rx178nwj/StepperMotorDriver-Node/datasheet/README.md

# datasheet

データシート本体はリポジトリに含めていません。各メーカーサイトから入手してください。

## サブフォルダ

- `CAN/`
- `MotorDriver/`
- `stm32/`
- `Switch/`
- `TVS/`
