rx178nwj/StepperMotorDriver-Node/schematic_NEMA17/pcb_routing_sizes.md

# PCB 配線・ビア・差動ペア サイズ一覧

更新日: 2026-10-04。単位は mm。

## 保存したネットクラス

| クラス | 用途 | 配線幅 | クリアランス | ビア外径 | ビア穴径 | 差動線幅 | ペア内間隔 |
|---|---|---:|---:|---:|---:|---:|---:|
| Default | デジタル・その他の信号 | 0.15 | 0.15 | 0.60 | 0.30 | — | — |
| DIGITAL | マイコンのデジタル信号（33ネットを明示割り当て） | 0.15 | 0.15 | 0.60 | 0.30 | — | — |
| ANALOG | アナログ信号（ADC・DAC・VREF） | 0.20 | 0.15 | 0.60 | 0.30 | — | — |
| USB | USB D+/D− | 0.25 | 0.15 | 0.60 | 0.30 | 0.25 | 0.15（暫定） |
| PCA9615_DIFF | 差動I2C | 0.15 | 0.15 | 0.60 | 0.30 | 0.15 | 0.15（暫定） |
| POWER_1A | 低電圧電源・GND | 0.50 | 0.15 | 0.80 | 0.40 | — | — |
| VM_POWER | VM・GNDPWR | 0.50 | 0.15 | 1.00 | 0.50 | — | — |
| MOTOR_PHASE | モーター相出力（前回設定を継続） | 2.00 | 0.15 | 1.00 | 0.50 | — | — |

POWER_1A: +3V3, /+5V, /+5V_EXT, /USB_VBUS, /USB_VBUS_SRC, /BUCK_SW, /VDDA, /DRV_VCC, GND, GNDA。
ANALOG: /TEMP, /AD_IN, /DAC_VREF, /DRV_VREF, /VM_DIV, /VM_SENSE_ISO, /VM_SENSE。VDDA・GNDAは電源クラスの0.50 mm。
DIGITAL: IC4のGPIO・ドライバ制御/状態・I2C・SWD/SWO・リセット・スイッチ・アドレス・LED・エンコーダ信号を33ネットごとに割り当て。USBは専用クラス。

ADC入力: IC4 pin10=/VM_SENSE、pin16=/TEMP、pin17=/AD_INをANALOG 0.20 mmへ割り当てた。ADC機能を備えたピンでもデジタル用途のネットはDIGITALとした。DAC pin14=/DAC_VREFはANALOGを維持。
今回の割り当て表: review/jlcpcb-4layer/mcu-signal-assignments.json。KiCad 10.0.4のネイティブ読み込み検証: 8クラス、明示割り当て62ネット、不一致0件。既存7クラスが消えていたため元の設定も復元してからDIGITALを追加した。
VM_POWER: /VM, GNDPWR。
MOTOR_PHASE: /OUTA_P, /OUTA_N, /OUTB_P, /OUTB_N。
USB: /USB_PC_DP, /USB_PC_DM。USB_CC1/2はDefault。
PCA9615_DIFF: /DI2C_SDA_P, /DI2C_SDA_M, /DI2C_SCL_P, /DI2C_SCL_M。

## 定義済みサイズ欄に使用する一覧

- 配線幅: 0.15, 0.20, 0.25, 0.50, 2.00。
- ビア（外径 / 穴径）: 0.60 / 0.30, 0.80 / 0.40, 1.00 / 0.50。
- 差動ペア（線幅 / 間隔 / ビア間隔）: PCA9615 = 0.15 / 0.15 / 0.15、USB = 0.25 / 0.15 / 0.15。間隔は暫定、ビア間隔は銅箔外周間の距離。

2026-10-04 修正検証: ファイルをMCPで読み戻すとDefaultのみ（線幅0.20 mm）、割り当てなしに戻っていた。どの保存操作で戻ったかは未特定。従来のツール成功応答だけを根拠にした保存確認を撤回する。
プロジェクト読み戻し・修正用MCPツールをreview/jlcpcb-4layer/toolsに追加。7クラスの数値と29ネットの割り当てをKiCad 10の形式で再設定し、定義済みサイズも登録した。既存の追加サイズは維持した。保存先はschematic.kicad_pro。
検証では別プロセスのKiCad 10.0.4 SETTINGS_MANAGER.LoadProjectで実際にプロジェクトを読み込み、PCBに対応させた。7クラスの線幅・クリアランス・ビア径・USB/PCA9615差動幅・間隔および29ネットの割り当ては不一致0件。結果はreview/jlcpcb-4layer/netclass-native-verification.json。
現在開いているエディタの画面は操作していない。修正前の値を保持した画面から保存すると外部修正が上書きされる可能性があるため、基板設定ダイアログをキャンセルし、エディタを閉じてプロジェクトを再読込する。エディタ内に未保存の基板変更があれば別名保存してから再読込する。

## PCA9615DPの差動配線

NXPの推奨する公称差動線路インピーダンスは100 Ω。出典: https://cache.nxp.com/docs/en/data-sheet/PCA9615.pdf （Rev.2、p.2、差動バスおよび終端の説明）。0.15 mm幅/0.15 mm間隔が100 Ωとなることはまだ確認していない。

- SDAペア: U2 DSDAP pin8 → DI2C_SDA_P、DSDAM pin9 → DI2C_SDA_M。
- SCLペア: U2 DSCLP pin7 → DI2C_SCL_P、DSCLM pin6 → DI2C_SCL_M。
- MCU側のSDA/SCLはシングルエンドであり、Defaultの0.15 mmを使用する。
- SDAとSCLをそれぞれ対として近接・並走させる。ペア同士は可能なら0.5 mm以上離す。
- F.Cu配線の直下に連続したIn1.CuのGND面を設ける方針。面の分断・VM/SW/モーター出力の近傍を避ける。GND面の作成は今回未実施。
- コネクタ間のバス経路とU2への分岐を短くし、スター配線を避ける。各ペアで層変更・ビア数を揃える。
- 既存回路のR13/R15/R16/R18は600/DNP、R14/R17は120/DNPと確認。抵抗値と実装指定は変更していない。数珠つなぎの物理的両端だけ終端を実装するという既存仕様に従う。
- 現在の_P/_M名は維持。KiCad差動ルータでペア認識されない場合はネット名の整合した変更が必要になるため、実配線開始前に確認する。

JLCPCBの発注積層（外層銅厚、F.Cu–In1.Cuの絶縁厚、誘電率）が決まった後、PCA9615の100 ΩとUSBの90 Ωを計算する。USB幅0.25 mmを固定したまま実現できる間隔・積層を選ぶ。暫定間隔を製造用インピーダンス確定値として扱わない。

## 電流・検証状況

4層 F.Cu / In1.Cu / In2.Cu / B.Cu、板厚1.6 mmを確認。最小配線幅・銅箔クリアランス0.15 mm。
電源幅0.50 mmは指定値。VM/GNDPWRの10 A級という既存設計前提に対する連続電流容量を保証しない。銅箔面・並列ビア・銅厚・温度上昇の検討が必要。モーター相出力2.00 mmも電流容量の確定値ではない。
既存4本のGNDPWRの0.20 mm配線はIC2のパッド付近の配線として維持し、自動拡幅していない。ネットクラスの変更は既存配線の幅を自動変更しない。
設定変更後DRC: 違反129件、未接続316件（変更前と同数）。今回の作業はサイズ設定であり、実配線・内層銅箔面・製造データ完成は未実施。
