rx178nwj/StepperMotorDriver-Node/schematic_NEMA17/stm32l433_tb67s249_connection.md

# 回路図作成仕様書：STM32L433CCU6 ⇔ TB67S249FTG 接続部

> 2026-10-04 DIP型番確定：SW4は秋月電子109992、OTAX KSD32（3極、スルーホール、税込80円/個）を採用。標準フットプリント `Button_Switch_THT:SW_DIP_SPSTx03_Slide_9.78x9.8mm_W7.62mm_P2.54mm` に変更した。ADDR0/1/2の配線、OFF=0/ON=1は維持。詳細は `review/ksd32/verification.md`。

> 2026-10-04 3bitアドレス選択：JP1を削除し、3極DIPスイッチSW4へ変更。DIP1=ADDR0→PH0 pin5（R59 10kΩプルダウン）、DIP2=ADDR1→PH1 pin6（R60 10kΩ）、DIP3=ADDR2→PC13 pin2（R58 10kΩ）。OFF=0/ON=1。HSEをOFFにして全てGPIO入力・内部プルなしで読む。`ID=ADDR0+2*ADDR1+4*ADDR2`（0〜7）、7bitアドレスは重複しないBASE+IDをFWで設定する。差動バスはマスター→最大8台を数珠つなぎ、終端R13〜R18は物理的な両端のみ、途中は未実装。最新記録は `review/dip-address/verification.md`。

> 2026-10-04 更新：基板スペースの都合により12.2節のF1/Q1/D6/D7/R38による入力保護は基板内で省略する。現在はJ6.1からVMへ直結する仕様。5V電源の負荷は1Aを設計前提としてL2を小型化する（インダクタの飽和電流を1Aとする意味ではない）。旧12章の部品記述よりこの更新条件を優先する。
>
> SW2=SWITCH1→IC4 PB4 pin40、SW3=SWITCH2→PB5 pin41、TH1=TEMP→PA6 pin16（ADC1_IN11）を接続した。ADCピン確保のためLED_FAULTはPA6からPB2 pin20へ移動した。SWD/SWOとJ11外部アナログ入力は維持。PB4/PB5はGPIO入力、PA6はアナログ入力、PB2はLED出力としてファームウェアを設定する。
>
> PCA9615は切替後+5Vからの自己給電を推奨。通信コネクタは差動4信号+GNDの5ピン案（1=SDA+、2=SDA−、3=SCL+、4=SCL−、5=GND）。この給電/コネクタ変更は今回未実施。詳細と接続検証は `review/inputs-self-power/verification.md`。

本書は、ステッピングモータドライバ基板のうち **MCU（STM32L433CCU6）とモータドライバ（TB67S249FTG）の接続部** の回路図を作成するための仕様である。ピン番号・ネット名・周辺部品の定数をすべて本書の記載どおりに描くこと。記載のない接続を追加しないこと。

---

## 1. 対象範囲

| 区分 | 内容 |
|---|---|
| 含む | TB67S249FTG の全ピン接続、MCU⇔ドライバ間の制御信号、VREF（DAC）回路、ドライバ周辺部品、PC通信用 I2C2（4.1節）、J6電源入力・保護・降圧・USB給電切替・3.3V生成・電源電圧測定（12節） |
| 含まない | 外部クロック・SWD、エンコーダ、温度計測、PCBの実装・配線・放熱検証 |

他シートとの接続は、下記「2. ネット一覧」のグローバルネット（電源・GND）でのみ行う。

---

## 2. ネット一覧

### 2.1 電源・GND（グローバルネット）

| ネット名 | 内容 | 供給元（他シート） |
|---|---|---|
| `VM` | モータ電源 12〜24V | 電源入力部（逆接保護・TVS後） |
| `+3V3_D` | MCUデジタル 3.3V | LDO（AP2112K-3.3） |
| `GND` | 信号GND | — |
| `PGND` | モータ電源GND（大電流経路） | 電源入力部。`GND` とは **1点で接続**（3.4節） |

### 2.2 ローカルネット（本シート内）

| ネット名 | 内容 |
|---|---|
| `DRV_VCC` | TB67S249 内部レギュレータ出力（5V、最大5mA）。**本シート内の設定用プルアップ専用。MCUや他回路に接続しないこと** |
| `DRV_VREF` | VREFA/VREFB 入力（分圧・フィルタ後） |
| `DAC_VREF` | MCU DAC出力（分圧前） |
| `OUTA_P` / `OUTA_N` / `OUTB_P` / `OUTB_N` | モータ出力（モータコネクタへ） |

### 2.3 MCU ⇔ ドライバ 制御信号

| ネット名 | 方向 | 内容 |
|---|---|---|
| `DRV_CLK` | MCU → DRV | ステップクロック（TIM1_CH1） |
| `DRV_DIR` | MCU → DRV | 回転方向 |
| `DRV_EN` | MCU → DRV | 出力ON/OFF |
| `DRV_RESET` | MCU → DRV | 電気角初期化 |
| `DRV_DMODE0` | MCU → DRV | ステップ分割設定 bit0 |
| `DRV_DMODE1` | MCU → DRV | ステップ分割設定 bit1 |
| `DRV_DMODE2` | MCU → DRV | ステップ分割設定 bit2 |
| `DRV_AGC0` | MCU → DRV | AGC設定 0 |
| `DRV_AGC1` | MCU → DRV | AGC設定 1 |
| `DRV_LO1` | DRV → MCU | エラーフラグ1（オープンドレイン） |
| `DRV_LO2` | DRV → MCU | エラーフラグ2（オープンドレイン） |
| `DRV_MO` | DRV → MCU | 電気角モニタ（オープンドレイン） |

### 2.4 PC通信用 I2C2

| ネット名 | MCU | 接続先 |
|---|---|---|
| `I2C_PC_SCL` | IC4 PB10（Pin 21）、I2C2_SCL | PCA9615DP の SCL（Pin 4） |
| `I2C_PC_SDA` | IC4 PB11（Pin 22）、I2C2_SDA | PCA9615DP の SDA（Pin 2） |

---

## 3. ブロック図

```
                    STM32L433CCU6                                TB67S249FTG
                 ┌─────────────────┐                        ┌──────────────────────┐
   (TIM1_CH1) PA8│29 ──DRV_CLK───────────────────────────── 43│CLK                   │
              PA9│30 ──DRV_DIR───────────────────────────── 42│CW/CCW        OUTA+ 13,14├─ OUTA_P
             PA10│31 ──DRV_EN──────┬─────────────────────── 44│ENABLE        OUTA- 17,18├─ OUTA_N
                 │                 R16 10k→GND              │                      │
             PB15│28 ──DRV_RESET────────────────────────── 45│RESET         OUTB+ 23,24├─ OUTB_P
             PB12│25 ──DRV_DMODE0───────────────────────── 39│DMODE0        OUTB- 19,20├─ OUTB_N
             PB13│26 ──DRV_DMODE1───────────────────────── 40│DMODE1                │
             PB14│27 ──DRV_DMODE2───────────────────────── 41│DMODE2    VMA 10,11   ├─ VM
              PB8│45 ──DRV_AGC0─────────────────────────── 1 │AGC0      VMB 26,27   ├─ VM
              PB9│46 ──DRV_AGC1─────────────────────────── 2 │AGC1                  │
                 │                                          │          RSAGND 15,16├─ PGND
       (EXTI2)PA2│12 ──DRV_LO1──┬────────────────────────── 47│LO1       RSBGND 21,22├─ PGND
       (EXTI3)PA3│13 ──DRV_LO2──┼─┬──────────────────────── 48│LO2                   │
             PC15│4  ──DRV_MO───┼─┼─┬────────────────────── 46│MO        GND 8,29,30 ├─ GND
                 │          R17 R18 R19 10k→+3V3_D          │          EP/コーナー  ├─ GND
  (DAC1_OUT1) PA4│14 ──DAC_VREF─R20 10k─┬─DRV_VREF───────── 32│VREFA                 │
                 │                      ├────────────────── 31│VREFB      VCC 33,34  ├─ DRV_VCC
                 │                   R21 9.1k  C16 100nF     │          OSCM 35     │
                 └─────────────────┘   GND      GND         └──────────────────────┘
```

PC通信用 I2C2 の接続（参照番号は現在の `schematic.kicad_sch` に対応）：

```text
IC4 STM32L433CCU6                         U2 PCA9615DP
PB10 (21, I2C2_SCL) ── I2C_PC_SCL ────── SCL (4)
                          │
                       R11 4.7kΩ → +3V3
PB11 (22, I2C2_SDA) ── I2C_PC_SDA ────── SDA (2)
                          │
                       R10 4.7kΩ → +3V3
```

---

## 4. STM32L433CCU6 側の接続（本シートで使用するピンのみ）

パッケージ：UFQFPN48。下表以外のピンは他シートで定義する。

| MCU Pin | ポート | ネット名 | GPIO/機能設定 | 接続先（TB67S249 Pin） |
|---|---|---|---|---|
| 29 | PA8 | `DRV_CLK` | TIM1_CH1（AF出力、プッシュプル） | 43 CLK |
| 30 | PA9 | `DRV_DIR` | GPIO出力、プッシュプル | 42 CW/CCW |
| 31 | PA10 | `DRV_EN` | GPIO出力、プッシュプル | 44 ENABLE |
| 28 | PB15 | `DRV_RESET` | GPIO出力、プッシュプル | 45 RESET |
| 25 | PB12 | `DRV_DMODE0` | GPIO出力、プッシュプル | 39 DMODE0 |
| 26 | PB13 | `DRV_DMODE1` | GPIO出力、プッシュプル | 40 DMODE1 |
| 27 | PB14 | `DRV_DMODE2` | GPIO出力、プッシュプル | 41 DMODE2 |
| 45 | PB8 | `DRV_AGC0` | GPIO出力、プッシュプル | 1 AGC0 |
| 46 | PB9 | `DRV_AGC1` | GPIO出力、プッシュプル | 2 AGC1 |
| 12 | PA2 | `DRV_LO1` | GPIO入力、内部プルなし、EXTI2（立ち下がり） | 47 LO1 |
| 13 | PA3 | `DRV_LO2` | GPIO入力、内部プルなし、EXTI3（立ち下がり） | 48 LO2 |
| 4 | PC15 | `DRV_MO` | GPIO入力、内部プルなし（ポーリング） | 46 MO |
| 14 | PA4 | `DAC_VREF` | **DAC1_OUT1**（バッファ有効） | R20 経由で 31 VREFB / 32 VREFA |

**電気的整合**
- TB67S249 のロジック入力しきい値は High 2.0V以上 / Low 0.8V以下で、3.3V出力で直結可能。
- ロジック入力（DMODE0〜2、CLK、ENABLE、RESET、CW/CCW、AGC0、AGC1、CLIM0）は内部で 100kΩ によりGNDへプルダウンされている（3.3V入力時の入力電流 33µA）。MCUリセット中（ピンがHi-Z）は、ドライバは **スタンバイ（DMODE=000）・出力OFF** に落ち着く。
- PC15 は RTC 電源ドメインのピンで駆動能力が小さいため、入力（MO）専用とする。

### 4.1 PC通信用 I2C2（2026-10-03 回路図反映済み）

| MCU Pin | ポート | ネット名 | GPIO/機能設定 | 接続先（現在の回路図） |
|---|---|---|---|---|
| 21 | PB10 | `I2C_PC_SCL` | I2C2_SCL、AF4、オープンドレイン、内部プルなし | U2（PCA9615DP）Pin 4 SCL、R11 Pin 2 |
| 22 | PB11 | `I2C_PC_SDA` | I2C2_SDA、AF4、オープンドレイン、内部プルなし | U2（PCA9615DP）Pin 2 SDA、R10 Pin 2 |

- R10/R11 は既設の 4.7kΩ プルアップ抵抗で、上側は `+3V3` に接続する。
- PB6/PB7 はセンサ用 `I2C_SENS_SCL` / `I2C_SENS_SDA` に使用するため、PC通信用は I2C2 に割り当てる。
- この節と I2C2 図の U2・R10・R11 は現在の `schematic.kicad_sch` の参照番号である。5〜7節のモータドライバ仕様に記載された同じ参照番号とは対応が異なる。
- ネットリストで両信号の MCU・PCA9615DP・プルアップ抵抗の接続を確認済み。階層チェックは問題なし。接続前後の ERC は 36件 → 34件（既存エラー22件・警告12件、新規違反なし）。

---

## 5. TB67S249FTG 全ピン接続表

パッケージ：P-VQFN48-0707-0.50-004（7×7mm、裏面サーマルパッド付き）。

| Pin | ピン名 | 接続先ネット | 周辺部品 | 備考 |
|---|---|---|---|---|
| 1 | AGC0 | `DRV_AGC0` | — | MCU PB8 |
| 2 | AGC1 | `DRV_AGC1` | — | MCU PB9 |
| 3 | CLIM0 | 設定抵抗 | R50 / R51（6.2節） | 2値ロジック入力 |
| 4 | CLIM1 | 設定抵抗 | R52 / R53（6.2節） | 4値入力 |
| 5 | FLIM | 設定抵抗 | R56 / R57（6.2節） | 4値入力 |
| 6 | BOOST | 設定抵抗 | R54 / R55（6.2節） | 4値入力 |
| 7 | LTH | `GND` | R11 100kΩ | データシート指定（GNDへ100kΩ） |
| 8 | GND | `GND` | — | |
| 9 | NC | **未接続** | — | パターンも引かない |
| 10 | VMA | `VM` | C11 0.1µF | Pin 11 とピン直近で接続 |
| 11 | VMA | `VM` | — | |
| 12 | NC | **未接続** | — | パターンも引かない |
| 13 | OUTA+ | `OUTA_P` | — | Pin 14 とピン直近で接続 |
| 14 | OUTA+ | `OUTA_P` | — | |
| 15 | RSAGND | `PGND` | — | Pin 16 とピン直近で接続 |
| 16 | RSAGND | `PGND` | — | |
| 17 | OUTA- | `OUTA_N` | — | Pin 18 とピン直近で接続 |
| 18 | OUTA- | `OUTA_N` | — | |
| 19 | OUTB- | `OUTB_N` | — | Pin 20 とピン直近で接続 |
| 20 | OUTB- | `OUTB_N` | — | |
| 21 | RSBGND | `PGND` | — | Pin 22 とピン直近で接続 |
| 22 | RSBGND | `PGND` | — | |
| 23 | OUTB+ | `OUTB_P` | — | Pin 24 とピン直近で接続 |
| 24 | OUTB+ | `OUTB_P` | — | |
| 25 | NC | **未接続** | — | パターンも引かない |
| 26 | VMB | `VM` | C12 0.1µF | Pin 27 とピン直近で接続 |
| 27 | VMB | `VM` | — | |
| 28 | NC | **未接続** | — | パターンも引かない |
| 29 | GND | `GND` | — | |
| 30 | GND | `GND` | — | |
| 31 | VREFB | `DRV_VREF` | 7節 | VREFA と接続 |
| 32 | VREFA | `DRV_VREF` | 7節 | VREFB と接続 |
| 33 | VCC | `DRV_VCC` | C14 0.1µF | Pin 34 とピン直近で接続 |
| 34 | VCC | `DRV_VCC` | — | |
| 35 | OSCM | — | R10 5.1kΩ（→`DRV_VCC`）、C15 270pF（→`GND`） | チョッピング周波数 約67kHz |
| 36 | NC | **未接続** | — | パターンも引かない |
| 37 | NC | **未接続** | — | パターンも引かない |
| 38 | NC | **未接続** | — | パターンも引かない |
| 39 | DMODE0 | `DRV_DMODE0` | — | MCU PB12 |
| 40 | DMODE1 | `DRV_DMODE1` | — | MCU PB13 |
| 41 | DMODE2 | `DRV_DMODE2` | — | MCU PB14 |
| 42 | CW/CCW | `DRV_DIR` | — | MCU PA9 |
| 43 | CLK | `DRV_CLK` | — | MCU PA8 |
| 44 | ENABLE | `DRV_EN` | R16 10kΩ（→`GND`） | MCU PA10 |
| 45 | RESET | `DRV_RESET` | — | MCU PB15 |
| 46 | MO | `DRV_MO` | R19 10kΩ（→`+3V3_D`） | MCU PC15、オープンドレイン |
| 47 | LO1 | `DRV_LO1` | R17 10kΩ（→`+3V3_D`） | MCU PA2、オープンドレイン |
| 48 | LO2 | `DRV_LO2` | R18 10kΩ（→`+3V3_D`） | MCU PA3、オープンドレイン |
| EP | 露出パッド | `GND` | — | コーナーパッドも含めGNDへはんだ付け |

**同名ピンの扱い**：VMA、VMB、OUTA±、OUTB±、RSAGND、RSBGND、VCC の各同名ピンは、ドライバの直近で互いに接続すること（データシート指定）。

**LO1/LO2/MO のプルアップ先**：データシートの推奨はVCCだが、動作範囲上はプルアップ電圧 3.3V（標準）〜VCC（最大）が許容されている。MCU に5Vを入れないため、本設計では `+3V3_D` へプルアップする。

---

## 6. 周辺部品

### 6.1 部品一覧（本シート分）

| 参照 | 値 | パッケージ | 接続 | 用途 |
|---|---|---|---|---|
| U2 | TB67S249FTG(O,EL) | P-VQFN48-0707 | 5節 | モータドライバ |
| C10 | 220µF / 63V 低ESR電解 | φ10程度 | `VM`–`PGND` | VMバルク（回生吸収） |
| C11 | 0.1µF / 100V X7R | 0603 | VMA(10,11)–`PGND` | VMデカップリング |
| C12 | 0.1µF / 100V X7R | 0603 | VMB(26,27)–`PGND` | VMデカップリング |
| C13 | 10µF / 50V X7R | 1210 | `VM`–`PGND` | VMデカップリング |
| C14 | 0.1µF / 16V X7R | 0402 | `DRV_VCC`–`GND` | VCC安定化 |
| R10 | 5.1kΩ 1% | 0402 | OSCM(35)–`DRV_VCC` | ROSC |
| C15 | 270pF C0G | 0402 | OSCM(35)–`GND` | COSC |
| R11 | 100kΩ 1% | 0402 | LTH(7)–`GND` | AGC検出しきい値 |
| R16 | 10kΩ 1% | 0402 | `DRV_EN`–`GND` | ENABLE プルダウン（起動時OFFの二重化） |
| R17 | 10kΩ 1% | 0402 | `DRV_LO1`–`+3V3_D` | LO1 プルアップ |
| R18 | 10kΩ 1% | 0402 | `DRV_LO2`–`+3V3_D` | LO2 プルアップ |
| R19 | 10kΩ 1% | 0402 | `DRV_MO`–`+3V3_D` | MO プルアップ |
| R20 | 10kΩ 1% | 0402 | `DAC_VREF`–`DRV_VREF` | VREF 分圧（上） |
| R21 | 9.1kΩ 1% | 0402 | `DRV_VREF`–`GND` | VREF 分圧（下）。7.3節 |
| C16 | 100nF / 16V X7R | 0402 | `DRV_VREF`–`GND` | VREF フィルタ |
| R50–R57 | 0Ω / 100kΩ / 未実装 | 0402 | 6.2節 | AGC設定ストラップ |

### 6.2 AGC設定ストラップ（CLIM0 / CLIM1 / BOOST / FLIM）

各ピンに **上側（→`DRV_VCC`）と下側（→`GND`）の2つのフットプリント** を設け、実装の組み合わせで設定を選べるようにする。

```
DRV_VCC ── R_up ──┬── 設定ピン
                  └── R_dn ── GND
```

| 設定ピン | 上側 | 下側 | 初期実装 | 初期設定の意味 |
|---|---|---|---|---|
| CLIM0 (3) | R50 | R51 | R50 = 0Ω、R51 = 未実装 | High |
| CLIM1 (4) | R52 | R53 | R52 = 100kΩ、R53 = 未実装 | VCC-100kΩプルアップ → 下限電流 IOUT×75% |
| BOOST (6) | R54 | R55 | R54 = 100kΩ、R55 = 未実装 | VCC-100kΩプルアップ → 最大7ステップで100%復帰 |
| FLIM (5) | R56 | R57 | R56 = 100kΩ、R57 = 未実装 | VCC-100kΩプルアップ → フルステップ換算450Hz未満でAGC無効 |

4値入力（CLIM1、BOOST、FLIM）の実装パターン：

| 状態 | R_up | R_dn |
|---|---|---|
| VCC短絡 | 0Ω | 未実装 |
| VCC-100kΩプルアップ | 100kΩ | 未実装 |
| GND-100kΩプルダウン | 未実装 | 100kΩ |
| GND短絡 | 未実装 | 0Ω |

**注意**：4値入力のプルアップ先は必ず `DRV_VCC`（ドライバ内部の5V）とする。`+3V3_D` へつなぐと、入力電圧が判定しきい値の境界に入り、状態が不定になる。100kΩ は精度±20%以内のこと。

初期評価は AGC 無効（MCU から AGC0 = AGC1 = Low）で行うため、上記ストラップは AGC を有効にした段階で調整する。

---

## 7. VREF 回路（DAC 出力）

### 7.1 回路

VREFA と VREFB は同一ネット `DRV_VREF` とし、MCU の DAC1_OUT1（PA4）1チャネルから両相を同じ電流に設定する。

```
PA4 (DAC1_OUT1) ── DAC_VREF ── R20 10kΩ ──┬── DRV_VREF ──┬── VREFA (32)
                                          │              └── VREFB (31)
                                       R21 9.1kΩ      C16 100nF
                                          │              │
                                         GND            GND   ← ドライバの GND(29,30) 近傍に接続
```

### 7.2 各部品の役割

- **R20 / R21（分圧）**：DAC フルスケール（3.3V）時の VREF を制限し、ファームウェア異常時でも電流がハードウェア上限を超えないようにする。
- **R20（直列抵抗）**：DAC 出力バッファが C16 の容量性負荷を直接駆動しないよう分離する。
- **C16**：チョッピングノイズと DAC ノイズの除去。時定数 約0.5ms。
- **R21**：MCU リセット中や DAC 無効時（PA4 が Hi-Z）に VREF を 0V に引き下げ、モータ電流を 0 にする。

### 7.3 電流設定式と R21 の選択

- VREF = V_DAC × R21 / (R20 + R21)
- IOUT = VREF × 1.25 [A]（TB67S249 の VREF ゲイン）
- VREF 入力範囲：GND〜3.6V、入力電流 最大1µA

| R21 | VREF 上限（DAC=3.3V） | 電流上限 | 用途 |
|---|---|---|---|
| **9.1kΩ（初期値）** | 1.57V | 1.97A | 標準 |
| 12kΩ | 1.80V | 2.25A | NEMA23 低電流巻線品 |
| 15kΩ | 1.98V | 2.48A | 熱評価後に検討 |

分解能：DAC 12bit → 約0.5mA/LSB（R21 = 9.1kΩ時）。

### 7.4 ファームウェア上の注意（回路図の注記として記載）

- DAC の出力バッファ有効時は、出力が完全には 0V にならない（下限が 0.2V 程度残る）。**電流を完全に 0 にする場合は ENABLE を Low にするか、DAC を無効化する。**
- DAC の基準電圧は VDDA/VREF+（`+3V3_A`）。

---

## 8. 配置・配線指示

1. **GND の扱い**：TB67S249 の GND 配線は、すべて1点で外部と接続する（データシート指定）。`PGND`（RSAGND・RSBGND・VM のリターン）と `GND`（ロジック・VREF・OSCM）は、ドライバの露出パッド直下で1点接続する。
2. **VM デカップリング**：C11 は VMA(10,11)、C12 は VMB(26,27) のピン直近に配置する。C10・C13 はドライバ近傍に配置し、`VM`–`PGND` のループ面積を最小にする。
3. **VREF**：R20・R21・C16 は VREFA/VREFB(31,32) の直近に配置する。C16・R21 の GND は GND(29,30) 側（信号GND）に接続し、RSAGND/RSBGND には接続しない。配線は OUT・VM パターンから離す。
4. **OSCM**：R10・C15 は OSCM(35) の直近に配置する。
5. **NC ピン（9, 12, 25, 28, 36, 37, 38）**：開放とし、パターンを接続しない（データシート指定）。
6. **サーマル**：露出パッドとコーナーパッドを GND パターンにはんだ付けし、サーマルビアを密に配置する（4層・2oz 銅を前提）。
7. **モータ出力**：OUTA±・OUTB± は 5A 級の幅で配線し、モータコネクタまで最短とする。

---

## 9. 起動時の状態（設計意図）

| 信号 | MCU リセット中 | 決定要因 |
|---|---|---|
| DMODE0〜2 | Low / Low / Low → **スタンバイ** | ドライバ内部プルダウン 100kΩ |
| ENABLE | Low → **出力OFF** | 内部プルダウン ＋ R16 |
| RESET | Low（通常動作） | 内部プルダウン |
| AGC0 / AGC1 | Low / Low（AGC無効） | 内部プルダウン |
| VREF | 0V → **電流0** | R21 |

MCU 起動後の推奨シーケンス：VM 電圧を確認 → DAC を設定 → DMODE を設定（スタンバイ解除後 7.5µs 以上待機）→ ENABLE を High。

---

## 10.ライブラリ
フットプリントやシンボルはKiCadの標準ライブラリを使用すること

---

### 10.1フットプリント

| 部品 | サイズ | フットプリント|
|---|---|---|
| 抵抗 | 0402 | Resistor_SMD:R_0402_1005Metric |
| 抵抗 | 0603 | Resistor_SMD:R_0603_1608Metric |
| コンデンサ | 0402 | Capacitor_SMD:C_0402_1005Metric | 
| コンデンサ | 0603 | Capacitor_SMD:C_0603_1608Metric | 

---

## 11. チェックリスト（回路図作成後に確認）

- [ ] TB67S249 の全48ピン ＋ EP が 5節の表どおりに接続されている
- [ ] NC ピン 7本（9, 12, 25, 28, 36, 37, 38）が未接続である
- [ ] 同名ピン（VMA×2、VMB×2、OUTA+×2、OUTA−×2、OUTB+×2、OUTB−×2、RSAGND×2、RSBGND×2、VCC×2）がそれぞれ接続されている
- [ ] `DRV_VCC` が本シート内の R10、R50、R52、R54、R56 以外に接続されていない
- [ ] LO1・LO2・MO のプルアップ先が `+3V3_D` である（`DRV_VCC` ではない）
- [ ] CLIM1・BOOST・FLIM のプルアップ先が `DRV_VCC` である（`+3V3_D` ではない）
- [ ] VREFA と VREFB が同一ネット `DRV_VREF` で、R20 経由で PA4 に接続されている
- [ ] PA4 と `DRV_VREF` が直結されていない（必ず R20 を経由する）
- [ ] `PGND` と `GND` の接続が1点のみである
- [ ] MCU 側のピン番号が 4節の表と一致している（UFQFPN48）
- [x] `I2C_PC_SCL` が IC4 PB10（Pin 21）・U2 SCL（Pin 4）・R11 Pin 2 に接続されている
- [x] `I2C_PC_SDA` が IC4 PB11（Pin 22）・U2 SDA（Pin 2）・R10 Pin 2 に接続されている
- [ ] ファームウェアで PB10/PB11 を I2C2（AF4、オープンドレイン、内部プルなし）に設定する

---

## 参考資料

- TB67S249FTG データシート Rev.3.5（2026-05-27、東芝デバイス＆ストレージ）
- [STM32L433xx データシート（STMicroelectronics）](https://www.st.com/resource/en/datasheet/stm32l433cb.pdf)

## 12. 電源・電圧測定回路（2026-10-03）

本節の参照番号とネット名は実際の `schematic.kicad_sch` に対応する。前節の一般仕様名 `+3V3_D` は実装では `+3V3`、`PGND` は `GNDPWR`、アナログ電源は `VDDA`、アナログGNDは `GNDA`。旧モーター電源の `+12V` 表記は `VM` に変更した。

### 12.1 電源経路

```text
J6.1 VIN_RAW → F1 → VIN_FUSED → Q1逆接保護 → VM（12～24V）→ IC2 VMA/VMB
                                                   └→ U5降圧 → +5V_EXT → U6.VIN1
J2 USB_VBUS ────────────────────────────────────────────────────────→ U6.VIN2
U6.VOUT → +5V → U7 LDO → +3V3 → MCU・PCA9615のVDD(A)・J5
                  └→ PCA9615 VDD(B)、J1/J3の5V電源出力
J6.2 → GNDPWR → NT1 → GND → NT2 → GNDA
```

J6 pin1は入力正極、pin2は電源リターン。J6の実部品・嵌合側・電線は10A以上かつDC60V以上の定格を選ぶ。J1/J3の5Vは出力であり、別の5V電源を接続しない。

### 12.2 入力保護・モーター電流

| 部品 | 値・接続 | 役割 |
|---|---|---|
| F1 | 遅延形10A、DC60V以上、VIN_RAW–VIN_FUSED | 短絡保護。実ヒューズのDC遮断定格・I²t・温度ディレーティングを確認する |
| Q1 | IRF4905、G=1/D=2/S=3。D=VIN_FUSED、S=VM | 高側P-MOSによる逆接保護。通常のスイッチ接続とD/Sが逆で、ボディダイオードが入力からVMへ向く |
| D7/R38 | BZT52C12のK=VM/A=PMOS_GATE、100kΩでゲートをGNDPWRへ | VGSを約−12Vに制限する |
| D6 | SMCJ26A、K=VM/A=GNDPWR | 26Vスタンドオフ、指定パルス電流時の最大クランプ42.1V |
| C15～C18 | 既設220µF/63V、100nF/100V×2、10µF/50V | ドライバのバルク・局所デカップリングを維持 |

TB67S249FTGの4.5Aは絶対最大ピーク値で、連続運転保証値ではない。入力経路は両相負荷を考慮して10A級とするが、使用可能電流はモーター巻線・入力電力・放熱・ヒューズの温度条件で確定する。Q1は10Aで室温の代表値でも約2Wの損失があり、TO-220の放熱を評価する。

既設R29=10kΩ/R30=9.1kΩのVREF制限は維持し、初期設定上限は約1.97A/相。今回の電源追加だけで4.5A設定にはならない。4.5Aを連続設定として扱わない。高電流設定への変更はVREF駆動と熱設計を別途検証する。

D6は過渡保護であり、連続回生エネルギーを吸収するブレーキ回路ではない。回生条件に応じて外部電源の吸収能力・バルク容量・制動回路を評価する。

### 12.3 外部電源の5V降圧

U5=AP63205WU?????AP63205WU-7?TSOT-23-6????3.8?32V???5V???1.1MHz???2A?????U9?U5??????????pin3 VIN?pin2 EN?VM?pin4 GND?GND?pin5 SW?BUCK_SW?pin6 BST?BUCK_BOOT?pin1 FB?+5V_EXT??????????5V????????R39/R40???????VCC?C25??????

C23=10?F/50V X7R?1210??C24=100nF/100V???????24V???????????????????????C26=100nF/16V?BST?SW????L2?4.7?H?XAL6060-472MEC???XAL6060?????????????Isat?3.5A?Irms?2.7A?DCR<100m?????????C27/C28=22?F/16V X7R??????2A?IC?????????????????????????USB???????????????

**?????????????:** AP63205????????32V?VIN?DC????35V?400ms??40V?EN?????35V???D6 SMCJ26A???????42.1V???????????D6????AP63205?????????????D6????????????????????????????????????????????????????????????????VIN/EN????????????????12?24V????????????????????????????????

### 12.4 USBとの電源切り替え・3.3V

U6=TPS2116DRLR。VIN1=+5V_EXT、VIN2=USB_VBUS、MODE=+5V_EXTで優先モード。PR1はR41=100kΩ/R42=30.1kΩで+5V_EXTを分圧し、公称約4.32Vで外部側とUSB側を切り替える。VOUTの2/7番は同一電源出力。外部電源とUSB_VBUSを直結しない。

C29/C30=100nFを各入力へ、C31=10µFを切替後の+5Vへ配置する。STはR43=10kΩで+3V3へプルアップし、既設PWR_ST（IC4 pin3、PC14）へ接続。外部側選択時はHigh、USB側選択時はLow。PC14は入力専用で使い、LSEクロックには割り当てない。

U7=AP2112K-3.3TRG1。VIN/EN=+5V、GND=GND、VOUT=+3V3、NCは未接続。C32/C33は入力/出力に各1µF/16V X7R。600mAはICの電流定格であり、5VからのLDO損失とSOT-23-5の温度上昇を別途評価する。高温条件を含めた初期3.3V負荷予算は100mA級とし、外付けセンサ電流を含めて検証する。

USBだけでMCU・通信回路に給電できる。USBからVMへの給電経路はなく、モーターは動かない。USB 2.0では列挙前の消費電流を100mA以内にし、列挙後もホストから許可された電流を超えない。外付けセンサやJ1/J3への給電分を含む。USB動作クロックはHSI48とCRSで設定する。

### 12.5 MCU電源・起動

既設VDD_1/VDD_2/VBAT/VDDUSBは+3V3、VSS/EPはGND。既設C1～C3とC12/C13を維持し、C35/C36=100nFをVDDごとの局所デカップリングとして追加した。PCBではそれぞれIC4 pin24/pin48の直近へ配置する。

L1は600Ω@100MHz・200mA以上のフェライトで+3V3からVDDAへ給電し、既設C4=2.2µF/C5=100nF、VSSA=GNDAを維持する。R2=0ΩはVDDAと旧VREF+表記を接続する。PWR_FLAGは電源駆動のERC宣言であり、電源生成部品ではない。

IC4 pin7（NRST）を既設NRSTスイッチ/C6へ接続。IC4 pin44（PH3-BOOT0）を既設BOOTスイッチ/R8=10kΩプルダウンへ接続。ネット名PB8_BOOTは旧名称で、PB8 pin45はDRV_AGC0を維持する。通常はBOOTスイッチを押さずに起動し、BOOT0の使用はオプションバイト設定と合わせる。

### 12.6 モーター電圧測定

```text
VM → R44 180kΩ/0.1% → VM_DIV → U8.S1–D1 → VM_SENSE_ISO → R46 4.7kΩ → VM_SENSE → IC4 PA0(pin10)
                         └→ R45 10kΩ/0.1% → GNDA                         └→ C34 100nF → GNDA
```

U8=TMUX1511RSVR（RSV、UQFN16、本体1.8×2.6mm）のch1を使用。RWBRのMouser在庫がないためRSVRへ変更した。VDD pin16とSEL1 pin1は+3V3、GND pin8はGND、C37=100nF。S1 pin2=VM_DIV、D1 pin3=VM_SENSE_ISO。未使用ch2～4のSEL2/SEL3/SEL4（pin4/11/15）およびS2/S3/S4（pin5/10/14）はGND、D2/D3/D4（pin6/9/13）は未接続。NC pin7/12も未接続。電源OFF時は3.6Vまでの信号経路が高インピーダンスとなり、分圧回路から未給電MCUへの逆給電を抑制する。分圧比19、R46/C34、ADC設定は維持する。

フットプリントは `Package_DFN_QFN:UQFN-16_1.8x2.6mm_P0.4mm`（中央露出パッドなし）。本体面積は旧PWRの5.0×4.4mmから1.8×2.6mmへ約79%減少する。0.4mmピッチの底面端子のため、実装はリフローを前提とする。

測定対象はJ6の生入力ではなく、ヒューズ・逆接保護後の実際のモーター電源VM。

- PA0はADC1_IN5、アナログモード・内部プルなし・単端入力。
- `VM = ADCコード / 4095 × VDDA実測値 × 19`（12bit）。VDDAはVREFINT校正値から補正する。
- 12V時は約0.632V、24V時は約1.263V。VDDA=3.3V時の理論フルスケールは62.7V。**62.7Vは分圧の換算範囲であり、基板の許容入力は12～24V**。
- SMCJ26Aの42.1Vクランプ時は約2.22Vで、U8の電源OFF保護範囲3.6V以内。
- 分圧のテブナン抵抗約9.47kΩとR46/C34により時定数約1.42ms。電源投入/切替後は10ms以上待ち、ADCサンプル時間は247.5サイクル以上を初期設定として使用する。
- ADC校正・複数回平均を行い、VMを確認してからDAC/DMODE/ENABLEを設定する。USBのみではVM≈0VなのでENABLEをLowに維持する。

### 12.7 実装と検証

Q1・J6・F1・ドライバの電流経路は10A級を前提に銅厚・温度上昇から幅を算定する。NT1以外でGNDPWRとGNDを短絡しない。U5の入力コンデンサ–VIN–PGNDのスイッチングループを最小にし、SWをADC/VREFから離す。GNDAは既設NT2でGNDへ接続し、R45/C34のリターンを静かなアナログ側へ配置する。

カスタムライブラリ `PowerSupply.kicad_sym` はAP2112のSOT25ピン定義、旧TMUX1511のTSSOP14/X2QFN12定義、および現在のU8に使う `TMUX1511_RSV_UQFN16` を含む。プロジェクトのsym-lib-tableへ登録済み。回路図は保存済みで、電源設計時のレビュー・ネットリスト・検証結果は `review/power-after/` に出力する。電源の実機動作・USB切替波形・高電流時の温度・回生・PCB DRCは別途検証が必要。

2026-10-04 U8のRSVR変更検証: VM_DIV→U8 pin2、U8 pin3→VM_SENSE_ISO→R46、VM_SENSE→PA0 pin10/C34の接続と、U8の電源・未使用SEL/SのGND接続を確認。階層問題0。ERCは変更前8件から変更後8件（エラー1/警告7）、新規違反0。結果と回路図PDFは `review/vm-rsv-after/`。PCBへの反映は未実施。

最終検証: 指定95接続と既存296接続を照合し、不一致0。階層問題0。ERCは34件（エラー22/警告12）から24件（エラー13/警告11）へ減少、新規違反0。残る既存の未接続ピン・ワイヤー・ラベル問題は `review/power-after/verification.md` と `erc.json` に記録した。

参照: [AP63205](https://www.diodes.com/datasheet/download/AP63200-AP63201-AP63203-AP63205.pdf)、[TPS2116](https://www.ti.com/lit/ds/symlink/tps2116.pdf)、[AP2112](https://www.diodes.com/assets/Datasheets/AP2112.pdf)、[TMUX1511](https://www.ti.com/lit/ds/symlink/tmux1511.pdf)、[SMCJ26A](https://www.diodes.com/part/view/SMCJ26A)。
- 本プロジェクトの部品リスト `stepper_driver_BOM.xlsx`（AGC設定ストラップは本書の R50〜R57 に更新が必要）

2026-10-03 AP63205?????: ???ERC34?????U9??????24???????????????????PDF? `review/ap63205-after/` ????? `review/power-after/` ?U5/C25/R39/R40???????????????????????????????
