rx178nwj/StepperMotorDriver-Node/firmware/docs/requirements.md

# ファームウェア要求仕様書 — NEMA23 ステッピングモータドライバ

| 項目 | 内容 |
|---|---|
| 対象基板 | SteppingMotorDriver_NEMA23（`schematic/schematic.kicad_sch` 2026-10-11 版） |
| MCU | STM32L433CCU6（UFQFPN48、Flash 256KB / SRAM 64KB）＝回路図参照 IC2 |
| モータドライバ | TB67S249FTG＝回路図参照 IC1 |
| 版 | 0.13（2026-10-20：原点・リミットの細部（FR-HOME-03〜06）を明記） |

**0.13 での変更**：J10 の原点・リミット（E3・E4）の実装で決めた細部を明記した。(1) FR-HOME-03：原点復帰中はリミット停止を行わず、停止は原点復帰の手順（FR-HOME-05・06）に従う（INPUT_STATUS bit5 も立てない）。(2) FR-HOME-04：INPUT_STATUS bit5 は、受け付けた MOVE_ABS・MOVE_REL・RUN_SPEED（0 以外）・ジョグ、および原点復帰の開始で 0 にする。(3) FR-HOME-05：開始時に両側の入力が作動していれば、動かさずに失敗とする。(4) FR-HOME-06：原点復帰中の MOVE_ABS・MOVE_REL・RUN_SPEED（0 以外）・ジョグは CMD_RESULT=1 で拒否し、RUN_SPEED=0 は減速停止として原点復帰を中止する。(1) で反対側が中止の原因になるのは、開始後に新たに作動した場合だけとする（開始時から作動していれば、そこから離れる方向へ探索する）。(3) の途中で反対側が作動した場合と、指令によらずパルスが止まった場合も失敗とする。bit3（原点確定済み）は次の原点復帰の開始まで保持する。

**0.12 での変更**：ホスト単体テスト（フェーズ C1・C2）で確認した実装の動作を仕様に明記し、受信リングを仕様どおりにした。(1) FR-COM-07：DLC 0・1 で REG を含まない不正な要求には REG=0 として `[0xFF][0x00][2]` を返す。(2) FR-COM-08：16bit レジスタも、2 バイトとも 1 フレームで書いた場合だけ反映する（部分書き込みは反映せず CMD_RESULT=2）。(3) FR-COM-11：受信リングは 16 件を保持する（FW の保持数が 15 件だったのを 16 件に修正）。あふれた場合は新しいフレームを捨てて統計 rx_dropped に計上し、リングにあるフレームは到着順に処理する。(4) 3.8 節：STEPS_PER_REV の範囲を 1〜65535 とする。(5) FR-NV-05：保存値の丸め先を明記した（数値は範囲の端、分割は 16、PA7_MODE は 1、FLAGS の未定義ビットは 0）。

**0.11 での変更**：ホスト単体テスト（フェーズ C）で見つかった実装との差を、次のとおり決めた。(1) FR-MOT-03：位置決めで一度減速に入ったら、目標が変わるまで減速を続け、減速中に速度を上げない（速度は 加速→一定→減速 の順で、減速中は単調に下がる）。(2) FR-MOT-04：動作中に、残りの距離が減速距離より短い目標へ変えた場合は、減速度 d を守って減速し、目標を行き過ぎて停止してから、逆方向に目標へ戻る（FR-MOT-06 と同じく、停止してから DIR を切り替える）。減速度の上限を超えて目標で急停止しない。(3) FR-POS-06・07：SYNC_POSITION の結果は 0〜N−1（N = GEAR_RATIO × STEPS_PER_REV × MICROSTEP）とし、四捨五入で N になった場合は 0 にする。N が符号付き 32bit の最大値を超える設定では、SYNC_POSITION（自動を含む）を実行せず CMD_RESULT=2 とする。

**0.10 での変更**：実装との差を解消し、P2 の要求を補足した。(1) FR-MON-04：励磁中の VM 範囲外は、10 ms 周期で 2 回連続して範囲外になったとき（最大約 20 ms）に FAULT とする。1 回の判定では ADC のノイズやモータ起動時の電圧低下で誤検出しやすいため。(2) FR-MON-08：LO 異常（OPD・ISD・TSD）は出力 OFF では原因を確認できないため、CLEAR_FAULT で解除する。原因が残っていれば、次の ENABLE 後に LO 検出で再び FAULT になる。温度と VM は従来どおり、原因が残っていれば解除しない。(3) FR-USB-52：CAN_REQUEST の書き込み（OP 0x01）とブロードキャスト（CAN_ID 0x000）は再送しない。FW が実行して応答だけが失われた場合の二重実行を防ぐため。(4) 3.8 節：ACCEL・DECEL の範囲（1〜10,000,000 step/s²）と、MAX_SPEED・START_SPEED・JOG_SPEED の範囲（1〜100,000 step/s）をレジスタ表に追記した。(5) FR-COM-12：未送信の異常通知を新しい通知で上書きした場合も tx_dropped に計上する。(6) P2 の補足：FR-USB-62（DFU デバイスの検出方法）、FR-HOME-03（進行方向の判定）、FR-BL-04（移行フラグの置き場所）。FR-USB-33 は変更しない（FW を仕様どおり、ECC エラーの時点で読み出しを中止するように修正した）。

**0.9 での変更**：P2 の要求を追加した。(1) AGC（3.11 節）：FLAGS bit3 で ON/OFF し、励磁 OFF（EN=Low）の間だけ AGC0/AGC1 を切り替える。CLIM・BOOST・FLIM・LTH は基板のストラップで固定。(2) J10 入力（3.12 節）：J10_MODE（0x59）で PA15/PA1 を、未使用／A/B エンコーダ（TIM2、読み出しのみ）／原点・リミットスイッチに切り替える。原点・リミットでは、リミット側への移動の即停止と、原点復帰コマンド（COMMAND 11・12）を行う。(3) ブートローダ移行（3.13 節）：USB のコマンド ENTER_BOOTLOADER（0x50）で、BOOT0 を押さずに ROM の USB DFU へ移る。IWDG を止められないため、ソフトウェアリセットを経由し、IWDG を起動する前に ROM へ移る。レジスタ 0x1E、0x59〜0x5F、COMMAND 11・12、FLAGS bit3・bit4、USB コマンド 0x50、nemadbg の `dfu` を追加した。保存レコードは版 3 とし、大きさ（64 バイト）は変えない。

**0.8 での変更**：(1) FR-USB-05 に、応答を送れない状態（送信が 50 ms 以上詰まっている）で受けた要求は実行せず捨てることを追記した。「要求 1 つにつき応答 1 つ。応答を捨てた要求は実行しない」ので、PC はタイムアウトで再送してよい。(2) 未送信のイベントを新しいイベントで上書きした場合も、破棄として tx_dropped に計上する。(3) PC 側ツール（`firmware/tools/`、Python CLI `nemadbg`）を 3.9.7 節として追加し、P2 から P1 へ前倒しする。(4) ホスト PC での単体テスト（`firmware/tests/host/`）を追加する（試験 29）。

**0.7 での変更**：出力軸の絶対位置センサ AS5600 の要求を追加する（3.10 節）。構成は モータ → ギヤ（20:1 または 40:1）→ 磁石 → AS5600 で、ギヤ後の軸の角度を I2C1（J9）から読み、(1) 軸の初期位置の判定、(2) 軸の絶対位置の把握に使う。出力軸の可動範囲は 1 回転未満とする。角度はステップ位置とは別のレジスタで公開し、モータ制御（脱調検出・閉ループ補正）には使わない。センサ未接続・読み出し失敗でも FAULT にせず、無効値を返して動作を続ける。初期位置は、起動後にセンサが最初に有効になった時点（モータ未動作のとき）に自動で、またはコマンド SYNC_POSITION（COMMAND 10）で、センサ角度からステップ位置に設定する。AS5600 の DIR ピンは J10.5（PA7）に接続し、PA7 は設定（PA7_MODE）で AD_IN（アナログ入力）／DIR（出力）／Z（デジタル入力）に切り替える。レジスタ 0x19〜0x1D（読み出し）、0x54〜0x58（設定）、COMMAND 10 を追加。

**0.6 での変更**：実装に合わせて次を追記した。(1) FR-USB-06 と FR-COM-11 の応答時間は、Flash 消去中（SAVE・LOAD・FACTORY、最大約 25 ms、FR-NV-07）は適用しない。(2) FR-COM-12 に、他の CAN ノードが無く ACK が得られない間は応答を破棄する制約を追記した。

**0.5 での変更**：USB（J6 Type-C、USB FS の CDC 仮想 COM ポート）を P2 から P1 へ移し、デバッグと内部設定に使う（3.9 節）。CCP（CAN Calibration Protocol）を参考にしたバイナリプロトコルで、(1) CAN で実装する通信（要求・応答・ブロードキャスト・異常通知）を USB 経由で自局に対してすべて実行でき、(2) 内部 RAM をアドレス指定（CCP 方式、PC 側で ELF から名前を解決）またはファームウェア内の名前表による名前指定でダンプできる。RAM への書き込みは行わない（読み出し専用）。USB から CAN バスへの送受信（USB-CAN ブリッジ）は行わない。

**0.4 での変更**：PC15 を `DRV_MO`（入力）から `CAN_S`（GPIO 出力）へ変更する。CAN_S は TJA1441AT の S（Pin 8）につながり、Low でノーマル、High でサイレントモード。TB67S249 の MO は未接続、MO のプルアップ（R36）は削除済みで、MO の公開（FR-DRV-09、STATUS bit1）は廃止する（STATUS bit1 は予約、常に 0）。CAN 起動前に CAN_S を Low にする要件を追加（FR-COM-14）。回路図は反映済み。

**0.3 での変更**：上位通信を CAN に変更する。PCA9615 と I2C2 を削除し、CAN トランシーバ TJA1441AT を追加する。CAN1 を PB8/PB9 に割り当て、それまで PB8/PB9 にあった DRV_AGC0/1 は PB10/PB11 へ移す。バス終端 120Ω は DIP スイッチで切り替える。レジスタマップ（3.8 節）は変えず、転送方式だけを CAN フレームに置き換える。**回路図への反映は未実施**（本書のピン割り当ては変更後の計画値）。

**0.2 での変更**：VREF の分圧抵抗 R32 を未実装とし DAC 出力をそのまま VREF とする。対象モータは 3A 品。TH1 は Murata NCP18XH103F03RB。モータ設定を不揮発保存し、外部通信で設定できるようにする（3.7 節）。

ピン割り当て・周辺定数は、上記回路図から KiCad 10 でネットリストを出力して確認した。設計メモ `schematic/stm32l433_tb67s249_connection.md` の参照番号は再アノテーション前のため、本書では **現在の回路図の参照番号** を用いる。

---

## 1. 目的と範囲

1 枚の基板で 1 台のバイポーラステッピングモータ（NEMA23 想定）を駆動する。上位マスターから CAN バス（トランシーバ TJA1441AT）経由で最大 8 台を制御する。

| フェーズ | 内容 |
|---|---|
| **P1 基本機能（本版で実装）** | クロック・GPIO 初期化、ドライバ制御（励磁・分割・電流）、台形加減速パルス生成、電源/温度監視、異常検出と保護、DIP アドレス、CAN 通信、LED、ローカルジョグスイッチ、ウォッチドッグ、**モータ設定の不揮発保存と通信による設定**、**USB CDC によるデバッグ・設定通信（3.9 節）**、**USB の PC 側ツール（CLI、3.9.7 節）** |
| P2 拡張 | 出力軸の位置センサ（J9、AS5600、3.10 節）、AGC（脱調防止）の運用（3.11 節）、J10 のエンコーダ／原点・リミット入力（3.12 節）、ROM ブートローダ（USB DFU）への移行（3.13 節） |

---

## 2. ハードウェア前提（ピン割り当て）

### 2.1 ドライバ制御（IC2 ⇔ IC1）

| MCU ピン | ポート | ネット | 設定 | TB67S249 | 備考 |
|---|---|---|---|---|---|
| 29 | PA8 | DRV_CLK | TIM1_CH1（AF1）PP 出力 | 43 CLK | 立ち上がりで 1 ステップ |
| 30 | PA9 | DRV_DIR | GPIO 出力 | 42 CW/CCW | High=CW |
| 31 | PA10 | DRV_EN | GPIO 出力 | 44 ENABLE | R28 10kΩ プルダウン。High=出力 ON |
| 28 | PB15 | DRV_RESET | GPIO 出力 | 45 RESET | High=電気角初期化 |
| 25 / 26 / 27 | PB12 / PB13 / PB14 | DRV_DMODE0/1/2 | GPIO 出力 | 39 / 40 / 41 | 000=スタンバイ |
| 21 / 22 | PB10 / PB11 | DRV_AGC0/1 | GPIO 出力 | 1 / 2 | AGC0 と AGC1 は同じレベルで駆動する。既定は Low（AGC 無効）。P2 で FLAGS bit3 により ON/OFF（3.11 節）。0.3 で PB8/PB9 から移動 |
| 12 | PA2 | DRV_LO1 | 入力・プルなし・EXTI 両エッジ | 47 LO1 | R30 10kΩ → +3V3、OD |
| 13 | PA3 | DRV_LO2 | 入力・プルなし・EXTI 両エッジ | 48 LO2 | R33 10kΩ → +3V3、OD |
| 4 | PC15 | CAN_S | GPIO 出力・プッシュプル・低速・プルなし。リセット直後は Low 出力に設定（FR-COM-14） | TJA1441AT S(8) | Low＝ノーマル、High＝サイレント。RTC 電源ドメインのピンで駆動能力が小さいが、S は静的な入力なので問題ない。TB67S249 の MO(46) は未接続 |
| 14 | PA4 | DAC_VREF | DAC1_OUT1 バッファ有効 | 31/32 VREFB/A | R34 10kΩ 直列＋C14 100nF（RC 1 ms）。**R32 未実装（分圧なし）** |

### 2.2 計測

| MCU ピン | ポート | ネット | ADC | 回路 |
|---|---|---|---|---|
| 10 | PA0 | VM_SENSE | ADC1_IN5 | VM → R37 180kΩ / R38 10kΩ（比 19）→ TMUX1511 → R39 4.7kΩ / C32 100nF |
| 16 | PA6 | TEMP | ADC1_IN11 | +3V3 → R14 4.7kΩ → TEMP → TH1 → GND、C9 100nF。TH1 = Murata NCP18XH103F03RB（10kΩ±1%、B25/50 = 3380K、B25/85 = 3434K） |
| 17 | PA7 | AD_IN / Z / DIR | **設定で切り替え**（PA7_MODE、3.10 節 FR-POS-11）：0=AD_IN（ADC1_IN12、アナログ入力）、1=DIR（GPIO 出力）、2=Z（GPIO 入力・プルなし） | J10.5 | 既定は 1=DIR。AD_IN は保護なし、0〜3.3V |
| — | — | VREFINT | ADC1_IN0 | VDDA 補正用 |
| — | — | 内部温度センサ | ADC1_IN17 | MCU 温度 |

### 2.3 通信・入出力

| MCU ピン | ポート | ネット | 機能 | 接続先 |
|---|---|---|---|---|
| 45 / 46 | PB8 / PB9 | CAN_RX / CAN_TX | CAN1_RX / CAN1_TX（AF9、PP、プルなし） | TJA1441AT RXD(4) / TXD(1) → J1/J2 CAN バス（JST PH 3 ピン）。0.3 で PCA9615（I2C2）から変更 |
| 42 / 43 | PB6 / PB7 | I2C_SENS_SCL / SDA | I2C1（P2） | J9（3V3/GND/SCL/SDA）、R40/R43 4.7kΩ |
| 32 / 33 | PA11 / PA12 | USB_DM / DP | USB FS デバイス、CDC（P1、3.9 節）。クロックは HSI48＋CRS（USB SOF 同期）。VBUS 検出は使わない | J6 Type-C（NCP360・USBLC6 経由） |
| 3 | PC14 | PWR_ST | 入力 | U4 TPS2116 ST。High=外部 5V、Low=USB 給電 |
| 5 / 6 / 2 | PH0 / PH1 / PC13 | ADDR0 / 1 / 2 | 入力・プルなし | SW2 DIP（OTAX KHS42E、4 極、ON=1）、R23/R24/R26 プルダウン。4 極目は CAN 終端の ON/OFF（MCU には接続しない）。0.3 で 3 極の SW1 から置き換え |
| 40 | PB4 | SWITCH1 | 入力（アクティブ Low） | S2、R1 10kΩ プルアップ、C2 100nF |
| 41 | PB5 | SWITCH2 | 入力（アクティブ Low） | S4、R4 10kΩ プルアップ、C3 100nF |
| 18 | PB0 | LED_MCU | 出力（High 点灯） | D1 |
| 19 | PB1 | LED_COMM | 出力（High 点灯） | D2 |
| 15 | PA5 | LED_RUN | 出力（High 点灯） | D3 |
| 20 | PB2 | LED_FAULT | 出力（High 点灯） | D4 |
| 38 / 11 | PA15 / PA1 | ENC_A_HOME1 / ENC_B_HOME2 | P2。J10_MODE で切り替え（3.12 節）：TIM2_CH1/CH2（AF1）のエンコーダモード、または GPIO 入力（内部プルアップ）の原点・リミット | J10.3 / J10.4。保護回路・外付けプル抵抗なし（3.3V 信号） |
| 34 / 37 / 39 | PA13 / PA14 / PB3 | SWDIO / SWCLK / SWO | デバッグ | J5 |
| 7 / 44 | NRST / BOOT0 | — | — | S1 リセット、S3 BOOT0 |

### 2.4 ドライバ側の固定設定（ハードウェア）

| 項目 | 値 | 根拠 |
|---|---|---|
| チョッピング周波数 | 約 67 kHz | OSCM：R29 5.1kΩ、C12 270pF |
| 電流換算 | IOUT = VREF × 1.25 | データシート |
| VREF 範囲 | DAC バッファ出力 約 0.2V〜VDDA−0.2V → **約 250〜3870 mA/相** | 分圧なし（R32 未実装） |
| DAC 分解能 | 約 1.0 mA/LSB（VDDA = 3.3V） | 12bit |
| 対象モータ | 定格 3A/相 | ユーザー指定 |
| LO1/LO2 | +3V3 プルアップ | R30 / R33 |
| AGC ストラップ | CLIM0/CLIM1/BOOST/FLIM は実装抵抗で固定。設定値は 3.11 節 FR-AGC-04 | R8/R9、R12/R13、R16/R17、R21/R22、LTH は R20 |

---

## 3. 機能要求

### 3.1 起動・システム（P1）

| ID | 要求 |
|---|---|
| FR-SYS-01 | システムクロックは HSI16 → PLL で 80 MHz とする（HSE/LSE は使用しない。PH0/PH1/PC14/PC15 を GPIO として使うため） |
| FR-SYS-02 | リセット直後、ドライバを安全状態にする：EN=Low、DMODE=000（スタンバイ）、RESET=Low、AGC=00、CLK=Low、DAC 出力 0 |
| FR-SYS-03 | 起動時に ADC キャリブレーションを行う |
| FR-SYS-04 | 独立ウォッチドッグ（IWDG）をタイムアウト約 500 ms で動作させ、メインループで更新する |
| FR-SYS-05 | 起動時に DIP スイッチ（ADDR0〜2）を読み、`ID = ADDR0 + 2·ADDR1 + 4·ADDR2` を確定する。動作中の変更は再起動まで反映しない |

### 3.2 ドライバ制御（P1）

| ID | 要求 |
|---|---|
| FR-DRV-01 | ステップ分割を 1, 2, 4, 8, 16, 32 から選択できる。DMODE への対応は下表（データシート表「DMODE のファンクション」）。1/2 は (a) 型を使用する |
| FR-DRV-02 | スタンバイ解除（DMODE≠000）後、7.5 µs 以上待ってから他の信号を変化させる（FW では 20 µs 以上待つ） |
| FR-DRV-03 | モータ電流は mA 単位で指定し、DAC コードへ換算する：`V_DAC = VREF = I/1.25`、`code = V_DAC / VDDA × 4095`。VDDA は VREFINT で補正する |
| FR-DRV-04 | 電流設定の範囲は 250〜3000 mA。上限 3000 mA は対象モータ定格と J3（JST XH、AWG22 で 3A）の定格に合わせる。範囲外の設定値は受け付けない |
| FR-DRV-05 | 電流 0 は DAC 下限（バッファ有効時 約 0.2V = 250 mA 相当）で実現できないため、励磁 OFF は EN=Low で行う |
| FR-DRV-05a | R32 がないため DAC を停止すると VREF が浮く。DAC は初期化後停止せず、不要時は最小出力（コード 0）にする |
| FR-DRV-06 | 停止後、設定時間（既定 500 ms）経過したら保持電流へ切り替える。動作開始時は運転電流へ戻してから最初のパルスを出す |
| FR-DRV-07 | AGC0/AGC1 は P1 では Low 固定（AGC 無効）。動作中に AGC0 を切り替えない（データシート注意）。P2 の運用は 3.11 節 |
| FR-DRV-08 | 電気角初期化コマンドで RESET を 10 µs High にする（停止中のみ） |
| FR-DRV-09 | （廃止。0.4 で MO を未接続としたため、MO の状態は公開しない） |

DMODE 対応表（データシートの列順は DMODE0, DMODE1, DMODE2）：

| 分割 | DMODE0 | DMODE1 | DMODE2 |
|---|---|---|---|
| スタンバイ | L | L | L |
| 1/1 | L | L | H |
| 1/2 (a) | L | H | L |
| 1/4 | L | H | H |
| 1/2 (b) | H | L | L |
| 1/8 | H | L | H |
| 1/16 | H | H | L |
| 1/32 | H | H | H |

### 3.3 パルス生成・動作制御（P1）

| ID | 要求 |
|---|---|
| FR-MOT-01 | TIM1_CH1 のハードウェア PWM で CLK を生成する。パルス幅 High ≥ 1 µs、Low ≥ 1 µs（データシート最小 500 ns） |
| FR-MOT-02 | ステップ速度範囲：1〜100,000 step/s（マイクロステップ単位）。TB67S249 の入力上限 1 MHz に対して CPU 負荷で制限する |
| FR-MOT-03 | 台形加減速：開始速度 v0、最高速度 vmax、加速度 a、減速度 d（step/s²）で 1 ステップごとに速度を更新する（`v² ← v² ± 2a`）。位置決めで一度減速に入ったら、目標の変更・停止指令があるまで減速を続け、減速中に速度を上げない（速度は 加速→一定→減速 の順で、減速中は単調に下がる。最高速度に届かない短い移動でも同じ） |
| FR-MOT-04 | 位置決めモード：絶対目標位置・相対移動量を指定し、減速距離 `v²/2d` を見込んで目標で停止する。動作中に、残りの距離が減速距離より短い目標へ変えた場合は、減速度 d を守って減速して目標を行き過ぎ、停止してから逆方向へ目標に戻る（FR-MOT-06 と同じく DIR は停止中に切り替える）。減速度の上限を超えて目標で急停止しない |
| FR-MOT-05 | 速度モード：符号付き目標速度で連続回転する。速度変更は加減速を伴う |
| FR-MOT-06 | 逆方向への指令は、一度減速停止してから DIR を切り替えて再始動する。DIR の変更はパルス停止中のみ行う |
| FR-MOT-07 | 減速停止（STOP）と即時停止（ESTOP：パルス即停止）を持つ |
| FR-MOT-08 | 位置は符号付き 32bit のステップ数で保持し、パルス出力ごとに更新する。停止中に現在位置を任意値に再定義できる |
| FR-MOT-09 | 回転方向の論理反転を設定できる |
| FR-MOT-10 | 分割設定の変更は停止中のみ受け付ける（位置の単位が変わるため） |

### 3.4 監視・保護（P1）

| ID | 要求 |
|---|---|
| FR-MON-01 | VM を 10 ms 周期で計測する：`VM = code/4095 × VDDA × 19`。サンプル時間は 247.5 サイクル |
| FR-MON-02 | VM 正常範囲は 10.5〜28.0 V（ヒステリシス 0.5 V）。入力定格 12〜24 V、TB67S249 下限 10 V、AP63205 推奨上限 32 V に基づく |
| FR-MON-03 | VM が正常範囲で 50 ms 以上安定するまで、ドライバをスタンバイから解除しない（USB 給電のみでは VM≈0V となり励磁しない） |
| FR-MON-04 | 励磁中に VM が範囲外になったら、パルスを即停止し EN=Low として異常（低電圧 / 過電圧）をラッチする。判定は 10 ms 周期で 2 回連続して範囲外になったとき（検出まで最大約 20 ms）とする。1 回の判定では、ADC のノイズやモータ起動時の電圧低下による誤検出が起きやすいため |
| FR-MON-05 | LO1/LO2 の立ち下がりを EXTI で検出し、パルス即停止・EN=Low にして異常をラッチする。異常種別は下表。VM 不在時やスタンバイ中の LO 入力は無視する |
| FR-MON-06 | 基板温度（TH1）を β 式（R25 = 10kΩ、B = 3434K）で計測する。80 °C 以上で過熱異常、70 °C 以上で警告。ADC 値が両端付近（断線・短絡）なら無効値とし保護判定しない |
| FR-MON-07 | MCU 内部温度を計測しステータスに公開する（保護には使わない） |
| FR-MON-08 | 異常解除コマンドで、DMODE を一度スタンバイにしてドライバのラッチを解除する。温度異常・VM 異常は、原因が残っている場合は解除しない。LO 異常（OPD・ISD・TSD）は、出力 OFF では原因を確認できないため（OPD・ISD は出力 ON でないと検出できない）CLEAR_FAULT で解除し、原因が残っていれば次の ENABLE 後に LO 検出で再び FAULT になる |
| FR-MON-09 | 通信タイムアウト（設定値 ms、0=無効）を超えて自局宛ての CAN 要求フレーム（3.8 節）を CAN で受信しない場合（USB の CAN_REQUEST は受信に数えない。FR-USB-42）、動作中なら減速停止する |

LO1/LO2 の意味（データシート）：

| LO1 | LO2 | 状態 |
|---|---|---|
| H | H | 正常 |
| H | L | 負荷オープン（OPD） |
| L | H | 過電流（ISD） |
| L | L | 過熱（TSD） |

### 3.5 状態遷移（P1）

```text
          ┌──────────┐ VM正常50ms ┌──────────┐ ENABLE ┌──────────┐
 起動 ──▶ │  NO_VM   │──────────▶│ DISABLED │──────▶│ ENABLED  │◀─┐
          │EN=L,STBY │◀──────────│ EN=L     │◀──────│ EN=H     │  │停止
          └──────────┘ VM範囲外   └──────────┘DISABLE└────┬─────┘  │
                ▲                                         │移動    │
                │CLEAR_FAULT(原因解消時)                    ▼        │
          ┌──────────┐◀── LO1/LO2・励磁中のVM異常・過熱 ──┌──────────┐ │
          │  FAULT   │◀────────────────────────────────│ (MOVING) │─┘
          │EN=L,STBY │                                  └──────────┘
          └──────────┘
```

- MOVING は ENABLED 中のサブ状態（パルス出力中）としてステータスビットで表す。
- 移動コマンドは ENABLED でのみ受け付ける。

### 3.6 表示・操作（P1）

| ID | 要求 |
|---|---|
| FR-UI-01 | LED_MCU：1 Hz で点滅（ハートビート） |
| FR-UI-02 | LED_RUN：ENABLED で点灯、MOVING で 5 Hz 点滅、それ以外消灯 |
| FR-UI-03 | LED_FAULT：FAULT 時に異常コード回数の点滅を繰り返す（1=OPD、2=ISD、3=TSD、4=低電圧、5=過電圧、6=基板過熱）。過熱警告時は点灯 |
| FR-UI-04 | LED_COMM：自局宛て（0x100+ID）またはブロードキャストのフレームを受信するたびに 50 ms 点灯。CAN がエラーパッシブまたはバスオフの間は 2 Hz で点滅 |
| FR-UI-05 | SWITCH1/SWITCH2（20 ms デバウンス）：ローカルジョグ有効時、押している間 CW/CCW にジョグ速度で回転する。ジョグ有効は設定フラグ（既定 有効） |
| FR-UI-06 | SWITCH1+SWITCH2 同時 2 秒長押しで、DISABLED⇔ENABLED を切り替える。FAULT 中は異常解除を行う |

### 3.7 設定の不揮発保存（P1）

接続するモータの種類によって適切な設定が異なるため、モータ設定を不揮発メモリに保存し、外部通信（3.8 節）で読み書き・保存できるようにする。

| ID | 要求 |
|---|---|
| FR-NV-01 | 保存対象：運転電流、保持電流、分割、FLAGS（方向反転・ジョグ）、通信タイムアウト、最高速度、加速度、減速度、開始速度、ジョグ速度、保持移行時間、1 回転のフルステップ数（レジスタ 0x20〜0x3F）、ギヤ比、センサ原点オフセット（レジスタ 0x54〜0x57、3.10 節）。FLAGS のセンサ方向反転（bit2）も保存する。P2 の J10_MODE・HOME_SPEED（0x59〜0x5B）と FLAGS bit3（AGC）・bit4（HOME 論理）も保存する（3.11 節、3.12 節） |
| FR-NV-02 | STM32L433 には EEPROM がなく、基板にも外付け EEPROM がないため、内蔵 Flash の末尾 2 ページ（0x0803F000〜0x0803FFFF、各 2KB）を EEPROM の代わりに使う。この領域はリンカでプログラム領域から除外する |
| FR-NV-03 | 64 バイトのレコード（識別子・版・連番・設定・CRC32）を追記し、ページが満杯になったらもう一方のページを消去して書く。起動時は CRC が正しい最新連番のレコードを読む |
| FR-NV-04 | 電源断対策：レコードは本体を先に書き、識別子を含む先頭 8 バイトを最後に書く。新しいレコードが完成するまで前のレコードを消さない。書き込み途中の領域を読んだときの ECC エラー（NMI）は無効レコードとして扱う |
| FR-NV-05 | 起動時、保存設定があれば読み込み、なければ工場出荷値を使う。読み込んだ値が範囲外なら丸めて CONFIG_STATUS で知らせる。丸め先は、数値（電流・速度・加減速度・STEPS_PER_REV・ギヤ比・センサオフセット）は範囲の近い方の端、分割は 16、PA7_MODE は 1、J10_MODE は 0、HOME_SPEED は 0 なら 1、FLAGS は未定義ビットを 0 にする |
| FR-NV-06 | 外部通信で設定レジスタを書くと RAM 上の設定に即時反映し「未保存」とする。SAVE で保存、LOAD で保存値に戻す、FACTORY で工場出荷値に戻す（RAM のみ。保存は SAVE） |
| FR-NV-07 | Flash 消去中は CPU が最大約 25 ms 止まるため、SAVE・LOAD・FACTORY はモータ停止中のみ受け付ける（励磁したままの停止は可） |
| FR-NV-08 | 工場出荷値の電流は運転 1000 mA / 保持 500 mA とする。未知のモータを接続しても過電流にならない値とし、3A モータでは設定してから SAVE して使う |

### 3.8 通信（P1：CAN1）

| ID | 要求 |
|---|---|
| FR-COM-01 | CAN1（bxCAN）を CAN 2.0A（標準 11bit ID）で動作させる。CAN FD は使わない（STM32L433 の bxCAN は非対応。TJA1441AT は FD 対応だがクラシック CAN として使う） |
| FR-COM-02 | ビットレート 500 kbit/s（暫定、U-1）。サンプルポイント 87.5% 付近。ファームウェアの定数で 125k / 250k / 1M にも変えられること |
| FR-COM-03 | CAN ID の割り当て（`ID` = DIP 値 0〜7、起動時に読む）：<br>`0x000` ブロードキャスト指令（上位→全台）<br>`0x080 + ID` 異常通知（基板→上位）<br>`0x100 + ID` 要求（上位→基板）<br>`0x180 + ID` 応答（基板→上位） |
| FR-COM-04 | 受信フィルタで `0x000` と `0x100 + ID` だけを受け付ける。それ以外のフレームは無視する（応答しない） |
| FR-COM-05 | 書き込み要求：`[0x01][REG][DATA 1〜6 B]`（DLC 3〜8）。DATA を REG から連続するレジスタへ書く。応答 `[0x81][REG][CMD_RESULT]`（DLC 3） |
| FR-COM-06 | 読み出し要求：`[0x02][REG][LEN]`（DLC 3、LEN 1〜6）。応答 `[0x82][REG][DATA LEN B]`（DLC 2+LEN）。1 フレーム分はスナップショットで返し、値の途中更新による破損を防ぐ |
| FR-COM-07 | 不正な要求（未定義の OP、DLC 不一致、LEN 範囲外）には `[0xFF][REG][2]` を返す。DLC 0・1 で REG を含まない要求には REG=0 として `[0xFF][0x00][2]` を返す |
| FR-COM-08 | 多バイト値はリトルエンディアン。32bit レジスタは 4 バイト全てを、16bit レジスタは 2 バイトとも 1 フレームで書いた場合だけ反映する（部分書き込みは反映せず CMD_RESULT=2） |
| FR-COM-09 | ブロードキャスト指令：`[COMMAND]`（DLC 1）。受け付けるのは 2 DISABLE、3 STOP、4 ESTOP だけで、応答は返さない。それ以外の値は無視する |
| FR-COM-10 | 異常通知：STATE が FAULT へ遷移したとき `0x080 + ID` で `[STATE][FAULT]`（DLC 2）を 1 回送信する |
| FR-COM-11 | 応答は要求の受信から 2 ms 以内に送信キューへ入れる。ただし Flash 消去中（SAVE・LOAD・FACTORY の実行中、最大約 25 ms）は CPU が止まるため適用しない。この間に受けた要求は受信リング（16 件）に残り、消去後に処理する。リングがあふれた場合は新しいフレームを捨てて統計 rx_dropped に計上し、リングにあるフレームは到着順に処理する |
| FR-COM-12 | バスオフからは自動復帰（ABOM 有効）、送信は自動再送（NART 無効）。エラーパッシブ・バスオフは LED_COMM で表示する（FR-UI-04）。他の CAN ノードが無く ACK が得られない間は、送信が再送を続けて送信メールボックスが埋まるため、以後の応答と異常通知は破棄する（統計 tx_dropped に計上）。送信保留中（未送信）の異常通知を新しい通知で上書きした場合も、tx_dropped に 1 計上する。ファームウェアは送信を中止しない |
| FR-COM-13 | トランシーバの S ピンは PC15（CAN_S）で制御する。通常運転中は Low（ノーマルモード）に保ち、ファームウェアからサイレントモードには切り替えない（H-8） |
| FR-COM-14 | CAN1 を起動する前に、PC15（CAN_S）を出力に設定して Low にし、トランシーバをノーマルモードにする。S は内部プルアップのため、これを行うまでサイレントで送信できない |

レジスタマップ（R=読み出し専用、RW=読み書き、W=書くと実行）：

| Addr | 名前 | 型 | 属性 | 内容 |
|---|---|---|---|---|
| 0x00 | DEVICE_ID | u8 | R | 0xA3 固定 |
| 0x01 | FW_MAJOR | u8 | R | |
| 0x02 | FW_MINOR | u8 | R | |
| 0x03 | BOARD_ID | u8 | R | DIP 値 0〜7 |
| 0x04 | STATE | u8 | R | 0=NO_VM、1=DISABLED、2=ENABLED、3=FAULT |
| 0x05 | FAULT | u8 | R | bit0 OPD、1 ISD、2 TSD、3 VM 低電圧、4 VM 過電圧、5 基板過熱 |
| 0x06 | STATUS | u8 | R | bit0 MOVING、1 予約（常に 0）、2 外部 5V 給電、3 SWITCH1、4 SWITCH2、5 過熱警告、6 保持電流中、7 目標到達 |
| 0x07 | CMD_RESULT | u8 | R | 直前の書き込み結果：0=OK、1=状態により拒否、2=値・アドレス不正、3=実行失敗（Flash 書き込み失敗・保存設定なし） |
| 0x08 | POSITION | i32 | R | 現在位置 [step] |
| 0x0C | SPEED | i32 | R | 現在速度 [step/s]（符号付き） |
| 0x10 | VM_MV | u16 | R | VM [mV] |
| 0x12 | BOARD_TEMP | i16 | R | 基板温度 [0.1 °C] |
| 0x14 | MCU_TEMP | i16 | R | MCU 温度 [0.1 °C] |
| 0x16 | AD_IN_MV | u16 | R | J10 アナログ入力 [mV]。PA7_MODE=0（AD_IN）のときだけ計測し、それ以外は 0xFFFF |
| 0x18 | CONFIG_STATUS | u8 | R | bit0 起動時に保存設定を読み込んだ、bit1 未保存の変更あり、bit2 直前の保存に失敗、bit3 保存値を補正した |
| 0x19 | SENSOR_STATUS | u8 | R | bit0 有効（直近の読み出しが成功し磁石を検出）、bit1 磁石が強すぎ（MH）、bit2 磁石が弱すぎ（ML）、bit3 センサ応答なし、bit4 初期位置確定済み（SYNC_POSITION 実行済み）、bit5 Z 入力レベル（PA7_MODE=2 のとき。1=High、それ以外は 0） |
| 0x1A | SENSOR_RAW | u16 | R | AS5600 の RAW ANGLE（0〜4095）。無効時は 0xFFFF |
| 0x1C | SHAFT_ANGLE | u16 | R | 出力軸角度 [0.01°]（0〜35999）。原点オフセットと方向反転を反映。無効時は 0xFFFF |
| 0x1E | INPUT_STATUS | u8 | R | J10 入力の状態（3.12 節）。bit0 HOME1 作動、bit1 HOME2 作動（J10_MODE=2 のとき。論理は FLAGS bit4 を反映）、bit2 原点復帰中、bit3 原点確定済み、bit4 原点復帰に失敗、bit5 リミットで停止した（次の移動指令で 0） |
| 0x20 | RUN_CURRENT | u16 | RW | 運転電流 [mA]、250〜3000、工場出荷値 1000 |
| 0x22 | HOLD_CURRENT | u16 | RW | 保持電流 [mA]、250〜3000、工場出荷値 500 |
| 0x24 | MICROSTEP | u8 | RW | 1/2/4/8/16/32、既定 16（停止中のみ） |
| 0x25 | FLAGS | u8 | RW | bit0 方向反転、bit1 ローカルジョグ有効、bit2 センサ方向（PA7_MODE=1 のとき AS5600 の DIR ピンの出力レベル。0=Low、1=High）、bit3 AGC 有効（3.11 節。ENABLED 中は変更不可）、bit4 HOME 入力の論理（0=アクティブ Low、1=アクティブ High、3.12 節）（既定 0x02） |
| 0x26 | COMM_TIMEOUT | u16 | RW | [ms]、0=無効（既定） |
| 0x28 | MAX_SPEED | u32 | RW | [step/s]、1〜100,000、既定 3200 |
| 0x2C | ACCEL | u32 | RW | [step/s²]、1〜10,000,000、既定 16000 |
| 0x30 | DECEL | u32 | RW | [step/s²]、1〜10,000,000、既定 16000 |
| 0x34 | START_SPEED | u32 | RW | [step/s]、1〜100,000、既定 200 |
| 0x38 | JOG_SPEED | u32 | RW | [step/s]、1〜100,000、既定 1600 |
| 0x3C | HOLD_DELAY | u16 | RW | 保持電流へ移るまで [ms]、既定 500 |
| 0x3E | STEPS_PER_REV | u16 | RW | モータ 1 回転のフルステップ数（上位側の換算用。SYNC_POSITION（3.10 節）で使う。それ以外の FW の動作には使わない）、1〜65535、既定 200 |
| 0x40 | MOVE_ABS | i32 | W | 絶対位置へ移動 |
| 0x44 | MOVE_REL | i32 | W | 相対移動 |
| 0x48 | RUN_SPEED | i32 | W | 速度モード（符号付き、0 で減速停止） |
| 0x4C | SET_POSITION | i32 | W | 現在位置の再定義（停止中のみ） |
| 0x50 | COMMAND | u8 | W | 1 ENABLE、2 DISABLE（パルス即停止＋励磁 OFF）、3 STOP（減速停止）、4 ESTOP（パルス即停止、励磁は維持）、5 CLEAR_FAULT、6 RESET_ELEC_ANGLE、7 SAVE_SETTINGS、8 LOAD_SETTINGS、9 FACTORY_SETTINGS、10 SYNC_POSITION（3.10 節）、11 HOME_NEG（− 側の原点復帰、3.12 節）、12 HOME_POS（＋ 側の原点復帰） |
| 0x54 | GEAR_RATIO | u16 | RW | モータ軸 : 出力軸のギヤ比（モータが出力軸 1 回転につき何回転するか）。1〜1000、既定 20 |
| 0x56 | SENSOR_OFFSET | u16 | RW | 出力軸の原点に対する RAW ANGLE の値（0〜4095）、既定 0 |
| 0x58 | PA7_MODE | u8 | RW | PA7（J10.5）の機能：0=AD_IN（アナログ入力）、1=DIR（AS5600 の DIR 出力）、2=Z（デジタル入力）。既定 1。書くと即時に切り替える |
| 0x59 | J10_MODE | u8 | RW | J10.3/J10.4（PA15/PA1）の機能：0=未使用、1=ENC（A/B エンコーダ）、2=HOME（原点・リミット）。既定 0。停止中のみ書ける（3.12 節） |
| 0x5A | HOME_SPEED | u16 | RW | 原点復帰の探索速度 [step/s]、1〜65535、既定 800。最高速度を超える場合は使用時に最高速度へ制限 |
| 0x5C | ENC_COUNT | i32 | R | エンコーダのカウント（4 逓倍）。J10_MODE=1 以外では 0 |

- 0x20〜0x3E、0x54〜0x5B（RW）は範囲外の値を書くと反映せず CMD_RESULT=2。開始速度・ジョグ速度が最高速度を超える場合は、使用時に最高速度へ制限する。分割の変更は停止中のみ。
- 1 フレームの書き込みに複数レジスタを含めた場合（例：0x24 MICROSTEP と 0x25 FLAGS）、アドレス昇順で反映する。
- 1 フレームの書き込み・読み出しは最大 6 バイト。読み出しでマップ外のバイトは 0xFF を返す。
- 32bit の移動指令（0x40〜0x4C）と COMMAND（0x50）は別フレームで送る。
- 0x40〜0x50 は読み出すと 0 を返す。0x1F は予約（0）。マップの範囲は 0x00〜0x5F。

### 3.9 USB 通信（P1：デバッグ・内部設定）

PC と USB で接続し、デバッグと内部設定に使う。プロトコルは CCP（CAN Calibration Protocol, ASAM）を参考にし、要求（CCP の CRO 相当）に対して必ず 1 つの応答（DTO 相当）を返す。用途は次の 2 つ。

1. **CAN 通信の代行**：3.8 節で CAN に実装する通信（書き込み・読み出し要求、ブロードキャスト指令、不正要求への応答、異常通知）を、USB 経由で自局に対してすべて実行できる。CAN バスが無くても CAN の処理系をデバッグでき、レジスタ書き込み＋SAVE_SETTINGS で内部設定もできる。
2. **内部 RAM のダンプ**：CCP と同じアドレス指定（SET_MTA＋UPLOAD）と、ファームウェアが持つ名前表による名前指定の両方でメモリを読み出す。

USB から CAN バスへのフレーム送信・バス上のフレームの転送（USB-CAN ブリッジ）は行わない。メモリへの書き込み（CCP の DNLOAD 相当）も行わない。

#### 3.9.1 物理層・全体

| ID | 要求 |
|---|---|
| FR-USB-01 | USB FS デバイス（PA11/PA12）を CDC ACM（仮想 COM ポート）で動作させる。ボーレート等の回線設定は無視する。USB クロックは HSI48 を CRS で USB SOF に同期させる（CubeMX 設定済み） |
| FR-USB-02 | ディスクリプタ：VID/PID は開発中 ST 既定（0x0483/0x5740）、製品文字列「NEMA23 Stepper Driver」、シリアル番号は MCU の UID から生成し、複数台を PC 側で区別できるようにする |
| FR-USB-03 | USB 給電のみ（VM 無し、NO_VM 状態）でも USB 通信は動作する |
| FR-USB-04 | USB の割り込み優先度は TIM1（パルス生成）・EXTI（LO1/LO2）・CAN より低くする。割り込みでは受信データをリングバッファに積むだけとし、フレーム解析・応答生成はメインループで行う（NFR-02、NFR-03 を損なわない） |
| FR-USB-05 | ホストが COM ポートを開いていない・ケーブルが抜けた・ホストが読み出さない場合でも、メインループを止めない。送信できない状態が 50 ms 続いた応答・イベントは破棄する。応答を送れない状態（送信が 50 ms 以上詰まっている）で受けた要求は実行せず捨てる（要求 1 つにつき応答 1 つ。応答を捨てた要求は実行しない）。PC はタイムアウトで再送する。捨てた要求・応答・イベントは tx_dropped に計上し、未送信のイベントを新しいイベントで上書きした場合も 1 計上する |
| FR-USB-06 | 応答は要求フレームの受信完了から 10 ms 以内に送信を開始する。ただし Flash 消去中（SAVE・LOAD・FACTORY の実行中、最大約 25 ms、FR-NV-07）は適用しない |
| FR-USB-07 | VBUS 検出は使わない（PA9 は DRV_DIR に使用）。USB バスリセット・サスペンドでセッションを切断状態にする |

#### 3.9.2 フレーム形式

CDC はバイトストリームのため、次のフレームで区切る。

```text
[SOF=0xA5][LEN][BODY: LEN バイト][CRC16 下位][CRC16 上位]
```

| ID | 要求 |
|---|---|
| FR-USB-10 | LEN は BODY のバイト数で 2〜250。CRC16 は CRC-16/CCITT-FALSE（多項式 0x1021、初期値 0xFFFF、反転なし）を LEN と BODY にかけたもの。多バイト値はすべてリトルエンディアン |
| FR-USB-11 | 受信側は SOF を待ち、LEN が範囲外なら SOF の次のバイトから SOF を探し直す。フレーム途中で 20 ms 以上バイトが途切れたら受信途中のフレームを捨てる。CRC 不一致のフレームは応答せずに捨てる（PC はタイムアウトで再送する） |
| FR-USB-12 | 要求 BODY（CRO 相当）：`[CMD][CTR][PARAM…]`。CTR は PC が要求ごとに増やす 8bit カウンタ |
| FR-USB-13 | 応答 BODY（DTO 相当）：`[PID=0xFF][ERR][CTR][DATA…]`。CTR は要求の値をそのまま返す。ERR≠0x00 のとき DATA は付けない |
| FR-USB-14 | イベント BODY：`[PID=0xFE][EVT][DATA…]`（基板から非同期に送る）。セッション接続中だけ送る |
| FR-USB-15 | PC は応答を受け取ってから次の要求を送る（同時に 1 要求、CCP と同じ）。ファームウェアは受信バッファに 2 フレーム以上を保持できること |

エラーコード（ERR、CCP のコードに合わせる）：

| ERR | 意味 | 主な発生条件 |
|---|---|---|
| 0x00 | 正常（ACK） | |
| 0x30 | 未定義コマンド | CMD が未定義 |
| 0x31 | コマンド構文エラー | BODY 長がコマンドの形式と合わない |
| 0x32 | パラメータ範囲外 | SIZE・INDEX・CAN_ID・DLC が範囲外 |
| 0x33 | アクセス拒否 | 読み出し許可領域外のアドレス（FR-USB-31）、ENABLED 中の ENTER_BOOTLOADER（FR-BL-02） |
| 0x35 | アクセスロック | CONNECT していない |
| 0x36 | リソースなし | 名前表に該当する名前がない、Flash 読み出しで ECC エラー |

#### 3.9.3 コマンド

| CMD | 名前 | 要求 PARAM | 応答 DATA | 備考 |
|---|---|---|---|---|
| 0x01 | CONNECT | なし | `[PROTO_MAJOR][PROTO_MINOR][DEVICE_ID][FW_MAJOR][FW_MINOR][BOARD_ID][MAX_LEN]` | セッション開始。MAX_LEN は受け付ける最大 LEN（250） |
| 0x07 | DISCONNECT | なし | なし | セッション終了。以後イベントを送らない |
| 0x1B | GET_VERSION | なし | `[PROTO_MAJOR][PROTO_MINOR]` | 未接続でも受け付ける。本版は 1.0 |
| 0x17 | EXCHANGE_ID | なし | `[N][BUILD_ID N B]` | ELF の GNU build-id（SHA1、N=20）。PC が ELF との一致を確認する |
| 0x02 | SET_MTA | `[ADDR u32]` | なし | メモリ転送アドレス（MTA）を設定 |
| 0x04 | UPLOAD | `[SIZE]`（1〜240） | `[DATA SIZE B]` | MTA から読み出し、成功時 MTA += SIZE |
| 0x0F | SHORT_UP | `[SIZE][ADDR u32]` | `[DATA SIZE B]` | 指定アドレスから読み出し。MTA は変えない |
| 0x20 | SYM_COUNT | なし | `[COUNT u16]` | 名前表の登録数 |
| 0x21 | SYM_INFO | `[INDEX u16]` | `[ADDR u32][TYPE][NUM u16][NLEN][NAME NLEN B]` | INDEX 番目の登録内容 |
| 0x22 | SYM_FIND | `[NLEN][NAME NLEN B]` | `[INDEX u16][ADDR u32][TYPE][NUM u16]` | 名前で検索（大文字小文字を区別、完全一致） |
| 0x23 | SYM_UPLOAD | `[NLEN][NAME NLEN B][OFFSET u16][SIZE]` | `[DATA SIZE B]` | 名前指定で読み出し。SIZE=0 は変数全体（240 B 超なら 0x32） |
| 0x40 | CAN_REQUEST | `[CAN_ID u16][DLC][DATA DLC B]` | `[N]` に続き N 個の `[CAN_ID u16][DLC][DATA DLC B]` | CAN フレームの受信を模擬し、基板が返すフレームを返す（FR-USB-40） |
| 0x50 | ENTER_BOOTLOADER | `[KEY u32]`（0x544F4F42、"BOOT"） | なし | ROM ブートローダ（USB DFU）へ移る（P2、3.13 節）。KEY 不一致は 0x32 |

- CONNECT 前は CONNECT・GET_VERSION 以外に ERR 0x35 を返す。
- イベント EVT=0x01（CAN_FRAME）：DATA は `[CAN_ID u16][DLC][DATA DLC B]`。FR-COM-10 の異常通知（`0x080 + ID`）を CAN に送信するとき、同じ内容を USB にも送る。

#### 3.9.4 メモリ読み出し（アドレス指定・CCP 方式）

| ID | 要求 |
|---|---|
| FR-USB-30 | アドレス指定の読み出しは、PC 側が ELF（シンボル表・DWARF）または .map から名前をアドレス・サイズに解決して行う（CCP で A2L を使うのと同じ）。PC は EXCHANGE_ID の build-id と ELF の build-id が一致することを確認してから使う |
| FR-USB-31 | 読み出しを許可する領域：Flash 0x08000000〜0x0803FFFF、SRAM1 0x20000000〜0x2000BFFF、SRAM2 0x2000C000〜0x2000FFFF とその別名 0x10000000〜0x10003FFF、OTP 0x1FFF7000〜0x1FFF73FF、UID・パッケージ・Flash サイズ 0x1FFF7500〜0x1FFF75FF。範囲の全体が 1 つの領域に収まらない要求は ERR 0x33。**ペリフェラル領域は読み出すとフラグが消えるなどの副作用があるため許可しない** |
| FR-USB-32 | コピーは 4 バイト境界に揃った部分を 32bit 単位で読む。境界に揃った 32bit 以下の変数は値が途中で壊れない。複数変数の間の同時性は保証しない（CCP のポーリングと同じ） |
| FR-USB-33 | Flash の書き込み途中のページ（FR-NV-04）を読んで ECC エラー（NMI）になった場合は、NMI ハンドラで読み出しを中止し ERR 0x36 を返す。リセットしない |
| FR-USB-34 | ELF に build-id を入れる：リンクオプションに `-Wl,--build-id=sha1` を付け、使用するリンカスクリプトで `.note.gnu.build-id` セクションを Flash に配置して残す |

#### 3.9.5 名前表（名前指定）

| ID | 要求 |
|---|---|
| FR-USB-35 | ファームウェアは Flash 上に const の名前表を持つ。各登録は 名前（ASCII、31 文字以内）、アドレス、TYPE、要素数 NUM。登録はソース上のマクロ 1 行で行えるようにする |
| FR-USB-36 | TYPE：0x01 u8、0x02 i8、0x03 u16、0x04 i16、0x05 u32、0x06 i32、0x07 f32、0x10 バイト列（構造体など）。サイズ = 要素サイズ × NUM |
| FR-USB-37 | 最低限登録する変数：状態遷移（STATE・FAULT・STATUS）、パルス生成（現在位置・現在速度・目標位置・加減速の内部状態）、監視（ADC 生値・VDDA・VM・温度）、RAM 上の設定（3.7 節）、CAN の統計（送受信数・エラーカウンタ・バスオフ回数）、USB の統計（受信フレーム数・CRC エラー数・破棄数）。登録一覧は実装時に `firmware/docs/` に記載する |
| FR-USB-38 | 名前指定の読み出しで、変数が 8 バイト以下なら割り込みを禁止してコピーし、値の途中更新による破損を防ぐ（禁止時間 1 µs 以下）。8 バイトを超える変数は FR-USB-32 と同じ扱い |

#### 3.9.6 CAN 通信の代行

| ID | 要求 |
|---|---|
| FR-USB-40 | CAN_REQUEST は、指定した CAN フレームを CAN1 で受信したのと同じ処理系（受信フィルタ判定 FR-COM-04 を含む）に渡す。その結果、基板が CAN に送信するはずのフレーム（`0x180 + ID` の応答、`0xFF` 不正応答）は **CAN バスには送らず** USB の応答 DATA に入れて返す。応答が無い場合（ブロードキャスト、他局宛て、フィルタで捨てたフレーム）は N=0 |
| FR-USB-41 | CAN_ID は 0x000〜0x7FF、DLC は 0〜8。範囲外は ERR 0x32（CAN 側の処理系には渡さない） |
| FR-USB-42 | USB からの CAN_REQUEST で `0x100 + ID` 宛てを受け付けても、通信タイムアウト（FR-MON-09）の計時はリセットしない（計時をリセットするのは CAN で受信した要求だけ。USB のデバッグ操作でマスタ停止時の安全停止を妨げないため） |
| FR-USB-43 | CAN と USB の要求は到着順にメインループで 1 つずつ処理する（排他制御はしない）。1 フレーム分のスナップショット（FR-COM-06）と 32bit の全バイト書き込み条件（FR-COM-08）は USB でも同じに守る |
| FR-USB-44 | USB の要求では LED_COMM（FR-UI-04）を点灯しない。LED_COMM は CAN の状態表示に専用とする |

#### 3.9.7 PC 側ツール（P1：CLI `nemadbg`）

3.9 節のプロトコルを使って基板と通信する PC 側の CLI。実装は `firmware/tools/`。読み出し専用で、書き込み系（DNLOAD 相当）は無い。

| ID | 要求 |
|---|---|
| FR-USB-50 | Python 3.9 以上で動作する。依存は pyserial と pyelftools。`firmware/tools/` で `python -m nemadbg <サブコマンド>` として実行する |
| FR-USB-51 | `--port` で COM ポートを指定する。省略時は VID 0x0483 / PID 0x5740 の COM ポートを自動検出し、複数見つかった場合は選ばずにエラーとして一覧を表示する |
| FR-USB-52 | 要求ごとに CTR を増やす。応答待ちのタイムアウトは既定 200 ms（Flash 消去中の SAVE 等を考慮して設定で変えられる）とし、タイムアウトしたら同じ要求を最大 3 回再送する（FW は応答を捨てた要求を実行しないので再送は安全）。ただし CAN_REQUEST のうち、書き込み（CAN データの先頭 OP が 0x01）とブロードキャスト（CAN_ID 0x000）は再送しない（1 回だけ送る）。FW が CAN 要求を実行して応答だけが失われた場合に、再送で二重に実行されるのを防ぐため。この場合のタイムアウトでは「実行されたかは不明。レジスタで状態を確認する」ことを表示する。読み出し系とその他のコマンドは従来どおり再送する |
| FR-USB-53 | `info`：CONNECT・GET_VERSION・EXCHANGE_ID を実行し、プロトコル版・FW 版・BOARD_ID・build-id を表示する。`--elf` 指定時は ELF の build-id と照合し、結果を表示する |
| FR-USB-54 | `syms`：SYM_COUNT と SYM_INFO で名前表を列挙し、INDEX・名前・アドレス・TYPE・NUM を表示する |
| FR-USB-55 | `get NAME…`：SYM_UPLOAD で名前指定の値を読み、TYPE に従って数値（符号・浮動小数）に整形して表示する。バイト列は hex で表示する |
| FR-USB-56 | `read ADDR SIZE`：アドレス指定で読み出す。SHORT_UP を 240 B ずつに分割して実行し、hex ダンプで表示する |
| FR-USB-57 | `read-var ELF_SYMBOL`：`--elf` を必須とする。EXCHANGE_ID の build-id が ELF と一致しない場合は読み出しを拒否する。ELF のシンボル表からアドレスとサイズを解決して読み出す（FR-USB-30） |
| FR-USB-58 | `can-req CAN_ID [DATA_HEX]`：CAN_REQUEST を実行し、基板が返す応答フレーム（CAN_ID・DLC・DATA）を表示する。応答が無い場合はその旨を表示する |
| FR-USB-59 | `regs`：CAN_REQUEST でレジスタ 0x00 から読み出し、レジスタ名付きで表示する |
| FR-USB-60 | `watch NAME… --interval`：指定周期で名前指定の読み出しを繰り返し表示する。Ctrl+C で終了する |
| FR-USB-61 | `events`：基板からのイベント（EVT）を受信して表示する。Ctrl+C で終了する |
| FR-USB-62 | `dfu`（P2、3.13 節）：確認のプロンプト（`--yes` で省略）の後に ENTER_BOOTLOADER を送り、DFU デバイス（VID 0x0483 / PID 0xDF11）が現れるまで最大 5 秒待って結果を表示する。検出は、STM32_Programmer_CLI が PATH にあれば `-l usb` を繰り返して行い、無ければ検出を省いてその旨を表示する（依存を pyserial・pyelftools のままにするため）。書き込みの手順（STM32_Programmer_CLI のコマンド例）も表示する。書き込み自体は行わない |
### 3.10 出力軸の位置センサ（P2：AS5600）

構成は モータ → ギヤ（40:1 または 20:1）→ 磁石 → AS5600。センサはギヤ後の出力軸の角度（1 回転 4096 カウント）を測る。用途は (1) 軸の初期位置の判定、(2) 軸の絶対位置の把握で、モータ制御（脱調検出・閉ループ補正）には使わない。

| ID | 要求 |
|---|---|
| FR-POS-01 | AS5600 を J9（I2C1：PB6 SCL / PB7 SDA、R40・R43 4.7kΩ プルアップ）に接続する。7bit アドレスは 0x36 固定。I2C の速度は 400 kHz 以下 |
| FR-POS-02 | 10 ms 周期で STATUS（0x0B）と RAW ANGLE（0x0C・0x0D、12bit）を読む。STATUS の MD（bit5）が 0 のとき（磁石なし）は無効とする。MH（bit3）・ML（bit4）は SENSOR_STATUS に写すだけで、無効にはしない |
| FR-POS-03 | I2C の通信が TIM1（パルス生成）・EXTI（LO1/LO2）・CAN の処理を妨げないこと。割り込み優先度はこれらより低くし、メインループを止める時間は 1 トランザクションあたり 1 ms 以内とし、超えたら失敗として扱う（NFR-02、NFR-03、FR-COM-11 を損なわない） |
| FR-POS-04 | センサが未接続または読み出しに失敗した場合、FAULT にせず動作を続ける。3 回連続で失敗したら無効とし、SENSOR_RAW・SHAFT_ANGLE を 0xFFFF、SENSOR_STATUS の bit3 を 1 にする。無効の間は 1 秒ごとに再接続を試み、成功したら有効に戻す。I2C バスが固着した場合は復帰させる（SCL を最大 9 クロック出す） |
| FR-POS-05 | 出力軸角度：`a = (RAW − SENSOR_OFFSET) mod 4096`、`SHAFT_ANGLE = a × 36000 / 4096`（四捨五入、0〜35999）。角度の増える方向は AS5600 の DIR ピンのレベルで決まる（PA7_MODE=1 なら FLAGS bit2、それ以外は基板上の DIR の固定。H-12）。ファームウェアでは反転しない |
| FR-POS-06 | COMMAND 10（SYNC_POSITION、初期位置を設定する初期化コマンド）：現在位置（POSITION）を `a × GEAR_RATIO × STEPS_PER_REV × MICROSTEP / 4096`（四捨五入）に設定し、SENSOR_STATUS の bit4 を 1 にする。計算は 64bit で行う。結果は 0〜N−1（N = GEAR_RATIO × STEPS_PER_REV × MICROSTEP、出力軸 1 回転分のステップ数）とし、四捨五入で N になった場合は 0 にする。N が符号付き 32bit の最大値（2147483647）を超える設定では実行せず CMD_RESULT=2（起動時の自動実行（FR-POS-09）も行わない）。MOVING 中は拒否（CMD_RESULT=1）、センサ無効のときは実行せず CMD_RESULT=3。SET_POSITION と同様に、停止中のみ受け付ける |
| FR-POS-07 | 出力軸の可動範囲は 1 回転未満とする（U-10、確定）。SYNC_POSITION の後、POSITION は出力軸 1 回転分のステップ数 `GEAR_RATIO × STEPS_PER_REV × MICROSTEP` の範囲内（0〜N−1）の軸の絶対位置になる。可動範囲が角度 0 をまたぐ場合は、SENSOR_OFFSET で角度 0 を可動範囲の外へずらす。POSITION が増える方向と SHAFT_ANGLE が増える方向が一致しないときは、FLAGS bit2 で合わせる（変更後は SYNC_POSITION をやり直す） |
| FR-POS-08 | GEAR_RATIO（1〜1000）・SENSOR_OFFSET（0〜4095）・PA7_MODE（0〜2）・FLAGS bit2 は不揮発保存の対象とする（FR-NV-01）。保存レコードは 64 バイトに収める（収まらない場合は版を上げ、版の古い保存レコードは新項目を既定値で補う）。工場出荷値は 3.8 節のレジスタ表の既定値 |
| FR-POS-09 | 起動後、最初にセンサが有効になった時点で、モータが一度も動いておらず（パルス未出力）、POSITION も SET_POSITION で再定義されていなければ、自動的に SYNC_POSITION と同じ処理を行う（U-12、確定）。モータが動いた後にセンサが有効になった場合は自動では行わず、COMMAND 10 を待つ。センサが無効のままなら POSITION は 0 のまま、SENSOR_STATUS の bit4 は 0 |
| FR-POS-10 | USB の名前表（FR-USB-37）に、センサの RAW 値、状態、出力軸角度、I2C の成功・失敗回数、PA7_MODE、Z 入力レベルを登録する |
| FR-POS-11 | PA7（J10.5）は PA7_MODE で機能を切り替える（FR-NV の保存対象）。起動時は設定を読み込んでから、保存されたモードに設定する（それまではリセット時のアナログ入力のまま）。<br>**0=AD_IN**：アナログ入力。ADC1_IN12 を計測して AD_IN_MV に出す。<br>**1=DIR**：GPIO 出力（プッシュプル・低速・プルなし）で、AS5600 の DIR ピンを FLAGS bit2 のレベルで駆動する（0=Low：磁石側から見て時計回りで RAW が増える、1=High：反時計回りで増える。AS5600 データシートによる）。FLAGS bit2 を書いたら即時にレベルを変える。変更後は SYNC_POSITION をやり直す。<br>**2=Z**：GPIO 入力（プルなし）で、レベルを SENSOR_STATUS bit5 に出す。10 ms 周期で読むだけで、エッジ検出や割り込みは行わない。<br>モードを書き換えたとき、PA7 は一度アナログに戻してから新しい機能を設定する。モードが 0 以外のとき AD_IN の ADC 計測は行わず AD_IN_MV は 0xFFFF を返す |

### 3.11 AGC（P2：脱調防止）

TB67S249 の AGC（Active Gain Control）は、VREF で決めた電流を上限に、負荷トルクに応じてドライバがモータ電流を段階的に下げる機能。ファームウェアは ON/OFF だけを制御し、動作の細かい設定は基板のストラップ抵抗で固定する。根拠は TB67S249FTG データシート（2017-08-18 版、9〜13 章）。

| ID | 要求 |
|---|---|
| FR-AGC-01 | AGC の ON/OFF を FLAGS bit3（0=OFF、1=ON、既定 0）で設定する。FR-NV の保存対象とする |
| FR-AGC-02 | AGC0 と AGC1 は常に同じレベルで駆動する：ON は (High, High)、OFF は (Low, Low)。データシートの (High, Low)（動作中に ON/OFF を切り替える用途。アプリケーションノートが要る）は使わない |
| FR-AGC-03 | AGC0/AGC1 は、励磁 OFF（EN=Low）の間だけ変える（データシート「動作中に AGC0 は切り替えない」）。ENABLED 中に FLAGS bit3 を変える書き込みは、FLAGS 全体を反映せず CMD_RESULT=1 とする。NO_VM・DISABLED・FAULT 中の書き込みは即時に端子へ反映する。ただし、スタンバイ解除の直後は FR-DRV-02 の待ち時間（20 µs）を過ぎてから変える。起動時は、設定を読み込んでからスタンバイを解除する前に、保存値を端子へ出す。ENABLED 中の LOAD・FACTORY（励磁したままの停止で受け付ける、FR-NV-07）で bit3 が変わる場合は、RAM の設定は変えるが端子は変えず、次に EN=Low になったときに端子へ反映する |
| FR-AGC-04 | ストラップは次のとおり固定（基板）：CLIM0=High（R8 0Ω で VCC）、CLIM1=VCC プルアップ 100 kΩ（R12）→ 電流下限 IOUT×75%。BOOST=VCC プルアップ 100 kΩ（R16）→ 最大 7 段階補正。FLIM=VCC プルアップ 100 kΩ（R21）→ CLK 周波数が 450 Hz × 分割数（1/16 で 7.2 kHz）未満では AGC 無効。LTH=GND プルダウン 100 kΩ（R20）→ 標準感度。変更は抵抗の付け替えで行い、ファームウェアの設定項目にしない |
| FR-AGC-05 | AGC が有効になるのは FR-AGC-04 の周波数以上だけで、停止中・保持電流中・低速では VREF の電流がそのまま流れる。AGC が実際に電流を下げているかはドライバから読めないため、状態として公開しない |
| FR-AGC-06 | AGC は LO1/LO2 の異常検出（FR-MON-05）と独立とし、AGC の ON/OFF で保護の動作を変えない |

注：工場出荷値（分割 16、最高速度 3200 step/s）は FLIM のしきい値（7.2 kHz）を下回るため、AGC を ON にしても効かない。AGC を使う場合は、運転速度をしきい値以上にするか、FLIM の抵抗を変える（U-14）。

### 3.12 J10 入力（P2：エンコーダ／原点・リミット）

J10.3（PA15、ENC_A_HOME1）と J10.4（PA1、ENC_B_HOME2）を、設定 J10_MODE で A/B エンコーダ入力か原点・リミットスイッチ入力に切り替える。J10 には保護回路・外付けのプル抵抗がなく、J10.1 は +3V3 を出す。接続する信号は 3.3V 系とする（H-13）。

#### 3.12.1 共通

| ID | 要求 |
|---|---|
| FR-J10-01 | J10_MODE（0x59）：0=未使用、1=ENC、2=HOME。既定 0。FR-NV の保存対象。起動時は設定を読み込んでから端子を設定する（それまではリセット時の状態のまま） |
| FR-J10-02 | J10_MODE の書き込みは停止中（パルス出力なし、原点復帰中でない）だけ受け付け、即時に端子を切り替える。動作中は CMD_RESULT=1。切り替えるときは一度アナログ入力に戻してから新しい機能を設定する |
| FR-J10-03 | 0=未使用：PA15・PA1 をアナログ入力にする（消費電流を抑える）。INPUT_STATUS bit0〜1 と ENC_COUNT は 0 |
| FR-J10-04 | PA15 はリセット直後 JTDI（JTAG）として内部プルアップ付きで設定されている。デバッグは SWD（PA13/PA14）だけを使うため、PA15 を他の機能に設定してよい |

#### 3.12.2 エンコーダ（J10_MODE=1）

| ID | 要求 |
|---|---|
| FR-ENC-01 | PA15 を TIM2_CH1、PA1 を TIM2_CH2（いずれも AF1、内部プルアップ）に設定し、TIM2 のエンコーダモード（両相の両エッジ、4 逓倍）で数える。オープンコレクタ出力のエンコーダも接続できるよう内部プルアップを有効にする |
| FR-ENC-02 | 入力にデジタルフィルタをかけ、ノイズによる誤カウントを防ぐ。各相 200 kHz（4 逓倍で 800 kcount/s）までの入力を数えられること。フィルタの値は config.h の定数とする |
| FR-ENC-03 | カウントは TIM2 の 32bit カウンタをそのまま符号付き 32bit として ENC_COUNT（0x5C）に出す。モード 1 へ切り替えたときと起動時に 0 にする。カウント方向は配線のとおりとし、ファームウェアでは反転しない |
| FR-ENC-04 | エンコーダの値は読み出し専用の公開だけに使い、モータ制御（脱調検出・閉ループ補正）・保護には使わない。ステップ位置（POSITION）との関係づけは上位側が行う |
| FR-ENC-05 | USB の名前表（FR-USB-37）に ENC_COUNT と J10_MODE を登録する |

#### 3.12.3 原点・リミット（J10_MODE=2）

HOME1（PA15）を ＋ 側（POSITION が増える方向）、HOME2（PA1）を − 側のリミット兼原点スイッチとする。FLAGS bit0（方向反転）に関係なく、POSITION の増減で ＋／− を決める。

| ID | 要求 |
|---|---|
| FR-HOME-01 | PA15・PA1 を GPIO 入力（内部プルアップ）に設定する。作動の論理は FLAGS bit4（0=アクティブ Low：NO 接点・オープンコレクタ向け、既定。1=アクティブ High）で両入力共通に決める |
| FR-HOME-02 | 入力は 1 ms 周期で読み、2 回連続で同じレベルなら確定する（確定まで最大約 2 ms）。確定した作動状態を INPUT_STATUS bit0（HOME1）・bit1（HOME2）に出す |
| FR-HOME-03 | リミット停止：パルス出力中に、進行方向側の入力（＋ 方向なら HOME1、− 方向なら HOME2）が作動したら、パルスを即停止する（ESTOP と同じ。励磁は維持）。INPUT_STATUS bit5 を 1 にする。FAULT にはしない。入力の確定から停止までを 1 ms 以内とする。「進行方向」は、パルス出力中の POSITION の増減方向で判定する（FLAGS bit0 の方向反転とは無関係）。原点復帰中はこのリミット停止を行わず、停止は原点復帰の手順（FR-HOME-05・06）に従う（bit5 も立てない） |
| FR-HOME-04 | 作動しているリミット側への移動指令（MOVE_ABS・MOVE_REL・RUN_SPEED・ジョグ）は受け付けず CMD_RESULT=1 とする（ジョグは動かさない）。反対側への移動は受け付ける。MOVE_ABS の方向は目標位置と現在位置の差で決める。INPUT_STATUS bit5 は、次に受け付けた移動指令（MOVE_ABS・MOVE_REL・RUN_SPEED（0 以外）・ジョグ）または原点復帰の開始で 0 にする |
| FR-HOME-05 | 原点復帰：COMMAND 11 HOME_NEG（HOME2 側）、12 HOME_POS（HOME1 側）。ENABLED・停止中・J10_MODE=2 のときだけ受け付け、それ以外は CMD_RESULT=1。開始時に両側の入力が作動していれば、動かさずに失敗（bit4=1）とする。手順は (1) 指定側へ HOME_SPEED（加速度 ACCEL）で移動する。開始時にすでに指定側が作動していれば (3) から始める。(2) 指定側の入力が作動したらパルスを即停止する。(3) 反対方向へ START_SPEED（HOME_SPEED を超える場合は HOME_SPEED）で、入力が非作動になるまで移動し、非作動の確定で即停止する。(4) POSITION を 0 にし、INPUT_STATUS bit3（原点確定済み）を 1 にする |
| FR-HOME-06 | 原点復帰中は INPUT_STATUS bit2 を 1、STATUS bit0（MOVING）を 1 にする。STOP・ESTOP・DISABLE・通信タイムアウト（FR-MON-09）・FAULT で中止し、bit2 を 0、bit4（失敗）を 1 にする。(1) の途中で反対側の入力が作動した場合（スイッチの取り違え）、および (3) で START_SPEED により 1 回転分（STEPS_PER_REV × MICROSTEP ステップ）動いても非作動にならない場合も、即停止して失敗とする。(1) で中止の原因になる反対側の作動は、開始後に新たに作動した場合だけとする（開始時から作動していれば、そこから離れる方向へ探索する）。(3) の途中で反対側が作動した場合と、指令によらずパルスが止まった場合も失敗とする。原点復帰中の MOVE_ABS・MOVE_REL・RUN_SPEED（0 以外）・ジョグは CMD_RESULT=1 で拒否し、RUN_SPEED=0 は減速停止として原点復帰を中止する。新しい原点復帰を始めると bit3・bit4 を 0 にする。bit3 は次の原点復帰の開始まで保持する |
| FR-HOME-07 | 原点復帰の完了で POSITION を再定義するため、SET_POSITION と同じく FR-POS-09 の自動 SYNC_POSITION の対象外になる（SYNC_POSITION と原点復帰のどちらを使うかは上位側が決める） |
| FR-HOME-08 | USB の名前表に、HOME1・HOME2 の確定レベル、INPUT_STATUS、原点復帰の内部状態を登録する |

### 3.13 ブートローダ移行（P2：ROM の USB DFU）

STM32L433 のシステムメモリにある ROM ブートローダの USB DFU で書き換える。自作のブートローダは持たず、アプリケーションの配置（0x08000000 から）とベクタテーブルは変えない。現在は S3（BOOT0）を押しながら S1 でリセットして DFU に入る。この操作を USB のコマンドで行えるようにする。

| ID | 要求 |
|---|---|
| FR-BL-01 | USB のコマンド ENTER_BOOTLOADER（0x50、PARAM は KEY u32 = 0x544F4F42）で ROM ブートローダへ移る。CONNECT 済みのセッションでだけ受け付ける。KEY が一致しなければ ERR 0x32 で何もしない。CAN（レジスタ・ブロードキャスト）からは受け付けない |
| FR-BL-02 | ENABLED 中（励磁中）は受け付けず ERR 0x33 を返す。NO_VM・DISABLED・FAULT で受け付ける |
| FR-BL-03 | 受け付けたら、まず ACK を送り、送信完了まで（最大 50 ms）待つ。次に、ドライバを安全状態（EN=Low、DMODE=000、DAC 最小）にし、RAM の指定領域（リセットで初期化しない領域）に移行フラグを書いてソフトウェアリセットする |
| FR-BL-04 | IWDG は一度起動するとリセットでしか止まらないため（ROM ブートローダは IWDG を更新しない）、リセット後のスタートアップで、IWDG・クロック・周辺を初期化する前に移行フラグを確認する。フラグがあれば消してから ROM ブートローダ（システムメモリ 0x1FFF0000）へ移る。フラグは一致する値（マジック値）のときだけ有効とし、電源投入時の RAM の不定値で誤って移らないようにする。フラグは SRAM1 のリセットで初期化しない領域（`.noinit`）に置く。SRAM2 は、オプションバイト SRAM2_RST の設定によってはリセットで消えるため使わない |
| FR-BL-05 | ROM ブートローダの終了（STM32CubeProgrammer の `-g 0x08000000`、または S1 リセット）でアプリケーションが通常どおり起動する。DFU の消去・書き込みはアプリケーション領域だけを対象とし、設定領域（0x0803F000〜、FR-NV-02）を消さない（セクタ単位の消去で 0x0803F000 未満だけを消す。手順は `firmware/README.md` に記載する） |
| FR-BL-06 | ROM ブートローダ中は PC15（CAN_S）が未設定の入力に戻り、TJA1441AT は内部プルアップでサイレントモードになる（H-8）。このため ROM ブートローダが CAN1（PB8/PB9）を有効にしても、ビットレートの違う CAN バスへエラーフレームを出さない。この前提は保ち、CAN_S の回路を変える場合は再確認する |
| FR-BL-07 | ROM ブートローダ中のドライバ制御端子の状態を確認する（H-14）。ROM ブートローダは USART・I2C・SPI の端子も設定するため、PA9/PA10（DRV_DIR/DRV_EN）、PB10/PB11（AGC）、PB12〜PB15（DMODE・RESET）が意図しないレベルにならないことを実機で確かめる。確認できるまでは、DFU は VM を切った状態で行う手順とする |

---

## 4. 非機能要求

| ID | 要求 |
|---|---|
| NFR-01 | 開発環境：STM32CubeMX ＋ VS Code（ST 公式拡張「STM32CubeIDE for Visual Studio Code」）、ビルドは CMake ＋ Ninja（詳細は `firmware/README.md`）。書き込み・デバッグは ST-LINK（J5 SWD） |
| NFR-02 | RTOS は使用しない（割り込み＋スーパーループ）。パルス生成割り込みを最優先とする |
| NFR-03 | 異常検出から EN=Low まで 10 µs 以内（LO1/LO2 EXTI） |
| NFR-04 | 設定は内蔵 Flash に保存する（3.7 節）。消去回数 1 万回 × 1 ページ 32 レコード × 2 ページで、約 64 万回の保存に耐える |

---

## 5. 未確定事項（要確認）

| No | 内容 | 暫定値 |
|---|---|---|
| U-1 | CAN ビットレート（バス長・台数で決める） | 500 kbit/s |
| U-2 | CAN ID の割り当て（上位側の既存システムとの衝突） | 3.8 節 FR-COM-03 |
| U-3 | 終端方式（DIP 切り替えの 120Ω 単体か、スプリット終端か） | DIP 4 極目＋120Ω（H-6） |
| U-5 | 過熱しきい値・TH1 の実装位置 | 警告 70 °C / 異常 80 °C |
| U-6 | 上位マスターの仕様（ポーリング周期、同時起動の要否） | 個別 ID でのレジスタアクセスによる各ドライバーへの制御指令と、ブロードキャストの停止指令のみ |
| U-7 | LO1/LO2 は回路上 +3V3 プルアップ。VM 未投入時の入力レベル | VM 正常＋スタンバイ解除後のみ評価 |
| U-8 | USB の VID/PID（製品化時に取得するか、開発用のままにするか） | ST 既定 0x0483/0x5740 |
| U-9 | USB 接続中に CAN と USB の両方から動作指令を受け付けてよいか（現状は排他なし、到着順） | 排他なし（FR-USB-43） |
| U-10 | （確定）出力軸の可動範囲は 1 回転未満 | 1 回転未満（FR-POS-07） |
| U-11 | （確定）ギヤ比の既定値 | 20（GEAR_RATIO 既定。20:1 と 40:1 は書き換えて使う） |
| U-12 | （確定）起動時に自動で SYNC_POSITION を行う。COMMAND 10 でも初期位置を設定できる | FR-POS-09 |
| U-13 | （確定）PA7 は設定（PA7_MODE）で AD_IN / DIR / Z に切り替える。AS5600 の DIR ピンは PA7 に配線する。Z の意味（原点センサ、エンコーダのインデックスなど）は上位側が決め、FW は入力レベルを公開するだけ。磁石の取り付け（軸端との距離）と I2C の速度は実機で決める | FR-POS-11 |
| U-14 | AGC を使う運転条件と FLIM の抵抗値。現状（R21 100 kΩ プルアップ）では 1/16 で 7.2 kHz 未満は AGC 無効で、工場出荷値の速度では効かない | R21 は現状のまま。実機で効果を見て決める |
| U-15 | エンコーダの分解能・出力形式（オープンコレクタ／プッシュプル、5V 系か）と、接続先（モータ軸か出力軸か） | 3.3V 系、各相 200 kHz 以下 |
| U-16 | 原点・リミットスイッチの種類（機械式・フォトインタラプタ）と、原点復帰の探索速度・戻り速度の実用値 | HOME_SPEED 800 step/s、戻りは START_SPEED |
| U-17 | ROM ブートローダの USB DFU が、本基板のクロック構成（HSE なし）で動くこと。ブートローダ版の確認（`firmware/.vscode/tasks.json` の 0x1FFF6FF2 の読み出し）と AN2606 の STM32L43xxx の節で確認する | 動く前提（現在 BOOT0 押下で DFU 書き込みに使っている） |

### 5.1 ハードウェアへの申し送り（0.2 の変更に伴う）

| No | 内容 |
|---|---|
| H-1 | **R34（10kΩ）は残すこと。** 0Ω にすると DAC 出力バッファが C14（100nF）を直接駆動する。STM32L4 の DAC バッファの許容負荷容量（データシート上 50pF 程度）を大きく超え、発振・不安定のおそれがある。R34 を残しても VREF 入力電流（最大 1µA）による誤差は 10 mV（12.5 mA）以下 |
| H-2 | R32 未実装のため、MCU リセット中や書き込み中は VREF が不定。ENABLE は R28 で Low に保たれるので出力は出ないが、ENABLE のプルダウンは外さないこと |
| H-3 | 3A 運転時の発熱：TB67S249 の動作電流は標準 2.25A・最大 4.5A（熱条件で制限）。ヒートシンク（U9）込みで温度評価が必要。基板過熱保護は TH1 の位置の温度で判定する |
| H-4 | モータコネクタ J3（JST XH）は AWG22 で 3A 定格で、3A 運転では余裕がない。J4 側の定格・電線径も確認する |
| H-5 | NCP18XH103F03RB は DigiKey で「新規設計非推奨」の表示がある。後継品に替える場合は config.h の B 定数を変更する |

### 5.2 ハードウェアへの申し送り（0.3 の CAN 化に伴う）

回路の詳細は `schematic/stm32l433_tb67s249_connection.md` の 4.1 節と 13 節。

| No | 内容 |
|---|---|
| H-6 | 終端 120Ω はバスの物理的な両端の 2 台だけ ON にする（SW2 の 4 極目）。ファームウェアからは終端の状態を読めないので、設置時に CANH–CANL 間が約 60Ω であることをテスタで確認する |
| H-7 | TJA1441AT の VCC は +5V から取る（ドミナント時 最大 60mA、バス短絡時 最大 125mA）。USB だけで給電して CAN を使う場合、USB 2.0 の列挙前 100mA を超えないか実測する |
| H-8 | TJA1441AT の S ピンは内部プルアップのため、開放するとサイレントモードになり送信できない。リセット直後（PC15 が浮いた入力の間）もサイレントなので、ファームウェアが CAN 起動前に PC15 を Low に駆動する（FR-COM-14）。外付け部品は追加しない。トランシーバを変える場合は S ピンの仕様を再確認する |
| H-9 | PB8/PB9 を CAN に使うため、DRV_AGC0/1 を PB10/PB11 へ移す。AGC は P2 機能で、P1 では常に Low（TB67S249 の内部プルダウンでも Low） |
| H-10 | J1/J2 は JST PH 3 ピン（B3B-PH-K-S）に変更する。ピン配は 1=CANH、2=CANL、3=GND。5V は出さない（旧仕様の 5V 出力は廃止） |
| H-11 | 基板内の GND は NT1 で GNDPWR とつながっている。VM 側の電源 GND が外れると、モータ電流が CAN ケーブルの GND 線（PH 1 ピン、定格 2A 程度）へ回り込むおそれがある。電源 GND は先に接続し、最後に外すこと |

### 5.3 ハードウェアへの申し送り（0.7 の位置センサに伴う）

| No | 内容 |
|---|---|
| H-12 | AS5600 の DIR ピンを PA7（AD_IN、J10.5）に接続する。PA7_MODE=1 のときは MCU が DIR を駆動する。MODE=0（AD_IN）、2（Z）では PA7 が出力でなくなり、リセット直後から FW が PA7 を設定するまでも PA7 が浮くため、DIR の電位を定めるプルダウン（例 10kΩ）を基板に追加すること（角度の増える方向は時計回りに固定される）。J10.5 に外部のアナログ信号や他の出力を接続するときは、PA7_MODE を 1 以外にして、DIR 出力と衝突しないようにする。回路図は未反映 |

### 5.4 ハードウェアへの申し送り（0.9 の P2 入力・ブートローダに伴う）

| No | 内容 |
|---|---|
| H-13 | J10.3/J10.4（PA15/PA1）には直列抵抗・プル抵抗・ESD 保護がない。外部配線を引き回すエンコーダ・スイッチを接続するなら、直列抵抗（例 100Ω〜1kΩ）と ESD 保護の追加を検討する。5V 出力のエンコーダは、レベル変換を入れるか、オープンコレクタ出力にして MCU の内部プルアップ（3.3V）で受ける |
| H-14 | ROM ブートローダ中のドライバ制御端子（FR-BL-07）。ENABLE は R28（10 kΩ）でプルダウンされているが、ROM ブートローダが PA10 を USART1_RX として内部プルアップ付きで設定する場合、分圧で Low 判定の余裕が小さくなるおそれがある。実機で測定し、余裕がなければ R28 を小さくする（例 4.7 kΩ）か、DFU は VM を切った状態で行う手順にする |
| H-15 | AGC のストラップ（FR-AGC-04）を変えるときは、4 値入力の上側を DRV_VCC（5V）につなぐこと（+3V3 不可）。抵抗精度は ±20% 以内 |

---

## 6. 試験項目（P1）

1. 電源投入時、EN/DMODE/DAC が安全状態であること（ロジアナ・テスタ）。手順：[test_poweron_safe_state.md](test_poweron_safe_state.md)
2. USB 給電のみで NO_VM を維持し、励磁しないこと。
3. VM 12 V / 24 V で VM_MV が ±2% 以内であること。
4. DMODE 各設定で 1 回転のステップ数が一致すること。
5. CLK 波形：パルス幅 ≥ 1 µs、速度 1〜100k step/s、加減速プロファイル。
6. DAC 電流設定：MOTVREF_TP1 の電圧が `I/1.25` に一致すること。
7. モータ線外し（OPD）で FAULT へ遷移し、CLEAR_FAULT で復帰すること。
8. 励磁中に VM を遮断して FAULT（低電圧）になること。
9. CAN：ID 0x100+ID で全レジスタ読み書き、32bit 書き込みの部分書き込みが無視されること。他局宛てのフレームに応答しないこと。ブロードキャスト ESTOP で全台が停止すること。
9a. CAN 終端：両端の 2 台だけ終端 ON のとき CANH–CANL 間が約 60Ω であること。終端の有無でエラーカウンタと波形を比較すること。
9b. CAN バスオフ：CANH–CANL を短絡して解除すると自動復帰し、LED_COMM の表示が正しいこと。
10. 通信タイムアウトで減速停止すること。
11. ウォッチドッグ：メインループ停止でリセットし、安全状態で再起動すること。
12. 設定保存：RUN_CURRENT=3000 などを書いて SAVE → 電源再投入後も保持され、CONFIG_STATUS bit0=1 であること。
13. 保存の繰り返し：65 回以上 SAVE してページ切り替えを跨いでも最新値が読めること。
14. 保存中の電源断：SAVE 直後に電源を切っても、次回起動時に前回値か新しい値のどちらかで起動すること。
15. 範囲外の書き込み（RUN_CURRENT=3500 など）が CMD_RESULT=2 で拒否されること。
16. 3A 設定で MOTVREF_TP1 が約 2.40V になること。3A 連続運転時の IC・TH1 温度を測定すること。
17. USB：USB 給電のみで仮想 COM ポートとして認識され、CONNECT・GET_VERSION・EXCHANGE_ID が応答すること。EXCHANGE_ID がビルドした ELF の build-id と一致すること。
18. USB フレーム：CRC 不正・LEN 範囲外・途中で途切れたフレームを捨て、次の正しいフレームに応答すること。CONNECT 前の要求に ERR 0x35 を返すこと。
19. USB メモリ読み出し：ELF から解決したアドレスの SET_MTA＋UPLOAD・SHORT_UP の値が SWD（ST-LINK）で読んだ値と一致すること。ペリフェラル領域・領域を跨ぐ要求に ERR 0x33 を返すこと。
20. USB 名前表：SYM_COUNT・SYM_INFO で全登録を列挙でき、SYM_FIND・SYM_UPLOAD で名前指定の値が読めること。未登録名に ERR 0x36 を返すこと。
21. USB の CAN 代行：試験 9 の CAN 要求をすべて CAN_REQUEST で行い、CAN と同じ応答が得られること。その間 CAN バスに応答フレームが出ないこと（CAN アナライザで確認）。FAULT 遷移時に USB へイベントが届くこと。
22. USB の影響：モータ 100k step/s 運転中に UPLOAD（240 B）を連続実行しても、CLK 波形が乱れず、LO 検出から EN=Low が 10 µs 以内であること。COM ポートを開かずに USB を接続したままでも動作が止まらないこと。
23. 位置センサの読み出し：AS5600 を接続し、軸を回して SENSOR_RAW・SHAFT_ANGLE が 0〜4095・0〜35999 の範囲で連続して変わること。PA7_MODE=1 で FLAGS bit2 を書くと PA7 のレベルが変わり、角度の増える方向が反転すること。SENSOR_OFFSET を書くと角度 0 の位置が動くこと。
24. 位置センサの異常：未接続で起動して SENSOR_STATUS bit3=1、SENSOR_RAW・SHAFT_ANGLE=0xFFFF になること。そのままモータを運転でき、FAULT にならないこと。後からセンサを接続すると 1 秒以内に有効に戻ること。磁石を外すと有効が 0 になること。
25. SYNC_POSITION：出力軸を既知の角度に置いて COMMAND 10 を送り、POSITION が `角度 × ギヤ比 × STEPS_PER_REV × MICROSTEP / 360°` になること（ギヤ比 20・40 の両方、分割 1 と 32）。MOVING 中は CMD_RESULT=1、センサ無効では CMD_RESULT=3 になること。モータを動かさずに起動したとき、センサが有効になった時点で自動的に POSITION が設定され、SENSOR_STATUS bit4=1 になること。モータを動かした後にセンサを接続しても自動では設定されないこと。
26. 位置センサの影響：モータ 100k step/s 運転中に I2C の読み出しが続いても CLK 波形が乱れず、LO 検出から EN=Low が 10 µs 以内であること。I2C の SDA を GND に短絡しても、メインループが 1 ms 以上止まらず、IWDG がリセットしないこと。
27. 位置センサの保存：GEAR_RATIO・SENSOR_OFFSET・FLAGS bit2 を書いて SAVE_SETTINGS し、電源再投入後も保持されること。範囲外（GEAR_RATIO=0、SENSOR_OFFSET=4096）は CMD_RESULT=2 で拒否されること。
28. PA7 の機能切り替え：PA7_MODE を 0/1/2 に書き換え、(0) AD_IN_MV が PA7 の入力電圧（±2%）を示すこと、(1) PA7 が FLAGS bit2 のレベルになること、(2) SENSOR_STATUS bit5 が PA7 の入力レベルに追従すること、を確認する。範囲外（3 など）は CMD_RESULT=2 で拒否されること。MODE を保存して電源再投入しても保持されること。モード切り替え中に I2C の読み出しとモータ運転が止まらないこと。
29. ホスト単体テスト（`firmware/tests/host/`）がすべて成功すること。試験 17〜21 のうちホストで検証できる項目（CRC16、フレーム受信、CONNECT 前の ERR 0x35、CONNECT・GET_VERSION・EXCHANGE_ID の応答、SET_MTA＋UPLOAD・SHORT_UP、ERR 0x33、名前表、CAN_REQUEST、CTR のエコー、送信詰まり 50 ms での要求破棄、イベントの上書き計上、FAULT イベント）を含む。
30. PC ツールの info・syms・get・read-var が実機で動作し、read-var の値が SWD（ST-LINK）で読んだ値と一致すること。

### 6.1 試験項目（P2：0.9 で追加）

31. AGC：FLAGS bit3 を 1 にすると AGC0/AGC1 が両方 High、0 で両方 Low になること（DISABLED 中）。ENABLED 中に bit3 を変える書き込みが CMD_RESULT=1 で拒否され、端子が変わらないこと。保存・再起動後も保持され、スタンバイ解除前に端子が設定されていること（ロジアナ）。
32. AGC の効果：AGC ON で FLIM しきい値以上の速度で運転し、軽負荷でモータ電流（電流プローブ）が下がり、負荷を増やすと戻ること。しきい値未満では電流が下がらないこと。AGC ON/OFF で LO 検出（試験 7）が同じに動くこと。
33. J10_MODE：0/1/2 の書き換えで PA15/PA1 の設定が変わること。動作中の書き換えが CMD_RESULT=1 になること。範囲外（3）が CMD_RESULT=2 になること。保存・再起動後も保持されること。
34. エンコーダ：A/B 信号（関数発生器 2 相、または実エンコーダ）を入れ、ENC_COUNT が 4 逓倍で増減すること。各相 200 kHz で数え落ちがないこと。モータの CLK 100k step/s 運転中も CLK 波形が乱れないこと。
35. リミット停止：＋ 方向へ移動中に HOME1 を作動させると 1 ms 以内（入力確定から）にパルスが止まり、FAULT にならず INPUT_STATUS bit5=1 になること。作動中の HOME1 側への移動指令・ジョグが CMD_RESULT=1 で拒否され、反対側へは動くこと。HOME2 と − 方向でも同じこと。FLAGS bit4 で論理が反転すること。
36. 原点復帰：COMMAND 11・12 で、スイッチまで移動→停止→戻って非作動で停止→POSITION=0、INPUT_STATUS bit3=1 になること。開始時にスイッチ作動中でも完了すること。途中の STOP・反対側の作動で中止し bit4=1 になること。繰り返し 10 回で原点位置のばらつきを測ること。
37. ブートローダ移行：USB 接続中に `nemadbg dfu` で DFU デバイス（0483:DF11）が現れ、STM32_Programmer_CLI で書き込み・`-g 0x08000000` で起動できること。書き込み後も保存設定が残っていること。ENABLED 中・KEY 不一致では移行しないこと。DFU 中に CAN バスへフレームが出ないこと（CAN アナライザ）。
38. ブートローダ中の端子：DFU 中に VM を投入し、DRV_EN・DMODE0〜2・DRV_RESET・AGC0/1 が Low のままでモータが励磁されないこと（H-14）。DFU 中に IWDG でリセットされないこと（1 分以上放置）。
39. ホスト単体テストに ENTER_BOOTLOADER の受け付け条件（未接続 0x35、KEY 不一致 0x32、ENABLED 中 0x33、受け付け時に ACK を返す）を加え、すべて成功すること。
