rx178nwj/StepperMotorDriver-Node/schematic_NEMA17/review/ap63205-after/buck.png

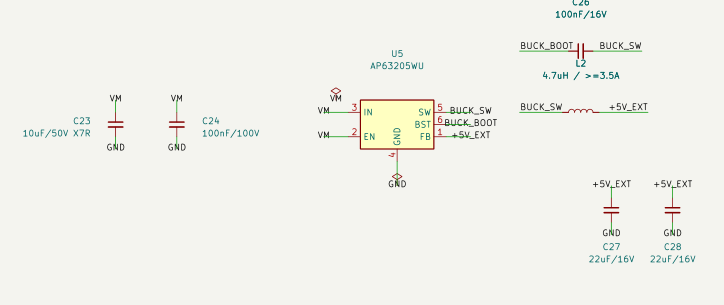
schematic_NEMA17/review/ap63205-after/buck.png
