rx178nwj/StepperMotorDriver-Node/schematic_NEMA17/review/driver-after/driver.png

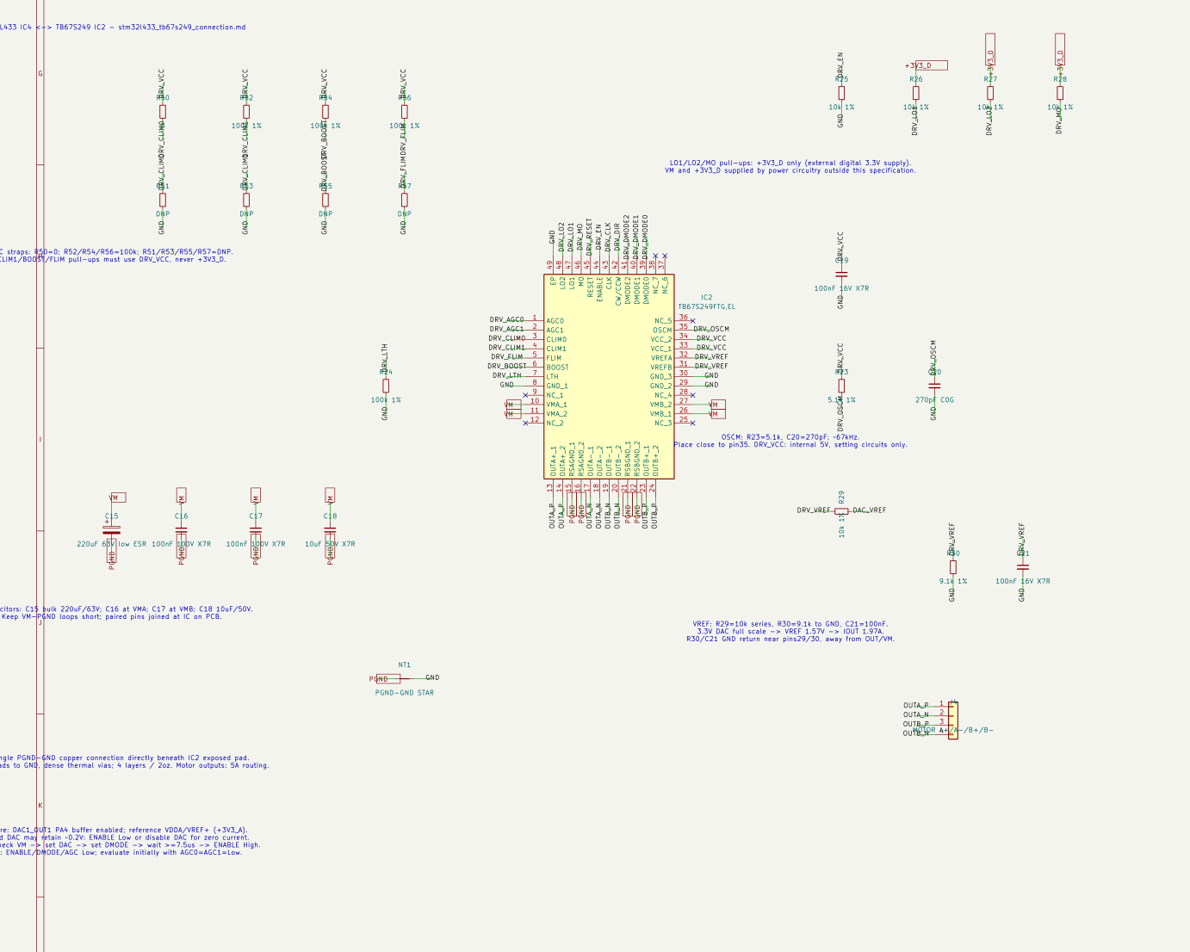
schematic_NEMA17/review/driver-after/driver.png
