rx178nwj/StepperMotorDriver-Node/schematic_NEMA17/review/labels-before/detail.png

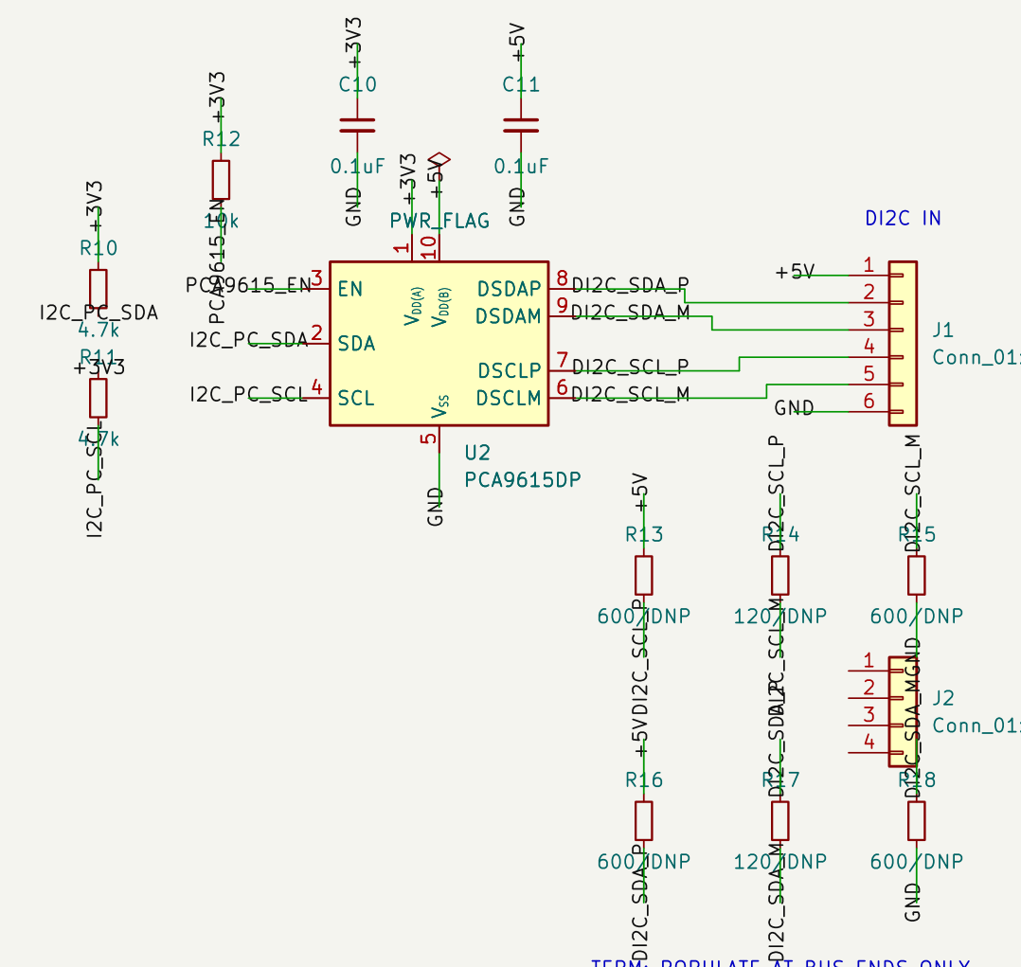
schematic_NEMA17/review/labels-before/detail.png
