rx178nwj/StepperMotorDriver-Node/schematic_NEMA17/review/led/after.png

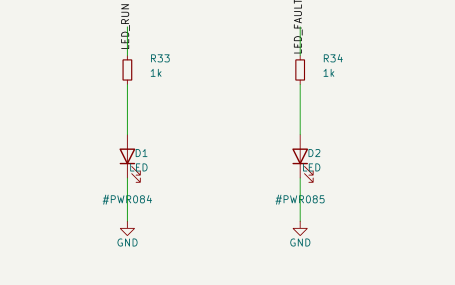
schematic_NEMA17/review/led/after.png
