rx178nwj/StepperMotorDriver-Node/schematic_NEMA17/review/led/status.png

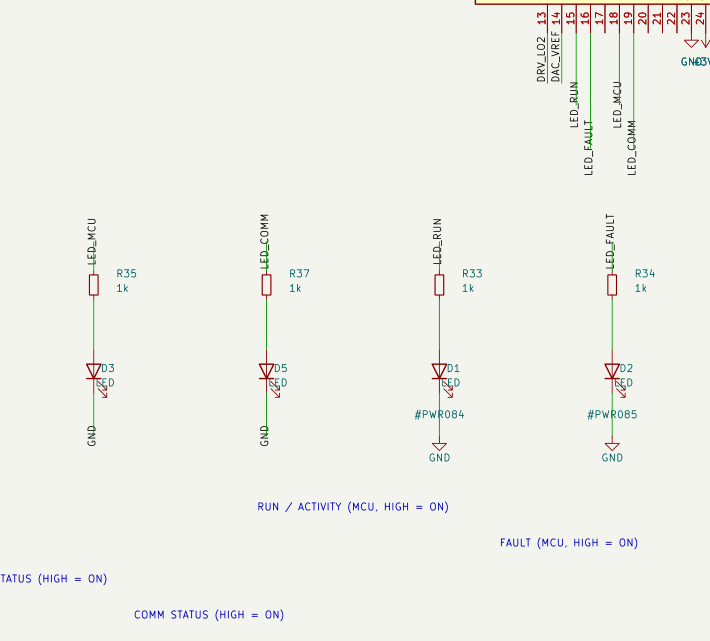
schematic_NEMA17/review/led/status.png
