rx178nwj/StepperMotorDriver-Node/schematic_NEMA17/review/power-after/power.png

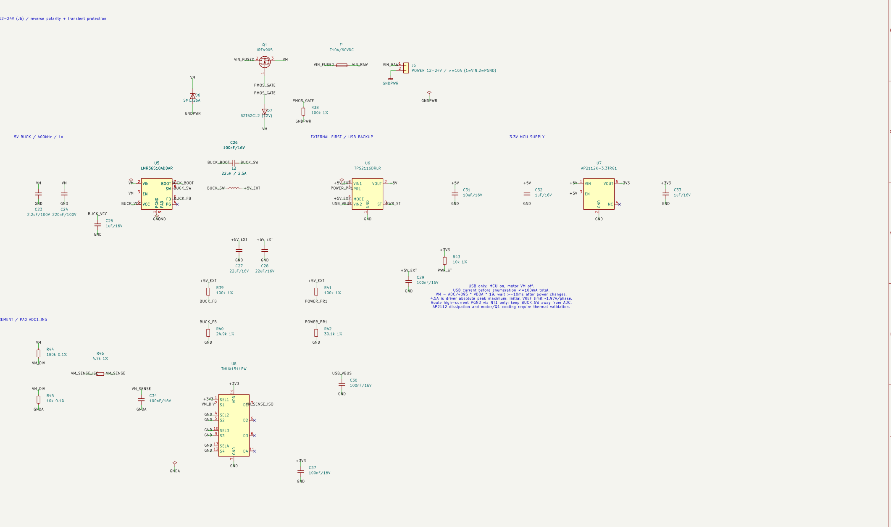
schematic_NEMA17/review/power-after/power.png
