rx178nwj/StepperMotorDriver-Node/schematic_NEMA17/review/stm32_support/after/sense.png

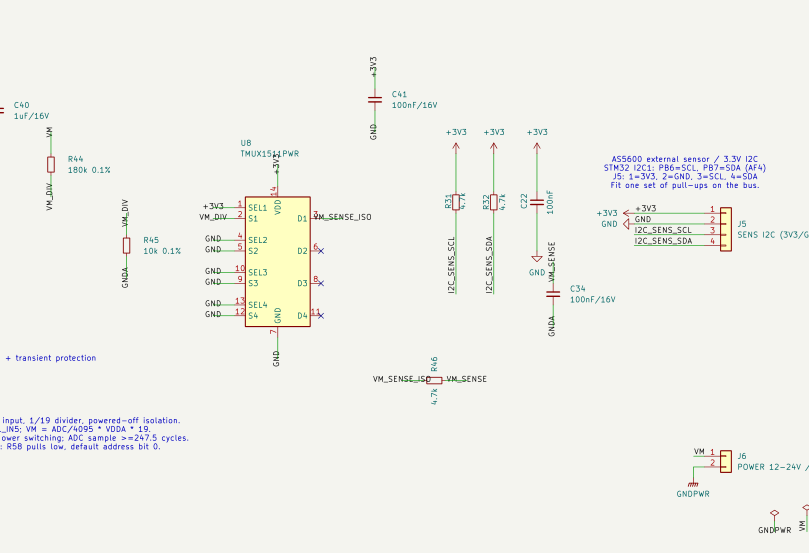
schematic_NEMA17/review/stm32_support/after/sense.png
