rx178nwj/StepperMotorDriver-Node/schematic_NEMA17/review/vm-rsv-after/vm-circuit.png

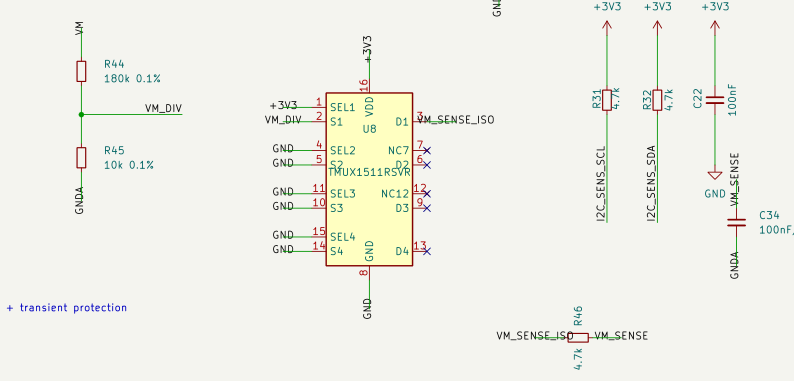
schematic_NEMA17/review/vm-rsv-after/vm-circuit.png
