rx178nwj/StepperMotorDriver-Node/schematic_NEMA23/review/gpio_adc/after/connectors.png

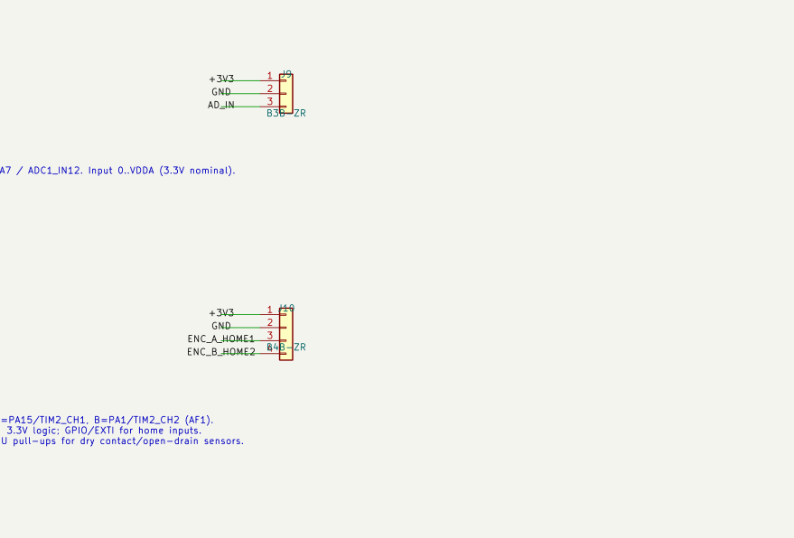
schematic_NEMA23/review/gpio_adc/after/connectors.png
