rx178nwj/StepperMotorDriver-Node/schematic_NEMA23/review/labels-after/detail.png

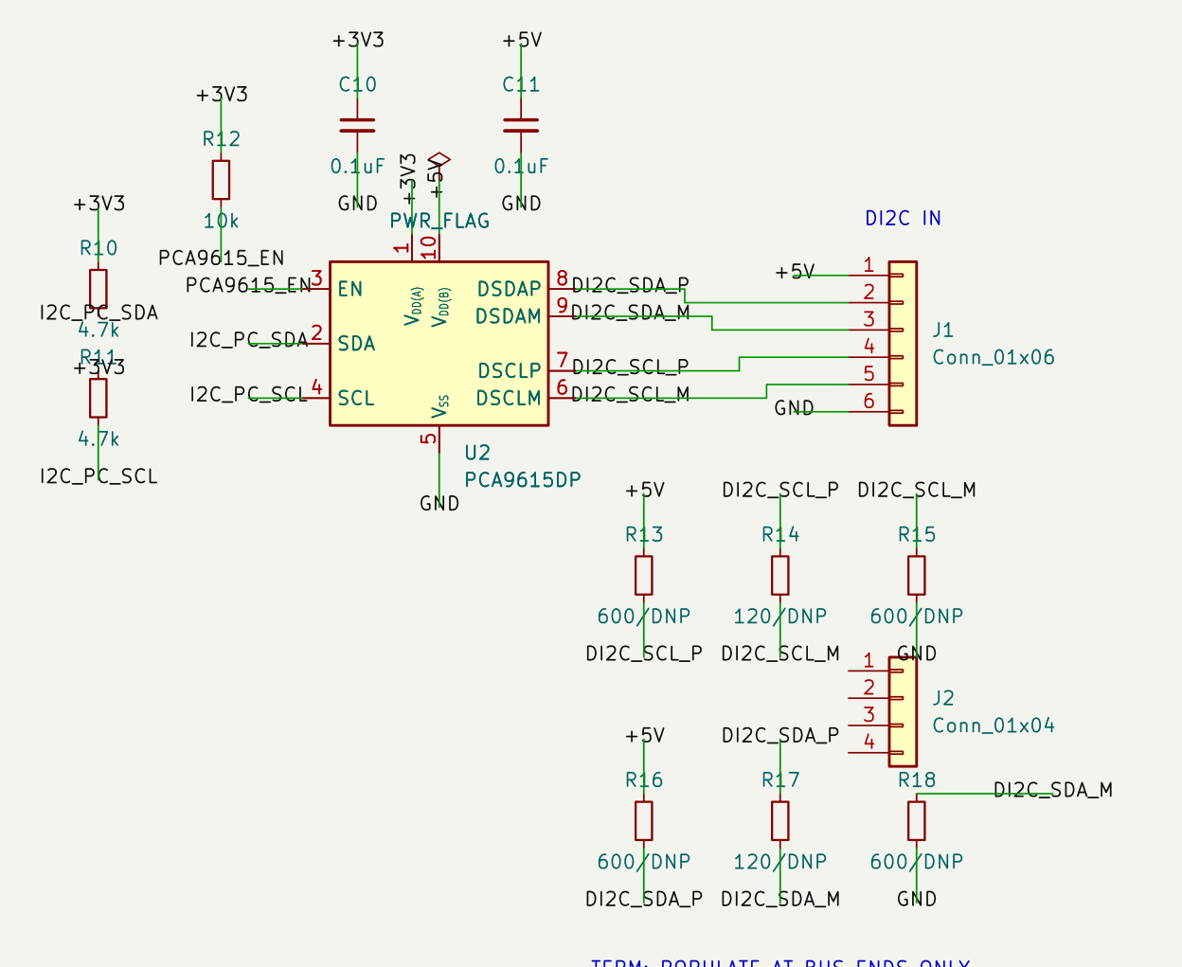
schematic_NEMA23/review/labels-after/detail.png
