rx178nwj/StepperMotorDriver-Node/schematic_NEMA23/review/led/before.png

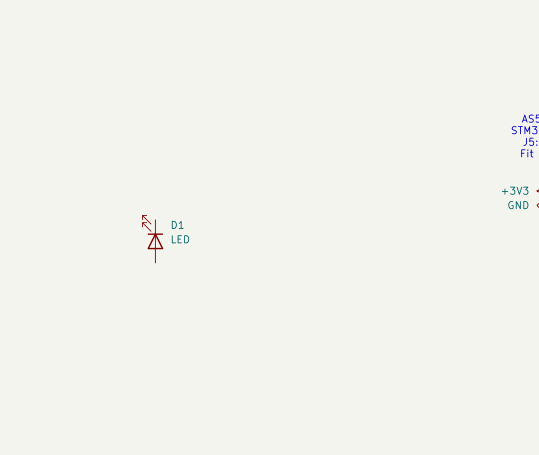
schematic_NEMA23/review/led/before.png
