rx178nwj/StepperMotorDriver-Node/schematic_NEMA23/review/schematic_NEMA23.png

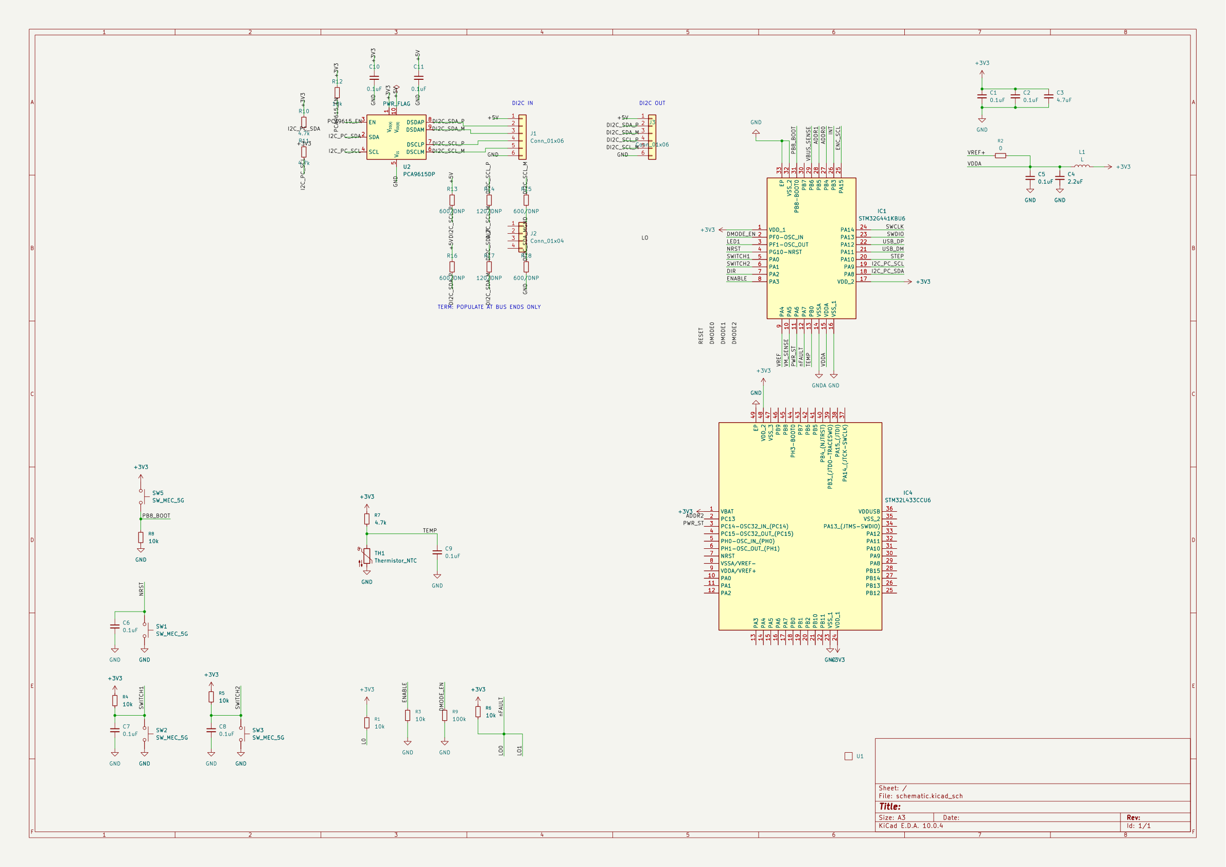
schematic_NEMA23/review/schematic_NEMA23.png
