rx178nwj/StepperMotorDriver-Node/schematic_NEMA23/review/led/schematic-bom.csv

Refs | Value | Footprint | Qty | DNP
C1 | 0.1uF | Resistor_SMD:R_0603_1608Metric | 1
C2 | 0.1uF | Resistor_SMD:R_0603_1608Metric | 1
C3 | 4.7uF | Capacitor_SMD:C_0603_1608Metric | 1
C4 | 2.2uF | Capacitor_SMD:C_0603_1608Metric | 1
C5 | 0.1uF | Capacitor_SMD:C_0603_1608Metric | 1
C6 | 0.1uF | Resistor_SMD:R_0402_1005Metric | 1
C7 | 0.1uF | Resistor_SMD:R_0402_1005Metric | 1
C8 | 0.1uF | Resistor_SMD:R_0402_1005Metric | 1
C9 | 0.1uF | Resistor_SMD:R_0402_1005Metric | 1
C10 | 0.1uF | Capacitor_SMD:C_0603_1608Metric | 1
C11 | 0.1uF | Capacitor_SMD:C_0603_1608Metric | 1
C12 | 100nF | Capacitor_SMD:C_0603_1608Metric | 1
C13 | 1uF | Capacitor_SMD:C_0603_1608Metric | 1
C14 | 100nF | Capacitor_SMD:C_0402_1005Metric | 1
C15 | 220uF 63V low ESR | Capacitor_THT:CP_Radial_D10.0mm_P5.00mm | 1
C16 | 100nF 100V X7R | Capacitor_SMD:C_0603_1608Metric | 1
C17 | 100nF 100V X7R | Capacitor_SMD:C_0603_1608Metric | 1
C18 | 10uF 50V X7R | Capacitor_SMD:C_0805_2012Metric | 1
C19 | 100nF 16V X7R | Capacitor_SMD:C_0402_1005Metric | 1
C20 | 270pF C0G | Capacitor_SMD:C_0402_1005Metric | 1
C21 | 100nF 16V X7R | Capacitor_SMD:C_0402_1005Metric | 1
C22 | 100nF | Capacitor_SMD:C_0603_1608Metric | 1
D1 | LED | LED_SMD:LED_0603_1608Metric | 1
D2 | LED | LED_SMD:LED_0603_1608Metric | 1
D4 | LED | LED_SMD:LED_0603_1608Metric | 1
IC2 | TB67S249FTG,EL | Library:QFN50P700X700X100-49N-D | 1
IC4 | STM32L433CCU6 | Library:QFN50P700X700X60-49N-D | 1
J1 | Conn_01x06 | Connector_JST:JST_PH_B5B-PH-K_1x05_P2.00mm_Vertical | 1
J2 | 5077CR-16SMC2-BK-TR | Library:NELTRON_5077CR-16SMC2-BK-TR | 1
J3 | Conn_01x06 | Connector_JST:JST_PH_B5B-PH-K_1x05_P2.00mm_Vertical | 1
J4 | MOTOR A+/A-/B+/B- | Connector_JST:JST_XH_B4B-XH-A_1x04_P2.50mm_Vertical | 1
J5 | SENS I2C (3V3/GND/SCL/SDA) | Connector_JST:JST_PH_B4B-PH-K_1x04_P2.00mm_Vertical | 1
L1 | L | LED_SMD:LED_0201_0603Metric_Pad0.64x0.40mm_HandSolder | 1
NT1 | PGND-GND STAR | NetTie:NetTie-2_SMD_Pad0.5mm | 1
NT2 | PGND-GND STAR | NetTie:NetTie-2_SMD_Pad0.5mm | 1
R1 | 10k | Resistor_SMD:R_0402_1005Metric | 1
R2 | 0 | Resistor_SMD:R_0402_1005Metric | 1
R3 | 10k | Resistor_SMD:R_0402_1005Metric | 1
R4 | 10k | Resistor_SMD:R_0402_1005Metric | 1
R5 | 10k | Resistor_SMD:R_0402_1005Metric | 1
R6 | 10k | Resistor_SMD:R_0402_1005Metric | 1
R7 | 4.7k | Resistor_SMD:R_0402_1005Metric | 1
R8 | 10k | Resistor_SMD:R_0402_1005Metric | 1
R9 | 100k | Resistor_SMD:R_0402_1005Metric | 1
R10 | 4.7k | Resistor_SMD:R_0402_1005Metric | 1
R11 | 4.7k | Resistor_SMD:R_0402_1005Metric | 1
R12 | 10k | Resistor_SMD:R_0402_1005Metric | 1
R13 | 600/DNP | Resistor_SMD:R_0402_1005Metric | 1
R14 | 120/DNP | Resistor_SMD:R_0402_1005Metric | 1
R15 | 600/DNP | Resistor_SMD:R_0402_1005Metric | 1
R16 | 600/DNP | Resistor_SMD:R_0402_1005Metric | 1
R17 | 120/DNP | Resistor_SMD:R_0402_1005Metric | 1
R18 | 600/DNP | Resistor_SMD:R_0402_1005Metric | 1
R19 | 5.1k 1% | Resistor_SMD:R_0402_1005Metric | 1
R20 | 5.1k 1% | Resistor_SMD:R_0402_1005Metric | 1
R21 | 33k 1% | Resistor_SMD:R_0402_1005Metric | 1
R22 | 82k 1% | Resistor_SMD:R_0402_1005Metric | 1
R23 | 5.1k 1% | Resistor_SMD:R_0402_1005Metric | 1
R24 | 100k 1% | Resistor_SMD:R_0402_1005Metric | 1
R25 | 10k 1% | Resistor_SMD:R_0402_1005Metric | 1
R26 | 10k 1% | Resistor_SMD:R_0402_1005Metric | 1
R27 | 10k 1% | Resistor_SMD:R_0402_1005Metric | 1
R28 | 10k 1% | Resistor_SMD:R_0402_1005Metric | 1
R29 | 10k 1% | Resistor_SMD:R_0402_1005Metric | 1
R30 | 9.1k 1% | Resistor_SMD:R_0402_1005Metric | 1
R31 | 4.7k | LED_SMD:LED_0603_1608Metric | 1
R32 | 4.7k | LED_SMD:LED_0603_1608Metric | 1
R33 | 1k | Resistor_SMD:R_0603_1608Metric | 1
R34 | 1k | Resistor_SMD:R_0603_1608Metric | 1
R36 | 1k | Resistor_SMD:R_0603_1608Metric | 1
R50 | 0 | Resistor_SMD:R_0402_1005Metric | 1
R51 | DNP | Resistor_SMD:R_0402_1005Metric | 1
R52 | 100k 1% | Resistor_SMD:R_0402_1005Metric | 1
R53 | DNP | Resistor_SMD:R_0402_1005Metric | 1
R54 | 100k 1% | Resistor_SMD:R_0402_1005Metric | 1
R55 | DNP | Resistor_SMD:R_0402_1005Metric | 1
R56 | 100k 1% | Resistor_SMD:R_0402_1005Metric | 1
R57 | DNP | Resistor_SMD:R_0402_1005Metric | 1
SW1 | SW_MEC_5G | Library:ＴＶＡＦ０６－Ａ０２０Ｂ－Ｒ | 1
SW2 | SW_MEC_5G | Library:ＴＶＡＦ０６－Ａ０２０Ｂ－Ｒ | 1
SW3 | SW_MEC_5G | Library:ＴＶＡＦ０６－Ａ０２０Ｂ－Ｒ | 1
SW5 | SW_MEC_5G | Library:ＴＶＡＦ０６－Ａ０２０Ｂ－Ｒ | 1
TH1 | Thermistor_NTC | Resistor_SMD:R_0603_1608Metric | 1
U1 |  | Library:MainBoard | 1
U2 | PCA9615DP | Package_SO:TSSOP-10_3x3mm_P0.5mm | 1
U3 | USBLC6-2P6 | Package_TO_SOT_SMD:SOT-666 | 1
U4 |  | Library:ヒートシンク40x40 | 1
