rx178nwj/StepperMotorDriver-Node/schematic_NEMA17/Driver_Board.stl

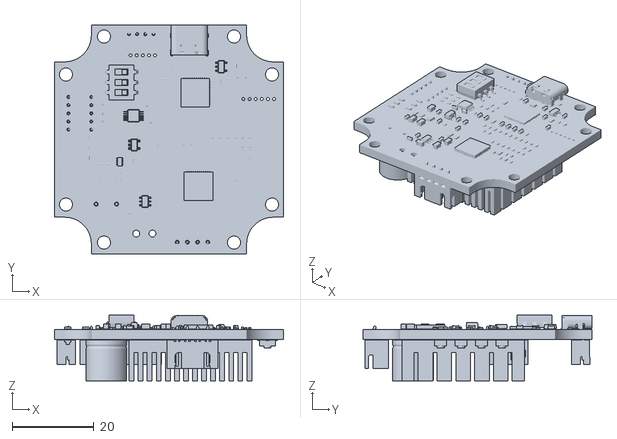
[picture p14: CAD file, 2026-10-18]
schematic_NEMA17/Driver_Board.stl
56.0 x 56.0 x 16.1
