rx178nwj/StepperMotorDriver-Node/schematic_NEMA23/Driver_Board.step

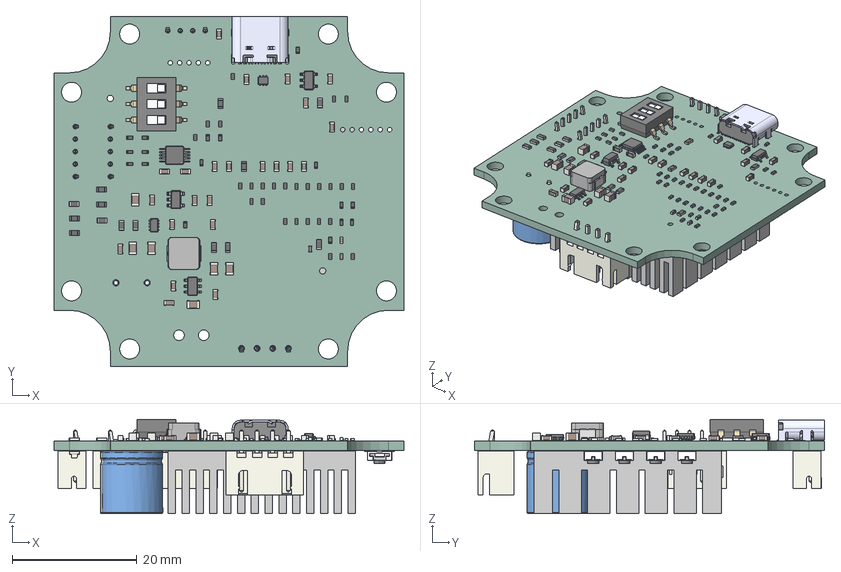
[picture p15: CAD file, 2026-10-18]
schematic_NEMA23/Driver_Board.step
56.0 x 56.0 x 15.1 mm
R_0402_1005Metric x 43
C_0805_2012Metric x 6
C_0603_1608Metric x 22
R_0603_1608Metric x 14
TSSOP-10_3x3mm_P0.5mm
C_0402_1005Metric x 3
SOT-23-5
SOT-583-8
SOT_666
TSOP-5_1.65x3.05mm_P0.95mm
5077CR-16SMC2-BK-TR
TSOT-23-6
DMR-03-V
IHLP2020CZ
L_0603_1608Metric
JST_B4B_PH_K
JST_B5B_PH_K x 2
LED_0603_1608Metric x 6
ヒートシンク40x40 v1
JST_B4B_XH_A
SKRKAEE020 x 4
CP_Radial_D100mm_P500mm
schDF84_PCB
