rx178nwj/StepperMotorDriver-Node/firmware/docs/test_poweron_safe_state.md

# 試験手順書 — 電源投入時の安全状態（試験項目 1）

| 項目 | 内容 |
|---|---|
| 対象要求 | [requirements.md](requirements.md) 6章 試験 1「電源投入時、EN/DMODE/DAC が安全状態であること」、FR-SYS-02、FR-DRV-05a、H-2 |
| 対象 | SteppingMotorDriver_NEMA23（回路図 2026-10-11 版）、ファームウェア 0.4 |
| 測定器 | ロジックアナライザ（8ch 以上、10 MS/s 以上）、オシロスコープまたはアナログ入力付きロジアナ（VREF 用）、テスタ、電流計付き安定化電源（VM 用）、ST-LINK |
| 版 | 0.2（2026-10-20：AGC を PB10/PB11 に修正、CAN_S の初期レベル確認を追加、FW 版を 0.4 に更新） |

---

## 1. 合否基準

「安全状態」は FR-SYS-02 に従い、次の表で判定する。

| 信号 | MCU ピン | IC1 ピン | 基準 | 期間 |
|---|---|---|---|---|
| EN | PA10 | 44 ENABLE | **常に Low**。High パルスが 1 回もないこと | 3V3 立ち上がりから測定終了まで |
| DMODE0/1/2 | PB12/13/14 | 39/40/41 | **常に 000**（High パルスなし） | 同上（製品ファームの VM あり条件は 4.3 参照） |
| RESET | PB15 | 45 | 常に Low | 同上 |
| CLK | PA8 | 43 | 常に Low | 同上 |
| AGC0/1 | PB10/PB11 | 1/2 | 常に Low | 同上（参考項目） |
| CAN_S | PC15 | TJA1441AT S(8) | **常に Low**（ノーマルモード。FR-COM-14）。起動直後に Low になり、High にならないこと | `board_init()` 完了（マーカ 2）以降。それより前は MCU のリセット状態（浮いた入力）なので S の内部プルアップで High になり、判定しない |
| VREF（DAC） | PA4 | 31/32 VREFB/A | **0.25 V 以下**で安定。DAC1 DOR1 = 0 | マーカ 3（`drv_init` 完了）以降 |
| VREF（DAC） | PA4 | 31/32 | 判定しない（R32 未実装のため浮く。値は記録する） | マーカ 3 より前（H-2：EN が Low なら出力は出ない） |
| モータ | — | — | 保持トルクなし（軸が手で回る）。VM 電流がロジック電源投入の前後で増えない | VM 投入中 |

- Low / High の電圧判定（テスタ）は Low ≦ 0.4 V を目安とする。TB67S249 のデータシートの入力 Low 電圧より低いことを確認すること。
- VREF の 0.25 V は「DAC コード 0、出力バッファ有効」の下限（約 0.2 V、config.h `DAC_OUT_MIN_MV`）に余裕を加えた値。0.25 V は電流 約 310 mA 相当だが、EN=Low なので出力は出ない。

---

## 2. 試験ファームウェア（試験モード）

### 2.1 ビルド

CMake プリセットを選んでビルドする。出力は `build/<preset>/driver_fw.elf`。

| プリセット | 内容 | 使う手順 |
|---|---|---|
| `TestPowerOn` | 起動シーケンスに区切りのパルス（マーカ）を入れる。初期化後は安全状態を監視し続ける | 4.1 |
| `TestPowerOnHold` | 上記に加え、`board_init()` の前に 5 秒待つ（ドライバ制御ピンをリセット状態のまま保つ） | 4.2 |
| `Release`（通常） | 製品と同じファームウェア | 4.3 |

試験ファームは製品に書き込まないこと（試験後に `Release` を書き戻す）。

書き込み（ST-LINK）：

```powershell
& $env:STM32_PROG -c port=SWD mode=UR -w build/TestPowerOn/driver_fw.elf -v -rst
```

`$env:STM32_PROG` は `.vscode/tasks.json` と同じ `STM32_Programmer_CLI.exe` のパス。

### 2.2 動作

試験モードの起動シーケンスは通常ファームと同じ順序・同じ関数で、区切りにマーカを入れただけである（[app_main.c](../App/Src/app_main.c) の `app_main_init()`）。

マーカは LED_MCU（PB0）に出る幅 5 µs・間隔 5 µs のパルス列。

| マーカ | パルス数 | 出る時点 | この時点のドライバ制御ピン |
|---|---|---|---|
| 1 | 1 | `app_main_init()` の先頭（HAL_Init・クロック設定・USB 初期化の後） | リセット状態（アナログ入力）。外付け/IC1 内蔵プルダウンだけで決まる |
| (HOLD) | PB0 を 5 秒 High | `TestPowerOnHold` のみ | 同上 |
| 2 | 2 | `board_init()` 完了 | EN/DMODE/RESET/AGC は Low 出力、CLK は AF（TIM1 停止中）、PA4 はアナログ |
| 3 | 3 | `drv_init()` 完了 | DAC1 起動（コード 0）。ここから VREF を判定する |
| 4 | 4 | `stepper_init()` 完了 | CLK は TIM1 の強制 Low |
| 5 | 5 | `monitor_init()` 完了 | 以降は監視ループ |

マーカ 5 の後は `app_init()` を呼ばない。I2C 通信・ジョグスイッチ・VM 検出による状態遷移をしないため、VM を入れても DMODE は 000 のまま保たれる。IWDG も起動しない。

監視ループは次の項目を繰り返し調べる（[test_poweron.c](../App/Src/test_poweron.c)）。

| ビット | 内容 |
|---|---|
| 0 | EN（PA10）の ODR または IDR が High |
| 1 | DMODE（PB12-14）のどれかが High |
| 2 | RESET（PB15）が High |
| 3 | AGC（PB10/PB11）のどれかが High |

試験ファームの監視ループは CAN_S（PC15）を調べない。CAN_S の確認は、ロジアナ（空き ch）またはテスタで行う（4.1）。
| 4 | CLK（PA8）のピンレベルが High |
| 5 | DAC1 DOR1 ≠ 0 |
| 6 | DAC1 CH1 が停止している |
| 7 | PA4 がアナログモードでない |

LED 表示：

| LED | 意味 |
|---|---|
| LED_MCU（PB0）1 Hz 点滅 | 試験モードで動作中 |
| LED_COMM（PB1）点灯 | ここまで不一致なし |
| LED_FAULT（PB2）点灯 | 不一致あり（ラッチ。電源再投入まで消えない） |

結果は RAM の構造体 `test_poweron_result` にも残る（4.4 で読み出す）。

| オフセット | 内容 |
|---|---|
| +0x00 | magic = 0x4E4F5750 |
| +0x04 | 判定回数（増え続けること） |
| +0x08 | 不一致の回数 |
| +0x0C | 最初の不一致のビット |
| +0x10 | 不一致ビットの累積 |
| +0x14 | 最後に読んだ DAC1 DOR1 |

---

## 3. 準備

### 3.1 接続

| ロジアナ ch | 信号 | 測定点 |
|---|---|---|
| D0 | 3V3 | 3V3 レール（トリガ用） |
| D1 | EN | R28 のパッド、または IC1 44 |
| D2 / D3 / D4 | DMODE0 / 1 / 2 | IC1 39 / 40 / 41 |
| D5 | CLK | IC1 43 |
| D6 | RESET | IC1 45 |
| D7 | マーカ（PB0） | LED_MCU の電流制限抵抗の MCU 側 |
| A0（オシロ CH1） | VREF | MOTVREF_TP1 |
| A1（オシロ CH2） | 3V3 | 3V3 レール |

- ドライバ制御信号は MCU 側ではなく IC1 側（または IC1 に近い点）で測る。IC1 が実際に受けるレベルを確認するため。
- 測定点（TP 番号とネットの対応）が決まったら、この表に書き足す。
- AGC0/1・CAN_S は ch が足りなければテスタで定常値だけ確認する。CAN_S は TJA1441AT S(8) のパッドまたは PC15 で測る（FR-COM-14 の起動直後の Low を波形で見る場合は、空き ch に接続し、マーカ 2 以降で Low になることを確認する）。

### 3.2 ロジアナ設定

| 項目 | 値 |
|---|---|
| サンプリング | 10 MS/s 以上（可能なら 25 MS/s 以上でグリッチも見る） |
| しきい値 | 1.65 V（3.3 V ロジック） |
| トリガ | D0 立ち上がり |
| 取り込み長 | 2 秒以上（4.2 は 8 秒以上） |
| プリトリガ | 10 % |

### 3.3 ST-LINK

電源投入時の挙動を変えないよう、測定中は ST-LINK の NRST 線を外すか、ST-LINK を外しておく。結果の読み出し（4.4）は測定の後に HOTPLUG で接続する（リセットも停止もしない）。

### 3.4 電源投入パターン

| 条件 | 内容 | モータ |
|---|---|---|
| C1 | USB 給電のみ（VM なし） | 接続 |
| C2 | VM（24 V）を先に入れ、その後ロジック電源（USB または外部 5 V）を入れる | 接続 |
| C3 | ロジック電源を先に入れ、その後 VM（24 V）を入れる | 接続 |
| C4 | 全電源を同時に入れる（実際の使用状態） | 接続 |

外部 5 V を VM から作っている構成では C2 と C4 は同じになる。その場合は C2 を省略してよい。

---

## 4. 手順

### 4.1 起動シーケンスの測定（`TestPowerOn`）

1. `TestPowerOn` を書き込み、全電源を切る。C14 などの電荷が抜けるまで 10 秒以上待つ。
2. ロジアナ・オシロを 3.2 の設定でトリガ待ちにする。
3. 条件 C1 で電源を入れる。
4. 取り込んだ波形で次を確認し、記録表（5章）に書く。
   1. D1（EN）が 3V3 立ち上がりから最後まで Low のままである。
   2. D2〜D4（DMODE）・D5（CLK）・D6（RESET）が最後まで Low のままである。CAN_S を ch に接続している場合は、マーカ 2 以降で Low であることも確認する。
   3. D7 にマーカ 1〜5 が順に出ている。3V3 立ち上がりから各マーカまでの時間を記録する。
   4. VREF（A0）：マーカ 3 より前の値を記録する（判定しない）。マーカ 3 から 10 ms 後以降が 0.25 V 以下で安定している（R34×C14 の時定数 1 ms）。
5. LED_COMM 点灯・LED_FAULT 消灯・LED_MCU 1 Hz 点滅を確認する。
6. テスタで定常値を測る：EN、DMODE0/1/2、RESET、AGC0/1、CLK（IC1 側）が Low、CAN_S（TJA1441AT S(8) または PC15）が Low（0.4 V 以下）、MOTVREF_TP1 が 0.25 V 以下。
7. 4.4 の手順で結果を読み出す。
8. 電源を切り、10 秒以上待ってから条件 C2・C3・C4 で 2〜7 を繰り返す。VM がある条件では次も確認する。
   - VM 電流：ロジック電源を入れる前後（C2）、VM を入れた直後（C3）で増えない。値を記録する。
   - モータ軸が手で回る（保持トルクなし）。
9. 条件 C4 を合計 10 回繰り返し、毎回 EN・DMODE に High が出ないことを確認する（偶発的なグリッチの確認）。

### 4.2 リセット状態の静的測定（`TestPowerOnHold`）

マーカ 1 の後、`board_init()` の前で 5 秒止まる（LED_MCU 点灯中）。この間、ドライバ制御ピンは MCU のリセット状態（アナログ入力）で、外付け抵抗 R28 と IC1 内蔵プルダウンだけでレベルが決まる。MCU が書き込み中・リセット中のときと同じ状態である（H-2）。

1. `TestPowerOnHold` を書き込み、全電源を切る。
2. 条件 C4 で電源を入れる（ロジアナで記録しながら）。
3. LED_MCU が点灯している 5 秒の間に、テスタで次を測る。
   - EN（R28 のパッド）・DMODE0/1/2・RESET・CLK：Low であること。
   - MOTVREF_TP1：値を記録する（判定しない。R32 未実装のため VREF は浮いており、値は一定しない）。
   - VM 電流を記録し、モータ軸が手で回ることを確認する。
4. LED_MCU が消えて 1 Hz 点滅に変わったら、MOTVREF_TP1 が 0.25 V 以下になったことを確認する。
5. 波形で、5 秒の待ちの間も EN・DMODE に High が出ていないことを確認する。

### 4.3 製品ファームウェアでの確認（`Release`）

試験モードと製品ファームで起動処理が同じであることを最終確認する。

1. `Release` を書き込み、全電源を切る。
2. 4.1 の 2〜4 と同じ接続・設定で、条件 C1 と C4 で電源を入れる（マーカは出ない）。
3. 確認内容：
   - C1（VM なし）：EN・DMODE・CLK・RESET が最後まで Low。状態は NO_VM のまま。CAN_S は `board_init()` 以降 Low のまま（製品ファームは `comm_init()` が CAN 起動前にも Low にする）。
   - C4（VM あり）：EN が最後まで Low（ENABLE コマンドを送らない限り励磁しない）。DMODE は VM が正常範囲で 50 ms 安定するまで 000 のままで、その後に設定の分割値へ変わる（FR-MON-03 による正常動作）。3V3 立ち上がりから DMODE が変わるまでの時間を記録する。
   - VREF：起動後 0.25 V 以下（電流設定の前）。
4. 4.4 の GPIO・DAC レジスタの読み出しを C1 で行う（試験用構造体は製品ファームにはない）。

### 4.4 SWD での読み出し（HOTPLUG）

HOTPLUG 接続はリセットも停止もしないので、動作中の状態をそのまま読める。

```powershell
# GPIOA IDR/ODR（PA8 = bit8 CLK、PA10 = bit10 EN）
& $env:STM32_PROG -c port=SWD mode=HOTPLUG -r32 0x48000010 2
# GPIOB IDR/ODR（PB10/11 = AGC、PB12-14 = DMODE、PB15 = RESET。PB8/9 は CAN1 なので判定しない）
& $env:STM32_PROG -c port=SWD mode=HOTPLUG -r32 0x48000410 2
# GPIOC IDR/ODR（PC15 = CAN_S が bit15 = 0 であること）
& $env:STM32_PROG -c port=SWD mode=HOTPLUG -r32 0x48000810 2
# DAC1 CR（bit0 EN1 = 1 であること）
& $env:STM32_PROG -c port=SWD mode=HOTPLUG -r32 0x40007400 1
# DAC1 DOR1（0 であること）
& $env:STM32_PROG -c port=SWD mode=HOTPLUG -r32 0x4000742C 1
```

| 値 | 期待 |
|---|---|
| GPIOA IDR・ODR `& 0x00000500` | 0 |
| GPIOB IDR・ODR `& 0x0000FC00` | 0 |
| GPIOC IDR・ODR `& 0x00008000` | 0（CAN_S = Low） |
| DAC1 CR `& 0x00000001` | 1 |
| DAC1 DOR1 | 0 |

試験ファームの結果構造体（アドレスはビルドごとに変わるので毎回調べる）：

```powershell
arm-none-eabi-nm build/TestPowerOn/driver_fw.elf | Select-String test_poweron_result
# 例: 200016a4 B test_poweron_result
& $env:STM32_PROG -c port=SWD mode=HOTPLUG -r32 0x200016A4 6
```

期待値：magic = 0x4E4F5750、不一致の回数 = 0、不一致ビットの累積 = 0、DOR1 = 0。2 回読んで判定回数が増えていること（監視ループが動いていること）。

---

## 5. 記録表

| No | ファーム | 条件 | EN 常時 Low | DMODE 常時 000 | CLK/RESET 常時 Low | VREF（マーカ 3 前） | VREF（定常） | VM 電流 | 軸フリー | fail_mask | 判定 |
|---|---|---|---|---|---|---|---|---|---|---|---|
| 1 | TestPowerOn | C1 | | | | V | V | — | — | | |
| 2 | TestPowerOn | C2 | | | | V | V | mA | | | |
| 3 | TestPowerOn | C3 | | | | V | V | mA | | | |
| 4 | TestPowerOn | C4 ×10 | | | | V | V | mA | | | |
| 5 | TestPowerOnHold | C4 | | | | V（待ち中） | V | mA | | | |
| 6 | Release | C1 | | | | V | V | — | — | — | |
| 7 | Release | C4 | | DMODE 変化まで ___ ms | | V | V | mA | | — | |

マーカ時刻（No.1、3V3 立ち上がり基準）：マーカ1 ___ ms／2 ___ ms／3 ___ ms／4 ___ ms／5 ___ ms

試験日・試験者・基板シリアル・ファームのビルド日時を併記する。

---

## 6. 不合格時の切り分け

| 現象 | 疑う箇所 |
|---|---|
| マーカ 1 より前に EN が High | R28 の未実装・値違い・はんだ不良。ロジック電源立ち上がり時の IC1 入力 |
| マーカ 1 より前に DMODE が High | IC1 内蔵プルダウンだけでは不足（外付けプルダウンの追加を検討）。隣接ネットとの短絡 |
| マーカ 1〜2 の間に High が出る | `board_init()` の ODR 先書き（BRR）とモード設定の順序 |
| マーカ 2〜4 の間に CLK が High | PA8 を AF にしてから TIM1 を初期化するまでの間の出力（`board_init()` と `stepper_init()` の順序） |
| VREF がマーカ 3 以降も 0.25 V を超える | DAC1 の設定（バッファ・トリミング）、R34/C14 |
| CAN_S が High、または Low にならない | `board_init()` の PC15 設定（`board.c`）、PC15 の配線と TJA1441AT S(8) のプルアップ（H-8）。RTC ドメインのピンのため、測定器の負荷で電圧が下がっていないか確認する |
| LED_FAULT 点灯 | 4.4 で `first_fail_mask` を読み、2.2 のビット表で原因を特定する |

---

## 7. 試験前に決めておくこと

- **R32（VREF のプルダウン）は実装しない**（2026-10-11 確認）。マーカ 3 より前と MCU のリセット中・書き込み中は VREF が浮く。EN が R28 で Low に保たれていれば出力は出ないので、この期間の VREF は判定しない（H-2）。
- **FR-SYS-02 の「DAC 出力 0」**：DAC コード 0 でも出力は約 0.2 V（FR-DRV-05）。本手順では「DAC コード 0（DOR1 = 0）かつ VREF ≦ 0.25 V」を合格としている。
