rx178nwj/StepperMotorDriver-Node/schematic_NEMA17/review/full-audit/verification.md

# 全回路の設計レビュー — 2026-10-04

> 本文は全回路レビュー実施時のスナップショット。後続作業でSW2/SW3/TH1をMCUへ接続し、LED_FAULTをPB2へ移した。入力保護の省略と5V負荷1Aはユーザー指定の設計条件になった。最新の変更範囲と検証結果は `../inputs-self-power/verification.md` を参照。

判定：現状では「全回路が正常動作する」「回路上の問題がない」とは判断できない。通信電源、入力信号、コネクタの実装に確定した問題がある。回路図は変更していない。

対象：現在保存されている schematic.kicad_sch。122部品・98ネットをネットリストで確認。PCB、未保存のGUI状態、実機、ファームウェアは検証対象外。schematic.xml、schematic.pdf、schematic-erc.json、audit-checks.jsonに根拠を保存。

## 実施結果

- KiCad 10.0.4 ERC：エラー0、警告1。U20 NCP360の「USB Protection」シンボルライブラリが構成に未登録。
- 階層検証：問題0。
- 電源・USB・MCU支援・SWD・I2C・モータ制御・LED・ADCの63ネット、223接続を独立に照合：不一致0。
- TB67S249のNC7ピン、TMUX1511の未使用出力/NC、AP2112のNCが他の端子につながっていないことを確認。
- 上記照合は定義した接続の確認であり、機能上の不足や部品選定の合格を意味しない。

## 確定した問題・不足

| 優先度 | 箇所 | 実接続・問題 | 必要な対応 |
|---|---|---|---|
| 高 | U2 / +5V_com | U2.10 VDD(B)のネットはC11、J1.1、J3.1、R13.1、R16.1のみ。U6出力+5Vと接続されていない。外部から供給しなければ差動I2C側は無給電。 | +5Vから給電するか、外部給電方式と逆給電防止を明確に設計する。現文書はJ1/J3を電源出力と定義しており矛盾。 |
| 高 | J1/J3 | 6ピンシンボルに5ピンのJST_PH_B5B-PH-Kフットプリントを割当。MCPで実パッド1〜5のみと確認。6番GNDを実装できない。 | 6ピン実部品に合わせてフットプリントを修正。 |
| 高 | SW2/SW3/TH1 | SWITCH1、SWITCH2、TEMPにはMCUも外部信号端子もない。 | GPIO/ADCの空きピンと競合を確認して接続。温度計測用TH1のR25、B定数、温度範囲も指定。 |
| 高 | J6→VM入力 | J6.1からVMへ直結。文書にあるF1/Q1/D6/D7/R38は現在の部品一覧に存在しない。 | 逆接・短絡・過渡・回生の保護が外部装置で保証されるかを確定し、必要な入力保護を設計。U20はUSB専用でVMを保護しない。 |
| 高 | L2 | 値4.7µH、3.5A以上、資料XAL60xxだが、フットプリントはLibrary:DFE322520FD1R0MP2。資料と実装形状が一致しない。 | 実際に採用する4.7µH部品の型番、Isat、Irms、DCRとランドを一致させる。文字列上の電流指定だけでは保証不可。 |
| 中 | R36 / D4 | 3.3kΩでVMの電源LEDを駆動。24V・LED Vf=2Vなら抵抗損失0.147W、12Vなら0.030W。0603指定のみで定格未確定。 | 24V、入力許容差、温度ディレーティングを含め定格選定。0.1W品では不足。 |
| 中 | 部品割当 | C1/C2/C6〜C9に抵抗フットプリント、R31/R32にLEDフットプリントが指定されている。 | 同サイズでも推奨ランド・実装属性を実部品と照合し、適切な抵抗/コンデンサフットプリントに整理。 |
| 中 | U20/ERC | U20の全ピンがinput定義。IN/GNDは電源、OUTは出力、FLAGはオープンドレインに相当するためERCでの検出能力が低下。MCU GPIOもpassive定義。 | 正しい電気的ピン種別とライブラリ登録に修正した上でERCを再実行。 |

## ブロックごとの確認

| ブロック | 確認内容・判定 |
|---|---|
| AP63205 5V降圧 | VIN/EN=VM、FB=+5V_EXT、BST-SW間100nF、L2=4.7µHのネット接続は整合。12〜24Vは推奨範囲内。ただしVM保護とL2実部品の選定が未解決。C23=10µF/50V、C27/C28=22µF/16Vの実効容量はDCバイアスを含め確認が必要。C23は現状0805で、設計文書の1210記述とも異なる。 |
| TPS2116電源切替 | VIN1=+5V_EXT、VIN2=保護後USB_VBUS、MODE=VIN1、PR1分圧=100k/30.1k、ST=PC14。公称切替4.322V。内部基準0.92〜1.08Vにより抵抗公差を除いて約3.976〜4.668Vとなる。切替時の電圧降下は負荷と容量で実測する。 |
| AP2112 3.3V | ピン1 VIN、2 GND、3 EN、5 VOUT、4 NCと入出力1µFは整合。5→3.3V、100mAなら0.17W、600mAなら1.02W。600mAを使用可能連続電流として扱わず、実基板の放熱で決定する。 |
| MCU | VBAT/VDD/VDDUSB=3.3V、VSS/EP=GND、VDDAはフェライト経由、VSSA=GNDA。NRST、BOOT0、SWD/SWO接続を確認。PH0/PH1未使用のため内部クロックを使用する前提。USB用HSI48/CRS、GPIO初期化、ADC/DAC設定はファームウェアで確認が必要。 |
| TB67S249 | 制御信号のMCUピン、VMA/VMB、各相出力の同名ピン、VCC、OSCM、AGCストラップ、NCが整合。VCCはMCU電源に使っていない。ENABLEはR25でGNDへプルダウン。R29=10k/R30=9.1kからVREF公称最大1.572V、電流閾値約1.965A/相。公差、DAC誤差、ICゲイン誤差を含む保証上限ではない。 |
| USB | D+/D−の表裏端子、USBLC6、PA12/PA11、CC1/CC2の5.1kΩ、NCP360のTSOP5ピン配置は整合。EN=GNDで有効、FLAGは未使用。IN/OUTの1µFを確認。NCP360の600mAは絶対最大、通常500mA条件の部品でありTPS2116の2.5A定格でUSB経路を評価してはいけない。NCP360の完全な注文型番とOVLOしきい値を確定する。 |
| PCA9615 / I2C | PB10/11→SCL/SDA、4.7kプルアップ、ENプルアップは整合。差動端子のP/MとJ1/J3接続も整合。VDD(B)無給電とJ1/J3ランド不足は修正必須。終端R13〜R18は値が600/DNP、120/DNPで、実装状態を明確化する。バス両端だけに適切な終端を置く。 |
| J5センサI2C | 1=3.3V、2=GND、3=SCL(PB6)、4=SDA(PB7)、4.7kプルアップで整合。外付けセンサの給電・追加プルアップ・ケーブル容量は別途確認。 |
| VM測定 | 180k/10k分圧→U8 S1/D1→4.7k→PA0と100nF、RSV16ピンの電源/SELは整合。24Vで1.263V、時定数約1.417ms。U8未給電時の信号保護3.6V内だが、VM自体の過電圧耐性を保証する回路ではない。 |
| LED | RUN/FAULT/MCU/COMMはGPIO→1k→LED→GNDで整合。点滅/点灯はファームウェアで実現。電源LEDはR36の電力定格を要確認。 |
| J11 | 3.3V/GND/PA15/PA1/PA7につながっている。外部信号の電圧・出力方式が不明のため、5V直結や未給電時の注入電流は保証できない。 |
| GND | GNDPWR-GNDはNT1、GND-GNDAはNT2で分離。回路図上の接続は確認済み。0.5mmパッドのnet-tieを含む大電流リターンの形状、実際の一点接続、放熱、EMIはPCBで要検証。 |

## 定格・システム上の未確認事項

- AP63205は推奨入力上限32V、VIN絶対最大35V DC/40V 400ms、EN絶対最大35V。回生・抜き差し・電源配線の過渡をこの限界内に制限する必要がある。現在TVS/クランプは存在しない。以前のSMCJ26Aを単に戻しても最大クランプ42.1Vでは解決しない。
- J4のJST XHはAWG22で3A定格。現状の公称約1.97A設定には数値上の余裕があるが、5A級/4.5A用途には適合しない。J4/J7は同じ出力の並列コネクタであり独立した2モータ駆動ではない。
- モータ実型番、巻線電流、加減速、慣性、回生エネルギー、電源の吸収能力が未指定。220µFだけで回生保護を保証できない。
- USB側の許容消費電流、外部センサ・通信回路・J1/J3負荷を合計する。列挙前の電流、突入、サスペンド、USBからの切替波形は未測定。
- 抵抗・コンデンサ・LED・NTC等の実注文型番、温度範囲、公差、DCバイアス特性が未確定のため全定格の合格は出せない。
- 設計文書12章は現在の入力保護・通信電源・一部フットプリントと不一致があり、検証後の設計に同期させる必要がある。

## 一次資料

- [PCA9615](https://www.nxp.com/docs/en/data-sheet/PCA9615.pdf)：VDD(B)=3.0〜5.5V、差動終端条件。
- [AP63205](https://www.diodes.com/datasheet/download/AP63200-AP63201-AP63203-AP63205.pdf)：入力・EN限界、降圧回路。
- [TPS2116](https://www.ti.com/lit/ds/symlink/tps2116.pdf)：ピン配置、優先切替、PR1基準1V±8%。
- [AP2112](https://www.diodes.com/datasheet/download/AP2112.pdf)：LDO定格と放熱。
- [TMUX1511](https://www.ti.com/lit/ds/symlink/tmux1511.pdf)：RSVピン配置、電源OFF時3.6V保護。
- [NCP360](https://www.onsemi.com/download/data-sheet/pdf/ncp360-d.pdf)：TSOP5配線、容量、電流、OVLO。
- [STM32L433xx](https://www.st.com/resource/en/datasheet/stm32l433cb.pdf)：UFQFPN48、MCU電源/周辺機能。検索で資料を確認したがPDF本文取得が不安定だったため全電気特性の再確認は未完了。
- [TB67S249FTG](https://toshiba.semicon-storage.com/info/TB67S249FTG_datasheet_en_20260508.pdf?did=58560&prodName=TB67S249FTG)：電流閾値VREF×1.25、動作条件。
- [JST XH](https://www.jst.com/wp-content/uploads/2021/01/eXH-new.pdf)：AWG22で3A。
- [Coilcraft XAL60xx](https://www.coilcraft.com/getmedia/ea51f14b-7f32-4dc6-8dfe-d4b70549040f/xal60xx.pdf)：L2の設計資料。現フットプリントとの不一致を確認。

確定した問題を修正した後、接続照合とERCを再実行し、PCB検証と実機の起動・負荷・熱・回生・USB切替・通信試験が必要。
