rx178nwj/StepperMotorDriver-Node/schematic_NEMA17/review/inputs-self-power/verification.md

# スイッチ・温度入力接続と設計条件の更新（2026-10-04）

## 回路図へ反映した接続

| 信号 | MCU端子 | 周辺回路 | FW設定 |
|---|---|---|---|
| SWITCH1 / SW2 | IC4 pin40 PB4 | R4 10kで3.3Vプルアップ、C7、押下でGND | GPIO入力、内部プルなし、Low=押下。PB4をNJTRSTからGPIOへ設定。 |
| SWITCH2 / SW3 | IC4 pin41 PB5 | R5 10kで3.3Vプルアップ、C8、押下でGND | GPIO入力、内部プルなし、Low=押下。 |
| TEMP / TH1 | IC4 pin16 PA6 / ADC1_IN11 | R7 4.7kで3.3Vプルアップ、TH1でGND、C9 100nF | アナログ入力、内部プルなし、ADC校正と十分な取得時間。 |
| LED_FAULT | IC4 pin20 PB2 | 既設R34 1k→D2→GND | プッシュプル出力、High=点灯。旧PA6割当から変更。 |

ADC可能ピンはすべて既存用途で使用されていたため、外部アナログ入力PA7を維持し、LED_FAULTをPB2へ移してPA6を温度測定に使用した。温度算出にはTH1のR25/B値または抵抗温度テーブルが必要。TH1がNTCなら温度上昇でTEMP電圧は下がる。現状は分圧上側がVDD、ADC基準がVDDAのため、VDD/VDDAの差も測定誤差に含む。

対象16接続の一致を確認。他の412ピンのネット所属を維持し、不意のネット統合/分割なし。階層問題0。ERCは前後ともエラー0/警告1、新規違反0。警告はU20のUSB Protectionライブラリ未登録。before/afterのXML、after PDF、ERC、connection-check.jsonを保存。

## PCA9615給電の推奨（今回は未変更）

基板に12〜24Vからの降圧とUSB給電経路があるため、VDD(B)はU6の切替後+5Vから自己給電する方式を推奨。VDD(A)は既設3.3Vを維持。通信ケーブルで5Vを供給しないため、電源同士の競合・電源線の電圧降下・マスター給電電流の制約を避けられる。マスター給電はローカル電源なしで通信部を常時動作させたい場合には有効だが、MCUは別途給電が必要。

5ピンへの変更案は1=SDA+、2=SDA−、3=SCL+、4=SCL−、5=GND。差動2ペアと共通GNDを残す。両端基板の5Vレールは接続しない。PCA9615は絶縁素子ではなく、GND電位差とケーブル/終端の条件を守る。終端抵抗は実装方針を確定し、バスの両端に配置する。

ユーザーがコネクタの電源をなくして5ピンへ変更する旨を述べているため、今回の変更は明示的に依頼されたSW2/SW3/TH1のMCU接続と、そのためのLED再割当までとした。U2の+5V_com給電とJ1/J3はまだ変更していない。

根拠：[NXP PCA9615](https://www.nxp.com/docs/en/data-sheet/PCA9615.pdf)。VDD(B)=3.0〜5.5V。5Vの自己給電が可能。

## 更新された設計条件

- ヒューズ・逆接保護・TVSは基板スペースの都合で省略する。これらの追加は行っていない。J6.1=VM直結が現在の意図した仕様。基板内にその保護機能はなく、外部電源系の保護条件を別途満たす必要がある。
- 5V電源負荷は1Aを前提にL2を小型化する。2A供給を保証する設計として評価しない。4.7µH、1.1MHz、24→5V、1A時の理想連続電流モード計算ではリプル約0.766App、ピーク約1.383A、Irms約1.024A。インダクタのIsatを1Aにしてよいという意味ではない。最小インダクタンス、公差、温度、起動・過負荷・IC電流制限を含め実型番を確認する。
- 実インダクタの完全な型番が未指定のため、現在のフットプリントと容量/電流定格の最終適合は未判定。
- [ST提供のSTM32L433ピンマップ](https://github.com/stm32duino/Arduino_Core_STM32/blob/main/variants/STM32L4xx/L433C%28B-C%29%28T-U%29_L443CC%28T-U%29/PeripheralPins.c)でPA6=ADC1_IN11を確認。PB2にはこのADC入力機能がないためLED側を移動した。
