rx178nwj/StepperMotorDriver-Node/schematic_NEMA23/review/can-pcb/verification.md

# 検証記録：CAN 化後の PCB

## 再確認（2026-10-17 13:34 保存分）

| 項目 | 結果 |
|---|---|
| ERC | **4 件（警告のみ）**。前回のエラー 2 件（#PWR01、#FLG03/#FLG06）は解消 |
| DRC | 99 件、未配線 0 件。C41 のシルク重なり 2 件は解消 |
| IC1 下の GNDPWR サーマルビア | **25 個**（x 125〜129.5、y 109〜113.5 の格子）。総数は 35 個 |
| IC1・IC2 フットプリントの DNP 属性 | **未解消**（`(attr smd dnp)` のまま） |
| /DRV_AGC1 の宙に浮いたビア | **未解消**。In1.Cu の枝 (131.0,86.5)→(131.675,87.175)→(137.335,87.175)→(138.8,85.71) も残っている。AGC0 側の F.Cu の微小な残骸 (136.8,85.8)-(136.8,85.71) も残っている（実害なし） |
| ネットクラス | **未更新**。PCA9615_DIFF クラスと /DI2C_*、/I2C_PC_* のパターンが残り、CAN 系 5 本はどのクラスにも割り当てられていない（Default） |
| C5 / C10 | 回路図・PCB ともに無し（ユーザーが削除） |
| R49 | 0603（回路図と PCB で一致） |
| SW2 | `Package_SO:SOIC-8_5.3x6.2mm_P1.27mm` に変更（回路図と PCB で一致）。KHS42E の外形図との照合はまだ |
| R32 | 値は「/DNP」、DNP 属性は無し |

**13:48 保存分の追加確認**
- ユーザーが /DRV_AGC1 のビア (138.8, 85.71) と In1.Cu の枝を削除し、AGC1 を引き直した。
  - 新しい経路：IC2 pin22 → (131.0, 86.5) のビア → B.Cu → (116.54, 94.7) のビア → In1.Cu → (118.8, 96.7) のビア → In2.Cu → (120.15, 105.85) のビア → F.Cu → IC1 pin2
- DRC は **93 件、未配線 0 件**。via_dangling は無くなった。
- 新しい警告は 2 件で、MOTVREF_TP2 のリファレンス文字が SW2 のシルクに重なっている（外観のみ）。
- MCP での変更は行っていない（`remove_traces` はビアを消せないため。ユーザーの修正で不要になった）。

## D7・SW2 のデータシート照合（2026-10-17）

### D7 PEC3824C2A-AU：問題なし

- データシートの 1 ページ目のピン図（PEC3808C2A-AU_SERIES REV.00S）を確認した。
  - 1 番・2 番 = ライン（それぞれ双方向 TVS で 3 番につながる）
  - 3 番 = 共通端子
- 回路図と PCB は 1 = CANH、2 = CANL、3 = GND で、一致している。
- フットプリントは標準の SOT-23（1 = 左下、2 = 右下、3 = 上）で、データシートの外形と同じ。

### SW2 KHS42E：電気的には問題なし。フットプリントの寸法は推奨と違う

- 参照した資料：OTAX「Slide KHS Series」（KHS_dip_eng.pdf）。ガルウィング端子、リール梱包（末尾 E）、テープシール付き。

**接点の対応**
- 各スイッチの 2 端子は、本体を挟んだ向かい側にある。
- SOIC の番号では 1↔8、2↔7、3↔6、4↔5 が対になり、シンボル SW_DIP_x04 と一致する。

**定格**：DC24V・25mA（公式値で確認）。CAN の終端電流 12.5〜25mA は上限に近い。バスが動いていないときに切り替える運用は変えない。

| 項目 | OTAX 推奨ランド | 今のフットプリント（SOIC-8_5.3x6.2mm） |
|---|---|---|
| ピッチ | 1.27 mm | 1.27 mm ✓ |
| パッドの大きさ | 0.76 × 1.27 mm | 0.6 × 1.9 mm |
| 左右の列の中心間 | 7.62 mm | 7.0 mm |
| 外側の端どうし | 8.89 mm | 8.9 mm ✓ |
| 内側の端どうし | 6.35 mm | 5.1 mm（本体の下へ片側 0.6 mm ずつ入り込む） |
| 本体（幅 × 長さ） | 6.0 × 6.21 mm（端子の先まで 8.12 mm） | コートヤードは 5.3 mm 幅の SOIC 基準 |

**判断**
- 端子の足（本体の端 6.0 mm から先端 8.12 mm まで）はパッドに収まるので、はんだ付けはできる。
- ただし推奨のランドより内側へ長い。そのため、はんだが本体の下に回り込んだり、セルフアライメントが崩れたりするおそれがある。
- コートヤードも本体（6.0 mm 幅）より小さい。
- OTAX の推奨ランドどおり専用のフットプリントを作ることを推奨する：0.76×1.27 mm のパッド 8 個、1.27 mm ピッチ、列の中心間 7.62 mm、コートヤードは本体 6.21×8.12 mm に余裕を足した大きさ。
- 基板には「ON」側の向きと、1〜3 = ID、4 = TERM のシルクを入れる。テープシールは洗浄後にはがす。

**訂正**：初回の記録の「サーマルビアが 59 個から 35 個に減った」「範囲内は 0 個」は、解析スクリプトの読み取りの誤りによるものだった。今回の集計では IC1 の下に 25 個あり、総数（35 個）も変わっていないので、初回の時点でも同じ配置だったと考えられる。「作業前は 59 個」という数字は確認できていない。初回の記録の 1 番目の項目は取り消す。

---

## 初回の確認（参考、1 番目の項目は上記の訂正で取り消し）

実施：2026-10-17。

- 対象：保存済みの `schematic.kicad_pcb`。確認時は KiCad が開いていたため、保存していない変更は含まない。
- DRC レポート：同じフォルダの `schematic-drc.json`。
- 比較の基準：CAN 作業前のバックアップ `schematic-backups/schematic-2026-10-17_110904.zip`。

## 結果の要約

| 項目 | 結果 |
|---|---|
| 未配線 | **0 件** |
| DRC 違反 | 101 件（作業前の記録は 114 件）。CAN 回路で新しく出たエラーは 0 件 |
| 部品・パッドのネット | 回路図どおり（IC2 pin21/22 = AGC0/1、pin45/46 = CAN_RX/TX。IC3、D7、SW2、R49、C41、C42、J1、J2 も一致） |
| 旧部品・旧ネットの銅箔 | U1、R2〜R19、SW1 と I2C_PC/DI2C/PCA9615_EN のトラック・ビア・ゾーンは残っていない |

調査用のスクリプトが、IC2 の pin 入れ替わり、C41 の +5V/GND ショート、IC3 の VIO 未接続を報告した。しかし MCP でパッド座標を直接確認したところ、いずれも回転の扱いを誤ったことによる誤検出だった。DRC でも短絡・未配線は出ていない。

## 新規部品の配置（すべて F.Cu。J1/J2 だけ B.Cu）

| 部品 | 位置 | 確認内容 |
|---|---|---|
| IC3 TJA1441AT | (108.2, 92.7) 180° | — |
| C41（+5V） | (112.6, 92.5) | IC3 pin3 から約 1.7 mm |
| C42（+3V3） | (105.5, 89.3) | IC3 pin5 から約 1.6 mm。VIO は F.Cu の +3V3 ゾーンで接続 |
| D7 PEC3824C2A-AU | (102.3, 92.8) | J1 pad1 から約 2.6 mm |
| R49 終端 | (102.6, 86.8) | IC3 pin7 から約 7.5 mm |
| SW2 KHS42E | (109.1, 85.1) | — |
| J1 / J2 | (99.9, 91.0) / (100.0, 97.05) | B.Cu |

## 対応が必要な項目（重要度順）

1. **IC1 下の GNDPWR サーマルビアが 59 個から 35 個に減っている**
   - 減ったのは IC1 pad49 の下（x 125〜129.5、y 109〜113.5）の 24 個で、作業前のバックアップと比べて確認した。
   - 3A 運転での放熱に関わるので、意図した変更かどうか確認が必要。
2. **IC1・IC2 のフットプリントに DNP 属性が付いている**
   - 作業前のバックアップから付いていた（今回の変更とは無関係）。
   - 製造データ（BOM・実装座標）が DNP を見る場合、MCU とモータドライバが実装対象から外れる。
3. **/DRV_AGC1 の宙に浮いたビア**（138.8, 85.71）
   - 旧 I2C_PC_SDA の配線の残骸。In1.Cu の約 8.7 mm の枝（(131.0, 86.5) のビアから）とあわせて削除する。
   - AGC0 側にも F.Cu の微小な残骸（136.8, 85.8–85.71）がある。
4. **ネットクラス設定が未更新**（`schematic.kicad_pro`）
   - PCA9615_DIFF（/DI2C_*）と DIGITAL の /I2C_PC_* がパターンとして残っている。
   - CAN 系のネットは Default 扱いになっている。
   - 作業計画 6-3-1 に従い、CAN_DIFF（/CANH、/CANL）の追加と旧パターンの削除が必要。
5. **回路図から C5（+3V3 0.1 µF）と C10（+5V 0.1 µF）が消えている**
   - 回路図の変更後に削除されたもの。
   - +3V3・+5V には他のコンデンサがあるので致命的ではないが、意図した削除か確認する。

## 判断・確認事項

- **R49 のフットプリント**：回路図と PCB では 0603。作業計画では 1206。通常時の損失は約 33 mW なので 0603 でも足りる。1206 にしていたのは短絡故障時を考えたため。どちらにするか決める。
- **SW2 のフットプリント**：`SSO-8_6.8x5.9mm_P1.27mm`。パッドは 1.9×0.6 mm、列の間隔は 7.0 mm。KHS42E の外形図と照合が必要。
- **D7 のピン配置**：1 = CANH、2 = CANL、3 = GND で配線済み。データシートのピン図との照合はまだ。
- **R32**：値は「/DNP」になっているが、DNP 属性は付いていない。

## 参考（問題なし、または既存）

- **CAN の配線**
  - CANH は 18.6 mm（ビア 1 個、In2 経由）、CANL は 28.1 mm で、長さの差は約 9.5 mm。
  - 500 kbit/s（1 ビット 2 µs）では影響はない。
  - 線幅は 0.8〜1.0 mm で、計画の 0.15 mm より太い。電気的な問題はない。
- **In1.Cu に GND ゾーンがない**
  - GND 面は In2.Cu/B.Cu にある。CANH の In2 経由の部分が GND 面を少し切っている。
  - CAN のクラシック 500 kbit/s では実害は小さい。
- **電力系からの距離**：CAN 配線と VM・GNDPWR の距離は最短で約 9.6 mm。BUCK_SW やモータ出力はそれより遠い。
- **作業前からある DRC 違反**
  - J6（USB-C）：穴のクリアランス 4 件、ソルダーマスクブリッジ 11 件
  - In1.Cu の /VM ゾーンの重なり：2 件（形状はバックアップと同じ）
  - J4/J7 の基板端クリアランス：6 件
  - そのほか、シルク・孤立銅箔・フットプリントのライブラリ不一致の警告
- **CAN 化で新しく出た警告（外観のみ）**
  - C41・C42 のリファレンス文字が SW2・R23 のシルクやパッドに重なっている
  - B.Silkscreen の「CAN」の文字が J11 のシルクに重なっている
