rx178nwj/StepperMotorDriver-Node/schematic_NEMA23/review/dip-address/verification.md

# 3bit DIPアドレス選択 — 2026-10-04

JP1を削除して3極DIPスイッチSW4（Switch:SW_DIP_x03）へ置き換えた。各スイッチを3.3Vへ接続し、既設R58に加えてR59/R60=10kΩのプルダウンを追加。OFF=0、ON=1。

| DIP位置 | 端子ペア | 入力 | MCU | プルダウン |
|---|---|---|---|---|
| 1 | SW4.1–SW4.6 | ADDR0（LSB） | PH0 / IC4 pin5 | R59 10kΩ |
| 2 | SW4.2–SW4.5 | ADDR1 | PH1 / IC4 pin6 | R60 10kΩ |
| 3 | SW4.3–SW4.4 | ADDR2（MSB） | PC13 / IC4 pin2 | R58 10kΩ |

SW4.4/.5/.6=+3V3。プルダウンの下側はGND。全ON時の抵抗電流は約0.99mA。PH0/PH1は既存回路でNCだった端子で、HSEをOFFにしてGPIO入力に使用する。外部発振器を追加する場合はアドレスピン割当を見直す。PC13もGPIO入力、全ピン内部プルなし。SWD/SWO、LED、モータ制御、USB、既設SW2/SW3、温度ADC、外部AD_INは維持。

2026-10-04 ユーザー指定で秋月電子のOTAX KSD32（販売コード109992）へ変更。フットプリントは `Button_Switch_THT:SW_DIP_SPSTx03_Slide_9.78x9.8mm_W7.62mm_P2.54mm`。6パッド、1–6/2–5/3–4の対向配置を維持。メーカー取付孔寸法と照合済みで、標準フットプリントの外形は実部品より保守的に広い。詳細は `../ksd32/verification.md`。PCBへの配置・反映は本作業の対象外。

## 設定

| ADDR2 | ADDR1 | ADDR0 | ノードID |
|---|---|---|---|
| OFF | OFF | OFF | 0 |
| OFF | OFF | ON | 1 |
| OFF | ON | OFF | 2 |
| OFF | ON | ON | 3 |
| ON | OFF | OFF | 4 |
| ON | OFF | ON | 5 |
| ON | ON | OFF | 6 |
| ON | ON | ON | 7 |

起動時に安定した入力を読み、`ID = ADDR0 | (ADDR1 << 1) | (ADDR2 << 2)` を生成する。7bitアドレスは、他デバイスや予約領域と重複しないBASEを選び、`address7 = BASE + ID` にする。BASEはユーザー仕様にないため未確定。ID=0をI2Cアドレス0（General Call）として使用しない。設定変更は電源OFF時に行い、再起動後に反映する。実装対象のファームウェアが本ディレクトリにないため、コードの変更は未実施。

## 最大8台の接続

`マスター ─ 基板ID0 ─ 基板ID1 ─ … ─ 基板ID7`

各基板に異なるIDを設定する。J1/J3の各差動信号は同じネットへ並列接続されており、通信経路は一本の差動バスを数珠つなぎにする。電気的に各ICを直列挿入するものではない。マスターも同じバス上の一ノードになる。

- 2本のツイストペアでSDA+/SDA−、SCL+/SCL−を配線し、共通GNDも接続する。
- 終端・バイアスのR13〜R18は物理的なバス両端の2箇所だけに実装。マスターが一方の端なら、マスターと最後のモータ基板が終端を持つ。途中の基板はR13〜R18を未実装。
- 現状の自己給電構成（U2 VDD(B)=切替後+5V）を維持し、通信コネクタで各5V電源を接続しない。
- 8通りのアドレスを選択できる回路を実装したが、8台の実機通信を保証する検証ではない。ケーブル長、分岐長、通信速度、GND電位差、電源状態を含め実機で確認する。

根拠：[NXP PCA9615](https://www.nxp.com/docs/en/data-sheet/PCA9615.pdf)はマルチポイント差動バス対応で、両端終端と短いスタブを要求する。

## 検証

before/after XMLを照合し、アドレス3ネットの9接続、3.3V/GND、プルダウン値、JP1削除、既存の他ネットの保持を確認。結果はafter/connection-check.json。階層問題0。ERC前後ともエラー0/既存警告1、新規違反0。警告はU20のUSB Protectionシンボルライブラリ未登録。
