rx178nwj/StepperMotorDriver-Node/schematic_NEMA17/validation_as5600/as5600_preview.png

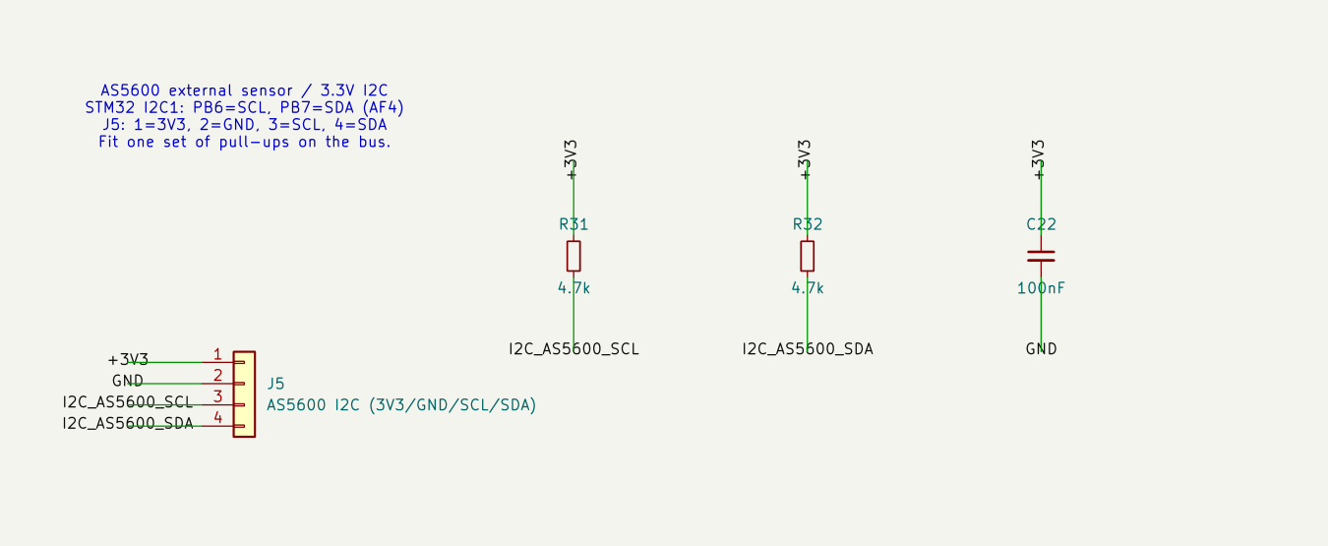
schematic_NEMA17/validation_as5600/as5600_preview.png
