rx178nwj/StepperMotorDriver-Node/schematic_NEMA23/validation_as5600/mcu_preview.png

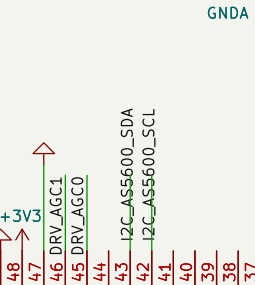
schematic_NEMA23/validation_as5600/mcu_preview.png
