rx178nwj/StepperMotorDriver-Node/schematic_NEMA17/validation_as5600/schematic_NEMA17.pdf

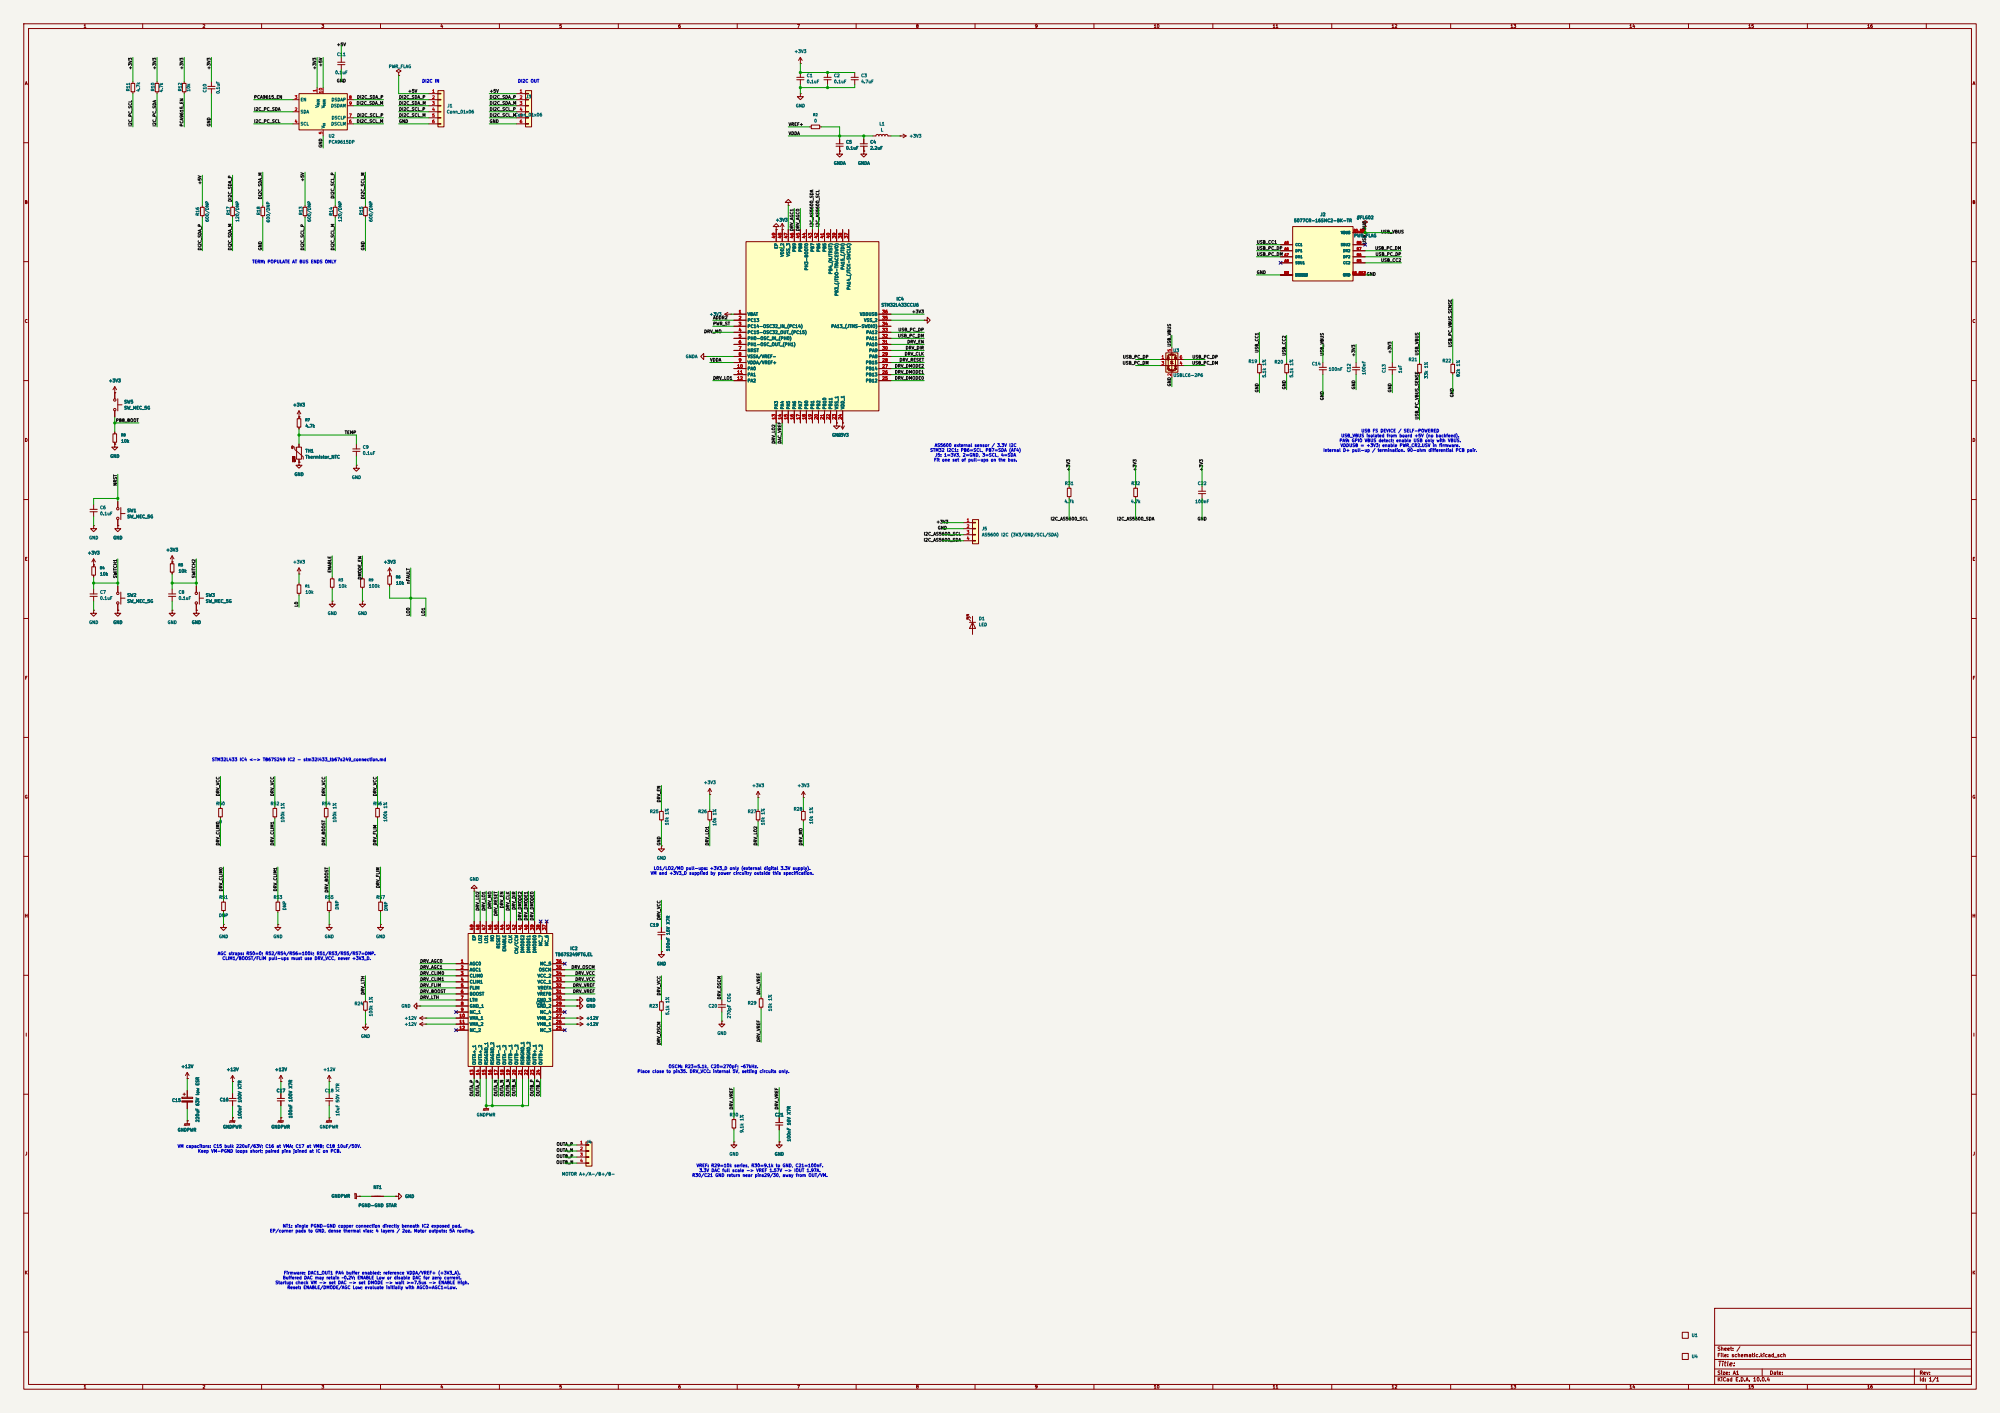
[picture p18: page 1]

VSS 5 DSCLM 6 DSCLP 7 DSDAP 8 DSDAM 9

36 PA14_(JTCK-SWCLK) 37 PA15_(JTDI) 38 PB3_(JTDO-TRACESWO) 39 PB4_(NJTRST) 40 PB5 41 PB6 42 PB7 43 PH3-BOOT0 44 PB8 45 PB9 46 VSS_3 47 VDD_2 48 EP 49

USB FS DEVICE / SELF-POWERED USB_VBUS isolated from board +5V (no backfeed). PA9: GPIO VBUS detect; enable USB only with VBUS. VDDUSB = +3V3; enable PWR_CR2.USV in firmware.

AS5600 external sensor / 3.3V I2C
STM32 I2C1: PB6=SCL, PB7=SDA (AF4) J5: 1=3V3, 2=GND, 3=SCL, 4=SDA

Internal D+ pull-up / termination. 90-ohm differential PCB pair.

Fit one set of pull-ups on the bus.

LO1/LO2/MO pull-ups: +3V3_D only (external digital 3.3V supply). VM and +3V3_D supplied by power circuitry outside this specification.

AGC straps: R50=0; R52/R54/R56=100k; R51/R53/R55/R57=DNP.
CLIM1/BOOST/FLIM pull-ups must use DRV_VCC, never +3V3_D.

EP/corner pads to GND, dense thermal vias; 4 layers / 2oz. Motor outputs: 5A routing. Firmware: DAC1_OUT1 PA4 buffer enabled; reference VDDA/VREF+ (+3V3_A). Buffered DAC may retain ~0.2V: ENABLE Low or disable DAC for zero current. Startup: check VM -> set DAC -> set DMODE -> wait >=7.5us -> ENABLE High. Reset: ENABLE/DMODE/AGC Low; evaluate initially with AGC0=AGC1=Low. VM capacitors: C15 bulk 220uF/63V; C16 at VMA; C17 at VMB; C18 10uF/50V.

Keep VM-PGND loops short; paired pins joined at IC on PCB.

VREF: R29=10k series, R30=9.1k to GND, C21=100nF. 3.3V DAC full scale -> VREF 1.57V -> IOUT 1.97A. R30/C21 GND return near pins29/30, away from OUT/VM.

NT1: single PGND-GND copper connection directly beneath IC2 exposed pad.

Size: A1 | Rev:
KiCad E.D.A. 10.0.4 | Id: 1/1
