rx178nwj/StepperMotorDriver-Node/schematic_NEMA23/review/schematic_NEMA23.pdf

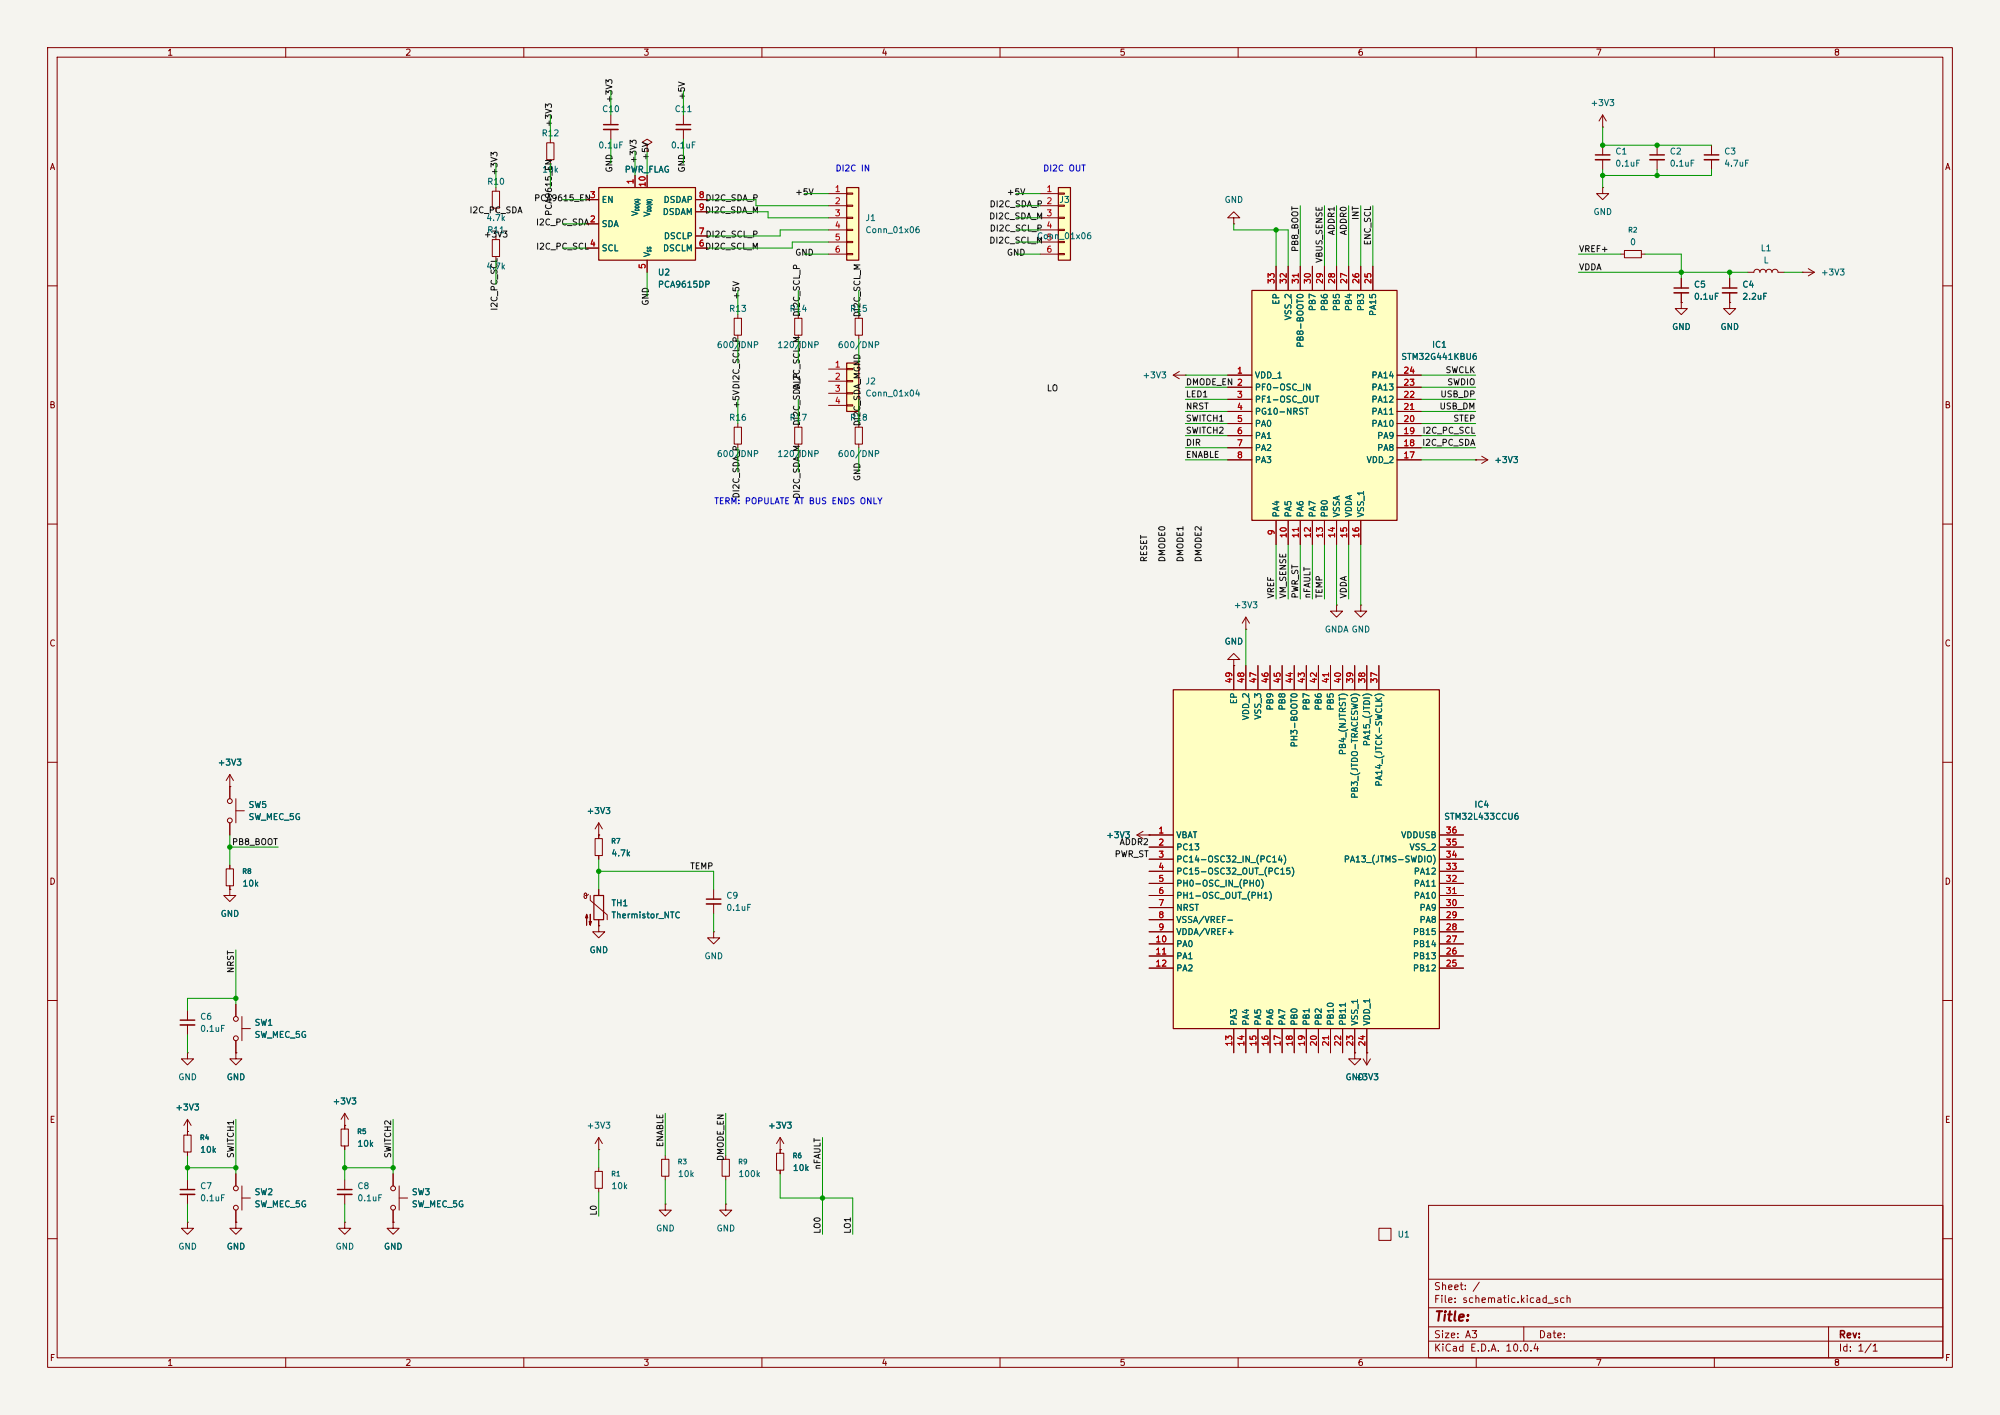
[picture p19: page 1]

Size: A3 | Rev:
KiCad E.D.A. 10.0.4 | Id: 1/1
