rx178nwj/StepperMotorDriver-Node/schematic_NEMA17/review/full-audit/schematic_NEMA17.pdf

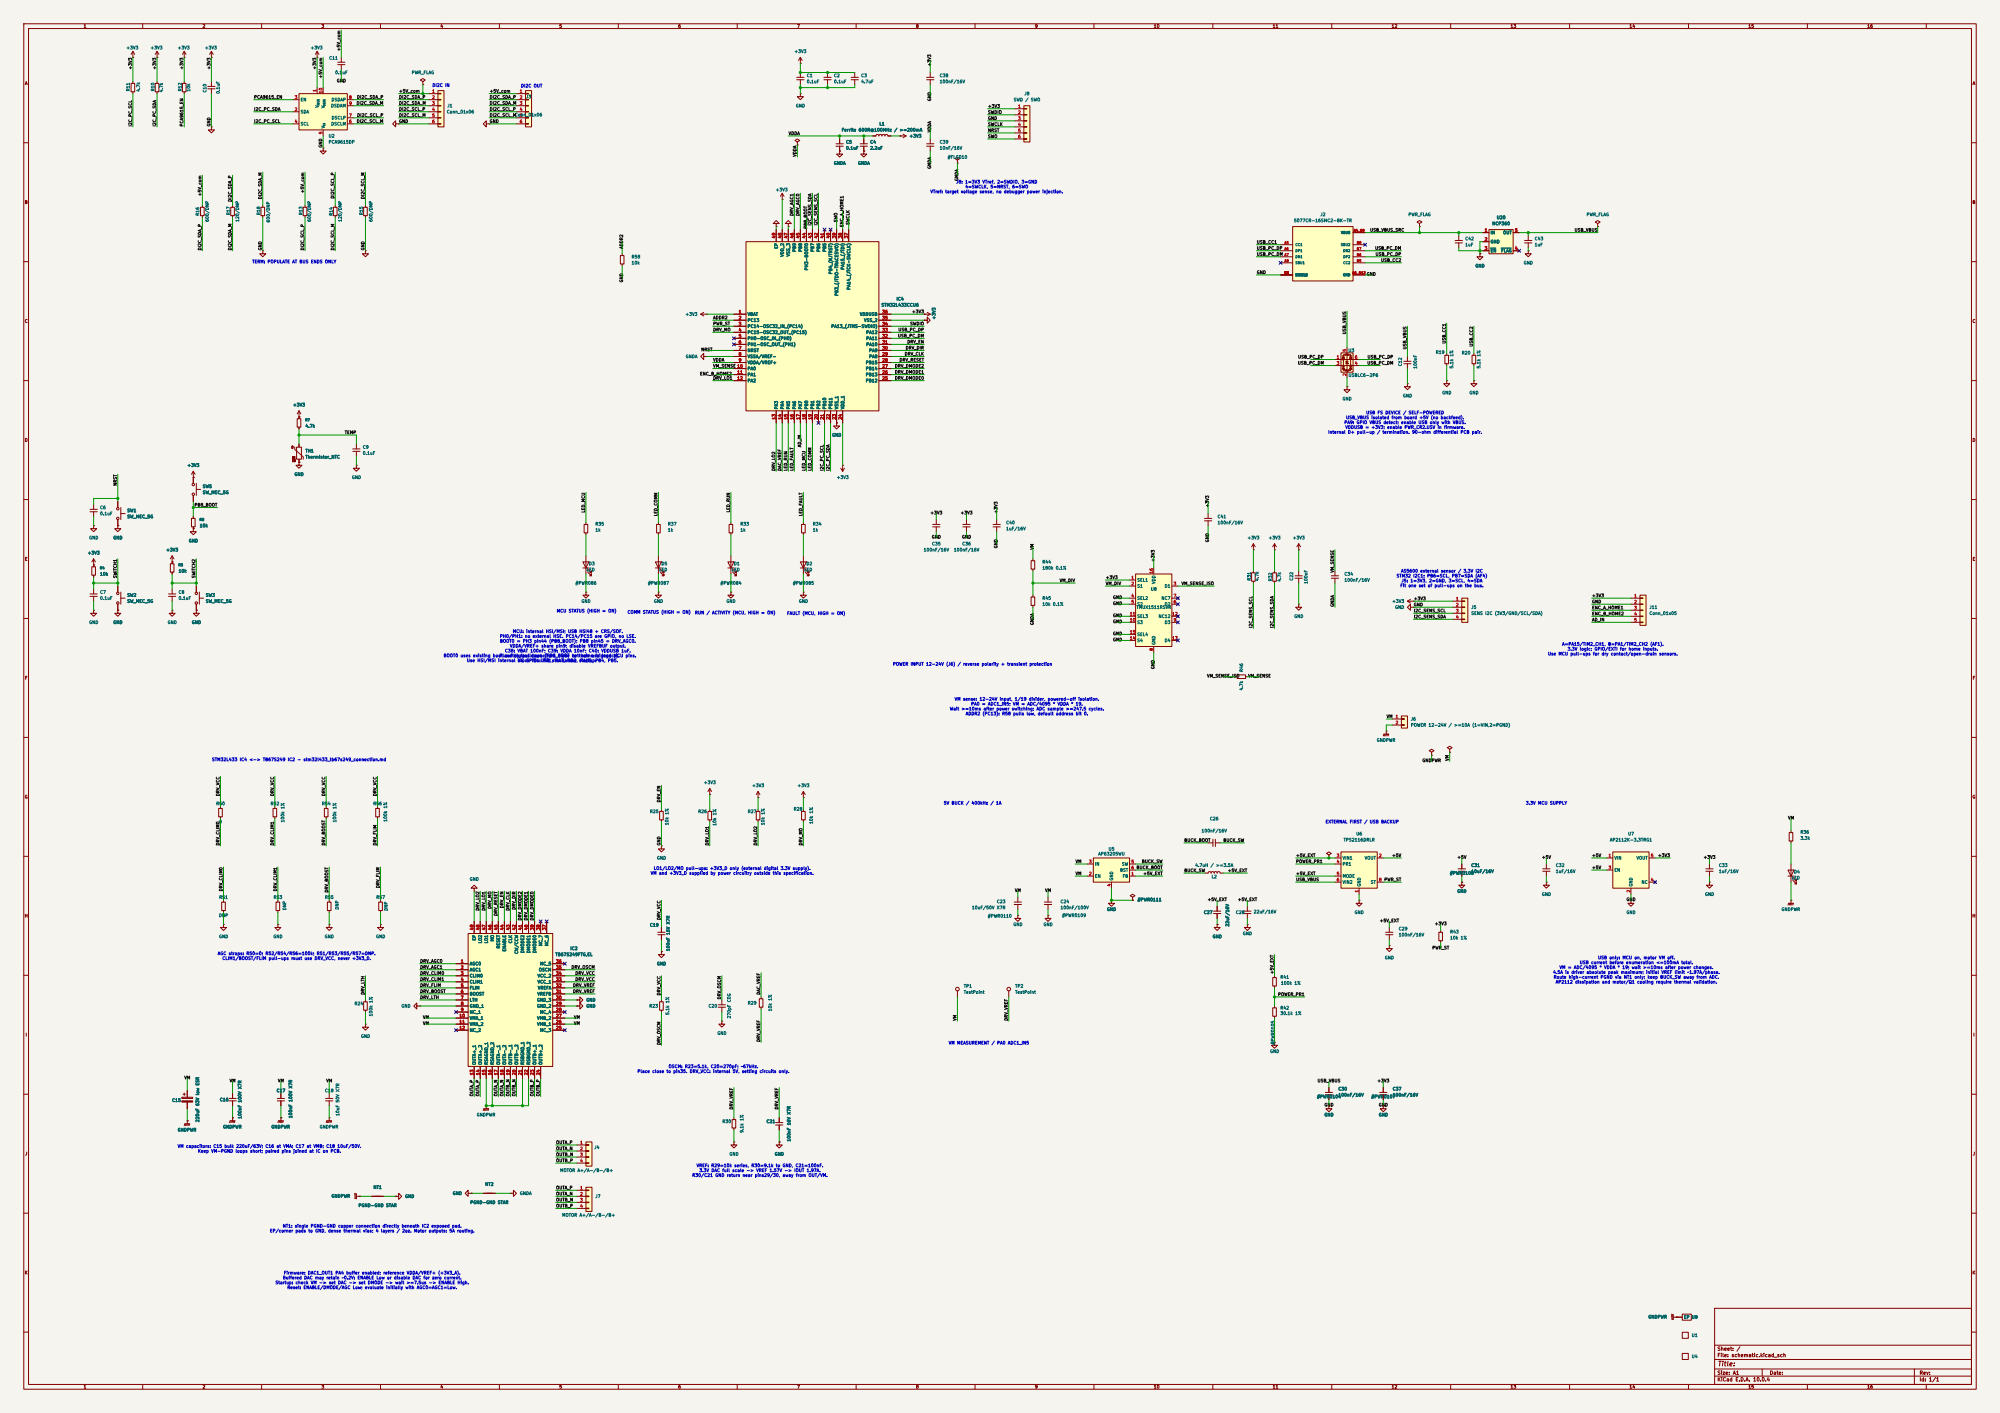
[picture p20: page 1]

VSS 5 DSCLM 6 DSCLP 7 DSDAP 8 DSDAM 9

VTref: target voltage sense, no debugger power injection.

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

TERM: POPULATE AT BUS ENDS ONLY

Internal D+ pull-up / termination. 90-ohm differential PCB pair.

SENS I2C (3V3/GND/SCL/SDA) C31

AS5600 external sensor / 3.3V I2C
STM32 I2C1: PB6=SCL, PB7=SDA (AF4) J5: 1=3V3, 2=GND, 3=SCL, 4=SDA
J11 Conn_01x05 C32

Fit one set of pull-ups on the bus.

J6POWER 12-24V / >=10A (1=VIN,2=PGND) GNDPWR+3V3 GND

3.3V MCU SUPPLY RUN / ACTIVITY (MCU, HIGH = ON) MCU: internal HSI/MSI; USB HSI48 + CRS/SOF.

5V BUCK / 400kHz / 1A COMM STATUS (HIGH = ON)

A=PA15/TIM2_CH1, B=PA1/TIM2_CH2 (AF1). 3.3V logic; GPIO/EXTI for home inputs. Use MCU pull-ups for dry contact/open-drain sensors.

BOOT0 uses existing boot switch/pulldown (PB8_BOOT net name is legacy). Use HSI/MSI internal clock for USB standalone startup.

POWER INPUT 12-24V (J6) / reverse polarity + transient protection STM32L433 IC4 <-> TB67S249 IC2 - stm32l433_tb67s249_connection.md

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

OSCM: R23=5.1k, C20=270pF; ~67kHz. Place close to pin35. DRV_VCC: internal 5V, setting circuits only.

VM capacitors: C15 bulk 220uF/63V; C16 at VMA; C17 at VMB; C18 10uF/50V.

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

NT2 PGND-GND STAR NT1 PGND-GND STAR

Firmware: DAC1_OUT1 PA4 buffer enabled; reference VDDA/VREF+ (+3V3_A). Buffered DAC may retain ~0.2V: ENABLE Low or disable DAC for zero current. Startup: check VM -> set DAC -> set DMODE -> wait >=7.5us -> ENABLE High. Reset: ENABLE/DMODE/AGC Low; evaluate initially with AGC0=AGC1=Low. NT1: single PGND-GND copper connection directly beneath IC2 exposed pad.
EP/corner pads to GND, dense thermal vias; 4 layers / 2oz. Motor outputs: 5A routing.

Size: A1 | Rev:
KiCad E.D.A. 10.0.4 | Id: 1/1
