rx178nwj/StepperMotorDriver-Node/schematic_NEMA17/review/labels-after/schematic_NEMA17.pdf

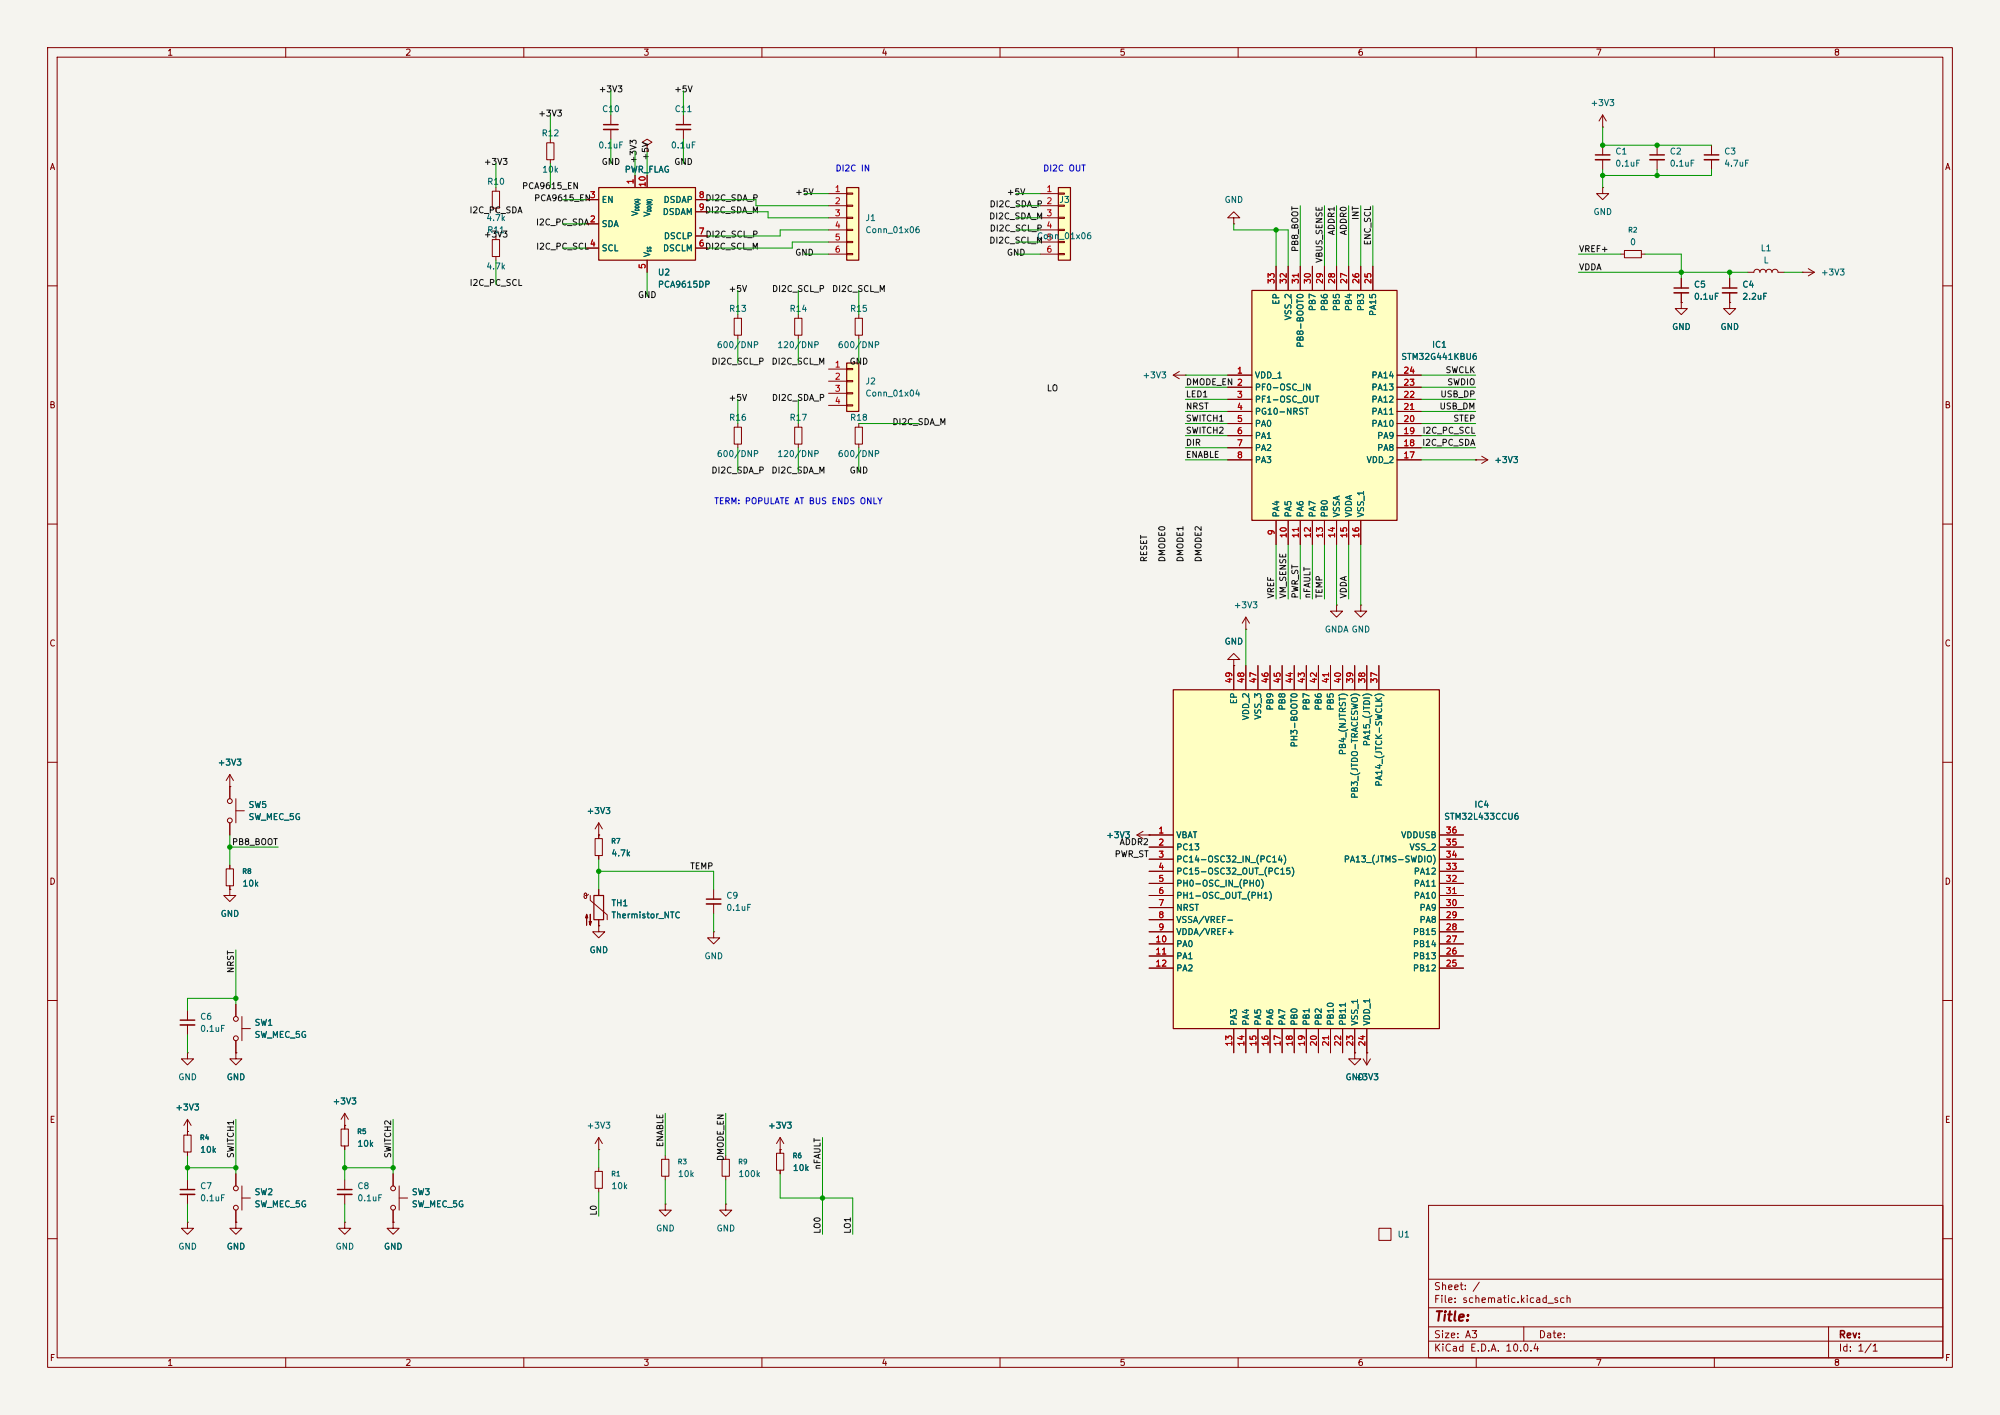
[picture p21: page 1]

VSS 5 DSCLM 6 DSCLP 7 DSDAP 8 DSDAM 9

TERM: POPULATE AT BUS ENDS ONLY +3V3

Size: A3 | Rev: | F Date:
KiCad E.D.A. 10.0.4 | Id: 1/1
