rx178nwj/StepperMotorDriver-Node/schematic_NEMA17/review/power-after/schematic_NEMA17.pdf

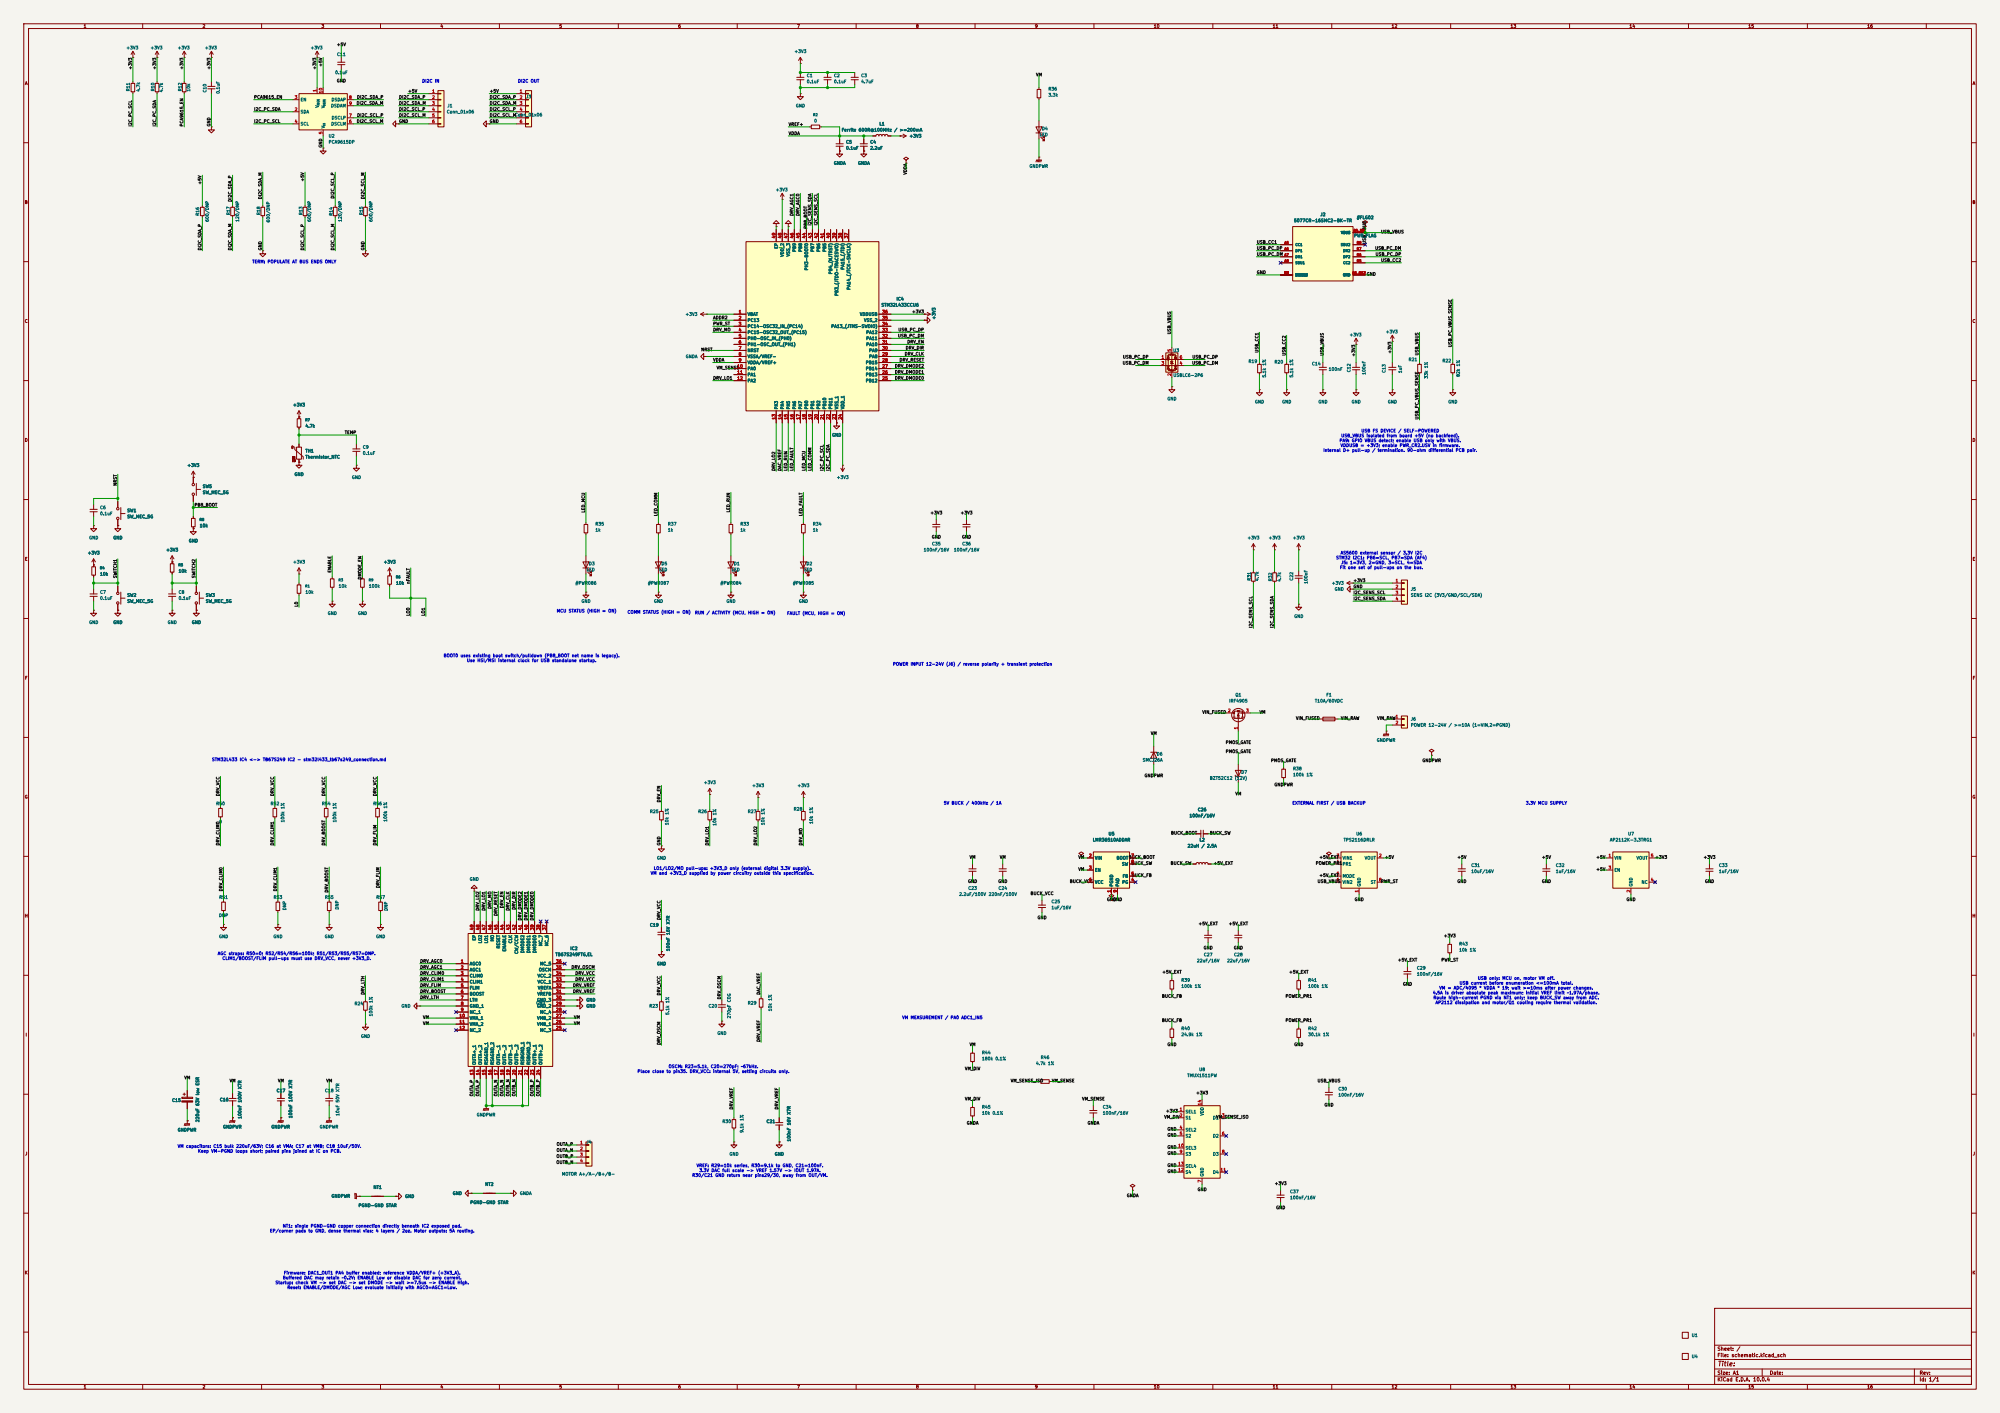
[picture p22: page 1]

VSS 5 DSCLM 6 DSCLP 7 DSDAP 8 DSDAM 9

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

TERM: POPULATE AT BUS ENDS ONLY

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

STM32 I2C1: PB6=SCL, PB7=SDA (AF4) J5: 1=3V3, 2=GND, 3=SCL, 4=SDA

SENS I2C (3V3/GND/SCL/SDA) C23

COMM STATUS (HIGH = ON)

FAULT (MCU, HIGH = ON)

EXTERNAL FIRST / USB BACKUP
TPS2116DRLR

AGC straps: R50=0; R52/R54/R56=100k; R51/R53/R55/R57=DNP.
CLIM1/BOOST/FLIM pull-ups must use DRV_VCC, never +3V3_D. NT1: single PGND-GND copper connection directly beneath IC2 exposed pad.

USB only: MCU on, motor VM off. USB current before enumeration <=100mA total. VM = ADC/4095 * VDDA * 19; wait >=10ms after power changes. 4.5A is driver absolute peak maximum; initial VREF limit ~1.97A/phase. Route high-current PGND via NT1 only; keep BUCK_SW away from ADC. AP2112 dissipation and motor/Q1 cooling require thermal validation.

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

Keep VM-PGND loops short; paired pins joined at IC on PCB.

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

Size: A1 | Rev:
KiCad E.D.A. 10.0.4 | Id: 1/1
