rx178nwj/StepperMotorDriver-Node/schematic_NEMA17/review/usb/schematic_NEMA17.pdf

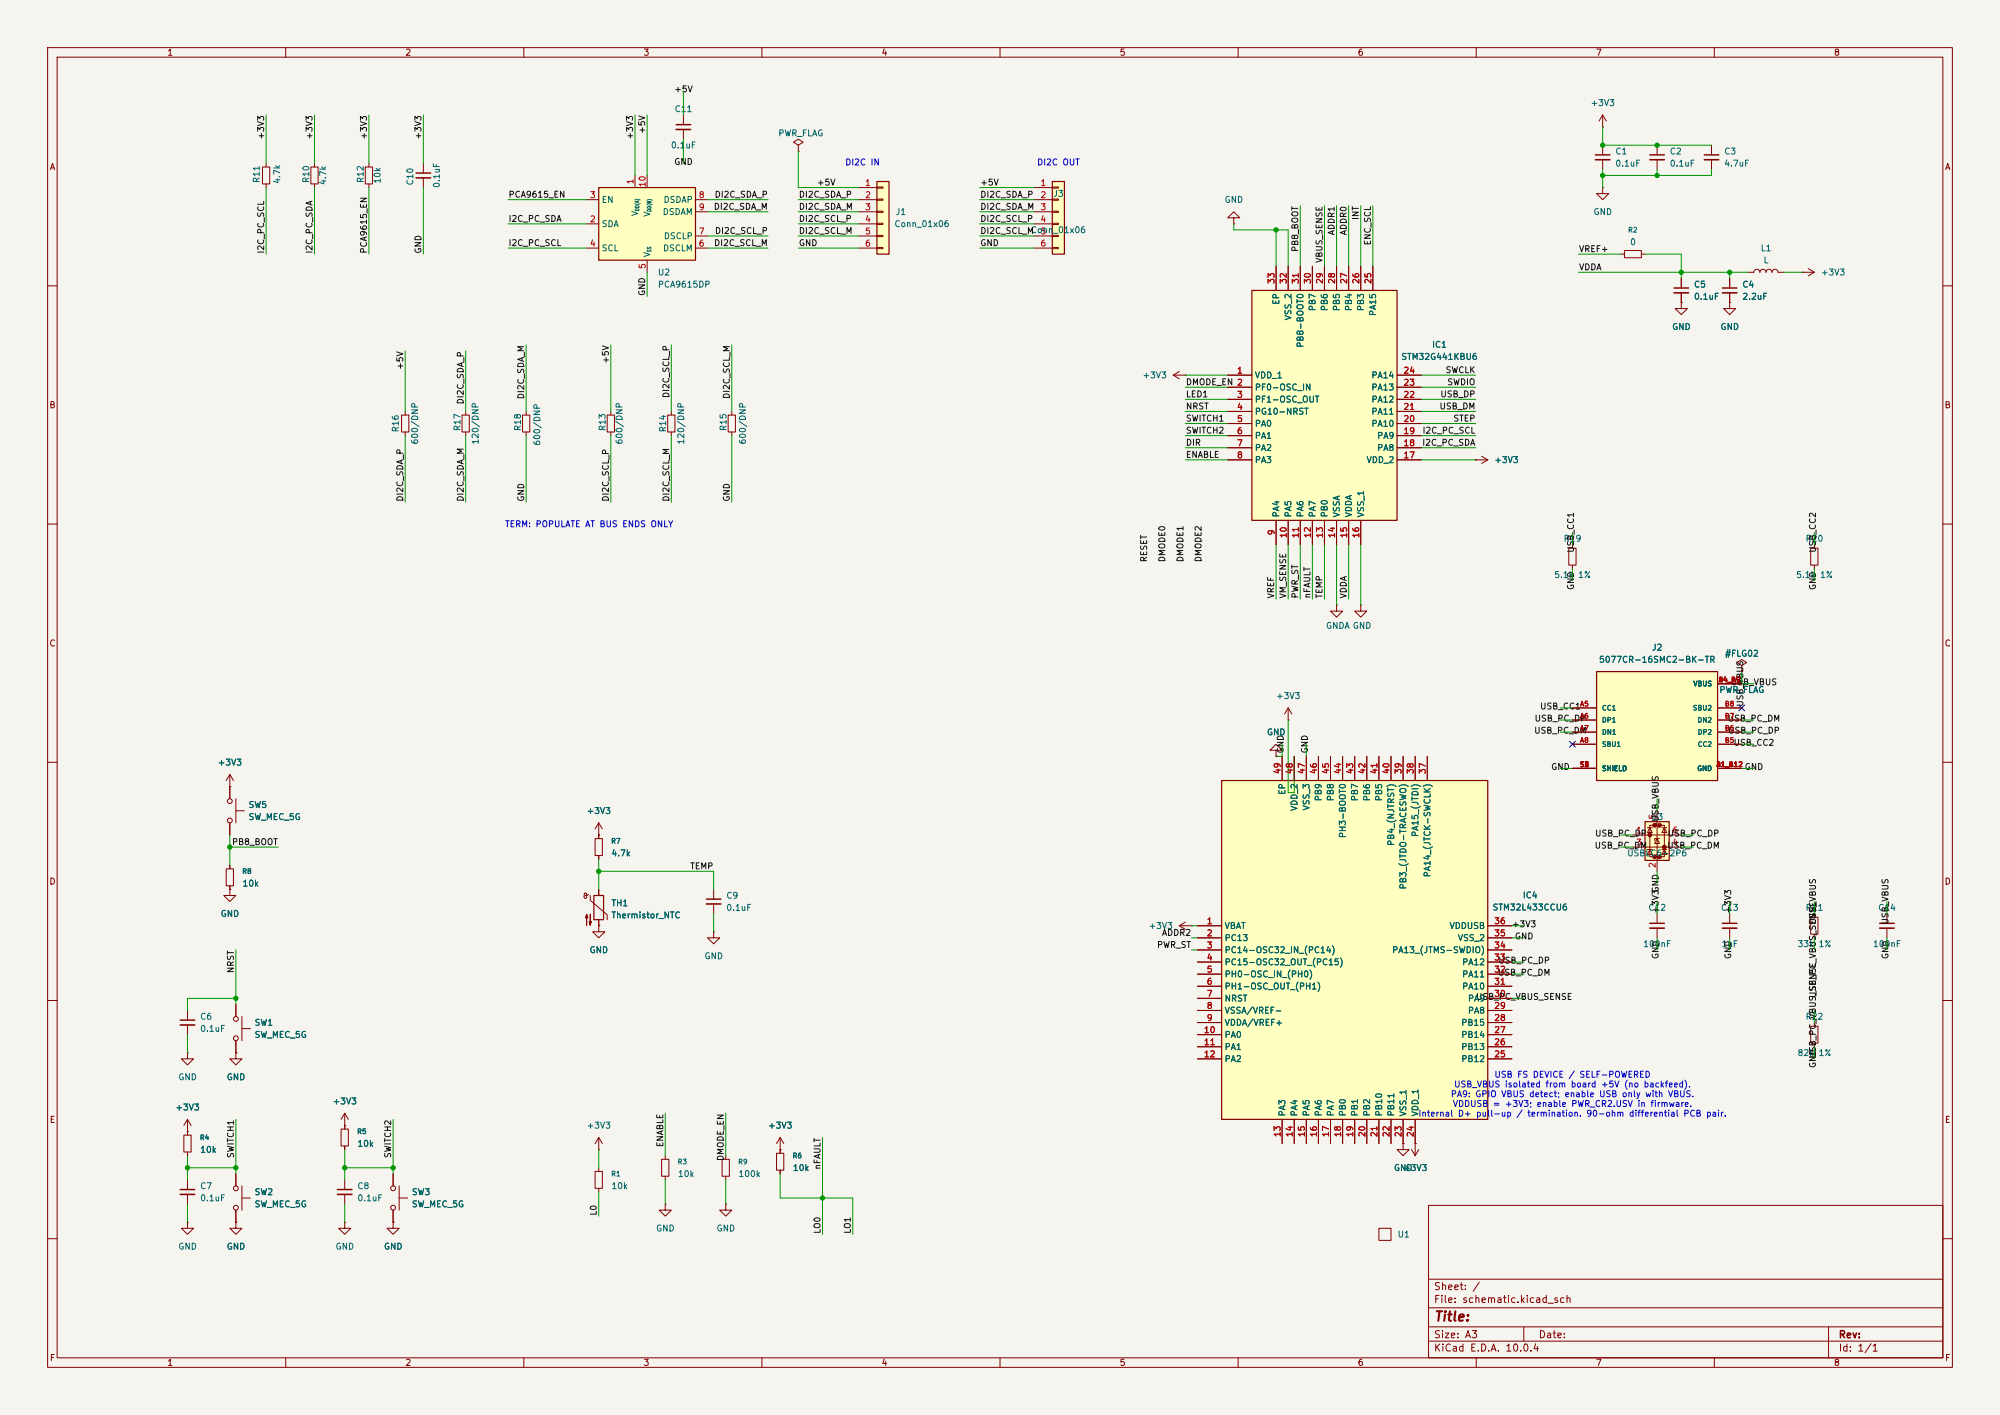
[picture p23: page 1]

VSS 5 DSCLM 6 DSCLP 7 DSDAP 8 DSDAM 9

Internal D+ pull-up / termination. 90-ohm differential PCB pair.

Size: A3 | Rev:
KiCad E.D.A. 10.0.4 | Id: 1/1 | F Date:
