rx178nwj/StepperMotorDriver-Node/schematic_NEMA23/review/can-after/schematic_NEMA23.pdf

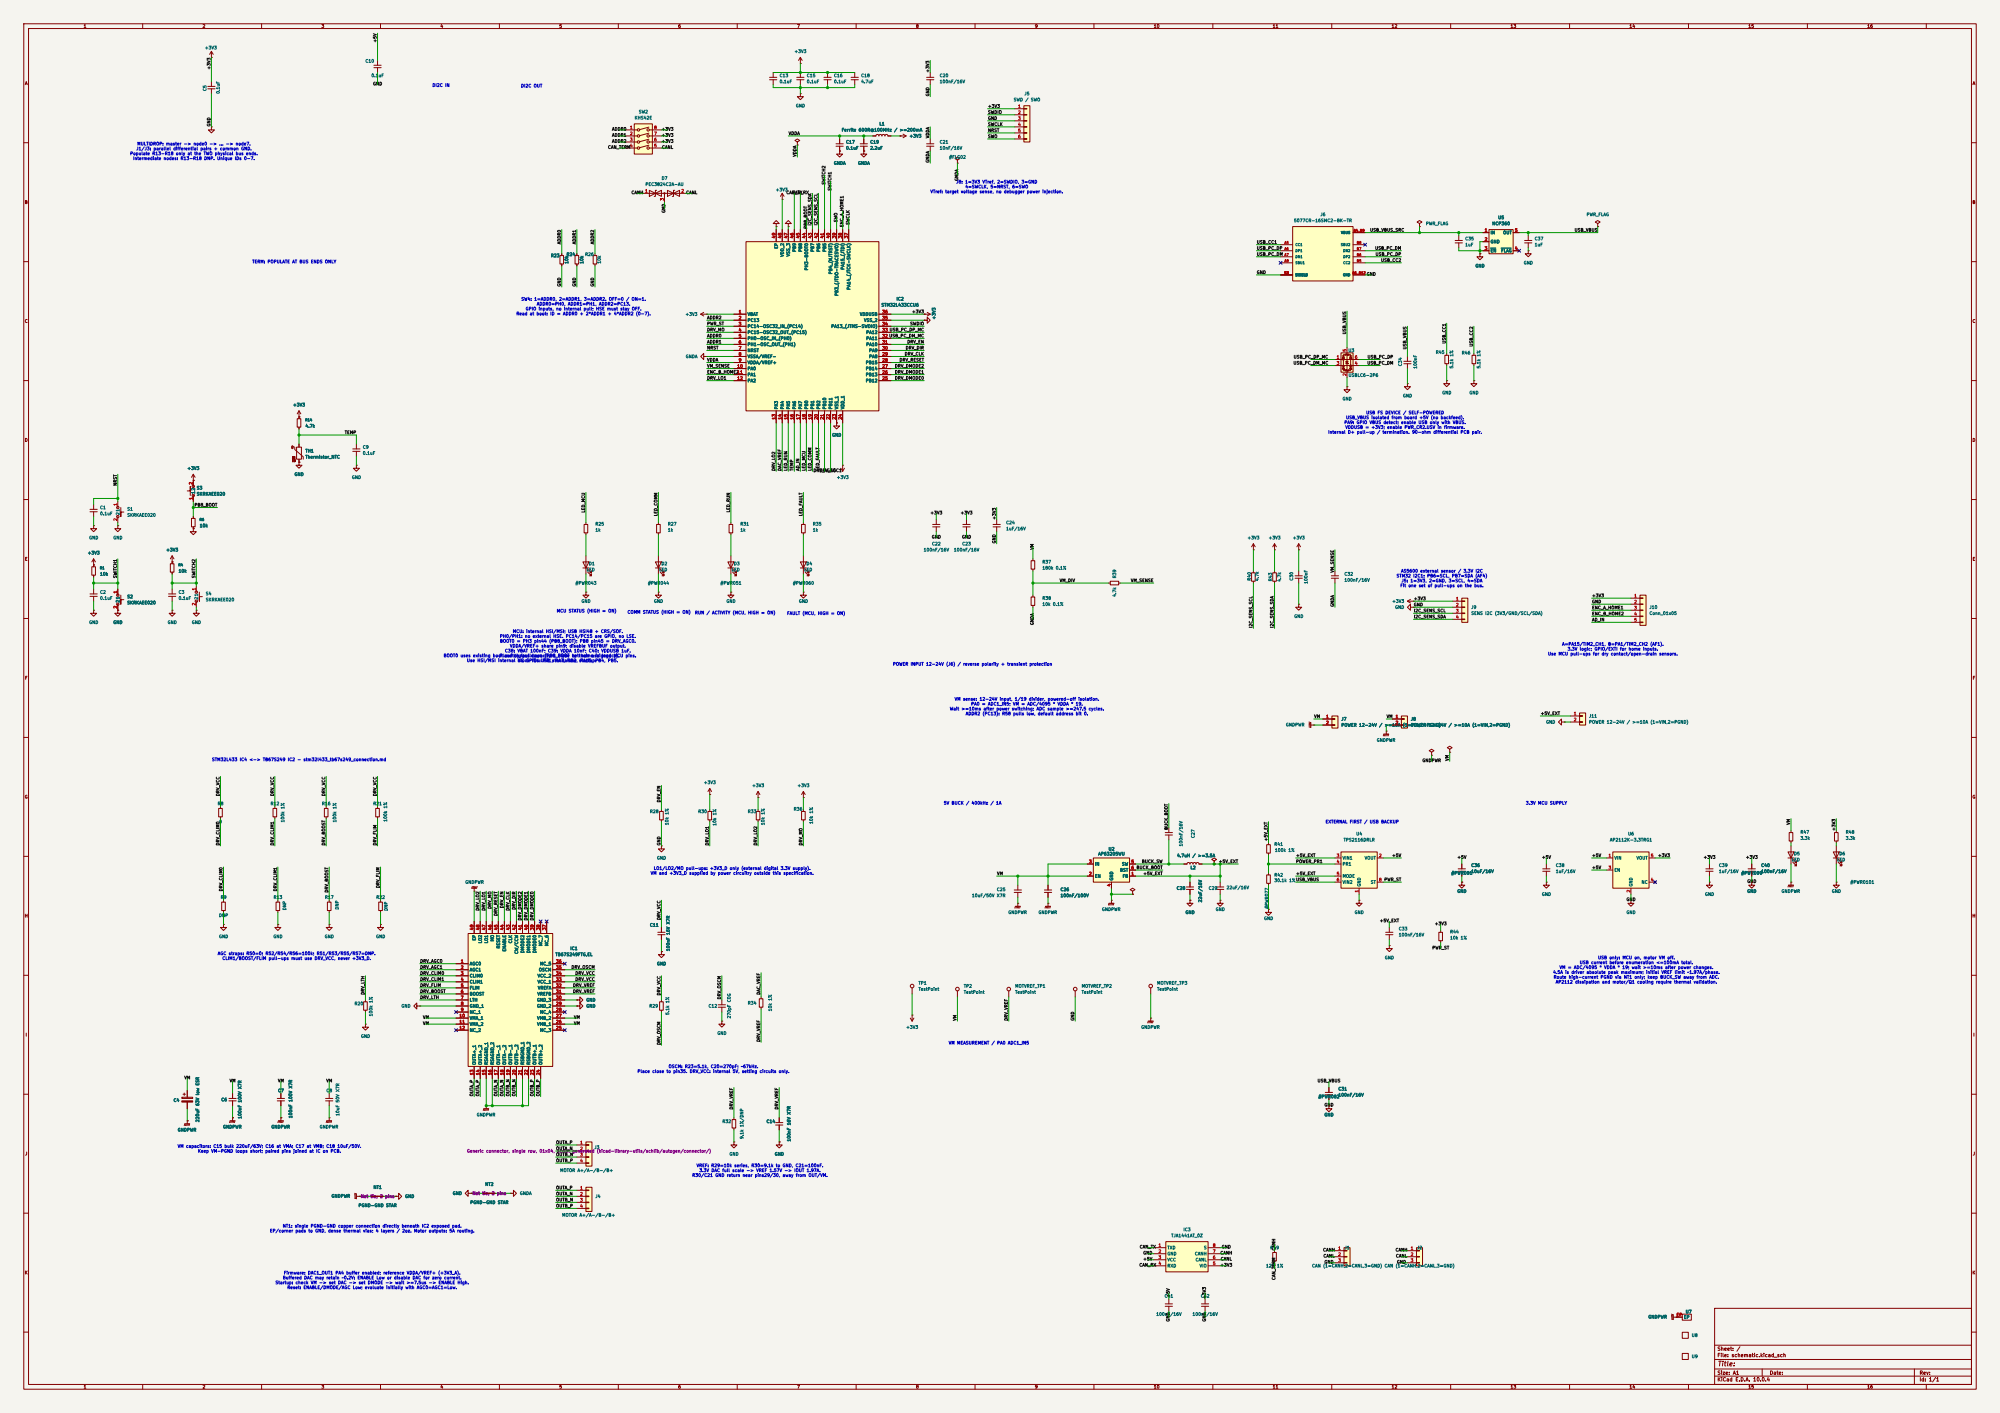
[picture p24: page 1]

MULTIDROP: master -> node0 -> ... -> node7. J1/J3: parallel differential pairs + common GND. Populate R13-R18 only at the TWO physical bus ends.

Intermediate nodes: R13-R18 DNP. Unique IDs 0-7.

VTref: target voltage sense, no debugger power injection.

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

TERM: POPULATE AT BUS ENDS ONLY

SW4: 1=ADDR0, 2=ADDR1, 3=ADDR2. OFF=0 / ON=1. ADDR0=PH0, ADDR1=PH1, ADDR2=PC13. GPIO inputs, no internal pull; HSE must stay OFF. Read at boot: ID = ADDR0 + 2*ADDR1 + 4*ADDR2 (0-7).

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

Internal D+ pull-up / termination. 90-ohm differential PCB pair. MCU: internal HSI/MSI; USB HSI48 + CRS/SOF.

STM32 I2C1: PB6=SCL, PB7=SDA (AF4) J5: 1=3V3, 2=GND, 3=SCL, 4=SDA

Fit one set of pull-ups on the bus.

SENS I2C (3V3/GND/SCL/SDA) GND

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

POWER INPUT 12-24V (J6) / reverse polarity + transient protection 5V BUCK / 400kHz / 1A

EXTERNAL FIRST / USB BACKUP
TPS2116DRLR

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

VM capacitors: C15 bulk 220uF/63V; C16 at VMA; C17 at VMB; C18 10uF/50V.

Keep VM-PGND loops short; paired pins joined at IC on PCB.

Generic connector, single row, 01x04, script generated (kicad-library-utils/schlib/autogen/connector/)

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

NT1 PGND-GND STAR Net tie, 2 pins

NT1: single PGND-GND copper connection directly beneath IC2 exposed pad.

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

J1 CAN (1=CANH,2=CANL,3=GND)
CANH
CANL

J2 CAN (1=CANH,2=CANL,3=GND)

Size: A1 | Rev:
KiCad E.D.A. 10.0.4 | Id: 1/1
