rx178nwj/StepperMotorDriver-Node/schematic_NEMA23/review/labels-before/schematic_NEMA23.pdf

Size: A3 | Rev:
KiCad E.D.A. 10.0.4 | Id: 1/1
