rx178nwj/StepperMotorDriver-Node/schematic_NEMA23/review/vm-small-after/schematic_NEMA23.pdf

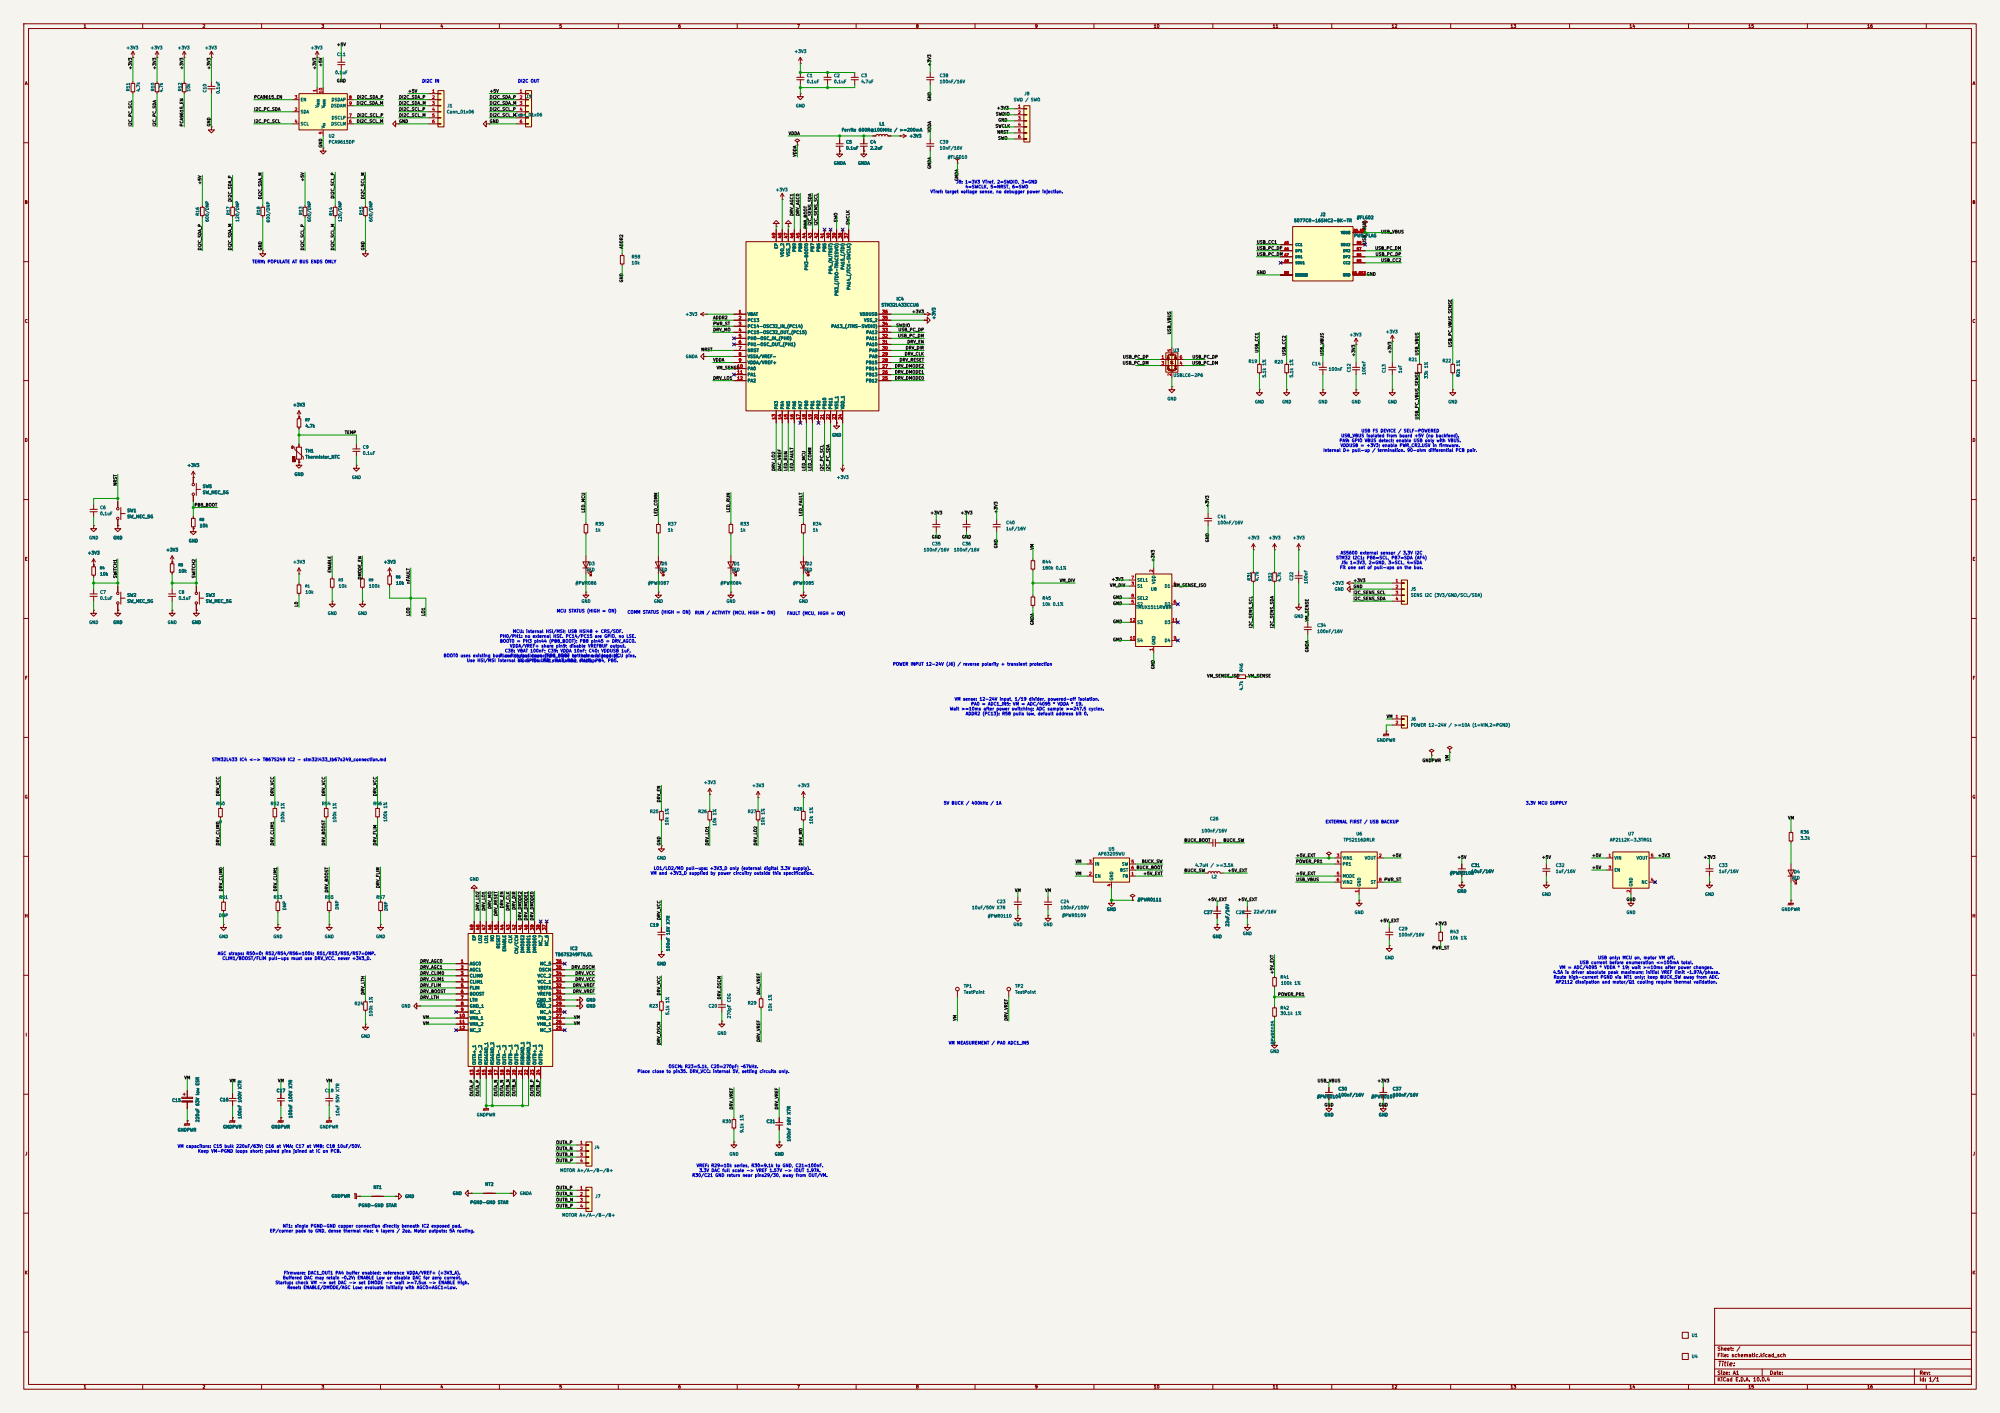
[picture p25: page 1]

VSS 5 DSCLM 6 DSCLP 7 DSDAP 8 DSDAM 9

VTref: target voltage sense, no debugger power injection.

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

TERM: POPULATE AT BUS ENDS ONLY

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

Internal D+ pull-up / termination. 90-ohm differential PCB pair.

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

Fit one set of pull-ups on the bus.

SENS I2C (3V3/GND/SCL/SDA)

MCU STATUS (HIGH = ON)

MCU: internal HSI/MSI; USB HSI48 + CRS/SOF.
PH0/PH1: no external HSE. PC14/PC15 are GPIO, no LSE. BOOT0 = PH3 pin44 (PB8_BOOT); PB8 pin45 = DRV_AGC0. VDDA/VREF+ share pin9; disable VREFBUF output. C38: VBAT 100nF; C39: VDDA 10nF; C40: VDDUSB 1uF. Place bypass capacitors close to their assigned MCU pins. NC GPIOs: PA1, PA7, PB2, PA15, PB4, PB5.

VM sense: 12-24V input, 1/19 divider, powered-off isolation. PA0 = ADC1_IN5; VM = ADC/4095 * VDDA * 19. Wait >=10ms after power switching; ADC sample >=247.5 cycles. ADDR2 (PC13): R58 pulls low, default address bit 0. BOOT0 uses existing boot switch/pulldown (PB8_BOOT net name is legacy). Use HSI/MSI internal clock for USB standalone startup.

POWER INPUT 12-24V (J6) / reverse polarity + transient protection

EXTERNAL FIRST / USB BACKUP
TPS2116DRLR

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

VM capacitors: C15 bulk 220uF/63V; C16 at VMA; C17 at VMB; C18 10uF/50V.

Keep VM-PGND loops short; paired pins joined at IC on PCB.

GNDA NT2 PGND-GND STAR

NT1: single PGND-GND copper connection directly beneath IC2 exposed pad.

EP/corner pads to GND, dense thermal vias; 4 layers / 2oz. Motor outputs: 5A routing.

Size: A1 | Rev:
KiCad E.D.A. 10.0.4 | Id: 1/1
