rx178nwj/StepperMotorDriver-Node/docs/da078656-b2af-4cde-9333-6fccafd07525.pdf

L2 | 7 GND | 8

A

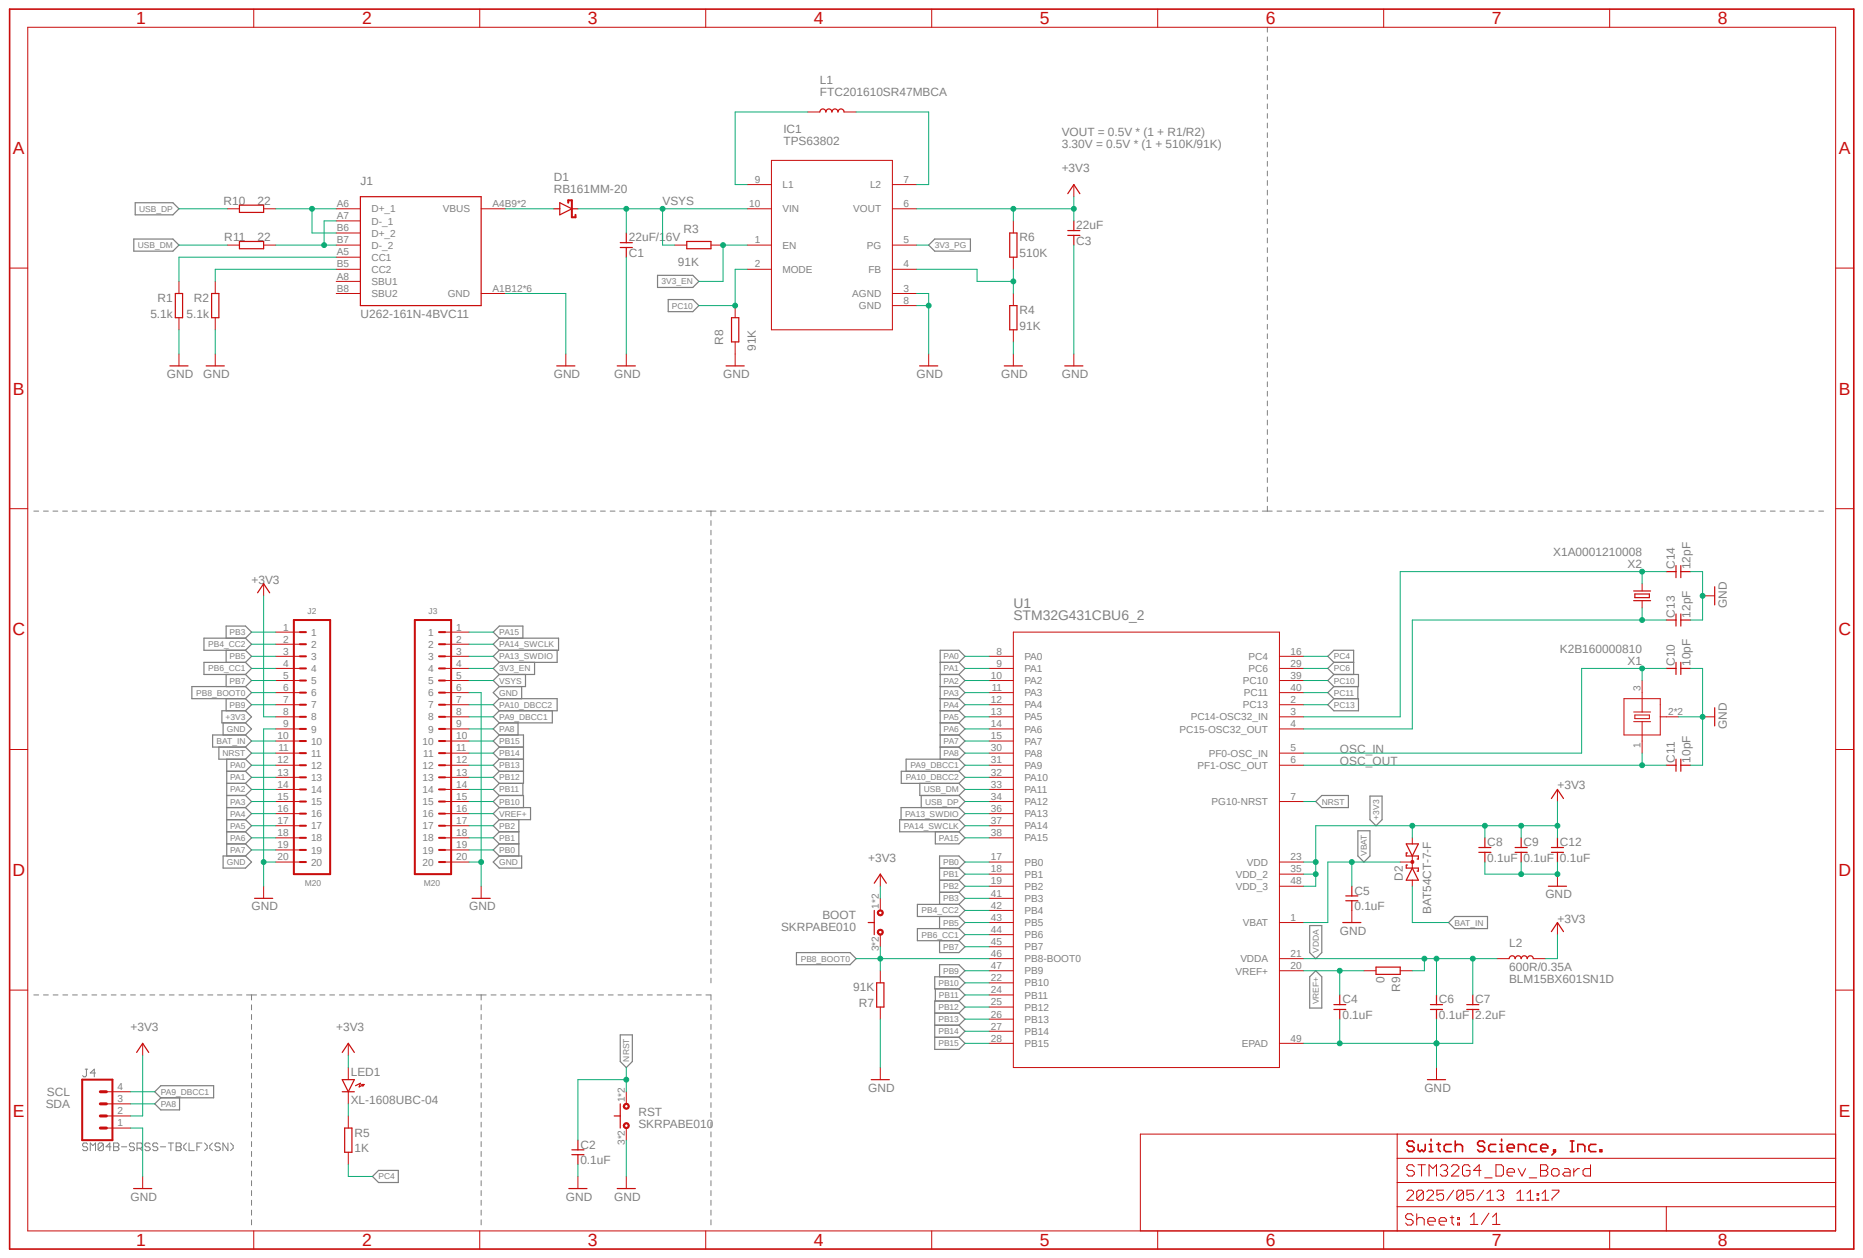
[picture p26: page 1]
