rx178nwj/StepperMotorDriver-Node/docs/37f2b0a0-b5d7-4d3f-bee0-6b3f1ee938e0.pdf

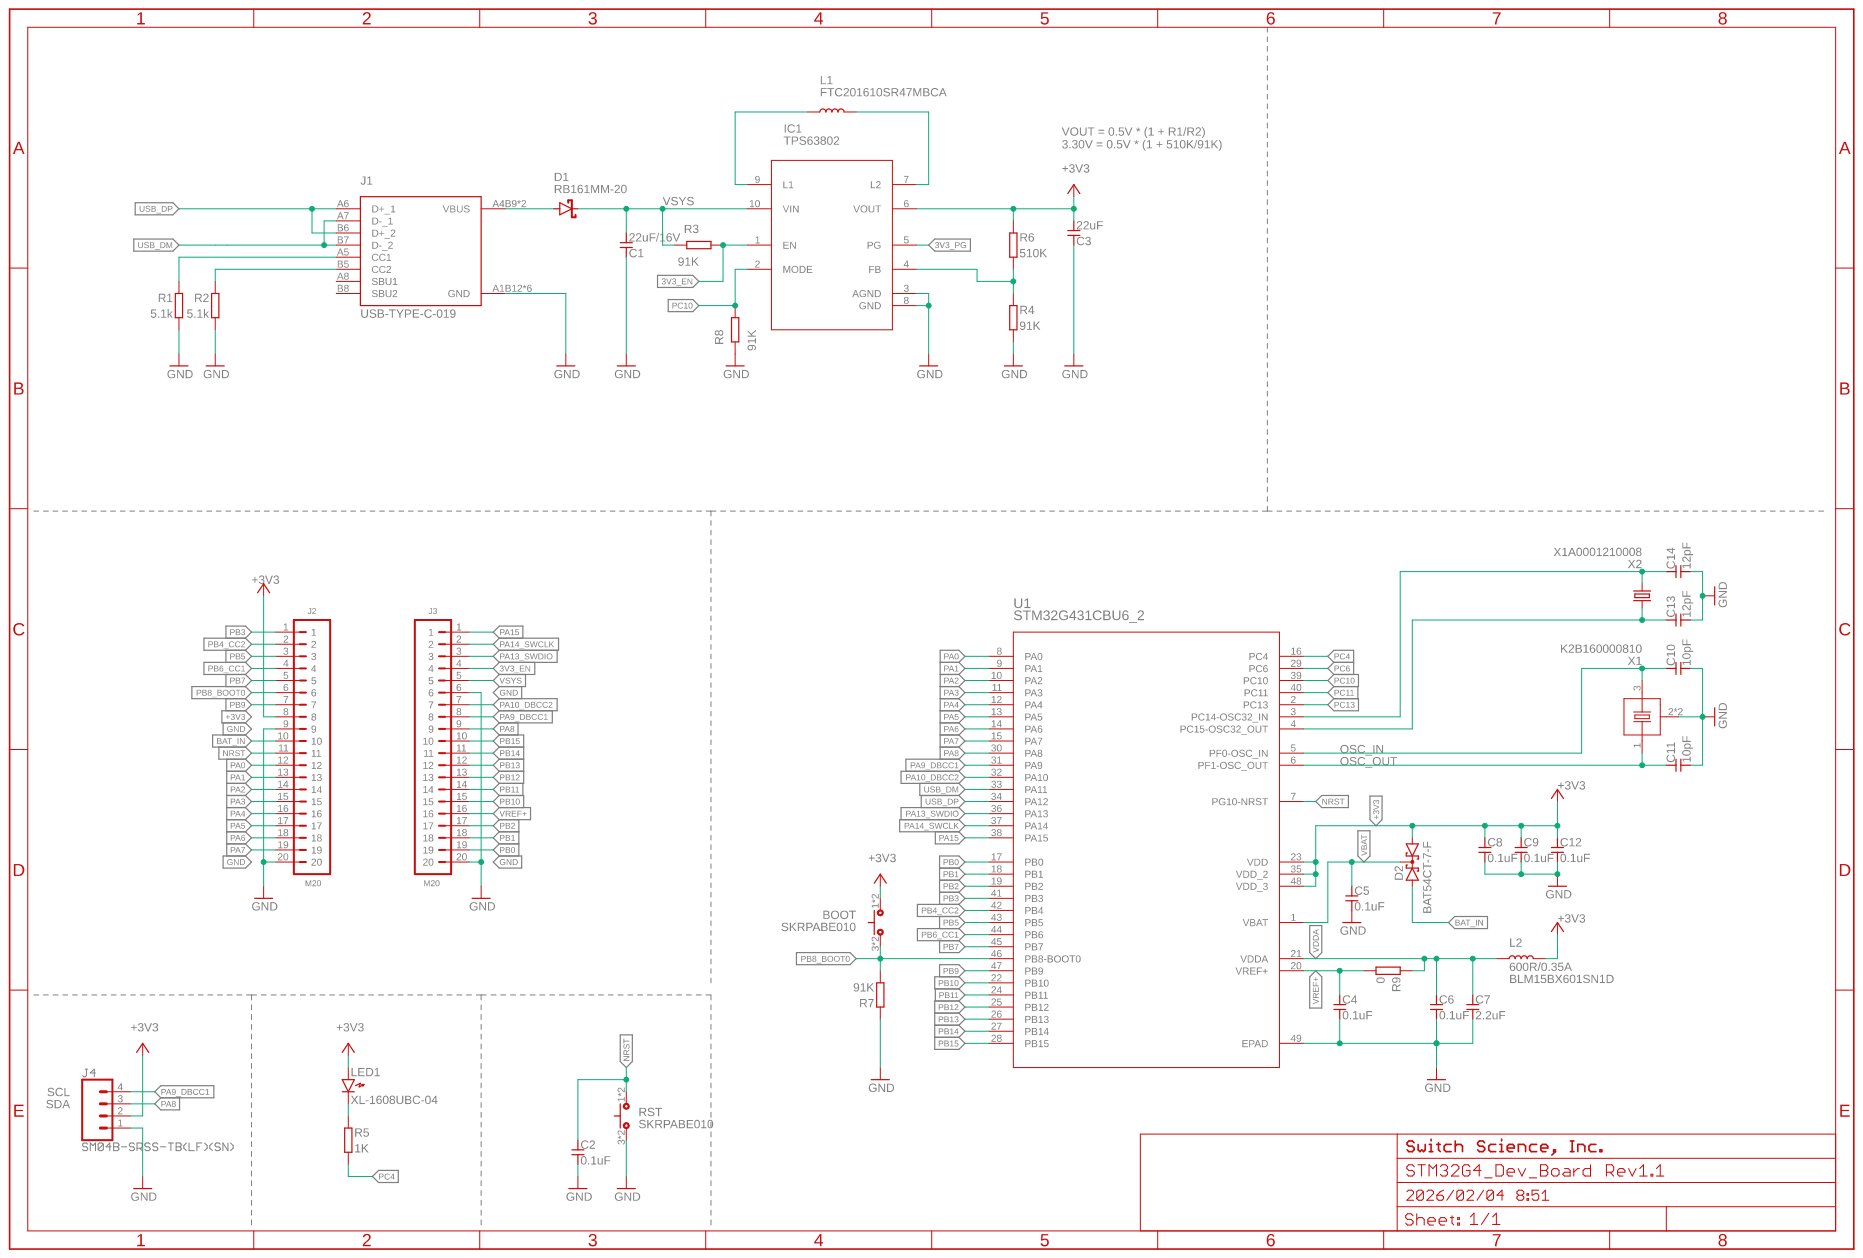
[picture p27: page 1]
