rx178nwj/StepperMotorDriver-Node/(list of files, drawings)

Other design files:
schematic_NEMA17/review/addr2/before/schematic-erc.json
schematic_NEMA17/review/dip-address/after/schematic-erc.json
schematic_NEMA17/review/dip-address/before/schematic-erc.json
schematic_NEMA17/review/driver-after/schematic-erc.json
schematic_NEMA17/review/driver-before/schematic-erc.json
schematic_NEMA17/review/gpio_adc/after/schematic-erc.json
schematic_NEMA17/review/inputs-self-power/after/schematic-erc.json
schematic_NEMA17/review/inputs-self-power/before/schematic-erc.json
schematic_NEMA17/review/jlcpcb-4layer/schematic-drc.json
schematic_NEMA17/review/ksd32/before/schematic-erc.json
schematic_NEMA17/review/schematic-erc.json
schematic_NEMA17/review/stm32_support/after/schematic-erc.json
schematic_NEMA17/review/stm32_support/schematic-erc.json
schematic_NEMA17/review/vm-rsv-after/schematic-erc.json
schematic_NEMA17/review/vm-small-after/schematic-erc.json
schematic_NEMA17/schematic_NEMA17.dsn
schematic_NEMA17/temp-freerouting.dsn
schematic_NEMA23/review/addr2/after/schematic-erc.json
schematic_NEMA23/review/ap63205-after/schematic-erc.json
schematic_NEMA23/review/can-after/schematic-erc.json
schematic_NEMA23/review/can-pcb/schematic-drc.json
schematic_NEMA23/review/full-audit/schematic-erc.json
schematic_NEMA23/review/gpio_adc/before/schematic-erc.json
schematic_NEMA23/review/ksd32/after/schematic-erc.json
schematic_NEMA23/review/labels-after/schematic-erc.json
schematic_NEMA23/review/labels-before/schematic-erc.json
schematic_NEMA23/review/vm-rsv-before/schematic-erc.json
schematic_NEMA23/review/vm-small-before/schematic-erc.json
schematic_NEMA23/schematic-erc.json
schematic_NEMA23/schematic_NEMA23-erc.json
