rx178nwj/StepperMotorDriver-Node/schematic_NEMA23/schematic_NEMA23.kicad_pcb

## KiCad design schematic_NEMA23/schematic_NEMA23.kicad_pcb (2026-10-18)

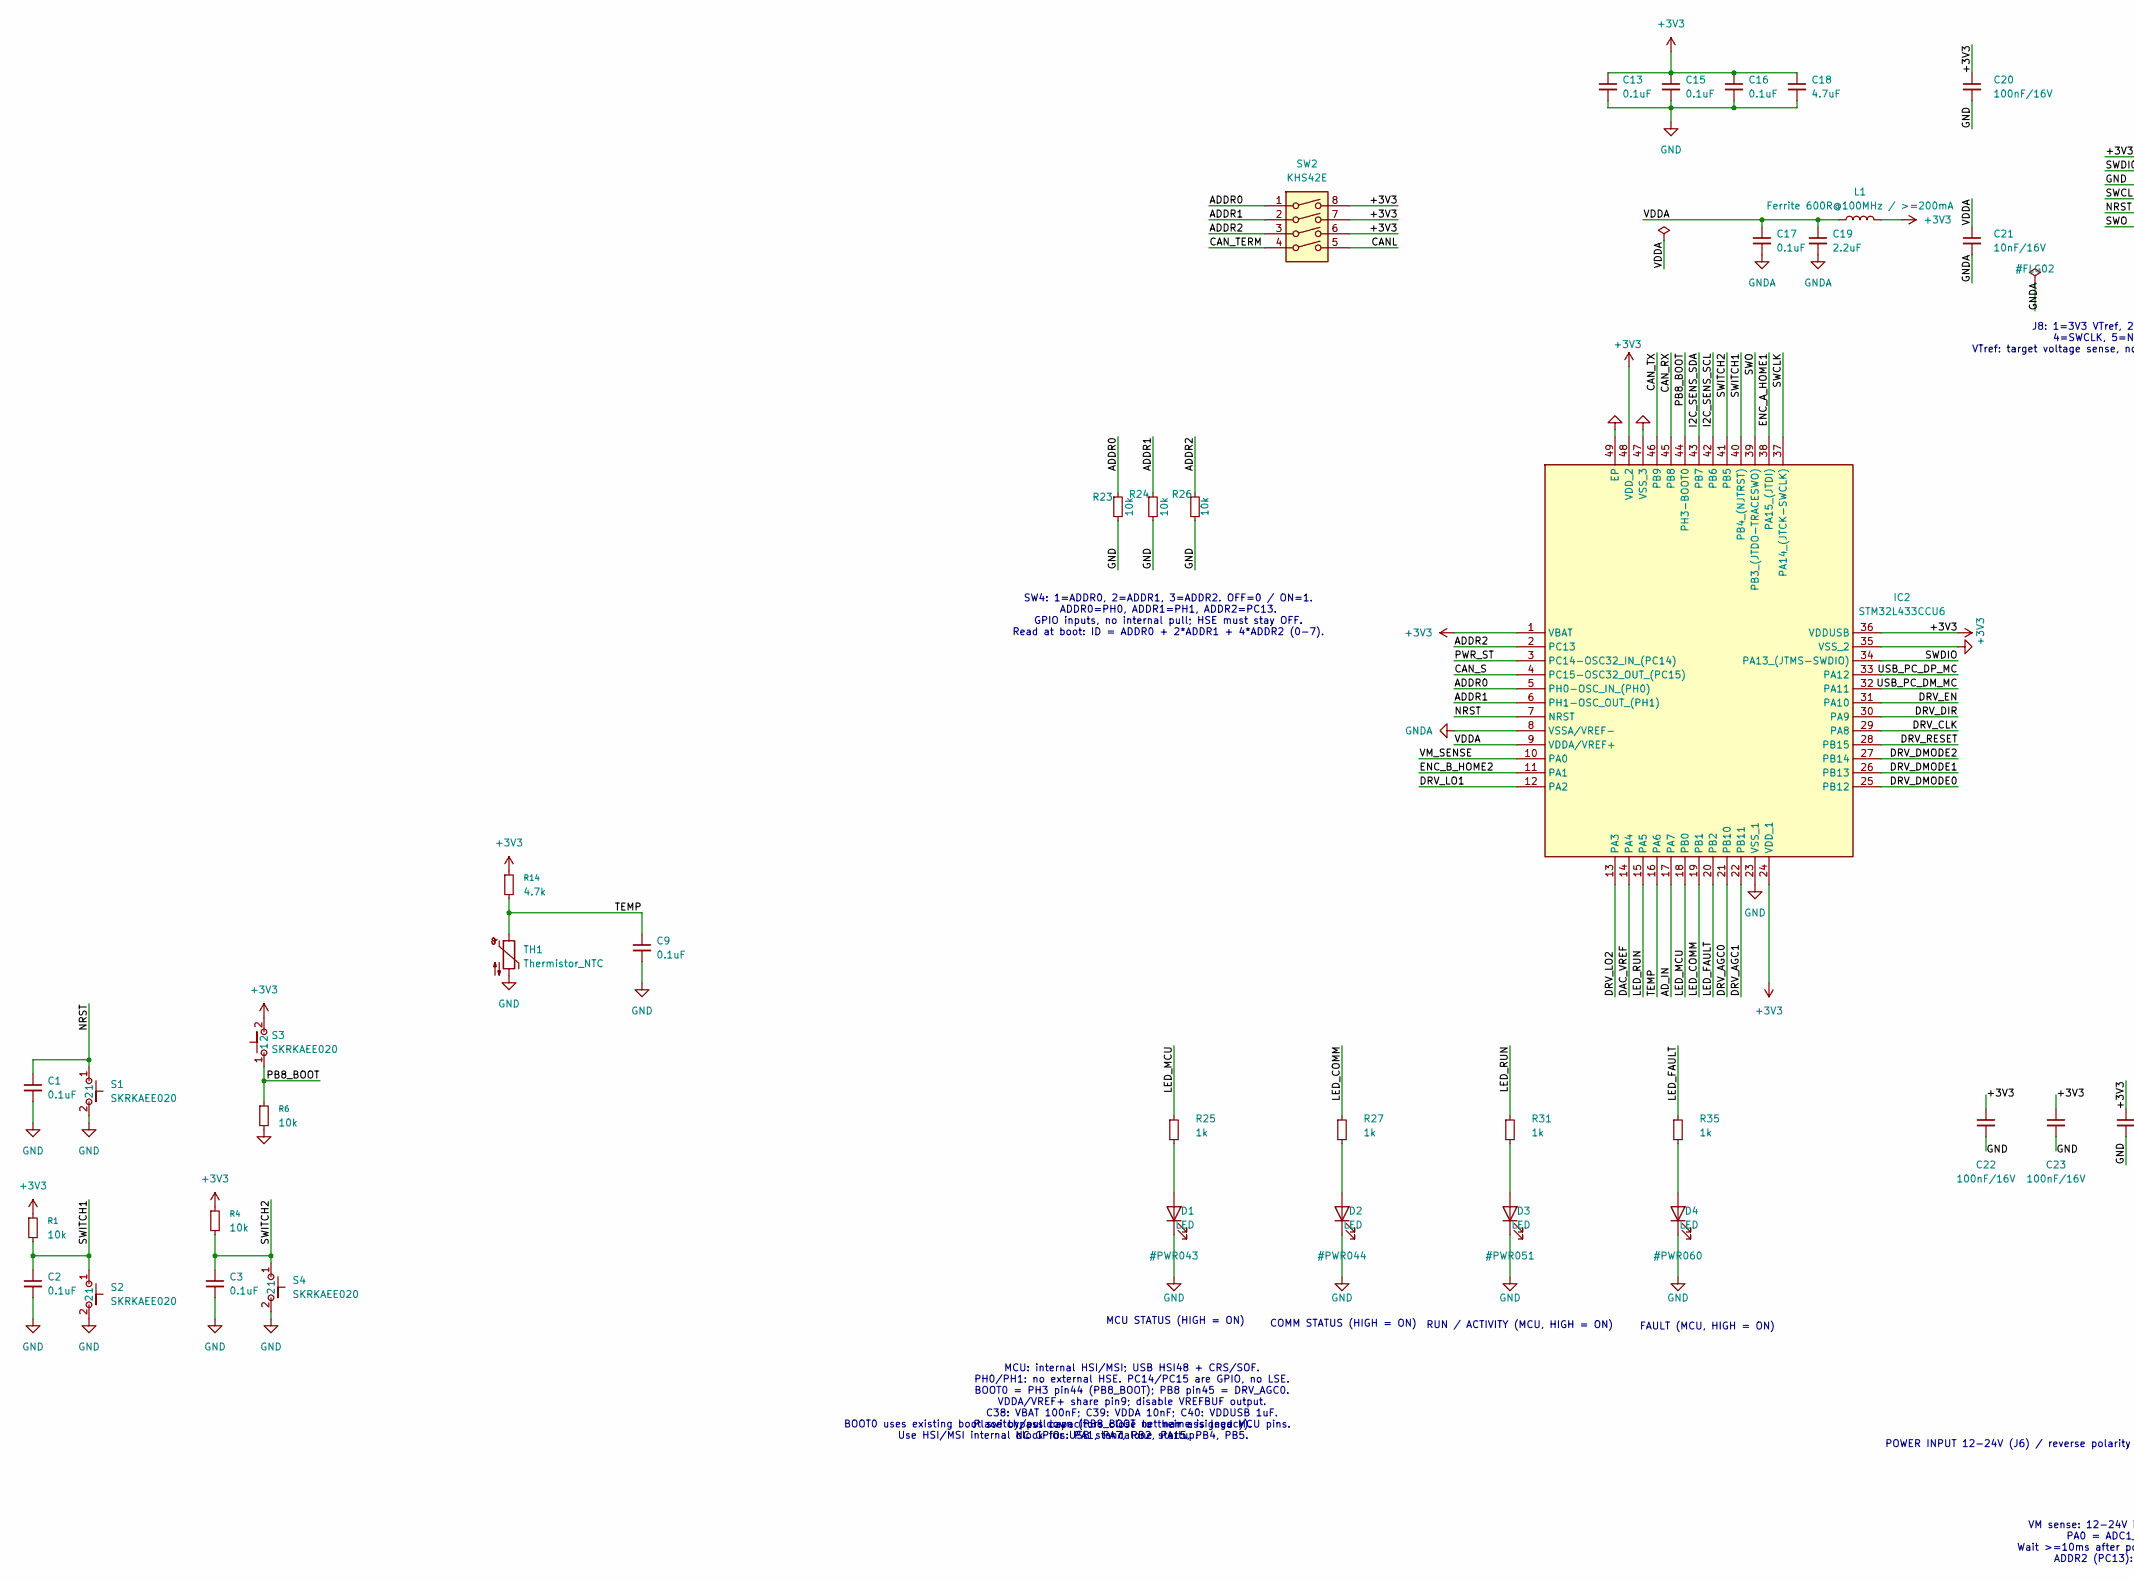
[picture p28: schematic schematic_NEMA23.kicad_sch, Stepper Motor Driver NEMA23, part in row 1, column 1]

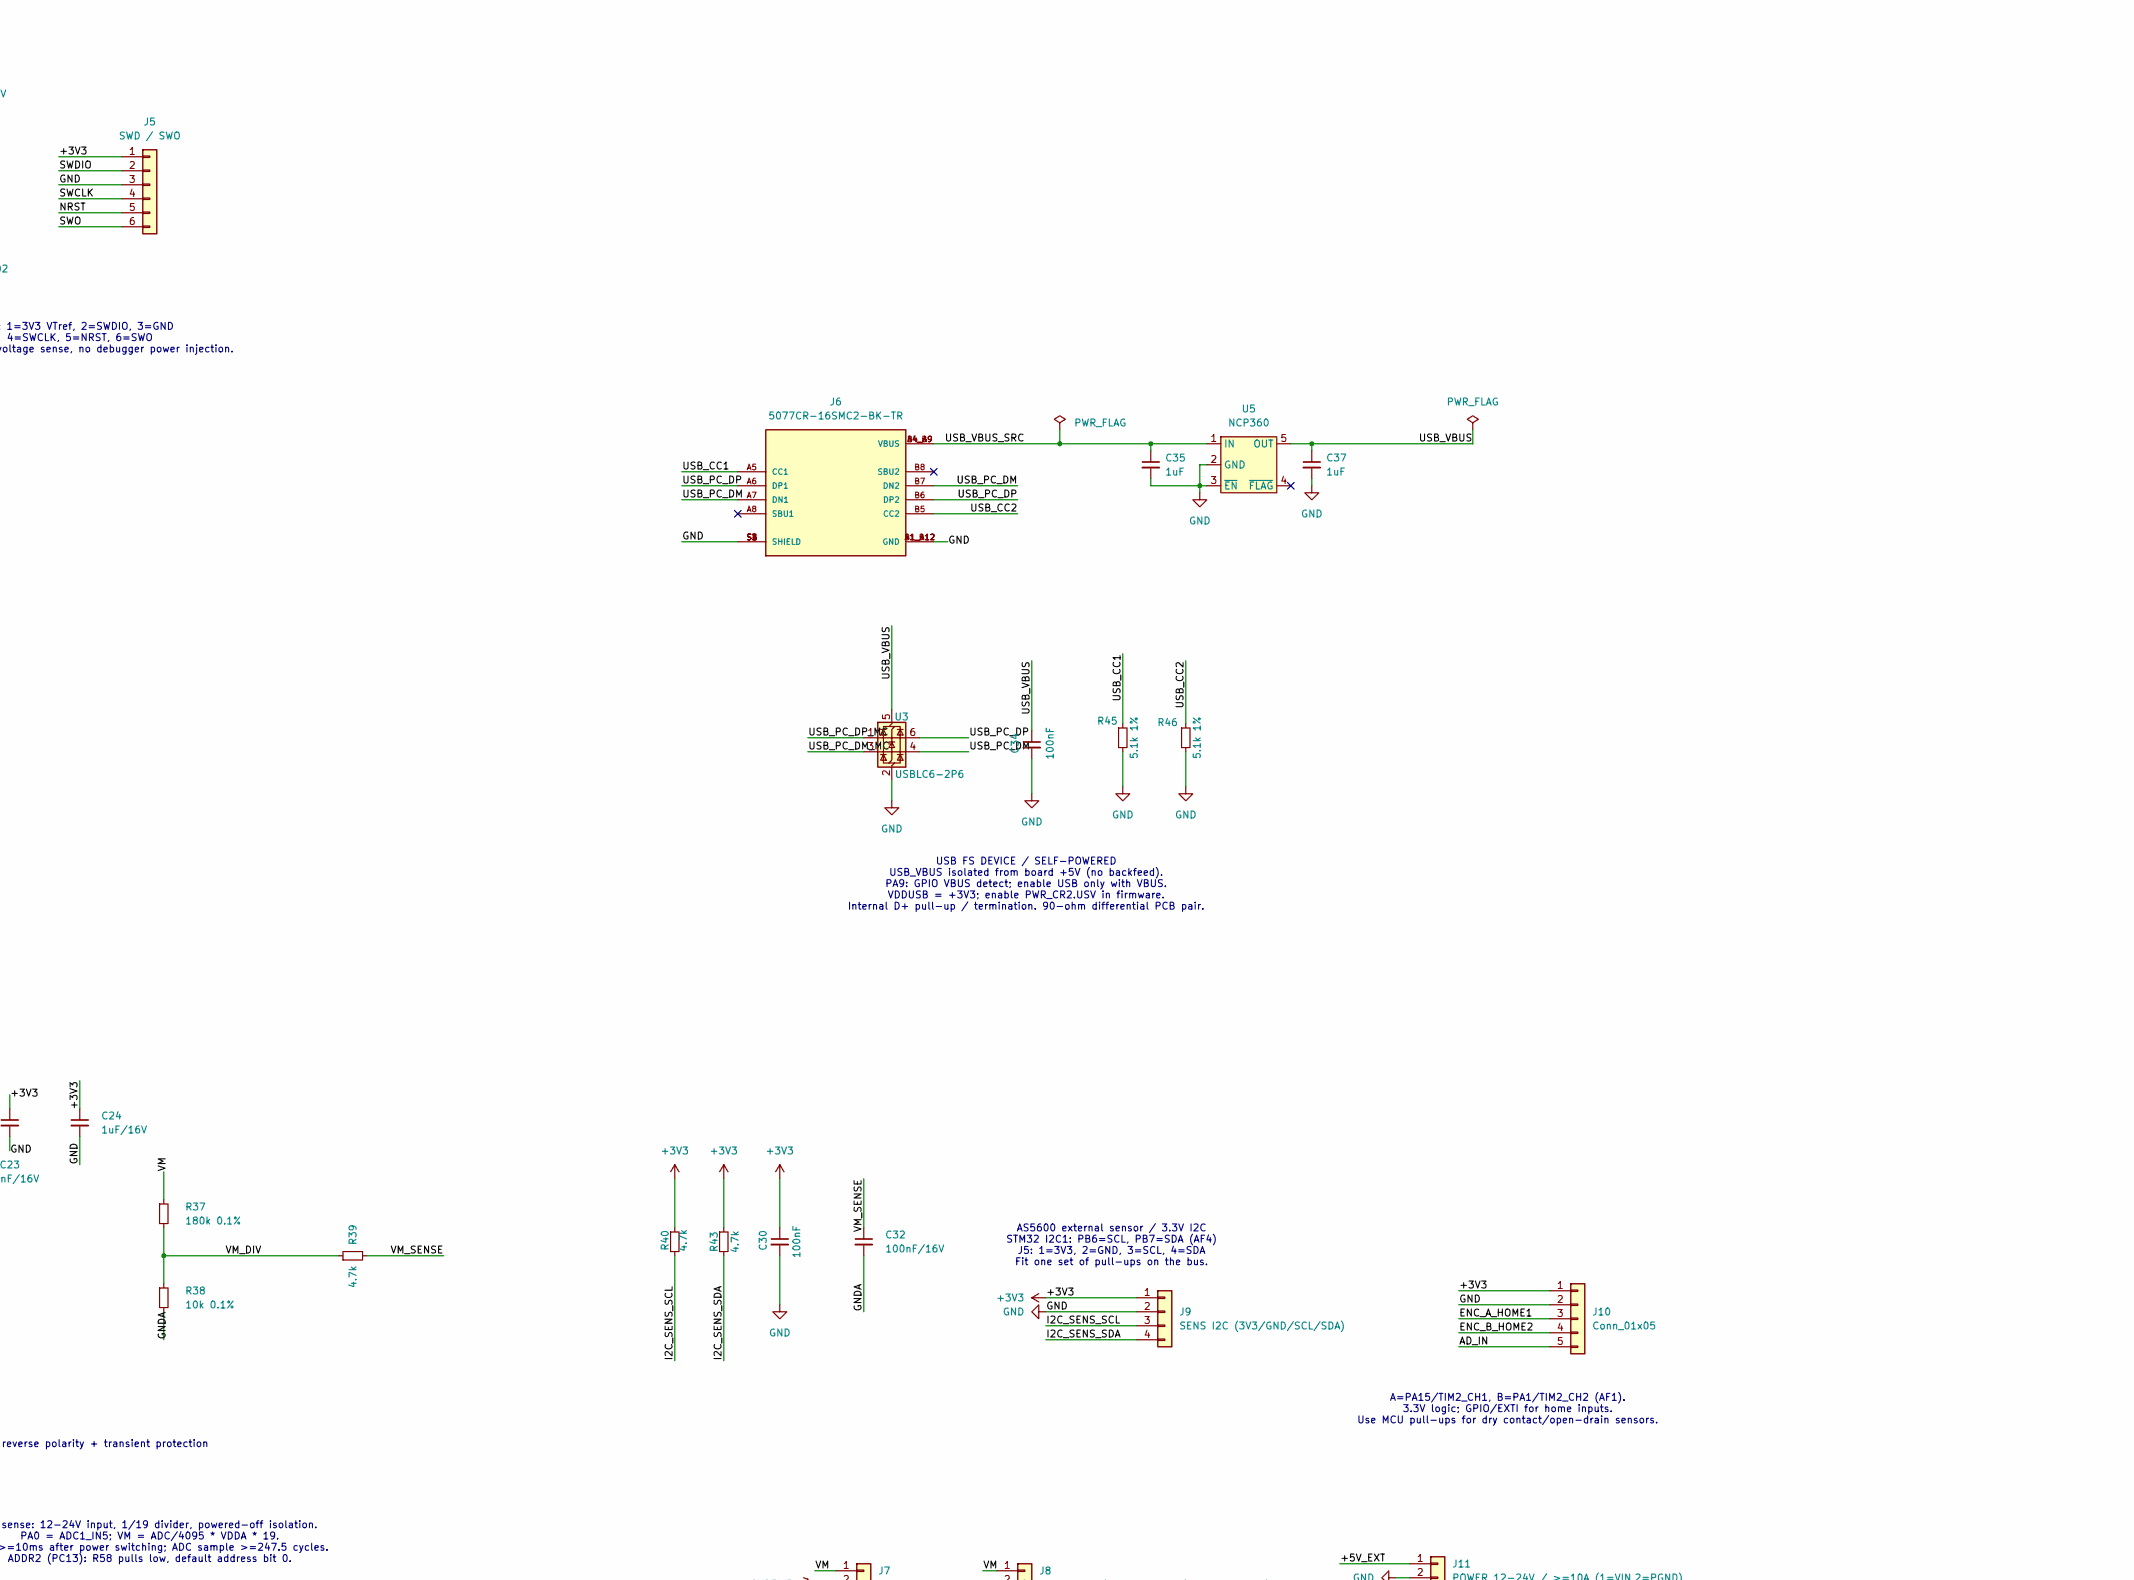
[picture p29: schematic schematic_NEMA23.kicad_sch, Stepper Motor Driver NEMA23, part in row 1, column 2]

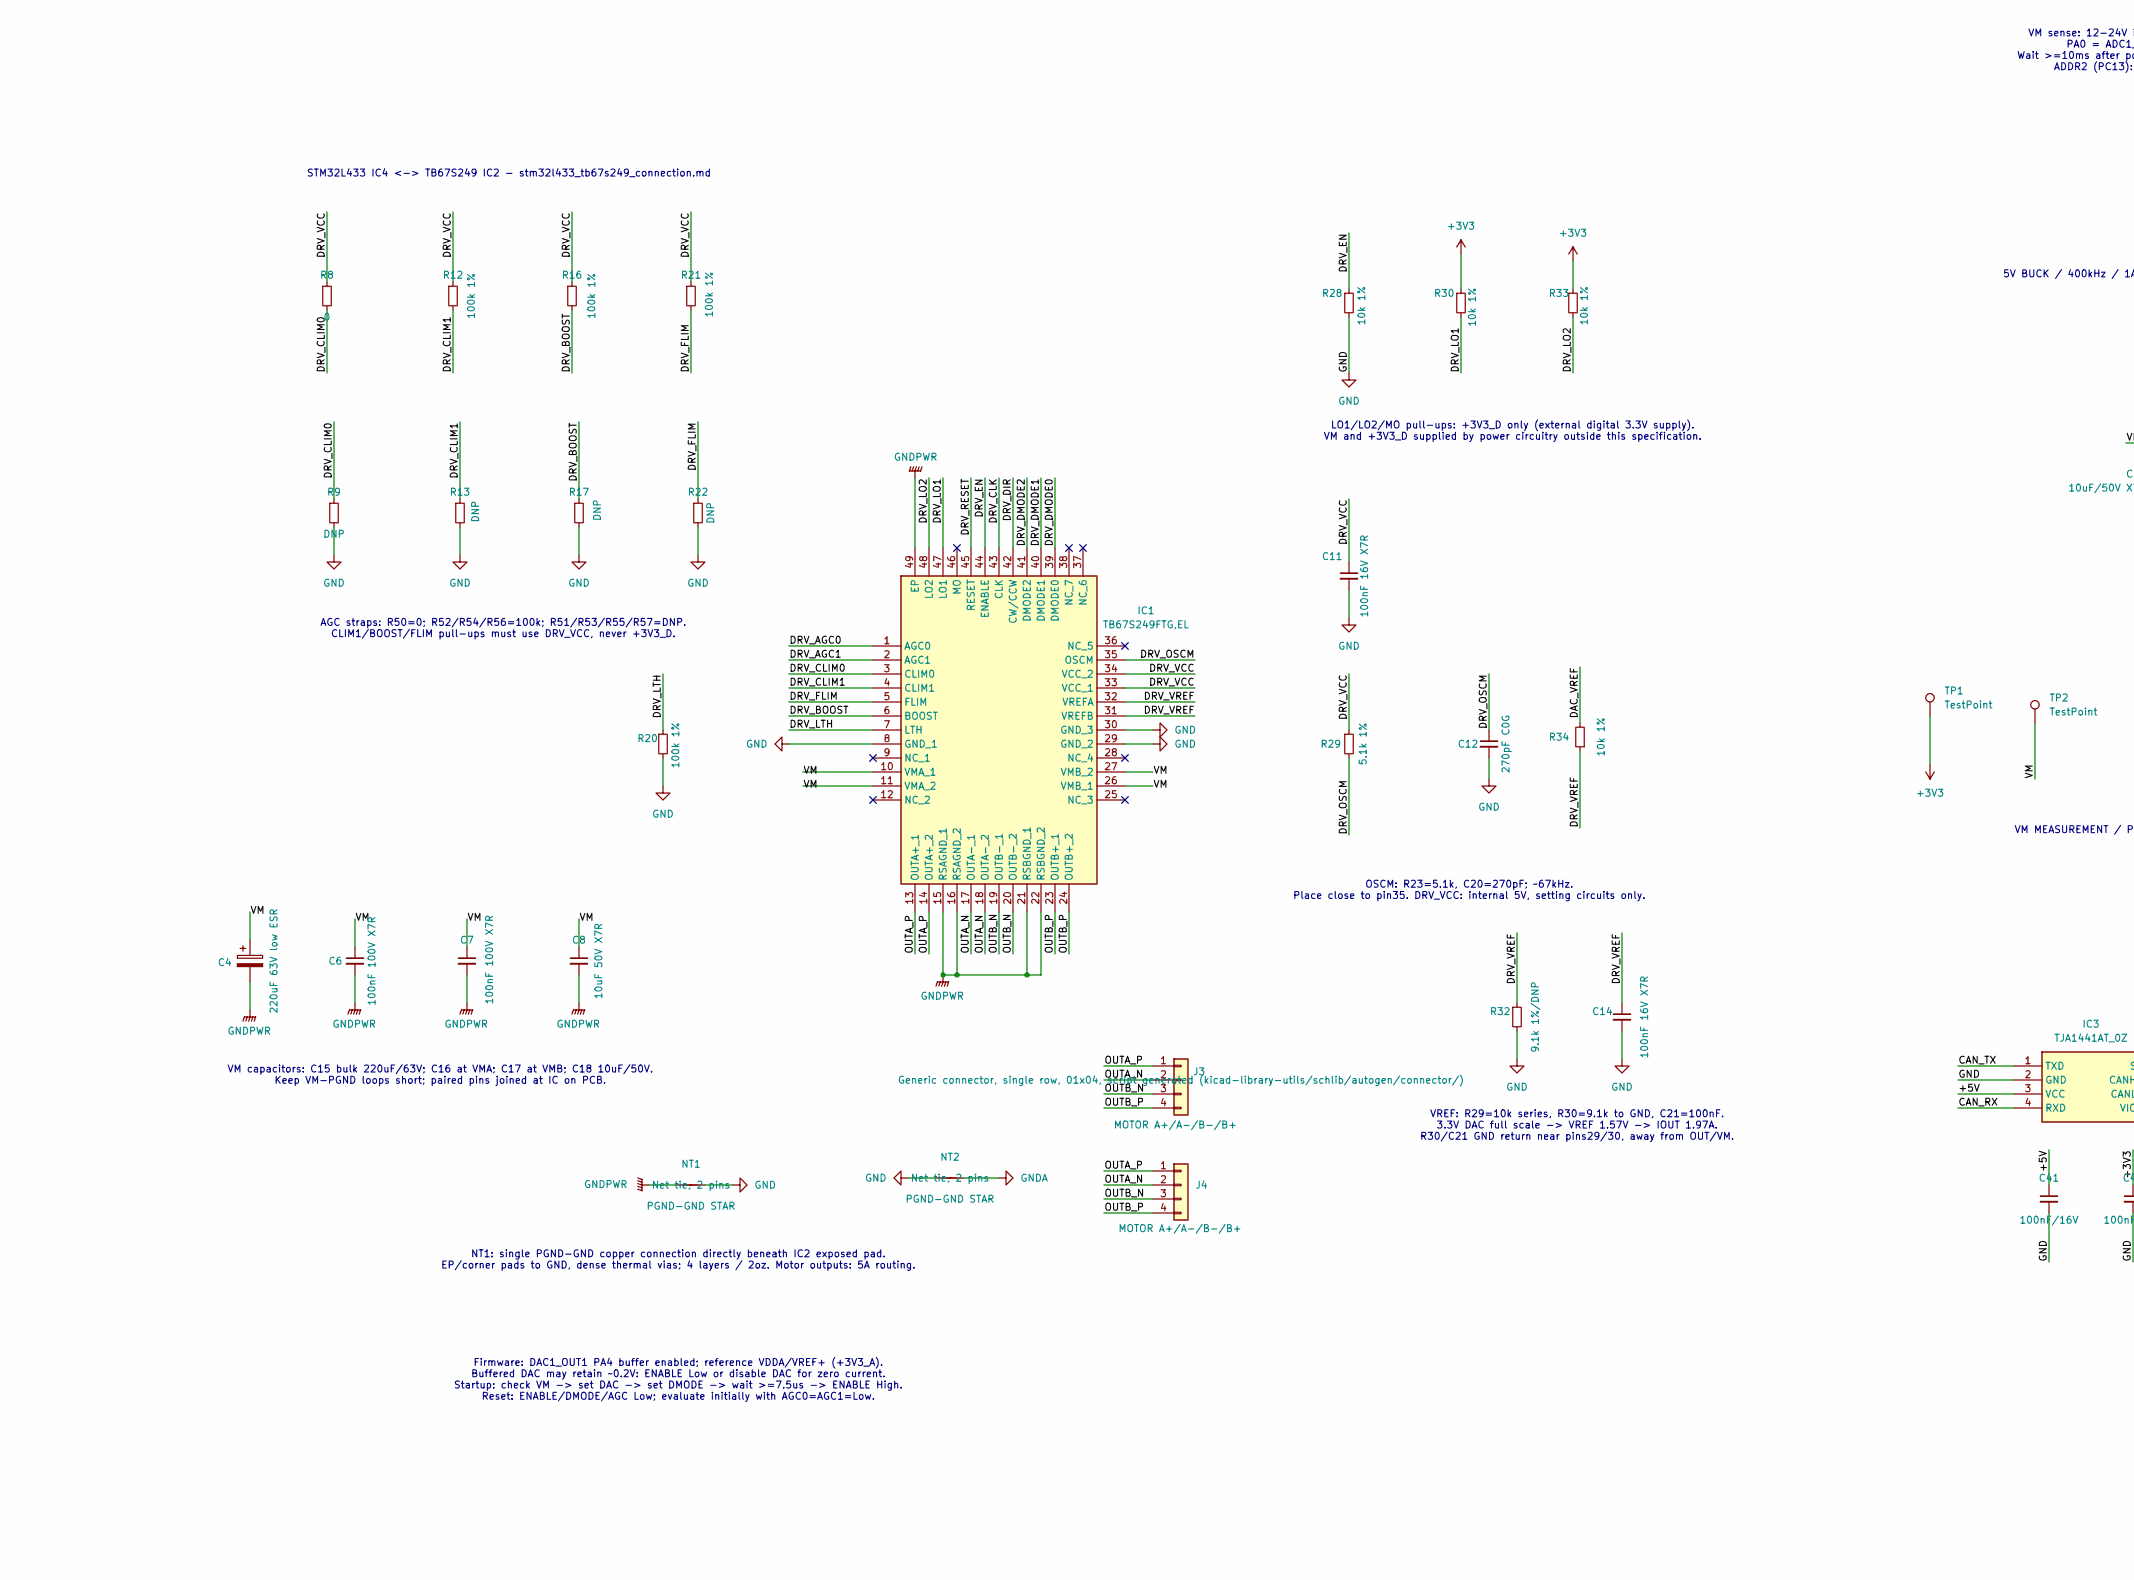
[picture p30: schematic schematic_NEMA23.kicad_sch, Stepper Motor Driver NEMA23, part in row 2, column 1]

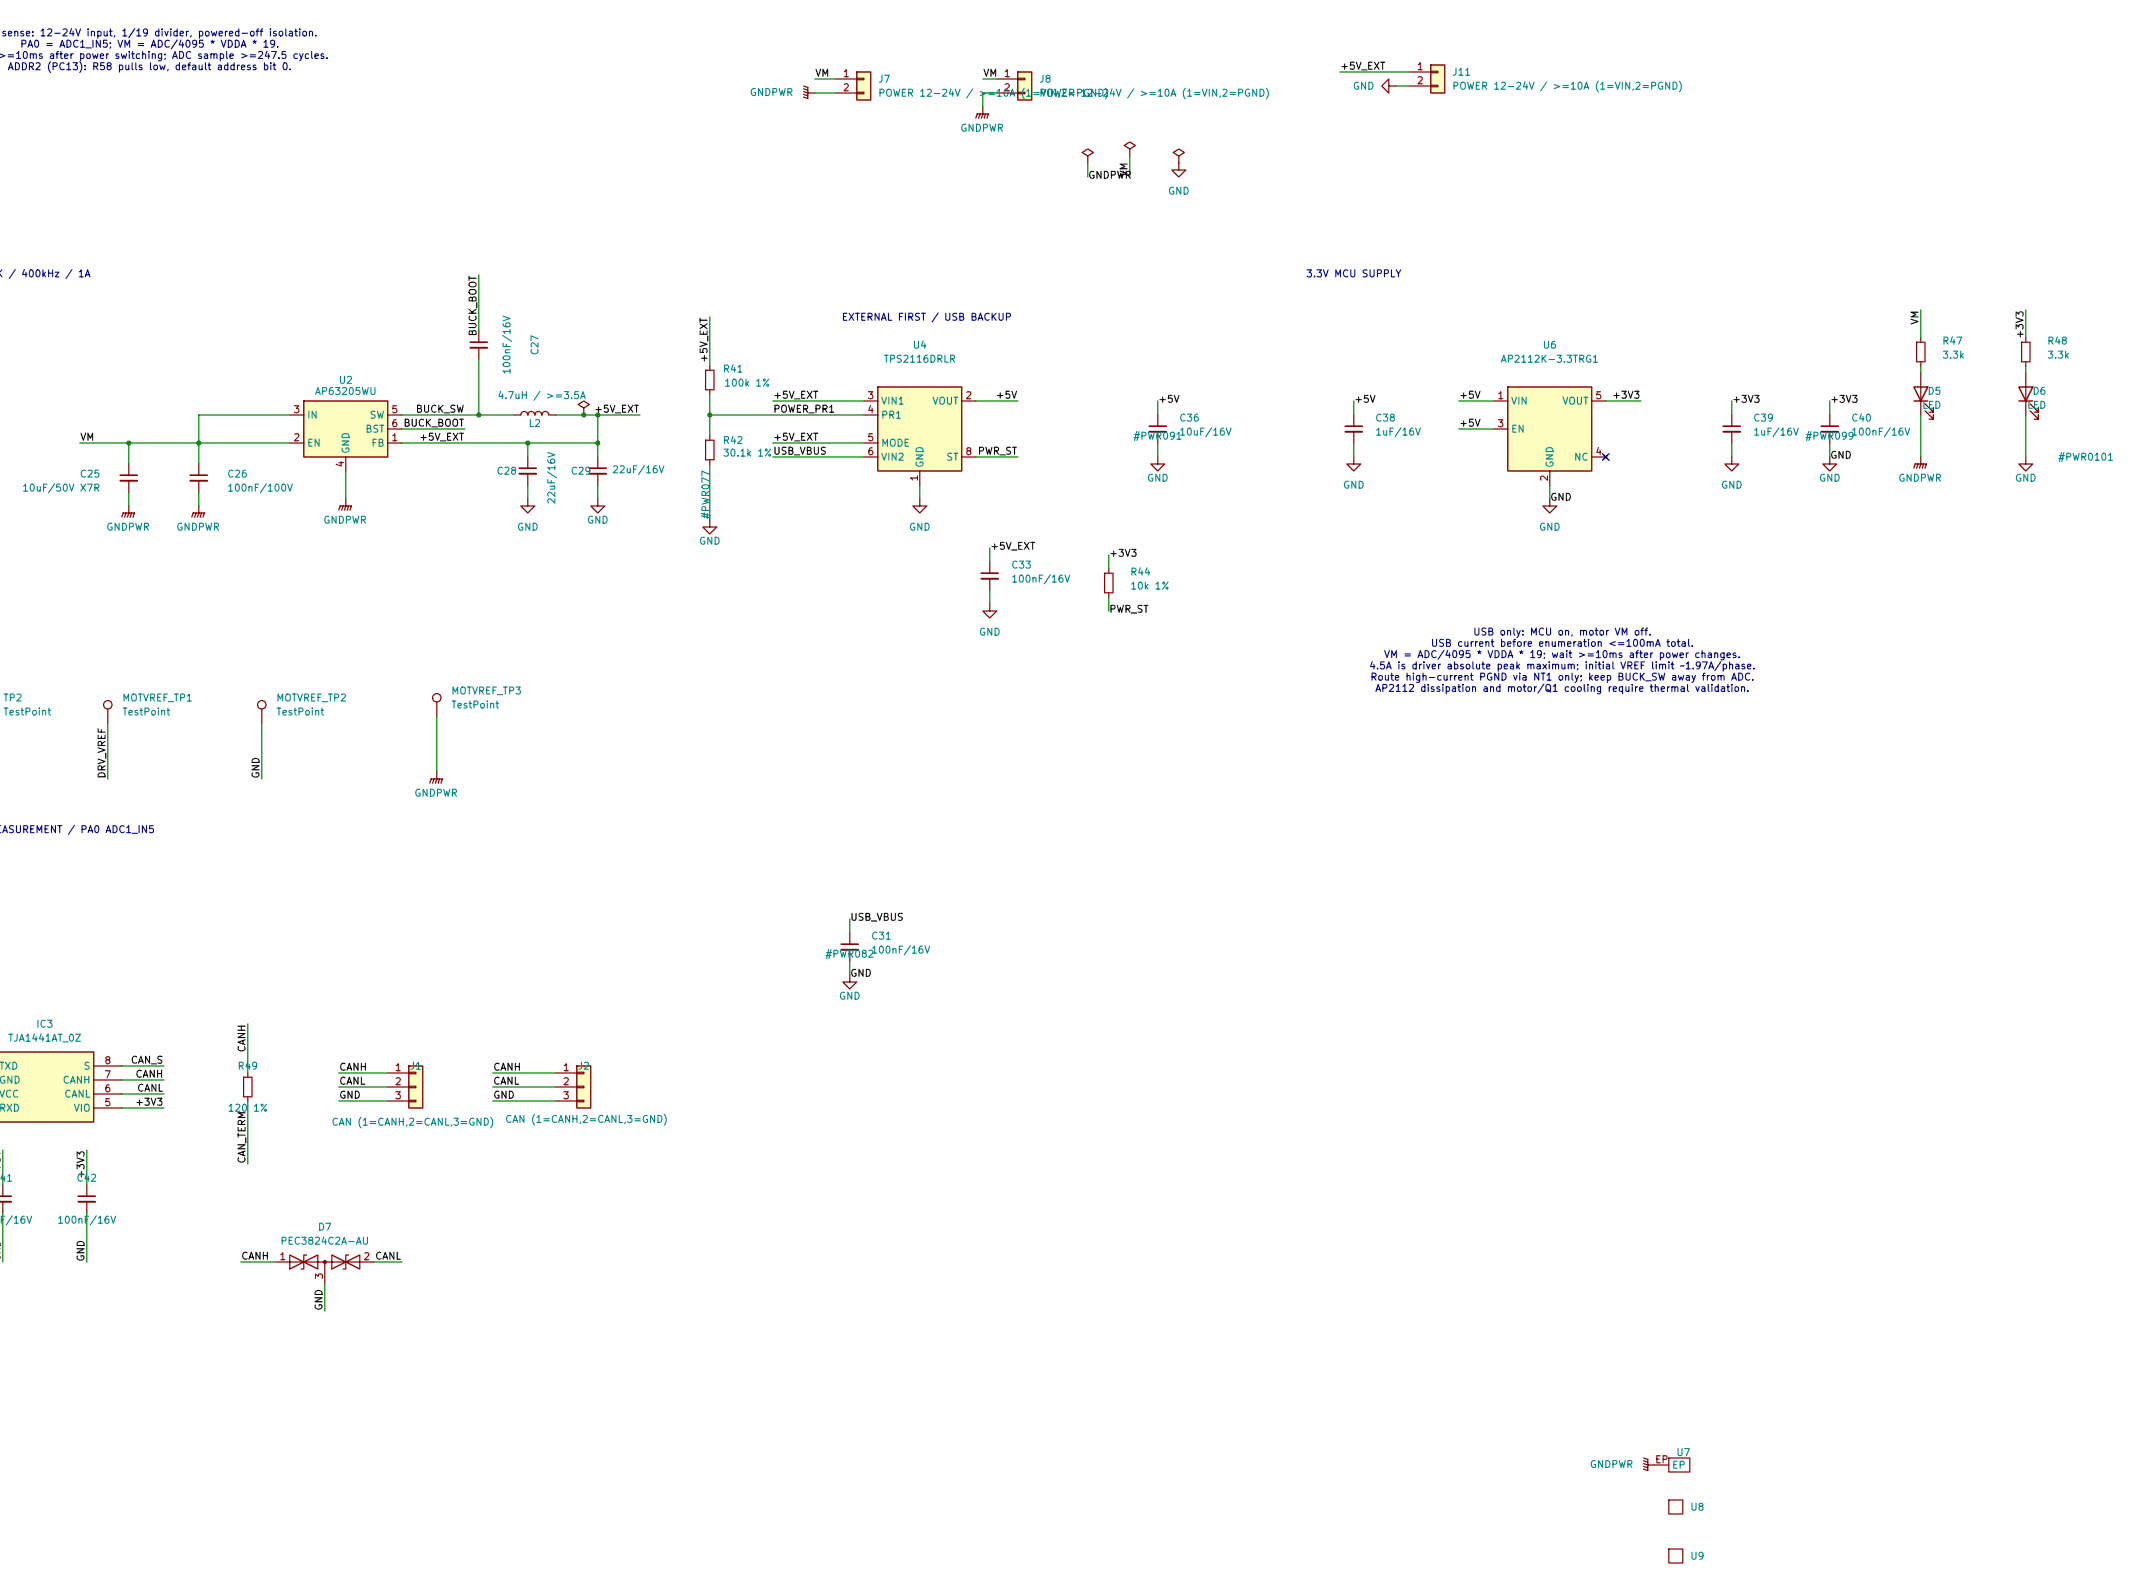
[picture p31: schematic schematic_NEMA23.kicad_sch, Stepper Motor Driver NEMA23, part in row 2, column 2]

Parts:
C1, C2, C3, C9: 0.1uF; R_0402_1005Metric
C4: 220uF 63V low ESR; CP_Radial_D10.0mm_P5.00mm
C6, C7: 100nF 100V X7R; C_0603_1608Metric
C8: 10uF 50V X7R; C_0805_2012Metric
C11, C14: 100nF 16V X7R; C_0402_1005Metric
C12: 270pF C0G; C_0402_1005Metric
C13, C15, C16: 0.1uF; R_0603_1608Metric
C17: 0.1uF; C_0603_1608Metric
C18: 4.7uF; C_0805_2012Metric
C19: 2.2uF; C_0603_1608Metric
C20, C22, C23, C31, C33, C40: 100nF/16V; C_0603_1608Metric
C21: 10nF/16V; C_0603_1608Metric
C24, C38, C39: 1uF/16V; C_0603_1608Metric
C25: 10uF/50V X7R; C_0805_2012Metric; Voltage 50V
C26: 100nF/100V; C_0603_1608Metric
C27: 100nF/16V; C_0805_2012Metric
C28, C29: 22uF/16V; C_0805_2012Metric
C30, C34: 100nF; C_0603_1608Metric
C32: 100nF/16V; R_0402_1005Metric
C35, C37: 1uF; C_0603_1608Metric
C36: 10uF/16V; C_0805_2012Metric
C41, C42: 100nF/16V; C_0402_1005Metric
D1, D2, D3, D4, D5, D6: LED; LED_0603_1608Metric
D7: PEC3824C2A-AU; SOT-23
IC1: TB67S249FTG,EL; QFN50P700X700X100-49N-D; Mouser Part Number 757-TB67S249FTGEL
IC2: STM32L433CCU6; QFN50P700X700X60-49N-D; Mouser Part Number 511-STM32L433CCU6
IC3: TJA1441AT_0Z; SOIC127P600X175-8N; Mouser Part Number 771-TJA1441AT/0Z
J1, J2: CAN (1=CANH,2=CANL,3=GND); JST_PH_B3B-PH-K_1x03_P2.00mm_Vertical; MPN B3B-PH-K-S
J3: MOTOR A+/A-/B-/B+; JST_XH_B4B-XH-A_1x04_P2.50mm_Vertical
J4: MOTOR A+/A-/B-/B+; 名称未設定_1
J5: SWD / SWO; JST_ZH_B6B-ZR_1x06_P1.50mm_Vertical
J6: 5077CR-16SMC2-BK-TR; NELTRON_5077CR-16SMC2-BK-TR; PARTREV B
J7: POWER 12-24V / >=10A (1=VIN,2=PGND); Conn_VM
J8: POWER 12-24V / >=10A (1=VIN,2=PGND); JST_VH_B2P-VH_1x02_P3.96mm_Vertical
J9: SENS I2C (3V3/GND/SCL/SDA); JST_PH_B4B-PH-K_1x04_P2.00mm_Vertical
J10: Conn_01x05; JST_ZH_B5B-ZR_1x05_P1.50mm_Vertical
J11: POWER 12-24V / >=10A (1=VIN,2=PGND); JST_PH_B2B-PH-K_1x02_P2.00mm_Vertical
L1: Ferrite 600R@100MHz / >=200mA; L_0603_1608Metric
L2: 4.7uH / >=3.5A; INDPM5552X300N; MPN XAL6060-472MEC
MOTVREF_TP1, MOTVREF_TP2: TestPoint; TestPoint_THTPad_D2.0mm_Drill1.0mm
MOTVREF_TP3: TestPoint; TestPoint_Pad_D1.5mm
NT1, NT2: PGND-GND STAR; NetTie-2_SMD_Pad0.5mm
R1, R4, R6, R23, R24, R26: 10k; R_0402_1005Metric
R8: 0; R_0402_1005Metric
R9, R13, R17, R22: DNP; R_0402_1005Metric
R12, R16, R20, R21: 100k 1%; R_0402_1005Metric
R14, R39, R40, R43: 4.7k; R_0402_1005Metric
R25, R27, R31, R35: 1k; R_0603_1608Metric
R28, R30, R33, R34, R44: 10k 1%; R_0402_1005Metric
R29, R45, R46: 5.1k 1%; R_0402_1005Metric
R32: 9.1k 1%/DNP; R_0402_1005Metric
R37: 180k 0.1%; R_0603_1608Metric
R38: 10k 0.1%; R_0603_1608Metric
R41: 100k 1%; R_0603_1608Metric
R42: 30.1k 1%; R_0603_1608Metric
R47, R48: 3.3k; R_0603_1608Metric
R49: 120 1%; R_0603_1608Metric
S1, S2, S3, S4: SKRKAEE020; Mouser Part Number 688-SKRKAEE020
SW2: KHS42E; SOIC-8_5.3x6.2mm_P1.27mm
TH1: Thermistor_NTC; R_0603_1608Metric
TP1, TP2: TestPoint; TestPoint_Pad_D1.5mm
U2: AP63205WU; TSOT-23-6; MPN AP63205WU-7
U3: USBLC6-2P6; SOT-666
U4: TPS2116DRLR; SOT-583-8; MPN TPS2116DRLR
U5: NCP360; TSOP-5_1.65x3.05mm_P0.95mm
U6: AP2112K-3.3TRG1; SOT-23-5; MPN AP2112K-3.3TRG1
U7: サーマルパッド
U8: MainBoard
U9: ヒートシンク30x30

Connections:
+3V3: C13.1, C15.1, C16.1, C18.1, C20.1, C22.1, C23.1, C24.1, C30.1, C39.1, C40.1, C42.1, IC2.1 (VBAT), IC2.24 (VDD_1), IC2.36 (VDDUSB), IC2.48 (VDD_2), IC3.5 (VIO), J5.1, J9.1, J10.1, L1.2, R1.1, R4.1, R14.1, R30.1, R33.1, R40.1, R43.1, R44.1, R48.1, S3.2, SW2.6, SW2.7, SW2.8, TP1.1 (1_1), U6.5 (VOUT)
/+5V: C36.1, C38.1, C41.1, IC3.3 (VCC), U4.2 (VOUT), U4.7 (VOUT), U6.1 (VIN), U6.3 (EN)
/+5V_EXT: C28.1, C29.1, C33.1, J11.1, L2.2, R41.1, U2.1 (FB), U4.3 (VIN1), U4.5 (MODE)
/ADDR0: IC2.5 (PH0-OSC_IN_(PH0)), R23.1, SW2.1
/ADDR1: IC2.6 (PH1-OSC_OUT_(PH1)), R24.1, SW2.2
/ADDR2: IC2.2 (PC13), R26.1, SW2.3
/AD_IN: IC2.17 (PA7), J10.5
/BUCK_BOOT: C27.1, U2.6 (BST)
/BUCK_SW: C27.2, L2.1, U2.5 (SW)
/CANH: D7.1 (A1), IC3.7 (CANH), J1.1, J2.1, R49.1
/CANL: D7.2 (A2), IC3.6 (CANL), J1.2, J2.2, SW2.5
/CAN_RX: IC2.45 (PB8), IC3.4 (RXD)
/CAN_S: IC2.4 (PC15-OSC32_OUT_(PC15)), IC3.8 (S)
/CAN_TERM: R49.2, SW2.4
/CAN_TX: IC2.46 (PB9), IC3.1 (TXD)
/DAC_VREF: IC2.14 (PA4), R34.2
/DRV_AGC0: IC1.1 (AGC0), IC2.21 (PB10)
/DRV_AGC1: IC1.2 (AGC1), IC2.22 (PB11)
/DRV_BOOST: IC1.6 (BOOST), R16.2, R17.1
/DRV_CLIM0: IC1.3 (CLIM0), R8.2, R9.1
/DRV_CLIM1: IC1.4 (CLIM1), R12.2, R13.1
/DRV_CLK: IC1.43 (CLK), IC2.29 (PA8)
/DRV_DIR: IC1.42 (CW/CCW), IC2.30 (PA9)
/DRV_DMODE0: IC1.39 (DMODE0), IC2.25 (PB12)
/DRV_DMODE1: IC1.40 (DMODE1), IC2.26 (PB13)
/DRV_DMODE2: IC1.41 (DMODE2), IC2.27 (PB14)
/DRV_EN: IC1.44 (ENABLE), IC2.31 (PA10), R28.1
/DRV_FLIM: IC1.5 (FLIM), R21.2, R22.1
/DRV_LO1: IC1.47 (LO1), IC2.12 (PA2), R30.2
/DRV_LO2: IC1.48 (LO2), IC2.13 (PA3), R33.2
/DRV_LTH: IC1.7 (LTH), R20.1
/DRV_OSCM: C12.1, IC1.35 (OSCM), R29.2
/DRV_RESET: IC1.45 (RESET), IC2.28 (PB15)
/DRV_VCC: C11.1, IC1.33 (VCC_1), IC1.34 (VCC_2), R8.1, R12.1, R16.1, R21.1, R29.1
/DRV_VREF: C14.1, IC1.31 (VREFB), IC1.32 (VREFA), MOTVREF_TP1.1 (1_1), R32.1, R34.1
/ENC_A_HOME1: IC2.38 (PA15_(JTDI)), J10.3
/ENC_B_HOME2: IC2.11 (PA1), J10.4
/I2C_SENS_SCL: IC2.42 (PB6), J9.3, R40.2
/I2C_SENS_SDA: IC2.43 (PB7), J9.4, R43.2
/LED_COMM: IC2.19 (PB1), R27.1
/LED_FAULT: IC2.20 (PB2), R35.1
/LED_MCU: IC2.18 (PB0), R25.1
/LED_RUN: IC2.15 (PA5), R31.1
/NRST: C1.1, IC2.7 (NRST), J5.5, S1.1
/OUTA_N: IC1.17 (OUTA-_1), IC1.18 (OUTA-_2), J3.2, J4.2
/OUTA_P: IC1.13 (OUTA+_1), IC1.14 (OUTA+_2), J3.1, J4.1
/OUTB_N: IC1.19 (OUTB-_1), IC1.20 (OUTB-_2), J3.3, J4.3
/OUTB_P: IC1.23 (OUTB+_1), IC1.24 (OUTB+_2), J3.4, J4.4
/PB8_BOOT: IC2.44 (PH3-BOOT0), R6.1, S3.1
/POWER_PR1: R41.2, R42.1, U4.4 (PR1)
/PWR_ST: IC2.3 (PC14-OSC32_IN_(PC14)), R44.2, U4.8 (ST)
/SWCLK: IC2.37 (PA14_(JTCK-SWCLK)), J5.4
/SWDIO: IC2.34 (PA13_(JTMS-SWDIO)), J5.2
/SWITCH1: C2.1, IC2.40 (PB4_(NJTRST)), R1.2, S2.1
/SWITCH2: C3.1, IC2.41 (PB5), R4.2, S4.1
/SWO: IC2.39 (PB3_(JTDO-TRACESWO)), J5.6
/TEMP: C9.1, IC2.16 (PA6), R14.2, TH1.1
/USB_CC1: J6.A5 (CC1), R45.1
/USB_CC2: J6.B5 (CC2), R46.1
/USB_PC_DM: J6.A7 (DN1), J6.B7 (DN2), U3.4 (I/O2)
/USB_PC_DM_MC: IC2.32 (PA11), U3.3 (I/O2)
/USB_PC_DP: J6.A6 (DP1), J6.B6 (DP2), U3.6 (I/O1)
/USB_PC_DP_MC: IC2.33 (PA12), U3.1 (I/O1)
/USB_VBUS: C31.1, C34.1, C37.1, U3.5 (VBUS), U4.6 (VIN2), U5.5 (OUT)
/USB_VBUS_SRC: C35.1, J6.A4_B9 (VBUS), J6.B4_A9 (VBUS), U5.1 (IN)
/VDDA: C17.1, C19.1, C21.1, IC2.9 (VDDA/VREF+), L1.1
/VM: C4.1, C6.1, C7.1, C8.1, C25.1, C26.1, IC1.10 (VMA_1), IC1.11 (VMA_2), IC1.26 (VMB_1), IC1.27 (VMB_2), J7.1, J8.1, R37.1, R47.1, TP2.1 (1_1), U2.2 (EN), U2.3 (IN)
/VM_DIV: R37.2, R38.1, R39.1
/VM_SENSE: C32.1, IC2.10 (PA0), R39.2
GND: C1.2, C2.2, C3.2, C9.2, C11.2, C12.2, C13.2, C14.2, C15.2, C16.2, C18.2, C20.2, C22.2, C23.2, C24.2, C28.2, C29.2, C30.2, C31.2, C33.2, C34.2, C35.2, C36.2, C37.2, C38.2, C39.2, C40.2, C41.2, C42.2, D1.1 (K), D2.1 (K), D3.1 (K), D4.1 (K), D6.1 (K), D7.3 (common), IC1.8 (GND_1), IC1.29 (GND_2), IC1.30 (GND_3), IC2.23 (VSS_1), IC2.35 (VSS_2), IC2.47 (VSS_3), IC2.49 (EP), IC3.2 (GND), J1.3, J2.3, J5.3, J6.A1_B12 (GND), J6.B1_A12 (GND), J6.S1 (SHIELD), J6.S2 (SHIELD), J6.S3 (SHIELD), J6.S4 (SHIELD), J9.2, J10.2, J11.2, MOTVREF_TP2.1 (1_1), NT1.2, NT2.1, R6.2, R9.2, R13.2, R17.2, R20.2, R22.2, R23.2, R24.2, R26.2, R28.2, R32.2, R42.2, R45.2, R46.2, S1.2, S2.2, S4.2, TH1.2, U3.2 (GND), U4.1 (GND), U5.2 (GND), U5.3 (~EN), U6.2 (GND)
GNDA: C17.2, C19.2, C21.2, C32.2, IC2.8 (VSSA/VREF-), NT2.2, R38.2
GNDPWR: C4.2, C6.2, C7.2, C8.2, C25.2, C26.2, D5.1 (K), IC1.15 (RSAGND_1), IC1.16 (RSAGND_2), IC1.21 (RSBGND_1), IC1.22 (RSBGND_2), IC1.49 (EP), J7.2, J8.2, MOTVREF_TP3.1 (1_1), NT1.1, U2.4 (GND), U7.EP (EP_EP)
unnamed: D1.2 (A), R25.2
unnamed: D2.2 (A), R27.2
unnamed: D3.2 (A), R31.2
unnamed: D4.2 (A), R35.2
unnamed: D5.2 (A), R47.2
unnamed: D6.2 (A), R48.2

Notes on the sheet:
COMM STATUS (HIGH = ON)
LO1/LO2/MO pull-ups: +3V3_D only (external digital 3.3V supply). VM and +3V3_D supplied by power circuitry outside this specification.
NT1: single PGND-GND copper connection directly beneath IC2 exposed pad. EP/corner pads to GND, dense thermal vias; 4 layers / 2oz. Motor outputs: 5A routing.
POWER INPUT 12-24V (J6) / reverse polarity + transient protection
SW4: 1=ADDR0, 2=ADDR1, 3=ADDR2. OFF=0 / ON=1. ADDR0=PH0, ADDR1=PH1, ADDR2=PC13. GPIO inputs, no internal pull; HSE must stay OFF. Read at boot: ID = ADDR0 + 2*ADDR1 + 4*ADDR2 (0-7).
USB only: MCU on, motor VM off. USB current before enumeration <=100mA total. VM = ADC/4095 * VDDA * 19; wait >=10ms after power changes. 4.5A is driver absolute peak maximum; initial VREF limit ~1.97A/phase. Route high-current PGND via NT1 only; keep BUCK_SW away from ADC. AP2112 dissipation and m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
MCU STATUS (HIGH = ON)
AGC straps: R50=0; R52/R54/R56=100k; R51/R53/R55/R57=DNP. CLIM1/BOOST/FLIM pull-ups must use DRV_VCC, never +3V3_D.
USB FS DEVICE / SELF-POWERED USB_VBUS isolated from board +5V (no backfeed). PA9: GPIO VBUS detect; enable USB only with VBUS. VDDUSB = +3V3; enable PWR_CR2.USV in firmware. Internal D+ pull-up / termination. 90-ohm differential PCB pair.
OSCM: R23=5.1k, C20=270pF; ~67kHz. Place close to pin35. DRV_VCC: internal 5V, setting circuits only.
5V BUCK / 400kHz / 1A
STM32L433 IC4 <-> TB67S249 IC2 - stm32l433_tb67s249_connection.md
EXTERNAL FIRST / USB BACKUP
3.3V MCU SUPPLY
VREF: R29=10k series, R30=9.1k to GND, C21=100nF. 3.3V DAC full scale -> VREF 1.57V -> IOUT 1.97A. R30/C21 GND return near pins29/30, away from OUT/VM.
RUN / ACTIVITY (MCU, HIGH = ON)
BOOT0 uses existing boot switch/pulldown (PB8_BOOT net name is legacy). Use HSI/MSI internal clock for USB standalone startup.
A=PA15/TIM2_CH1, B=PA1/TIM2_CH2 (AF1). 3.3V logic; GPIO/EXTI for home inputs. Use MCU pull-ups for dry contact/open-drain sensors.
AS5600 external sensor / 3.3V I2C STM32 I2C1: PB6=SCL, PB7=SDA (AF4) J5: 1=3V3, 2=GND, 3=SCL, 4=SDA Fit one set of pull-ups on the bus.
J8: 1=3V3 VTref, 2=SWDIO, 3=GND 4=SWCLK, 5=NRST, 6=SWO VTref: target voltage sense, no debugger power injection.
FAULT (MCU, HIGH = ON)
MCU: internal HSI/MSI; USB HSI48 + CRS/SOF. PH0/PH1: no external HSE. PC14/PC15 are GPIO, no LSE. BOOT0 = PH3 pin44 (PB8_BOOT); PB8 pin45 = DRV_AGC0. VDDA/VREF+ share pin9; disable VREFBUF output. C38: VBAT 100nF; C39: VDDA 10nF; C40: VDDUSB 1uF. Place bypass capacitors close to their assigned MCU 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
Firmware: DAC1_OUT1 PA4 buffer enabled; reference VDDA/VREF+ (+3V3_A). Buffered DAC may retain ~0.2V: ENABLE Low or disable DAC for zero current. Startup: check VM -> set DAC -> set DMODE -> wait >=7.5us -> ENABLE High. Reset: ENABLE/DMODE/AGC Low; evaluate initially with AGC0=AGC1=Low.
VM sense: 12-24V input, 1/19 divider, powered-off isolation. PA0 = ADC1_IN5; VM = ADC/4095 * VDDA * 19. Wait >=10ms after power switching; ADC sample >=247.5 cycles. ADDR2 (PC13): R58 pulls low, default address bit 0.
VM capacitors: C15 bulk 220uF/63V; C16 at VMA; C17 at VMB; C18 10uF/50V. Keep VM-PGND loops short; paired pins joined at IC on PCB.
VM MEASUREMENT / PA0 ADC1_IN5

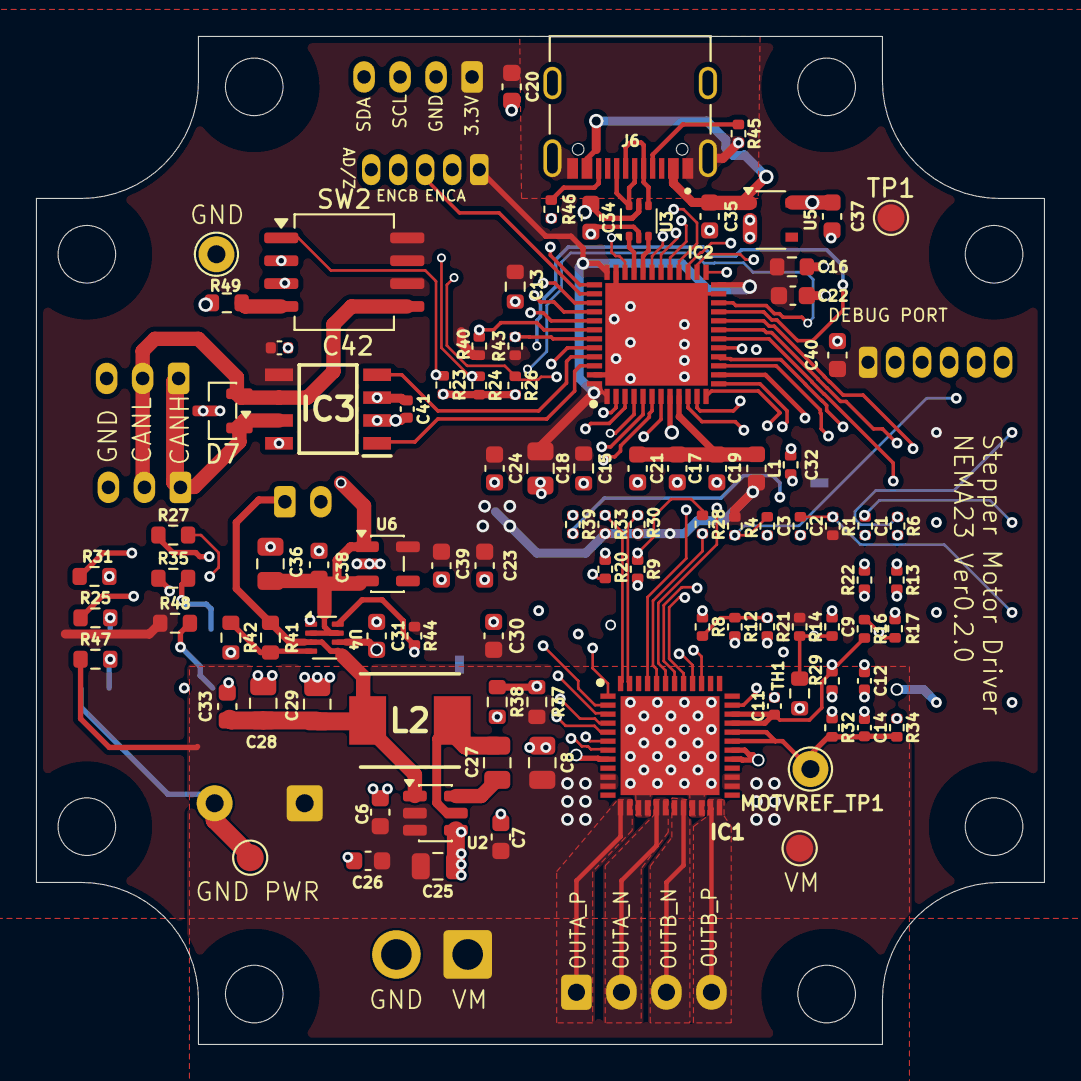
[picture p32: board schematic_NEMA23.kicad_pcb from above]

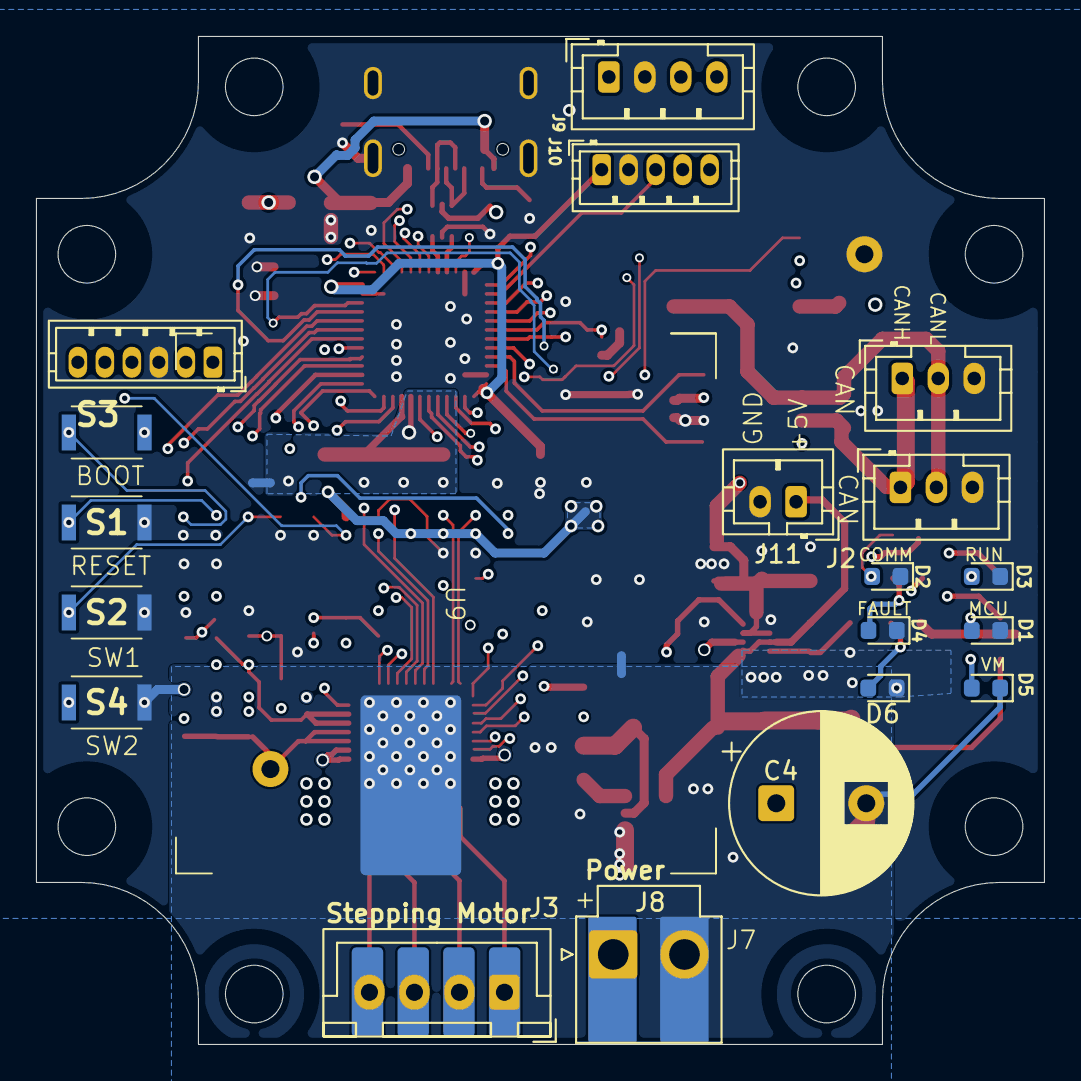
[picture p33: board schematic_NEMA23.kicad_pcb from below]

Board: 4 copper layers, 56.0 x 56.0 mm, 123 parts (25 on the bottom side), 78 nets.
