rx178nwj/StepperMotorDriver-Node/schematic_NEMA23/review/jlcpcb-4layer/settings-import/routing-settings.kicad_pcb

## KiCad design schematic_NEMA23/review/jlcpcb-4layer/settings-import/routing-settings.kicad_pcb (2026-10-18)

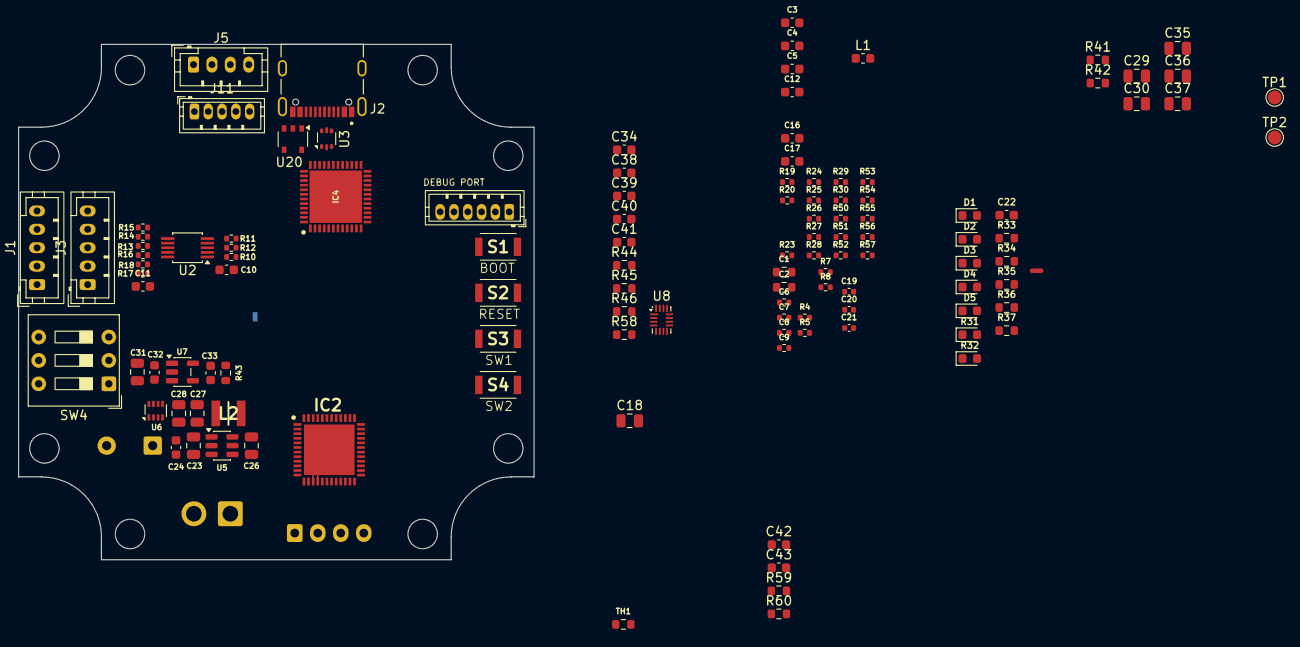
[picture p34: board routing-settings.kicad_pcb from above]

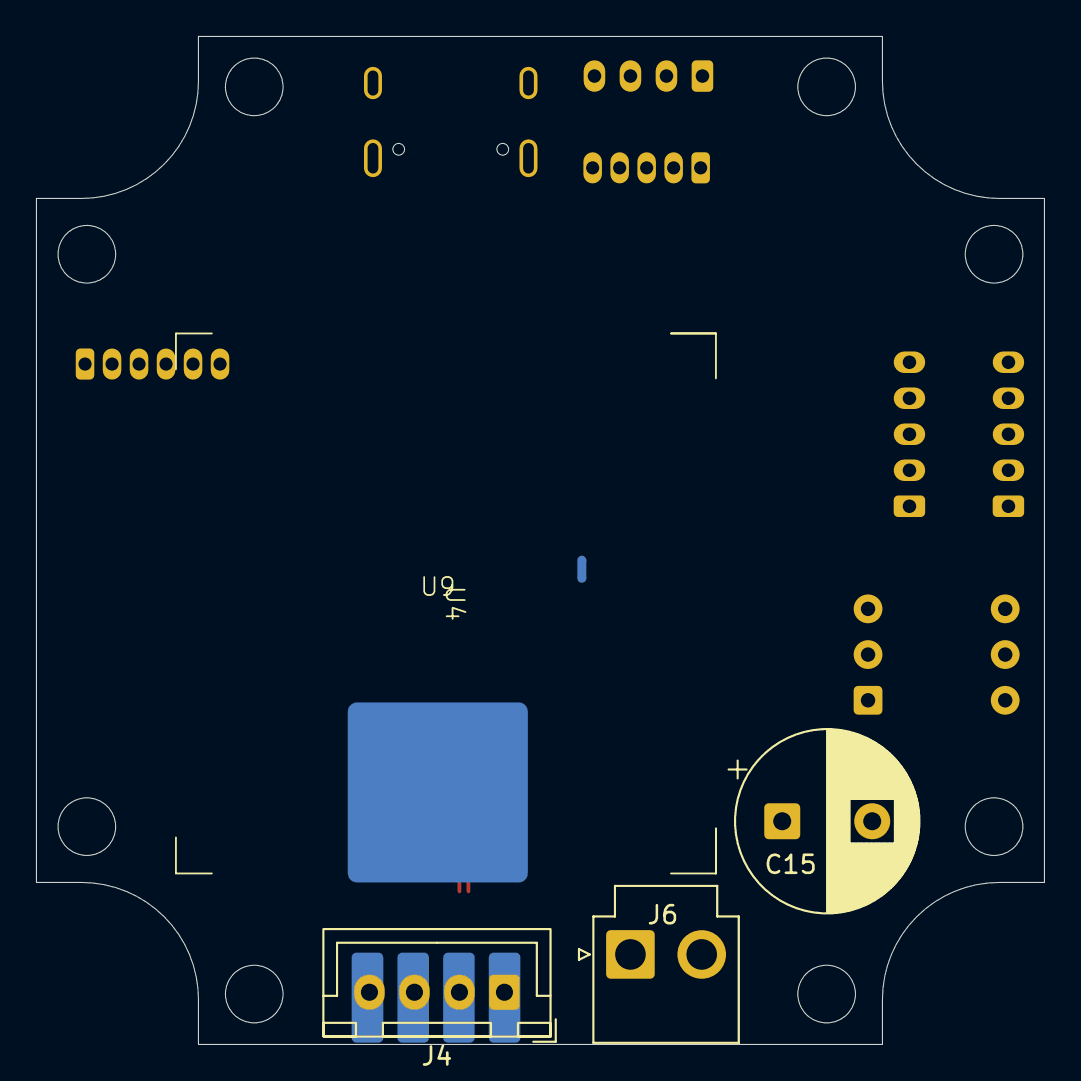
[picture p35: board routing-settings.kicad_pcb from below]

Board: 4 copper layers, 56.0 x 56.0 mm, 125 parts (7 on the bottom side), 78 nets.

Parts:
C1, C2: 0.1uF; R_0603_1608Metric
C3: 4.7uF; C_0603_1608Metric
C4: 2.2uF; C_0603_1608Metric
C5, C10, C11: 0.1uF; C_0603_1608Metric
C6, C7, C8, C9: 0.1uF; R_0402_1005Metric
C12, C22: 100nF; C_0603_1608Metric
C15: 220uF 63V low ESR; CP_Radial_D10.0mm_P5.00mm
C16, C17: 100nF 100V X7R; C_0603_1608Metric
C18: 10uF 50V X7R; C_0805_2012Metric
C19, C21: 100nF 16V X7R; C_0402_1005Metric
C20: 270pF C0G; C_0402_1005Metric
C23: 10uF/50V X7R; C_0805_2012Metric
C24: 100nF/100V; C_0603_1608Metric
C26, C29, C30, C35, C36, C37: 100nF/16V; C_0805_2012Metric
C27, C28: 22uF/16V; C_0805_2012Metric
C31: 10uF/16V; C_0805_2012Metric
C32, C33, C40: 1uF/16V; C_0603_1608Metric
C34, C38, C41: 100nF/16V; C_0603_1608Metric
C39: 10nF/16V; C_0603_1608Metric
C42, C43: 1uF; C_0603_1608Metric
D1, D2, D3, D4, D5: LED; LED_0603_1608Metric
IC2: TB67S249FTG,EL; QFN50P700X700X100-49N-D
IC4: STM32L433CCU6; QFN50P700X700X60-49N-D
J1, J3: Conn_01x05; JST_PH_B5B-PH-K_1x05_P2.00mm_Vertical
J2: 5077CR-16SMC2-BK-TR; NELTRON_5077CR-16SMC2-BK-TR
J4: MOTOR A+/A-/B-/B+; JST_XH_B4B-XH-A_1x04_P2.50mm_Vertical
J5: SENS I2C (3V3/GND/SCL/SDA); JST_PH_B4B-PH-K_1x04_P2.00mm_Vertical
J6: POWER 12-24V / >=10A (1=VIN,2=PGND); JST_VH_B2P-VH_1x02_P3.96mm_Vertical
J7: MOTOR A+/A-/B-/B+; 名称未設定_1
J8: SWD / SWO; JST_ZH_B6B-ZR_1x06_P1.50mm_Vertical
J11: Conn_01x05; JST_ZH_B5B-ZR_1x05_P1.50mm_Vertical
L1: Ferrite 600R@100MHz / >=200mA; L_0603_1608Metric
L2: 4.7uH / >=3.5A; DFE322520FD1R0MP2
NT1, NT2: PGND-GND STAR; NetTie-2_SMD_Pad0.5mm
R4, R5, R8, R12: 10k; R_0402_1005Metric
R7, R10, R11: 4.7k; R_0402_1005Metric
R13, R15, R16, R18: 600/DNP; R_0402_1005Metric
R14, R17: 120/DNP; R_0402_1005Metric
R19, R20, R23: 5.1k 1%; R_0402_1005Metric
R24, R52, R54, R56: 100k 1%; R_0402_1005Metric
R25, R26, R27, R28, R29: 10k 1%; R_0402_1005Metric
R30: 9.1k 1%; R_0402_1005Metric
R31, R32: 4.7k; LED_0603_1608Metric
R33, R34, R35, R37: 1k; R_0603_1608Metric
R36: 3.3k; R_0603_1608Metric
R41: 100k 1%; R_0603_1608Metric
R42: 30.1k 1%; R_0603_1608Metric
R43: 10k 1%; R_0603_1608Metric
R44: 180k 0.1%; R_0603_1608Metric
R45: 10k 0.1%; R_0603_1608Metric
R46: 4.7k; R_0603_1608Metric
R50: 0; R_0402_1005Metric
R51, R53, R55, R57: DNP; R_0402_1005Metric
R58, R59, R60: 10k; R_0603_1608Metric
S1, S2, S3, S4: SKRKAEE020
SW4: KSD32; SW_DIP_SPSTx03_Slide_9.78x9.8mm_W7.62mm_P2.54mm
TH1: Thermistor_NTC; R_0603_1608Metric
TP1, TP2: TestPoint; TestPoint_Pad_D1.5mm
U1: MainBoard
U2: PCA9615DP; TSSOP-10_3x3mm_P0.5mm
U3: USBLC6-2P6; SOT-666
U4: ヒートシンク30x30
U5: AP63205WU; TSOT-23-6
U6: TPS2116DRLR; SOT-583-8
U7: AP2112K-3.3TRG1; SOT-23-5
U8: TMUX1511RSVR; UQFN-16_1.8x2.6mm_P0.4mm
U9: サーマルパッド
U20: NCP360; TSOP-5_1.65x3.05mm_P0.95mm

Connections:
+3V3: C1.1, C2.1, C3.1, C10.1, C22.1, C33.1, C35.1, C36.1, C37.1, C38.1, C40.1, C41.1, IC4.1 (VBAT), IC4.24 (VDD_1), IC4.36 (VDDUSB), IC4.48 (VDD_2), J5.1, J8.1, J11.1, L1.2, R4.1, R5.1, R7.1, R10.1, R11.1, R12.1, R26.1, R27.1, R28.1, R31.1, R32.1, R43.1, S1.2, SW4.4, SW4.5, SW4.6, U2.1 (V_{DD(A)}), U7.5 (VOUT), U8.1 (SEL1), U8.16 (VDD)
/+5V: C11.1, C31.1, C32.1, R13.1, R16.1, U2.10 (V_{DD(B)}), U6.2 (VOUT), U6.7 (VOUT), U7.1 (VIN), U7.3 (EN)
/+5V_EXT: C27.1, C28.1, C29.1, L2.2, R41.1, U5.1 (FB), U6.3 (VIN1), U6.5 (MODE)
/ADDR0: IC4.5 (PH0-OSC_IN_(PH0)), R59.1, SW4.1
/ADDR1: IC4.6 (PH1-OSC_OUT_(PH1)), R60.1, SW4.2
/ADDR2: IC4.2 (PC13), R58.1, SW4.3
/AD_IN: IC4.17 (PA7), J11.5
/BUCK_BOOT: C26.1, U5.6 (BST)
/BUCK_SW: C26.2, L2.1, U5.5 (SW)
/DAC_VREF: IC4.14 (PA4), R29.2
/DI2C_SCL_M: J1.4, J3.4, R14.2, R15.1, U2.6 (DSCLM)
/DI2C_SCL_P: J1.3, J3.3, R13.2, R14.1, U2.7 (DSCLP)
/DI2C_SDA_M: J1.2, J3.2, R17.2, R18.1, U2.9 (DSDAM)
/DI2C_SDA_P: J1.1, J3.1, R16.2, R17.1, U2.8 (DSDAP)
/DRV_AGC0: IC2.1 (AGC0), IC4.45 (PB8)
/DRV_AGC1: IC2.2 (AGC1), IC4.46 (PB9)
/DRV_BOOST: IC2.6 (BOOST), R54.2, R55.1
/DRV_CLIM0: IC2.3 (CLIM0), R50.2, R51.1
/DRV_CLIM1: IC2.4 (CLIM1), R52.2, R53.1
/DRV_CLK: IC2.43 (CLK), IC4.29 (PA8)
/DRV_DIR: IC2.42 (CW/CCW), IC4.30 (PA9)
/DRV_DMODE0: IC2.39 (DMODE0), IC4.25 (PB12)
/DRV_DMODE1: IC2.40 (DMODE1), IC4.26 (PB13)
/DRV_DMODE2: IC2.41 (DMODE2), IC4.27 (PB14)
/DRV_EN: IC2.44 (ENABLE), IC4.31 (PA10), R25.1
/DRV_FLIM: IC2.5 (FLIM), R56.2, R57.1
/DRV_LO1: IC2.47 (LO1), IC4.12 (PA2), R26.2
/DRV_LO2: IC2.48 (LO2), IC4.13 (PA3), R27.2
/DRV_LTH: IC2.7 (LTH), R24.1
/DRV_MO: IC2.46 (MO), IC4.4 (PC15-OSC32_OUT_(PC15)), R28.2
/DRV_OSCM: C20.1, IC2.35 (OSCM), R23.2
/DRV_RESET: IC2.45 (RESET), IC4.28 (PB15)
/DRV_VCC: C19.1, IC2.33 (VCC_1), IC2.34 (VCC_2), R23.1, R50.1, R52.1, R54.1, R56.1
/DRV_VREF: C21.1, IC2.31 (VREFB), IC2.32 (VREFA), R29.1, R30.1, TP2.1 (1_1)
/ENC_A_HOME1: IC4.38 (PA15_(JTDI)), J11.3
/ENC_B_HOME2: IC4.11 (PA1), J11.4
/I2C_PC_SCL: IC4.21 (PB10), R11.2, U2.4 (SCL)
/I2C_PC_SDA: IC4.22 (PB11), R10.2, U2.2 (SDA)
/I2C_SENS_SCL: IC4.42 (PB6), J5.3, R31.2
/I2C_SENS_SDA: IC4.43 (PB7), J5.4, R32.2
/LED_COMM: IC4.19 (PB1), R37.1
/LED_FAULT: IC4.20 (PB2), R34.1
/LED_MCU: IC4.18 (PB0), R35.1
/LED_RUN: IC4.15 (PA5), R33.1
/NRST: C6.1, IC4.7 (NRST), J8.5, S2.1
/OUTA_N: IC2.17 (OUTA-_1), IC2.18 (OUTA-_2), J4.2, J7.2
/OUTA_P: IC2.13 (OUTA+_1), IC2.14 (OUTA+_2), J4.1, J7.1
/OUTB_N: IC2.19 (OUTB-_1), IC2.20 (OUTB-_2), J4.3, J7.3
/OUTB_P: IC2.23 (OUTB+_1), IC2.24 (OUTB+_2), J4.4, J7.4
/PB8_BOOT: IC4.44 (PH3-BOOT0), R8.1, S1.1
/PCA9615_EN: R12.2, U2.3 (EN)
/POWER_PR1: R41.2, R42.1, U6.4 (PR1)
/PWR_ST: IC4.3 (PC14-OSC32_IN_(PC14)), R43.2, U6.8 (ST)
/SWCLK: IC4.37 (PA14_(JTCK-SWCLK)), J8.4
/SWDIO: IC4.34 (PA13_(JTMS-SWDIO)), J8.2
/SWITCH1: C7.1, IC4.40 (PB4_(NJTRST)), R4.2, S3.1
/SWITCH2: C8.1, IC4.41 (PB5), R5.2, S4.1
/SWO: IC4.39 (PB3_(JTDO-TRACESWO)), J8.6
/TEMP: C9.1, IC4.16 (PA6), R7.2, TH1.1
/USB_CC1: J2.A5 (CC1), R19.1
/USB_CC2: J2.B5 (CC2), R20.1
/USB_PC_DM: IC4.32 (PA11), J2.A7 (DN1), J2.B7 (DN2), U3.3 (I/O2), U3.4 (I/O2)
/USB_PC_DP: IC4.33 (PA12), J2.A6 (DP1), J2.B6 (DP2), U3.1 (I/O1), U3.6 (I/O1)
/USB_VBUS: C12.1, C30.1, C43.1, U3.5 (VBUS), U6.6 (VIN2), U20.5 (OUT)
/USB_VBUS_SRC: C42.1, J2.A4_B9 (VBUS), J2.B4_A9 (VBUS), U20.1 (IN)
/VDDA: C4.1, C5.1, C39.1, IC4.9 (VDDA/VREF+), L1.1
/VM: C15.1, C16.1, C17.1, C18.1, C23.1, C24.1, IC2.10 (VMA_1), IC2.11 (VMA_2), IC2.26 (VMB_1), IC2.27 (VMB_2), J6.1, R36.1, R44.1, TP1.1 (1_1), U5.2 (EN), U5.3 (IN)
/VM_DIV: R44.2, R45.1, U8.2 (S1)
/VM_SENSE: C34.1, IC4.10 (PA0), R46.2
/VM_SENSE_ISO: R46.1, U8.3 (D1)
GND: C1.2, C2.2, C3.2, C6.2, C7.2, C8.2, C9.2, C10.2, C11.2, C12.2, C19.2, C20.2, C21.2, C22.2, C23.2, C24.2, C27.2, C28.2, C29.2, C30.2, C31.2, C32.2, C33.2, C35.2, C36.2, C37.2, C38.2, C40.2, C41.2, C42.2, C43.2, D1.1 (K), D2.1 (K), D3.1 (K), D5.1 (K), IC2.8 (GND_1), IC2.29 (GND_2), IC2.30 (GND_3), IC4.23 (VSS_1), IC4.35 (VSS_2), IC4.47 (VSS_3), IC4.49 (EP), J1.5, J2.A1_B12 (GND), J2.B1_A12 (GND), J2.S1 (SHIELD), J2.S2 (SHIELD), J2.S3 (SHIELD), J2.S4 (SHIELD), J3.5, J5.2, J8.3, J11.2, NT1.2, NT2.1, R8.2, R15.2, R18.2, R19.2, R20.2, R24.2, R25.2, R30.2, R42.2, R51.2, R53.2, R55.2, R57.2, R58.2, R59.2, R60.2, S2.2, S3.2, S4.2, TH1.2, U2.5 (V_{SS}), U3.2 (GND), U5.4 (GND), U6.1 (GND), U7.2 (GND), U8.4 (SEL2), U8.5 (S2), U8.8 (GND), U8.10 (S3), U8.11 (SEL3), U8.14 (S4), U8.15 (SEL4), U20.2 (GND), U20.3 (~EN)
GNDA: C4.2, C5.2, C34.2, C39.2, IC4.8 (VSSA/VREF-), NT2.2, R45.2
GNDPWR: C15.2, C16.2, C17.2, C18.2, D4.1 (K), IC2.15 (RSAGND_1), IC2.16 (RSAGND_2), IC2.21 (RSBGND_1), IC2.22 (RSBGND_2), IC2.49 (EP), J6.2, NT1.1, U9.EP (EP_EP)
unnamed: D1.2 (A), R33.2
unnamed: D2.2 (A), R34.2
unnamed: D3.2 (A), R35.2
unnamed: D4.2 (A), R36.2
unnamed: D5.2 (A), R37.2
