rx178nwj/StepperMotorDriver-Node/firmware/Src/main.c

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
/* Includes ------------------------------------------------------------------*/
#include "main.h"
#include "usb_device.h"

/* USER CODE BEGIN Includes */
#include "app_main.h"
#include "bootjump.h"
#include "diag.h"

/* USER CODE END Includes */


/* USER CODE BEGIN PV */
extern uint8_t _end;     /* リンカスクリプト: .bss/.noinit の終端（スタック塗りつぶしの下端） */
extern uint8_t _estack;  /* RAM の上端（スタックの上端） */

/* USER CODE END PV */

void SystemClock_Config(void);
/**
  * @brief  The application entry point.
  * @retval int
  */
int main(void)
{

  /* USER CODE BEGIN 1 */
  bootjump_check();   /* ENTER_BOOTLOADER 後のリセットなら、IWDG・クロックの初期化前に ROM へ移る（FR-BL-04） */

  /* USER CODE END 1 */

  /* MCU Configuration--------------------------------------------------------*/

  /* Reset of all peripherals, Initializes the Flash interface and the Systick. */
  HAL_Init();

  /* Configure the system clock */
  SystemClock_Config();

  /* USER CODE BEGIN SysInit */
  diag_set_reset_csr(RCC->CSR);        /* リセット要因（診断値）。次回のリセット要因と区別するためクリアする */
  __HAL_RCC_CLEAR_RESET_FLAGS();
  /* 現在の SP より 512 バイト下までを塗る（SysTick 割り込みのフレームが limit より上に収まる余裕） */
  diag_stack_init((uint32_t *)&_end, (uint32_t *)(__get_MSP() - 512u), (uint32_t *)&_estack);

  /* USER CODE END SysInit */

  /* Initialize all configured peripherals */
  MX_USB_DEVICE_Init();
  /* USER CODE BEGIN 2 */
  app_main_init();

  /* USER CODE END 2 */

  /* Infinite loop */
  /* USER CODE BEGIN WHILE */
  while (1)
  {
    /* USER CODE END WHILE */

    /* USER CODE BEGIN 3 */
    app_main_loop();
  }
  /* USER CODE END 3 */
}

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
