rx178nwj/StepperMotorDriver-Node/firmware/App/Inc/config.h

/*
 * config.h — 回路定数・保護しきい値・既定値
 * 「暫定」と付いたものは docs/requirements.md 5章の未確定事項。
 */
#ifndef CONFIG_H
#define CONFIG_H

#define FW_VERSION_MAJOR        0
#define FW_VERSION_MINOR        4
#define DEVICE_ID               0xA3

/* ---- クロック ---- */
#define SYSCLK_HZ               80000000UL
#define STEP_TIMER_HZ           80000000UL   /* TIM1 (APB2 = 80 MHz) */

/* ---- VREF / 電流設定 ----
 * 分圧なし: PA4(DAC) → R34 10k（直列、C14 と RC フィルタ）→ VREFA/B。R32 は未実装。
 * IOUT = VREF × 1.25。DAC バッファ出力は約 0.2 V〜VDDA−0.2 V（約 250〜3870 mA 相当）。 */
#define VREF_DIV_RATIO          1.0f         /* VREF / V_DAC */
#define DRV_VREF_GAIN_A_PER_V   1.25f
#define DAC_OUT_MIN_MV          200u         /* バッファ有効時の下限 */
#define CURRENT_MIN_MA          250u         /* = DAC_OUT_MIN_MV × 1.25 */
#define CURRENT_LIMIT_MA        3000u        /* 3A モータ、J3(XH) 3A 定格に合わせた上限 */

/* ---- VM 計測（R37 180k / R38 10k → ×19） ---- */
#define VM_DIVIDER_RATIO        19.0f
#define VM_OK_MIN_MV            10500u
#define VM_OK_MAX_MV            28000u
#define VM_HYST_MV              500u
#define VM_STABLE_MS            50u          /* 投入後この時間安定したら起動 */
#define VM_FAULT_SAMPLES        2u           /* 励磁中の範囲外連続回数（10 ms 周期） */

/* ---- 基板温度（+3V3 → R14 4.7k → TEMP → NTC → GND） ---- */
#define NTC_PULLUP_OHM          4700.0f
#define NTC_R25_OHM             10000.0f     /* Murata NCP18XH103F03RB */
#define NTC_BETA                3434.0f      /* B25/85（保護しきい値付近で精度を優先。B25/50 = 3380） */
#define BOARD_TEMP_WARN_DC      700          /* 0.1 °C 単位 */
#define BOARD_TEMP_FAULT_DC     800
#define TEMP_INVALID            ((int16_t)0x8000)

/* ---- CAN（bxCAN、CAN 2.0A）----
 * ビットレートは 125000 / 250000 / 500000 / 1000000 から選ぶ（暫定 500 kbit/s、要求仕様 U-1）。
 * 1 ビット = 16 tq（SYNC 1 + BS1 13 + BS2 2、サンプル点 87.5%）、SJW = 1 tq。 */
#define CAN_BITRATE_BPS         500000UL
#define CAN_PCLK_HZ             80000000UL   /* APB1 = 80 MHz */
#define CAN_TQ_PER_BIT          16UL
#define CAN_PRESCALER           (CAN_PCLK_HZ / (CAN_BITRATE_BPS * CAN_TQ_PER_BIT))
#if (CAN_PRESCALER < 1UL) || (CAN_PRESCALER > 1024UL) || \
    ((CAN_PRESCALER * CAN_BITRATE_BPS * CAN_TQ_PER_BIT) != CAN_PCLK_HZ)
#error "CAN_BITRATE_BPS cannot be generated exactly from CAN_PCLK_HZ with 16 tq/bit"
#endif

/* CAN ID（要求仕様 FR-COM-03）。ID = DIP 値 0〜7 */
#define CAN_ID_BROADCAST        0x000u       /* 上位 → 全台 */
#define CAN_ID_FAULT_BASE       0x080u       /* 基板 → 上位（異常通知）+ ID */
#define CAN_ID_REQUEST_BASE     0x100u       /* 上位 → 基板（要求）+ ID */
#define CAN_ID_RESPONSE_BASE    0x180u       /* 基板 → 上位（応答）+ ID */

#define COMM_LED_ERR_BLINK_MS   500u         /* エラーパッシブ／バスオフ中の LED_COMM 点滅周期（2 Hz） */

/* ---- モーション ---- */
#define STEP_RATE_MAX           100000u      /* step/s */
#define STEP_PULSE_NS           1000u        /* CLK High 幅 (データシート最小 500 ns) */
#define CURRENT_SETTLE_MS       5u           /* 保持→運転電流切替後の待ち（R34×C14 = 1 ms の約 5 倍） */
#define DRV_WAKE_US             20u          /* スタンバイ解除後の待ち（データシート 7.5 µs） */
#define LO_ARM_DELAY_MS         5u           /* 起動直後の LO 判定マスク */

/* ---- 工場出荷値（保存設定がない場合。未知のモータでも安全な電流にしている） ---- */
#define DEF_RUN_CURRENT_MA      1000u
#define DEF_HOLD_CURRENT_MA     500u
#define DEF_MICROSTEP           16u
#define DEF_FLAGS               0x02u        /* bit1 ローカルジョグ有効 */
#define DEF_MAX_SPEED           3200u
#define DEF_ACCEL               16000u
#define DEF_DECEL               16000u
#define DEF_START_SPEED         200u
#define DEF_JOG_SPEED           1600u
#define DEF_HOLD_DELAY_MS       500u
#define DEF_STEPS_PER_REV       200u         /* 1.8°/step */
#define DEF_GEAR_RATIO          20u          /* 出力軸 1 回転あたりのモータ回転数（U-11） */
#define DEF_SENSOR_OFFSET       0u
#define DEF_PA7_MODE            1u           /* 1 = DIR（AS5600 の DIR ピンを駆動） */
#define DEF_J10_MODE            0u           /* 0 = 未使用（PA15/PA1 はアナログ入力） */
#define DEF_HOME_SPEED          800u         /* 原点復帰の探索速度 [step/s] */

/* ---- 出力軸の位置センサ AS5600（I2C1、要求仕様 3.10 節）---- */
#define GEAR_RATIO_MAX          1000u
#define SENSOR_OFFSET_MAX       4095u
#define PA7_MODE_AD_IN          0u
#define PA7_MODE_DIR            1u
#define PA7_MODE_Z              2u
#define AS5600_ADDR7            0x36u
/* I2C1 は PCLK1 = 80 MHz。PRESC=3（tPRESC 50 ns）、SCLL=0x1B（28 単位）、SCLH=0x12（19 単位）、SCLDEL=7、SDADEL=1 で SCL 約 380 kHz
 * （tLOW 1.4 µs、tHIGH 0.95 µs、データセットアップ 400 ns）。CubeMX 生成の Timing（0x00000E14）は
 * 80 MHz では約 2 MHz になるため使わず、position_init で上書きする。要実機確認 */
#define POS_I2C_TIMING          0x3071121Bu
#define POS_I2C_TIMEOUT_US      500u         /* 1 トランザクション全体の上限（バス復帰を含めて 1 ms 未満） */
#define POS_FAIL_LIMIT          3u           /* 連続失敗でセンサ無効 */
#define POS_RETRY_MS            1000u        /* 無効の間の再接続周期 */

/* ---- J10（PA15/PA1）の ENC・HOME 入力（要求仕様 3.12 節）---- */
/* ENC のデジタルフィルタ（TIM2_CCMR1 の IC1F/IC2F）。TIM2 は APB1 タイマクロック 80 MHz、CKD=00 で fDTS = 80 MHz。
 * 0b1001 = fSAMPLING = fDTS/8（10 MHz）で 8 サンプル連続一致 → 0.8 µs 以上続いた変化だけを通す。
 * 各相 200 kHz（FR-ENC-02）は 50% デューティで 1 レベルが 2.5 µs、A/B の位相差 1.25 µs なので、
 * フィルタの遅延（0.8 µs）は両相に同じにかかって位相関係を保ち、2.5 µs の幅は通る（余裕約 3 倍）。
 * 0.8 µs 未満のノイズは除く。0b1011（fDTS/16、8 サンプル）は 1.6 µs で 200 kHz の余裕が小さいため使わない */
#define ENC_FILTER_ICF          0x9u
#define HOME_CONFIRM_SAMPLES    2u           /* HOME 入力の確定に必要な連続一致回数（1 ms 周期。FR-HOME-02） */

/* ---- ブートローダ移行（要求仕様 3.13 節）---- */
#define BOOT_FLAG_MAGIC         0xB007DF11u  /* 移行フラグ（.noinit の 32bit）。一致したときだけ ROM ブートローダへ移る */
#define BOOT_KEY                0x544F4F42u  /* ENTER_BOOTLOADER の KEY（"BOOT"） */
#define BOOT_TX_WAIT_MS         50u          /* ACK の送信完了を待つ上限 */

#endif /* CONFIG_H */
