rx178nwj/StepperMotorDriver-Node/firmware/App/Src/app.c

#include "app.h"
#include "board.h"
#include "comm.h"
#include "config.h"
#include "drv.h"
#include "home.h"
#include "j10.h"
#include "monitor.h"
#include "position.h"
#include "settings.h"
#include "stepper.h"
#include "symtab.h"
#include "ui.h"
#include <string.h>

#define FLAG_INVERT_DIR  SETTINGS_FLAG_INVERT_DIR
#define FLAG_LOCAL_JOG   SETTINGS_FLAG_LOCAL_JOG
#define CHORD_HOLD_MS    2000u

static settings_t cfg;

/* CONFIG_STATUS レジスタ */
#define CFG_ST_LOADED      (1u << 0)   /* 起動時に保存設定を読み込んだ */
#define CFG_ST_DIRTY       (1u << 1)   /* 未保存の変更あり */
#define CFG_ST_SAVE_FAILED (1u << 2)   /* 直前の保存に失敗 */
#define CFG_ST_SANITIZED   (1u << 3)   /* 保存値が範囲外で補正した */
static uint8_t cfg_status;

static app_state_t state = APP_NO_VM;
static app_state_t prev_state = APP_NO_VM;   /* 異常通知用: 前回の tick での状態 */
static uint8_t fault_bits;
static volatile uint8_t isr_fault;
static uint8_t cmd_result;
static uint8_t board_id;
static uint32_t now;
static uint8_t status_snapshot;   /* STATUS レジスタの値（1 ms 周期で更新。USB の名前表で公開） */

/* 位置センサ（3.10 節） */
static bool sensor_synced;             /* SENSOR_STATUS bit4: SYNC_POSITION 実行済み */
static bool sensor_auto_done;          /* FR-POS-09: 起動後に最初にセンサが有効になったときの判断を済ませた */
static uint8_t sensor_status_snapshot; /* SENSOR_STATUS レジスタの値（10 ms 周期。USB の名前表で公開） */
static uint16_t shaft_angle_snapshot;  /* SHAFT_ANGLE レジスタの値（10 ms 周期。USB の名前表で公開） */

static monitor_values_t mon = { .vdda_mv = 3300u, .board_temp_dc = TEMP_INVALID, .ad_in_mv = 0xFFFFu };
/* J10（3.12 節）。INPUT_STATUS レジスタ（0x1E）と ENC_COUNT（0x5C）は読み出しのたびに作る */
static home_t home;                /* 原点復帰の状態機械（home.c） */
static bool limit_stopped;         /* INPUT_STATUS bit5: リミットで停止した（次に受け付けた移動指令で 0） */
/* USB のメモリ読み出しはペリフェラル領域を読めない（FR-USB-31）ので、端子・TIM2 を読む値と関数で組み立てる値は
 * 周期処理で RAM に写して名前表で公開する */
static uint8_t input_status_snapshot;   /* INPUT_STATUS レジスタ（0x1E）の値。1 ms 周期（home 状態機械・HOME 入力と同じ周期） */
static int32_t enc_count_snapshot;      /* ENC_COUNT レジスタ（0x5C）の値。TIM2->CNT を 1 ms 周期で写す */
static uint8_t agc_snapshot;            /* AGC0/AGC1 の出力レベル（1 = 両方 High）。GPIO の ODR を 10 ms 周期で写す（変わるのは EN=Low の間だけ） */

static bool vm_ok;
static uint32_t vm_good_ms;
static uint8_t vm_bad_count;
static uint8_t vm_bad_reason;
static bool temp_warn;

static bool lo_armed;
static uint32_t lo_arm_at;

static bool hold_active;
static uint32_t idle_since;
static uint32_t start_allowed_at;

static int8_t jog_dir;
static bool jog_rejected;   /* jog_dir のジョグはリミット・原点復帰中のため拒否した（動かしていない） */
static bool chord_done;
static uint32_t chord_since;

static inline bool time_reached(uint32_t t)
{
    return (int32_t)(now - t) >= 0;
}

/* ---------------------------------------------------------------- 状態遷移 */

static void apply_stepper_params(void)
{
    stepper_params_t p = {
        .max_speed = (float)cfg.max_speed,
        .accel = (float)cfg.accel,
        .decel = (float)cfg.decel,
        .start_speed = (float)cfg.start_speed,
        .invert_dir = (cfg.flags & FLAG_INVERT_DIR) != 0,
    };
    stepper_set_params(&p);
}

/* 保存値（RAM の設定）の AGC を端子へ出す。EN=Low の間だけ呼ぶ（FR-AGC-03） */
static void agc_apply(void)
{
    drv_set_agc((cfg.flags & SETTINGS_FLAG_AGC) != 0);
}

static void driver_wake(void)
{
    agc_apply();   /* スタンバイを解除する前に AGC を設定する（FR-AGC-03） */
    drv_set_current_ma(cfg.hold_current_ma, mon.vdda_mv);
    drv_wake(cfg.microstep);
    lo_armed = false;
    lo_arm_at = now + LO_ARM_DELAY_MS;
}

static void driver_sleep(void)
{
    drv_enable(false);
    agc_apply();   /* ENABLED 中の LOAD・FACTORY で変えた AGC は、EN=Low になったここで反映する */
    stepper_estop();
    home_abort(&home);   /* FAULT・VM 異常による原点復帰の中止（FR-HOME-06） */
    drv_standby();
    drv_set_current_min();
    lo_armed = false;
}

app_state_t app_get_state(void)
{
    return state;
}

void app_enter_safe_state(void)
{
    driver_sleep();
}

static void enter_fault(uint8_t bits)
{
    driver_sleep();
    fault_bits |= bits;
    jog_dir = 0;
    jog_rejected = false;
    state = APP_FAULT;
}

/* LO1/LO2 割り込み（EXTI、優先度 IRQ_PRIO_FAULT） */
void app_on_driver_fault_isr(drv_fault_t f)
{
    drv_enable(false);
    stepper_estop();
    isr_fault |= (uint8_t)f;
}

static uint8_t cmd_enable(void)
{
    if (state != APP_DISABLED) {
        return RESULT_REJECTED;
    }
    drv_set_current_ma(cfg.run_current_ma, mon.vdda_mv);
    hold_active = false;
    idle_since = now;
    start_allowed_at = now + CURRENT_SETTLE_MS;
    drv_enable(true);
    state = APP_ENABLED;
    return RESULT_OK;
}

static uint8_t cmd_disable(void)
{
    if (state != APP_ENABLED) {
        return RESULT_REJECTED;
    }
    stepper_estop();
    home_abort(&home);   /* DISABLE による原点復帰の中止（FR-HOME-06） */
    drv_enable(false);
    agc_apply();   /* ENABLED 中の LOAD・FACTORY で変えた AGC は、EN=Low になったここで反映する */
    jog_dir = 0;
    jog_rejected = false;
    state = APP_DISABLED;
    return RESULT_OK;
}

static uint8_t cmd_clear_fault(void)
{
    if (state != APP_FAULT) {
        return RESULT_REJECTED;
    }
    if (mon.board_temp_dc != TEMP_INVALID && mon.board_temp_dc >= BOARD_TEMP_WARN_DC) {
        return RESULT_REJECTED;   /* 冷えるまで解除しない */
    }
    fault_bits = 0;
    if (vm_ok) {
        driver_wake();            /* スタンバイ経由でドライバのラッチも解除済み */
        state = APP_DISABLED;
    } else {
        state = APP_NO_VM;
    }
    return RESULT_OK;
}

static uint8_t cmd_reset_angle(void)
{
    if (!drv_is_awake() || stepper_is_running() || home_is_active(&home)) {
        return RESULT_REJECTED;
    }
    drv_pulse_reset();
    return RESULT_OK;
}

static bool motion_idle(void);
static void apply_settings(void);

/* SYNC_POSITION（FR-POS-06）。POSITION をセンサの出力軸角度から設定する */
static uint8_t cmd_sync_position(void)
{
    if (stepper_is_running() || home_is_active(&home)) {
        return RESULT_REJECTED;
    }
    if (!position_valid()) {
        return RESULT_FAILED;
    }
    uint16_t a = position_axis_count(position_raw(), cfg.sensor_offset);
    int32_t pos;
    if (!position_sync_steps(a, cfg.gear_ratio, cfg.steps_per_rev, cfg.microstep, &pos)) {
        return RESULT_INVALID;   /* 1 回転分のステップ数が 32bit に収まらない */
    }
    if (!stepper_set_position(pos)) {
        return RESULT_REJECTED;
    }
    sensor_synced = true;
    return RESULT_OK;
}

static uint8_t cmd_save(void)
{
    if (!motion_idle()) {
        return RESULT_REJECTED;   /* Flash 消去中は CPU が止まるため */
    }
    if (!settings_save(&cfg)) {
        cfg_status |= CFG_ST_SAVE_FAILED;
        return RESULT_FAILED;
    }
    cfg_status &= (uint8_t)~(CFG_ST_DIRTY | CFG_ST_SAVE_FAILED);
    return RESULT_OK;
}

static uint8_t cmd_load(bool factory)
{
    if (!motion_idle()) {
        return RESULT_REJECTED;
    }
    settings_t t;
    if (factory) {
        settings_defaults(&t);
    } else if (!settings_load(&t)) {
        return RESULT_FAILED;     /* 保存設定なし */
    } else if (settings_sanitize(&t)) {
        cfg_status |= CFG_ST_SANITIZED;
    }
    cfg = t;
    if (factory) {
        cfg_status |= CFG_ST_DIRTY;   /* 保存するまで Flash は以前のまま */
    } else {
        cfg_status &= (uint8_t)~CFG_ST_DIRTY;
    }
    apply_settings();
    return RESULT_OK;
}

/* ---------------------------------------------------------------- 原点・リミット（3.12.3 節） */

/* J10_MODE=2 で、dir 方向（＋1 = HOME1 側、−1 = HOME2 側）のリミットが作動中か。dir=0 は常に false */
static bool limit_active(int dir)
{
    if (cfg.j10_mode != J10_MODE_HOME) {
        return false;
    }
    return dir > 0 ? j10_home1_active() : (dir < 0 ? j10_home2_active() : false);
}

/* 移動指令・ジョグを受け付けてよいか（FR-HOME-04、FR-HOME-06）。dir は移動方向（POSITION の増減。0 = 動かさない） */
static bool move_allowed(int dir)
{
    return !home_is_active(&home) && !limit_active(dir);
}

static int sign32(int64_t v)
{
    return v > 0 ? 1 : (v < 0 ? -1 : 0);
}

static home_in_t home_inputs(void)
{
    home_in_t in = {
        .home1 = j10_home1_active(),
        .home2 = j10_home2_active(),
        .moving = stepper_is_running() || stepper_has_pending(),
        .position = stepper_position(),
    };
    return in;
}

static void home_apply(home_out_t o)
{
    switch (o.action) {
    case HOME_ACT_RUN:
        stepper_run(o.speed);
        break;
    case HOME_ACT_ESTOP:
        stepper_estop();
        break;
    case HOME_ACT_SET_ZERO:
        /* 原点復帰の完了で POSITION を再定義する。SET_POSITION と同じく自動 SYNC の対象外になる（FR-HOME-07） */
        if (!stepper_set_position(0)) {
            home_abort(&home);
        }
        break;
    default:
        break;
    }
}

/* HOME_NEG（side = -1）・HOME_POS（side = +1）（FR-HOME-05） */
static uint8_t cmd_home(int8_t side)
{
    if (state != APP_ENABLED || !motion_idle() || cfg.j10_mode != J10_MODE_HOME) {
        return RESULT_REJECTED;
    }
    home_params_t p = {
        .home_speed = cfg.home_speed,
        .max_speed = cfg.max_speed,
        .start_speed = cfg.start_speed,
        .limit_steps = (uint32_t)cfg.steps_per_rev * cfg.microstep,
    };
    home_in_t in = home_inputs();
    home_apply(home_start(&home, side, &p, &in));
    limit_stopped = false;   /* 原点復帰も移動指令の一種: 古いリミット停止の bit5 を残さない */
    return RESULT_OK;
}

static uint8_t command(uint8_t c)
{
    switch (c) {
    case CMD_ENABLE:           return cmd_enable();
    case CMD_DISABLE:          return cmd_disable();
    case CMD_STOP:             stepper_stop(); home_abort(&home); return RESULT_OK;
    case CMD_ESTOP:            stepper_estop(); home_abort(&home); return RESULT_OK;
    case CMD_CLEAR_FAULT:      return cmd_clear_fault();
    case CMD_RESET_ELEC_ANGLE: return cmd_reset_angle();
    case CMD_SAVE_SETTINGS:    return cmd_save();
    case CMD_LOAD_SETTINGS:    return cmd_load(false);
    case CMD_FACTORY_SETTINGS: return cmd_load(true);
    case CMD_SYNC_POSITION:    return cmd_sync_position();
    case CMD_HOME_NEG:         return cmd_home(-1);
    case CMD_HOME_POS:         return cmd_home(1);
    default:                   return RESULT_INVALID;
    }
}

/* ---------------------------------------------------------------- レジスタ */

static uint16_t rd16(const uint8_t *p) { return (uint16_t)(p[0] | (p[1] << 8)); }
static uint32_t rd32(const uint8_t *p)
{
    return (uint32_t)p[0] | ((uint32_t)p[1] << 8) | ((uint32_t)p[2] << 16) | ((uint32_t)p[3] << 24);
}
static void wr16(uint8_t *p, uint16_t v) { p[0] = (uint8_t)v; p[1] = (uint8_t)(v >> 8); }
static void wr32(uint8_t *p, uint32_t v)
{
    p[0] = (uint8_t)v; p[1] = (uint8_t)(v >> 8); p[2] = (uint8_t)(v >> 16); p[3] = (uint8_t)(v >> 24);
}

typedef struct {
    uint8_t addr;
    uint8_t size;
} reg_def_t;

/* 書き込み可能レジスタ（アドレス昇順。設定 → 動作指令 → COMMAND の順に反映される） */
static const reg_def_t writable[] = {
    {0x20, 2}, {0x22, 2}, {0x24, 1}, {0x25, 1}, {0x26, 2},
    {0x28, 4}, {0x2C, 4}, {0x30, 4}, {0x34, 4}, {0x38, 4}, {0x3C, 2}, {0x3E, 2},
    {0x40, 4}, {0x44, 4}, {0x48, 4}, {0x4C, 4}, {0x50, 1},
    {0x54, 2}, {0x56, 2}, {0x58, 1}, {0x59, 1}, {0x5A, 2},
};

/* 停止中（パルス出力なし、起動待ちなし、原点復帰中でない）。各段の切り替えで一瞬パルスが止まる原点復帰中も含めない */
static bool motion_idle(void)
{
    return !stepper_is_running() && !stepper_has_pending() && !home_is_active(&home);
}

/* 設定をドライバ・プランナへ反映（何度呼んでもよい） */
static void apply_settings(void)
{
    apply_stepper_params();
    position_pa7_set(cfg.pa7_mode, (cfg.flags & SETTINGS_FLAG_SENSOR_DIR) != 0);
    j10_set_mode(cfg.j10_mode);   /* J10_MODE に合わせて PA15/PA1 を切り替える（同じモードなら何もしない） */
    /* AGC は EN=Low の間だけ端子へ出す。ENABLED 中（LOAD・FACTORY のみここへ来る）は RAM の設定だけ変え、
     * 端子は次に EN=Low になったとき（cmd_disable・driver_sleep）に agc_apply で反映する */
    if (state != APP_ENABLED) {
        agc_apply();
    }
    if (drv_is_awake()) {
        drv_wake(cfg.microstep);   /* 起床中は DMODE の書き換えのみ */
        bool run = state == APP_ENABLED && !hold_active;
        drv_set_current_ma(run ? cfg.run_current_ma : cfg.hold_current_ma, mon.vdda_mv);
    }
}

/* 設定レジスタ 1 項目の書き込み。範囲外は反映しない */
static uint8_t write_setting(uint8_t addr, const uint8_t *p)
{
    settings_t t = cfg;
    switch (addr) {
    case 0x20: t.run_current_ma = rd16(p); break;
    case 0x22: t.hold_current_ma = rd16(p); break;
    case 0x24: t.microstep = p[0]; break;
    case 0x25: t.flags = p[0]; break;
    case 0x26: t.comm_timeout_ms = rd16(p); break;
    case 0x28: t.max_speed = rd32(p); break;
    case 0x2C: t.accel = rd32(p); break;
    case 0x30: t.decel = rd32(p); break;
    case 0x34: t.start_speed = rd32(p); break;
    case 0x38: t.jog_speed = rd32(p); break;
    case 0x3C: t.hold_delay_ms = rd16(p); break;
    case 0x3E: t.steps_per_rev = rd16(p); break;
    case 0x54: t.gear_ratio = rd16(p); break;
    case 0x56: t.sensor_offset = rd16(p); break;
    case 0x58: t.pa7_mode = p[0]; break;
    case 0x59: t.j10_mode = p[0]; break;
    case 0x5A: t.home_speed = rd16(p); break;
    default: return RESULT_INVALID;
    }
    if (settings_sanitize(&t)) {
        return RESULT_INVALID;
    }
    if (t.microstep != cfg.microstep && !motion_idle()) {
        return RESULT_REJECTED;   /* 位置の単位が変わるため停止中のみ */
    }
    if (addr == 0x59 && !motion_idle()) {
        return RESULT_REJECTED;   /* J10_MODE は停止中のみ（FR-J10-02） */
    }
    if (addr == 0x25 && ((t.flags ^ cfg.flags) & SETTINGS_FLAG_AGC) && state == APP_ENABLED) {
        return RESULT_REJECTED;   /* ENABLED 中は AGC を変えない。FLAGS 全体を反映しない（FR-AGC-03） */
    }
    if (memcmp(&t, &cfg, sizeof t) != 0) {
        cfg = t;
        cfg_status |= CFG_ST_DIRTY;
        apply_settings();
    }
    return RESULT_OK;
}

static uint8_t write_reg(uint8_t addr, const uint8_t *p)
{
    switch (addr) {
    case 0x40: {
        int32_t target = (int32_t)rd32(p);
        /* 方向は目標位置と現在位置の差で決める（FR-HOME-04） */
        if (state != APP_ENABLED || !move_allowed(sign32((int64_t)target - stepper_position()))) return RESULT_REJECTED;
        stepper_move_to(target);
        limit_stopped = false;
        return RESULT_OK;
    }
    case 0x44: {
        int32_t delta = (int32_t)rd32(p);
        if (state != APP_ENABLED || !move_allowed(sign32(delta))) return RESULT_REJECTED;
        stepper_move_by(delta);
        limit_stopped = false;
        return RESULT_OK;
    }
    case 0x48: {
        int32_t speed = (int32_t)rd32(p);
        if (speed == 0) {
            /* 0 は停止指令なので、原点復帰中・リミット作動中でも受け付ける（移動指令ではないので bit5 も変えない） */
            if (state != APP_ENABLED) return RESULT_REJECTED;
            stepper_run(0);
            home_abort(&home);   /* 減速停止なので STOP と同じく原点復帰を中止する */
            return RESULT_OK;
        }
        if (state != APP_ENABLED || !move_allowed(sign32(speed))) return RESULT_REJECTED;
        stepper_run(speed);
        limit_stopped = false;
        return RESULT_OK;
    }
    case 0x4C:
        if (home_is_active(&home)) return RESULT_REJECTED;
        return stepper_set_position((int32_t)rd32(p)) ? RESULT_OK : RESULT_REJECTED;
    case 0x50:
        return command(p[0]);
    default:
        return write_setting(addr, p);
    }
}

/* 完全に含まれるレジスタだけ反映（32bit 値の部分書き込みは反映せず RESULT_INVALID） */
uint8_t app_reg_write(uint8_t reg, const uint8_t *d, uint8_t len)
{
    uint32_t base = reg;
    uint32_t n = len;
    uint32_t covered = 0;
    uint8_t result = RESULT_OK;

    for (uint32_t i = 0; i < sizeof writable / sizeof writable[0]; i++) {
        uint32_t a = writable[i].addr;
        if (a >= base && a + writable[i].size <= base + n) {
            uint8_t r = write_reg((uint8_t)a, d + (a - base));
            if (r != RESULT_OK) result = r;
            covered += writable[i].size;
        }
    }
    if (covered != n) {
        result = RESULT_INVALID;   /* 部分書き込み・書き込み不可・未定義アドレスのバイトを含む */
    }
    cmd_result = result;
    return result;
}

void app_broadcast_command(uint8_t cmd)
{
    (void)command(cmd);
}

static uint8_t status_bits(void)
{
    uint8_t s = 0;
    if (stepper_is_running() || home_is_active(&home)) s |= 1u << 0;   /* 原点復帰中は各段の切り替えでパルスが止まる間も 1 */
    /* bit1 は予約（常に 0。MO は廃止） */
    if (board_pwr_external())                      s |= 1u << 2;
    if (ui_sw1())                                  s |= 1u << 3;
    if (ui_sw2())                                  s |= 1u << 4;
    if (temp_warn)                                 s |= 1u << 5;
    if (hold_active && state == APP_ENABLED)       s |= 1u << 6;
    if (stepper_at_target())                       s |= 1u << 7;
    return s;
}

static uint8_t sensor_status_bits(void)
{
    uint8_t s = position_status_bits();
    if (sensor_synced) s |= 1u << 4;
    return s;
}

/* INPUT_STATUS（0x1E）。bit0〜1 は J10_MODE=2 のときだけ確定した作動状態（それ以外は j10 が false を返す） */
static uint8_t input_status_bits(void)
{
    uint8_t s = 0;
    if (j10_home1_active())     s |= 1u << 0;
    if (j10_home2_active())     s |= 1u << 1;
    if (home_is_active(&home))  s |= 1u << 2;
    if (home_is_done(&home))    s |= 1u << 3;
    if (home_is_failed(&home))  s |= 1u << 4;
    if (limit_stopped)          s |= 1u << 5;
    return s;
}

/* 読み出し要求のたびにその場でレジスタイメージを作る（main ループ内なので 1 フレーム分は一貫した値） */
void app_reg_read(uint8_t reg, uint8_t len, uint8_t *out)
{
    uint8_t m[REG_MAP_SIZE];
    memset(m, 0, sizeof m);
    m[0x00] = DEVICE_ID;
    m[0x01] = FW_VERSION_MAJOR;
    m[0x02] = FW_VERSION_MINOR;
    m[0x03] = board_id;
    m[0x04] = (uint8_t)state;
    m[0x05] = fault_bits;
    m[0x06] = status_bits();
    m[0x07] = cmd_result;
    wr32(&m[0x08], (uint32_t)stepper_position());
    wr32(&m[0x0C], (uint32_t)stepper_speed());
    wr16(&m[0x10], (uint16_t)(mon.vm_mv > 0xFFFFu ? 0xFFFFu : mon.vm_mv));
    wr16(&m[0x12], (uint16_t)mon.board_temp_dc);
    wr16(&m[0x14], (uint16_t)mon.mcu_temp_dc);
    wr16(&m[0x16], cfg.pa7_mode == PA7_MODE_AD_IN ? (uint16_t)mon.ad_in_mv : 0xFFFFu);
    m[0x18] = cfg_status;
    m[0x19] = sensor_status_bits();
    wr16(&m[0x1A], position_raw());
    wr16(&m[0x1C], position_shaft_angle(position_raw(), cfg.sensor_offset));
    m[0x1E] = input_status_bits();
    /* 0x1F は予約（0） */
    wr16(&m[0x20], cfg.run_current_ma);
    wr16(&m[0x22], cfg.hold_current_ma);
    m[0x24] = cfg.microstep;
    m[0x25] = cfg.flags;
    wr16(&m[0x26], cfg.comm_timeout_ms);
    wr32(&m[0x28], cfg.max_speed);
    wr32(&m[0x2C], cfg.accel);
    wr32(&m[0x30], cfg.decel);
    wr32(&m[0x34], cfg.start_speed);
    wr32(&m[0x38], cfg.jog_speed);
    wr16(&m[0x3C], cfg.hold_delay_ms);
    wr16(&m[0x3E], cfg.steps_per_rev);
    wr16(&m[0x54], cfg.gear_ratio);
    wr16(&m[0x56], cfg.sensor_offset);
    m[0x58] = cfg.pa7_mode;
    m[0x59] = cfg.j10_mode;
    wr16(&m[0x5A], cfg.home_speed);
    wr32(&m[0x5C], (uint32_t)j10_enc_count());

    for (uint32_t i = 0; i < len; i++) {
        uint32_t a = (uint32_t)reg + i;
        out[i] = a < REG_MAP_SIZE ? m[a] : 0xFFu;   /* マップ外は 0xFF */
    }
}

/* ---------------------------------------------------------------- 周期処理 */

static void handle_switches(void)
{
    bool s1 = ui_sw1();
    bool s2 = ui_sw2();

    if (s1 && s2) {
        /* 同時長押し: FAULT → 解除、DISABLED ⇔ ENABLED */
        if (jog_dir != 0) {
            if (!jog_rejected) stepper_stop();
            jog_dir = 0;
            jog_rejected = false;
        }
        if (!chord_done && (now - chord_since) >= CHORD_HOLD_MS) {
            chord_done = true;
            if (state == APP_FAULT) {
                cmd_result = cmd_clear_fault();
            } else if (state == APP_DISABLED) {
                cmd_result = cmd_enable();
            } else if (state == APP_ENABLED) {
                cmd_result = cmd_disable();
            }
        }
        return;
    }
    chord_since = now;
    if (!s1 && !s2) {
        chord_done = false;
    }
    if (chord_done) {
        return;   /* 同時押しの離し途中ではジョグしない */
    }

    int8_t d = s1 ? 1 : (s2 ? -1 : 0);
    if (d == jog_dir) {
        return;
    }
    bool rejected = false;
    if (d != 0 && state == APP_ENABLED && (cfg.flags & FLAG_LOCAL_JOG)) {
        if (move_allowed(d)) {
            stepper_run(d * (int32_t)cfg.jog_speed);
            limit_stopped = false;
        } else {
            cmd_result = RESULT_REJECTED;   /* 作動中のリミット側・原点復帰中のジョグは動かさない（FR-HOME-04） */
            rejected = true;
        }
    } else if (jog_dir != 0 && !jog_rejected) {
        stepper_stop();
    }
    jog_dir = d;
    jog_rejected = rejected;
}

static void handle_motion(void)
{
    if (state != APP_ENABLED) {
        return;
    }
    bool pending = stepper_has_pending();
    if (pending) {
        if (hold_active) {
            drv_set_current_ma(cfg.run_current_ma, mon.vdda_mv);
            hold_active = false;
            start_allowed_at = now + CURRENT_SETTLE_MS;
        }
        if (time_reached(start_allowed_at)) {
            stepper_service();
        }
    }

    if (stepper_is_running() || pending || home_is_active(&home)) {
        idle_since = now;
    } else if (!hold_active && (now - idle_since) >= cfg.hold_delay_ms) {
        drv_set_current_ma(cfg.hold_current_ma, mon.vdda_mv);
        hold_active = true;
    }

    /* 通信タイムアウト（ジョグ中は対象外） */
    if (cfg.comm_timeout_ms != 0 && (jog_dir == 0 || jog_rejected) && (stepper_is_running() || pending) &&
        (int32_t)(now - comm_last_request_ms()) > (int32_t)cfg.comm_timeout_ms) {
        stepper_stop();
        home_abort(&home);   /* 通信タイムアウトによる原点復帰の中止（FR-HOME-06）。停止は減速停止 */
    }
}

/* J10 の HOME 入力（1 ms 周期）。確定したレベルを更新する。handle_motion より前に呼ぶ */
static void handle_j10_input(void)
{
    j10_poll_1ms((cfg.flags & SETTINGS_FLAG_HOME_ACTIVE_HIGH) != 0);
}

/* リミット停止（FR-HOME-03）と原点復帰の状態機械（FR-HOME-05・06）。handle_motion の後に呼ぶ（同じ tick で起動した直後も止められる） */
static void handle_limit_and_home(void)
{
    if (home_is_active(&home)) {
        /* 原点復帰中の停止は状態機械が行う（指定側の作動で止まるのは通常動作なので bit5 は立てない） */
        home_in_t in = home_inputs();
        home_apply(home_step(&home, &in));
        return;
    }
    int8_t d = stepper_motion_dir();
    if (d != 0 && limit_active(d)) {
        stepper_estop();      /* 励磁は維持、FAULT にはしない */
        limit_stopped = true;
    }
}

static void handle_driver_fault(void)
{
    uint32_t pm = __get_PRIMASK();
    __disable_irq();
    uint8_t f = isr_fault;
    isr_fault = 0;
    __set_PRIMASK(pm);

    if (state == APP_FAULT || !drv_is_awake()) {
        return;
    }
    if (f != 0) {
        enter_fault(f);
        return;
    }
    if (!lo_armed) {
        if (time_reached(lo_arm_at)) {
            lo_armed = true;
            drv_fault_irq_arm(true);
        }
        return;
    }
    /* EXTI の取りこぼし・アーム前から Low の場合の保険 */
    drv_fault_t lf = drv_read_fault();
    if (lf != DRV_FAULT_NONE) {
        enter_fault((uint8_t)lf);
    }
}

static uint8_t fault_code(void)
{
    for (uint8_t i = 0; i < 8; i++) {
        if (fault_bits & (1u << i)) {
            return (uint8_t)(i + 1u);
        }
    }
    return 0;
}

void app_init(void)
{
    board_id = board_read_address_id();

    /* 保存設定を読み込む。なければ工場出荷値 */
    settings_defaults(&cfg);
    settings_t t;
    if (settings_load(&t)) {
        cfg_status |= CFG_ST_LOADED;
        if (settings_sanitize(&t)) {
            cfg_status |= CFG_ST_SANITIZED;
        }
        cfg = t;
    }
    apply_stepper_params();
    home_init(&home);
    limit_stopped = false;
    jog_rejected = false;
    sensor_synced = false;
    sensor_auto_done = false;
    position_init();
    /* PA7 は設定を読み込んでから保存されたモードにする（それまではアナログ入力。FR-POS-11） */
    position_pa7_set(cfg.pa7_mode, (cfg.flags & SETTINGS_FLAG_SENSOR_DIR) != 0);
    /* J10 は設定を読み込んでから保存されたモードにする（それまではリセット時の状態のまま。FR-J10-01） */
    j10_init();
    j10_set_mode(cfg.j10_mode);
    comm_init(board_id);   /* CAN_S は board_init で Low 済み（FR-COM-14） */
    state = APP_NO_VM;
}

void app_tick_1ms(uint32_t now_ms)
{
    now = now_ms;
    handle_driver_fault();
    handle_j10_input();

    comm_poll();

    ui_scan_switches();
    status_snapshot = status_bits();
    handle_switches();
    handle_motion();
    handle_limit_and_home();
    input_status_snapshot = input_status_bits();
    enc_count_snapshot = j10_enc_count();

    ui_view_t v = {
        .enabled = state == APP_ENABLED,
        .moving = stepper_is_running(),
        .fault_code = fault_code(),
        .temp_warn = temp_warn,
        .comm_count = comm_activity_count(),
        .comm_error = comm_bus_degraded(),
    };
    ui_update(now, &v);

    /* FAULT へ遷移したとき 1 回だけ異常通知（FR-COM-10） */
    if (state == APP_FAULT && prev_state != APP_FAULT) {
        comm_notify_fault((uint8_t)state, fault_bits);
    }
    prev_state = state;
}

void app_tick_10ms(uint32_t now_ms)
{
    now = now_ms;
    monitor_sample(&mon, cfg.pa7_mode == PA7_MODE_AD_IN);

    /* 位置センサ。最初に有効になった時点でモータが一度も動いていなければ自動で同期する（FR-POS-09） */
    position_poll_10ms(now);
    if (!sensor_auto_done && position_valid()) {
        sensor_auto_done = true;
        if (!stepper_touched()) {
            (void)cmd_sync_position();
        }
    }
    sensor_status_snapshot = sensor_status_bits();
    shaft_angle_snapshot = position_shaft_angle(position_raw(), cfg.sensor_offset);
    agc_snapshot = drv_get_agc() ? 1u : 0u;

    /* VM 判定（ヒステリシス + 連続回数） */
    uint32_t lo = vm_ok ? VM_OK_MIN_MV : VM_OK_MIN_MV + VM_HYST_MV;
    uint32_t hi = vm_ok ? VM_OK_MAX_MV : VM_OK_MAX_MV - VM_HYST_MV;
    if (mon.vm_mv >= lo && mon.vm_mv <= hi) {
        vm_bad_count = 0;
        if (!vm_ok) {
            vm_good_ms += 10u;
            if (vm_good_ms >= VM_STABLE_MS) {
                vm_ok = true;
            }
        }
    } else {
        vm_good_ms = 0;
        if (vm_bad_count < 0xFFu) vm_bad_count++;
        if (vm_ok && vm_bad_count >= VM_FAULT_SAMPLES) {
            vm_ok = false;
            vm_bad_reason = mon.vm_mv < lo ? FAULT_VM_UV : FAULT_VM_OV;
        }
    }

    switch (state) {
    case APP_NO_VM:
        if (vm_ok) {
            driver_wake();
            state = APP_DISABLED;
        }
        break;
    case APP_DISABLED:
        if (!vm_ok) {
            driver_sleep();
            state = APP_NO_VM;
        }
        break;
    case APP_ENABLED:
        if (!vm_ok) {
            enter_fault(vm_bad_reason);
        }
        break;
    case APP_FAULT:
        break;
    }

    /* 基板温度 */
    int16_t t = mon.board_temp_dc;
    bool valid = t != TEMP_INVALID;
    temp_warn = valid && t >= BOARD_TEMP_WARN_DC;
    if (valid && t >= BOARD_TEMP_FAULT_DC && (state == APP_DISABLED || state == APP_ENABLED)) {
        enter_fault(FAULT_OVERTEMP);
    }
}

/* ---------------------------------------------------------------- USB 名前表（状態遷移・監視・設定） */

SYM_ENTRY(state, SYM_U8, 1);              /* STATE: 0 NO_VM、1 DISABLED、2 ENABLED、3 FAULT */
SYM_ENTRY_AS("fault", fault_bits, SYM_U8, 1);   /* FAULT レジスタ */
SYM_ENTRY_AS("status", status_snapshot, SYM_U8, 1);   /* STATUS レジスタ（1 ms 周期のスナップショット） */
SYM_ENTRY(cmd_result, SYM_U8, 1);
SYM_ENTRY(cfg_status, SYM_U8, 1);
SYM_ENTRY(isr_fault, SYM_U8, 1);
SYM_ENTRY(vm_ok, SYM_U8, 1);
SYM_ENTRY(hold_active, SYM_U8, 1);
SYM_ENTRY(temp_warn, SYM_U8, 1);
SYM_ENTRY(lo_armed, SYM_U8, 1);

SYM_ENTRY(mon.vdda_mv, SYM_U32, 1);
SYM_ENTRY(mon.vm_mv, SYM_U32, 1);
SYM_ENTRY(mon.board_temp_dc, SYM_I16, 1);
SYM_ENTRY(mon.mcu_temp_dc, SYM_I16, 1);
SYM_ENTRY(mon.ad_in_mv, SYM_U32, 1);

SYM_ENTRY(cfg, SYM_BYTES, sizeof(cfg));
SYM_ENTRY(cfg.run_current_ma, SYM_U16, 1);
SYM_ENTRY(cfg.hold_current_ma, SYM_U16, 1);
SYM_ENTRY(cfg.microstep, SYM_U8, 1);
SYM_ENTRY(cfg.flags, SYM_U8, 1);
SYM_ENTRY(cfg.comm_timeout_ms, SYM_U16, 1);
SYM_ENTRY(cfg.max_speed, SYM_U32, 1);
SYM_ENTRY(cfg.accel, SYM_U32, 1);
SYM_ENTRY(cfg.decel, SYM_U32, 1);
SYM_ENTRY(cfg.start_speed, SYM_U32, 1);
SYM_ENTRY(cfg.jog_speed, SYM_U32, 1);
SYM_ENTRY(cfg.hold_delay_ms, SYM_U16, 1);
SYM_ENTRY(cfg.steps_per_rev, SYM_U16, 1);
SYM_ENTRY(cfg.gear_ratio, SYM_U16, 1);
SYM_ENTRY(cfg.sensor_offset, SYM_U16, 1);
SYM_ENTRY(cfg.pa7_mode, SYM_U8, 1);
SYM_ENTRY(cfg.j10_mode, SYM_U8, 1);

/* 位置センサ（実体は position.c の sensor.* と pa7_applied も参照） */
SYM_ENTRY_AS("sensor_status", sensor_status_snapshot, SYM_U8, 1);   /* SENSOR_STATUS レジスタ（10 ms 周期） */
SYM_ENTRY_AS("shaft_angle", shaft_angle_snapshot, SYM_U16, 1);      /* SHAFT_ANGLE レジスタ [0.01°]（10 ms 周期） */

/* J10（3.12 節）。HOME 入力のデバウンス状態は j10.c の hm1.* / hm2.* も参照 */
SYM_ENTRY_AS("input_status", input_status_snapshot, SYM_U8, 1);   /* INPUT_STATUS レジスタ（1 ms 周期） */
SYM_ENTRY_AS("enc_count", enc_count_snapshot, SYM_I32, 1);        /* ENC_COUNT レジスタ（1 ms 周期。J10_MODE≠1 は 0） */
SYM_ENTRY_AS("agc_out", agc_snapshot, SYM_U8, 1);                 /* AGC 端子の出力レベル（10 ms 周期。1 = 両方 High） */
SYM_ENTRY(limit_stopped, SYM_U8, 1);
SYM_ENTRY(home.state, SYM_U8, 1);          /* home_state_t: 0 IDLE、1 SEEK、2 SEEK_STOP、3 BACK、4 BACK_STOP、5 DONE、6 FAILED */
SYM_ENTRY(home.side, SYM_I8, 1);
SYM_ENTRY(home.seek_speed, SYM_I32, 1);
SYM_ENTRY(home.back_speed, SYM_I32, 1);
SYM_ENTRY(home.limit_steps, SYM_U32, 1);
SYM_ENTRY(home.start_pos, SYM_I32, 1);
SYM_ENTRY(home.opp_prev, SYM_U8, 1);
