rx178nwj/StepperMotorDriver-Node/(commit log)

2026-10-18 初回コミット: NEMA17/NEMA23 ステッピングモータードライバーを追加
    - KiCad 基板設計を追加（schematic_NEMA17, schematic_NEMA23）
    - STM32L433 ファームウェアを追加（firmware/）
    - CubeMX 由来の Drivers/Middlewares を含む
    - App, Inc, Src, CMake 構成, リンカスクリプトなど
    - docs と datasheet/README.md を追加
    - Claude Code 用のエージェント定義（.claude/agents）と設定を追加
    - README.md, .gitignore を追加
2026-10-18 PC15 を DRV_MO から CAN_S（TJA1441AT の S）へ変更し MO を廃止
    回路図変更により、PC15 が TB67S249 の MO 監視入力から
    TJA1441AT の S ピン制御（CAN_S: Low＝ノーマル、High＝サイレント）へ
    変わったため、ファームウェアと仕様書を追随させる。要求仕様は 0.4 版。
    - PC15 を GPIO 出力（Push Pull、低速、初期 Low）に設定し、CAN 起動前にノーマルモードへ
    - drv_mo_low() を削除し、STATUS bit1 は予約（常に 0）とする
    - requirements.md を 0.4 版へ更新（FR-DRV-09 廃止、FR-COM-13 変更、FR-COM-14 追加）
    - 回路図の接続メモと CubeMX 設定手順を CAN_S に合わせて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
2026-10-18 上位通信を I2C2 から CAN1 へ変更し USB CDC 設定プロトコルを追加
    上位通信を I2C2 スレーブ（PCA9615）から CAN1（bxCAN）へ置き換える。
    回路図変更に合わせ、AGC0/1 を PB10/PB11 へ移し、PB8/PB9 を CAN に、
    PC15 を TJA1441AT の S ピン（CAN_S）として扱う。comm.c は作り直した。
    - CubeMX 生成部分（driver_fw.ioc、gpio.c、main.h、i2c.c の I2C2 削除、
    HAL CAN 有効化）は CubeMX を再実行せず手動で反映した
    - USB CDC にデバッグ・設定プロトコルを追加（CRC16 フレーム、CCP 風
    コマンド、メモリ読み出し、シンボル名表、build-id、CAN 代行）
    - docs/requireme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
2026-10-18 NEMA17/23 回路図に電線注記を追加し R32 を DNP に変更
    - 両回路図の J3/J4 付近に、モーター出力の電線選定に関する注記を追加
    - AWG22 は 3A 定格で余裕がないため、3A 付近で運転する場合は J4 を使い、電線は AWG18 以上にする
    - J3 と J4 は同じ出力を並列に出すため、同時に 2 台のモーターは接続しない
    - NEMA23 の TH1 の Value を Thermistor_NTC から NCP18XH103F03RB に変更
    - 両回路図の R32 を dnp no から dnp yes に変更
    - NEMA23 の kicad_pro で used_designators の並びを整理（指定の内容は変更なし）
    - NEMA23 の ERC 結果（schematic_NEMA23-erc.json）を追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
2026-10-18 出力軸の位置センサ AS5600 を追加し PA7 を切り替え可能に
    出力軸の絶対位置を AS5600（I2C1、J9）から読めるようにする。
    センサ値はモータ制御（脱調検出・閉ループ補正）には使わず、
    初期位置の判定と絶対位置の公開にだけ使う。
    - position.c/h を追加。I2C1 はレジスタ直接操作で 10 ms 周期に読み、
    DWT で 1 トランザクションを 500 µs 以内に制限する（割り込みは使わない）
    - 連続 3 回失敗で無効。無効中は 1 秒ごとに再接続を試し、
    失敗時はバスを回復する。センサ未接続でも FAULT にせず動作を継続する
    - CubeMX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
2026-10-18 NEMA23 プロジェクトの used_designators の並びを整理
    KiCad の保存時に used_designators の並びが入れ替わっただけで、
    内容（使用中の参照番号の範囲）は変わらない。
2026-10-20 USB CDC の送信詰まり時の要求破棄と tx_dropped 計上を整理し、ホスト単体テストと PC 側ツールを追加
    送信が 50 ms 以上詰まって応答を送れない状態で受けた要求は、実行せず捨てるようにする。従来は実行してから応答だけ捨てていたため、書き込み系の要求が応答なしで反映される問題があった。PC は応答がなければタイムアウトで再送する。
    - usb_proto.c
    - 送信詰まり時の要求は実行しない。捨てた要求は tx_dropped に計上する
    - 未送信のイベントを新しいイベントで上書きする場合も tx_dropped に 1 計上する
    - メモリ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
2026-10-20 requirements.md を版 0.9 に更新し P2 の要求と実装計画を追加
    requirements.md を版 0.8 から 0.9 に更新し、P2 の要求を追加する。
    実装状況の調査結果と残作業の計画を implementation_plan.md にまとめる。
    - requirements.md
    - 3.11 AGC：FLAGS bit3 で ON/OFF し、EN=Low の間だけ AGC0/AGC1 を切り替える。ストラップ設定値はデータシートに合わせて明記
    - 3.12 J10 入力：J10_MODE（0x59）で未使用／エンコーダ（TIM2、読み出しのみ）／原点・リミットを切り替える。リミット側への移動は即停止し、原点復帰は COMMAND 11・12
    - 3.13 ブートローダ移行：ENTER_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
2026-10-20 FW 0.4：USB 読み出しの ECC 中止と異常通知の上書き計上を修正
    Flash の ECC エラー（NMI）が起きたら、USB のメモリ読み出しを直ちに中止して ERR 0x36 を返す（FR-USB-33）。従来は最後まで読んでから 0x36 を返していた。
    - usb_proto.c：mem_copy で読み出しのたびに nv_ecc_error を確認し、立っていれば以降を読まずに戻る
    - test_usb.c：test_mem_ecc_abort を追加。揃った領域・先頭の端数・末尾の端数のそれぞれで、以降を読まないことを確認
    - comm.c：未送信の CAN 異常通知を新しい通知で上書きしたとき tx_dropped に 1 計上する（FR-COM-12）
    - se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
2026-10-20 nemadbg の CAN_REQUEST の書き込み・ブロードキャストを再送しない
    CAN_REQUEST の書き込み（OP 0x01）とブロードキャスト（CAN_ID 0x000）は、FW が実行して応答だけ失われた場合に再送すると二重実行になるため、再送しない（FR-USB-52）。タイムアウト時は「実行されたかは不明。regs で状態を確認する」と表示する。
    - link.py：is_no_retry と UnsafeRetryError（LinkError の派生）を追加し、再送回数を要求ごとに切り替える
    - cli.py：UnsafeRetryError を捕まえて「通信エラー（実行結果は不明）」を表示する
    - README.md：書き込み・ブロードキャ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
2026-10-20 requirements.md を版 0.10 に更新し、実装との差と P2 の要求を補足
    実装との差を解消し、P2 の要求を補足する。cubemx_setup.md は現行の .ioc に、test_poweron_safe_state.md は現行の配線と FW 版に合わせる。
    - FR-MON-04：VM 異常は 10 ms 周期で 2 回連続して範囲外になったときに FAULT とする
    - FR-MON-08：LO 異常（OPD・ISD・TSD）は CLEAR_FAULT で解除する
    - FR-USB-52：CAN_REQUEST の書き込み・ブロードキャストは再送しない例外を追記
    - 3.8 節：ACCEL・DECEL・速度系の設定範囲をレジスタ表に追記
    - FR-COM-12：未送信の異常通知を上書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
2026-10-20 requirements.md を版 0.11 に更新し、位置決めの減速と SYNC_POSITION の範囲を明確化
    ホスト単体テストで見つかった実装との差について、仕様の扱いを決めた。
    - FR-MOT-03：位置決めで一度減速に入ったら、目標の変更・停止指令まで減速を続け、減速中に速度を上げない
    - FR-MOT-04：減速距離より近い目標へ変えたら、減速度 d を守って行き過ぎ、停止してから逆方向へ戻る
    - FR-POS-06・07：SYNC_POSITION の結果は 0〜N−1 とし、N が INT32_MAX を超える設定では CMD_RESULT=2
    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
2026-10-20 FW の台形加減速を修正し、position と stepper のホスト単体テストを追加
    減速中に速度が戻る不具合と、減速距離より近い目標へ変えたときに止まれない問題を直す。SYNC_POSITION の結果は 0〜N−1 に収め、N が 32bit を超える設定では実行しない。position と stepper の計算をホスト PC で単体テストできるようにした。
    - stepper.c
    - plan_next：braking のラッチを追加し、一度減速に入ったら目標の変更・指令まで減速を続ける（FR-MOT-03）
    - plan_next：目標に着いても開始速度を超えていれば減速を続けて行き過ぎる（FR-MOT-04）
    - plan_ne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
2026-10-20 settings.c のホスト単体テスト test_settings を追加
    Flash の設定保存（不揮発設定）をホスト PC で単体テストできるようにした。
    Flash は RAM 上の 2 ページで模擬し、消去は 0xFF、書き込みは 8 バイト単位で消去済みの場所にだけ書けるようにした。電源断・ECC エラー・CRC 不一致・HAL エラーを故障注入して、FR-NV-01〜08、FR-POS-08（版 1・2 の読み込み）と試験 12〜15 の期待値を確認する。
    - settings.c
    - NV_BASE を #ifndef で囲み、読み出しを NV_MEMCPY マクロ経由にした（テスト用の差し替え口のみ。ARM の生成コードと Flash 使用量 64616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
2026-10-20 requirements.md を版 0.12 に更新し、CAN 要求の細部と保存値の丸め先を明確化
    ホスト単体テスト（フェーズ C1・C2）で確認した実装の動作を仕様に明記する。
    - FR-COM-07：DLC 0・1 で REG を含まない不正な要求には REG=0 として [0xFF][0x00][2] を返す
    - FR-COM-08：16bit レジスタも 2 バイトとも 1 フレームで書いた場合だけ反映する
    - FR-COM-11：受信リングは 16 件を保持する。あふれた場合は新しいフレームを捨てて rx_dropped に計上する（FW の保持数の修正は次のコミット）
    - 3.8 節：STEPS_PER_REV の範囲を 1〜65535 とする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
2026-10-20 comm.c の受信リングを仕様どおり 16 件にし、comm・app のホスト単体テストを追加
    受信リングは満杯判定のため 1 スロット空けており、実際には 15 件しか保持していなかった。RX_RING_LEN を 17 にして 16 件保持する（Flash +40 B）。
    CAN 通信層と app のレジスタ処理をホスト PC で単体テストできるようにした。
    - firmware/App/Src/comm.c
    - RX_RING_LEN を 16 から 17 に変更
    - tests/host
    - test_comm.c を追加。FR-COM-03〜12・14、FR-MON-09、FR-UI-04、FR-USB-42・44、受信リングを確認する。app 側は偽物
    - test_app.c を追加。app.c のレジスタ読み書き（範囲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
2026-10-20 設定を版 3 にして J10_MODE・HOME_SPEED・AGC の土台を追加
    実装計画フェーズ E1・E2 として、J10 の設定レジスタと AGC の制御を追加する。
    settings_t の予約 3 バイトを j10_mode（u8）・home_speed（u16）に置き換え、サイズは 40 バイトのまま。保存レコードは版 3 にし、版 1・2 は新項目を既定値（J10_MODE 0、HOME_SPEED 800）で補って読む。
    - firmware/App/Inc/settings.h・Src/settings.c
    - FLAGS に bit3（AGC）・bit4（HOME 論理）を追加
    - sanitize：J10_MODE は 0〜2 の外を 0、HOME_SPEED は 0 を 1 に丸める
    - 版 2 のレコードは新項目を既定値にして読む
    - firmwar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
2026-10-20 requirements.md を版 0.13 に更新し、原点復帰・リミット停止の細部を明確化
    実装（E3・E4）で決めた、リミット停止と原点復帰の扱いを仕様に明記する。
    - firmware/docs/requirements.md
    - FR-HOME-03：原点復帰中はリミット停止を行わない（bit5 も立てない）
    - FR-HOME-04：INPUT_STATUS bit5 は、受け付けた移動指令・原点復帰の開始で 0 にする
    - FR-HOME-05：開始時に両側の入力が作動していれば、動かさずに失敗とする
    - FR-HOME-06：原点復帰中の移動指令・ジョグは CMD_RESULT=1、RUN_SPEED=0 は減速停止として中止する。(1) の反対側は開始後に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
2026-10-20 J10 の切り替え・原点復帰・リミット停止を追加（実装計画 E3・E4・E8(b)）
    J10.3/J10.4（PA15/PA1）を未使用・エンコーダ・原点入力で切り替えられるようにし、原点復帰の状態機械とリミット停止を追加する。仕様は直前のコミット（版 0.13）による。
    - firmware/App/Src/j10.c・App/Inc/j10.h（新規）
    - PA15/PA1 を J10_MODE で切り替える：アナログ、TIM2 エンコーダ（AF1、プルアップ、SMS=011 の 4 逓倍、入力フィルタ fDTS/8・8 サンプル）、HOME 入力（プルアップ、1 ms 周期・2 回一致で確定、FLAGS bit4 で論理を決める）
    - 切り替え時は一度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
2026-10-20 ROM ブートローダへの移行（ENTER_BOOTLOADER）を追加（実装計画 E5・E8(a)）
    USB コマンド 0x50 ENTER_BOOTLOADER で、基板を ROM ブートローダ（USB DFU）へ移行できるようにする。
    IWDG は一度起動すると止められないため、移行はリセットを挟んで 2 段で行う。
    - App/Src/bootjump.c・App/Inc/bootjump.h（新規）
    - 稼働中は移行フラグ（マジック値 0xB007DF11、.noinit）を書いてソフトウェアリセットする
    - リセット直後（main の HAL_Init より前）に、フラグがマジック値と完全一致すればフラグを消して ROM（0x1FFF0000）へ飛ぶ。SYSCFG のメモリ再配置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
2026-10-20 nemadbg に dfu サブコマンドと新レジスタを追加（実装計画 E6）
    ENTER_BOOTLOADER（コミット 1）を PC 側から呼び出し、DFU 書き込みへつなぐ手順を追加する。
    あわせて、FW 側で追加されたレジスタ（E1〜E4）を registers.py に反映する。
    - tools/nemadbg/dfu.py（新規、FR-USB-62）
    - 確認プロンプト（--yes で省略）のあと CONNECT → ENTER_BOOTLOADER（KEY）を送る。再送しない。DISCONNECT は送らない
    - ERR 0x33（ENABLED 中）は理由を表示する
    - STM32_Programmer_CLI -l usb で最大 5 秒 DFU デバイスを探す（PATH に無ければ省略）
    - 書き込み手順の例を表示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
2026-10-23 CAN・USB インタフェース仕様書を firmware/docs に追加
    上位機器（マスタ）向けの can_interface.md と、PC アプリ向けの
    usb_interface.md を版 0.1 として新規追加する。どちらも requirements.md
    3.8・3.9 節と実装（comm.c・app.c・usb_proto.c）を正として起こした。
    CAN 仕様のレジスタマップ・状態・COMMAND の定義は、USB 仕様の
    8.3〜8.6 章を共通の正として参照する（USB が同じ処理を代行するため）。
2026-10-24 USB 名前表に J10・原点復帰・AGC を登録（実装計画 E7）
    USB 名前表に J10・原点復帰・AGC の 18 件を登録し、79 件から 97 件にする。
    TIM2->CNT と GPIO の ODR はペリフェラル領域で USB から読めない（FR-USB-31）
    ため、input_status・enc_count（1 ms 周期）と agc_out（10 ms 周期）は RAM の
    スナップショットにして登録する。
    - cfg.j10_mode、limit_stopped、原点復帰の状態機械の各メンバ（home.*）、
    HOME 入力のデバウンス状態（hm1・hm2）を登録
    - docs/usb_symbols.md を 97 件に更新し、「J10・原点復帰・AGC」の節を追加
    - README.md に「書き込み方法」の節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
2026-10-24 診断値（稼働時間・リセット要因・ループ周期・スタック）を USB 名前表に追加
    PC 側デバッグ UI からファーム内部の状態を把握できるようにする。
    - uwTick: 稼働時間 [ms]
    - reset_csr: 起動時の RCC->CSR を読み取り、直後にフラグをクリアする
    - loop.max_us / max_1s_us / rate_hz: DWT->CYCCNT で計測したメインループ周期
    - stack.used_max / size: 起動直後に塗りつぶし、1ms ごとに増分走査して使用量を求める
    ホスト試験 test_diag を追加し、run_tests.sh と run_tests.ps1 に組み込んだ。
    usb_symbols.md の登録数を 97 から 104 に更新し、usb_interface.md の件数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
2026-10-24 nemadbg に USB 擬似デバイス（--sim）とその試験を追加
    実機が未完成の間も PC 側デバッグ GUI の開発を進められるよう、USB 擬似
    デバイスを追加する。標準ライブラリだけで動く pyserial 互換の SimSerial
    （nemadbg/sim.py）で、全コマンド・レジスタ・状態遷移・台形加減速・原点
    復帰・設定保存・COMM_TIMEOUT・FAULT イベントを再現する。名前表は 104 件
    を割り付け、ファームの SYM_ENTRY と一致することを試験で確認する。
    - nemadbg/sim.py（新規）
    - 時計は差し替え可能。偽の時計では実時間で待たない（決定的な試験が可能）
    - 注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
2026-10-24 nemagui に G1（Qt 非依存の中核）を追加
    PC 側デバッグ GUI nemagui の中核を追加する。Qt には依存せず、画面（PySide6）は次の段階 G2 で作る。
    - nemagui/items.py（新規）
    - デバッグ項目の定義表。レジスタ項目は nemadbg.registers.REGISTERS から作り、アドレス・サイズ・符号・ビット名・列挙を重複して持たない
    - 名前表の項目は usb_symbols.md の名前に合わせて静的に定義する。9 グループに加え、名前表の未定義名は build_items() が "other" に自動追加する
    - decode / format / encode を持つ
    - nemagui/readplan.py（新規）
    - 読み出し計画を作る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
2026-10-24 nemagui に画面の骨格（G2・PySide6）を追加
    PC 側デバッグ GUI nemagui の画面を追加する。表示ロジックは Qt に依存しない viewstate.py に分離し、画面は PySide6 で作る。操作・設定・グラフのタブは次の段階 G3〜G5 で実装する（現状はプレースホルダ）。
    - nemagui/__main__.py・app.py・ui/（新規）
    - python -m nemagui [--port|--sim] で起動する
    - 接続バー（ポートの自動検出・再検索、切断時の 1 秒ごとの自動再接続）
    - 状態概要パネル（STATE の色分け、FAULT / STATUS / INPUT_STATUS / CONFIG_STATUS のビットランプ。50 ms 常時ポーリング）
    - ESTOP / ST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
2026-10-24 nemagui に操作タブ・設定タブ（G3）を追加し、ログの文字サイズ不揃いを修正
    - 操作タブ（ui/ops_tab.py）
    - ENABLE / DISABLE / CLEAR_FAULT、MOVE_ABS / MOVE_REL（クイック ±200・±6400）、RUN_SPEED と速度 0、SET_POSITION / SYNC_POSITION / RESET_ELEC_ANGLE、HOME_NEG / HOME_POS
    - 受付条件（usb_interface.md 8.5）に合わないボタンは無効化し、ツールチップに理由を出す。判定は viewstate.op_availability（Qt 非依存。最終判断は基板）
    - 設定タブ（ui/settings_tab.py、settings_edit.py）
    - RW レジスタを基板の値・編集値で表示し、差分を強調。変更行だけを書き込み、行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
2026-10-24 nemagui に内部状態の要点パネル・名前表ブラウザ・ウォッチ（G4）を追加
    - 要点パネル（ui/panels.py、ロジックは summary.py で Qt 非依存）
    - モーション: mode・方向・現在/プランナ/目標速度・目標までの残り
    - 状態遷移: fault と isr_fault のビットランプ、vm_ok・temp_warn・lo_armed
    - センサ: SENSOR_STATUS と AS5600 STATUS、I2C 失敗の毎秒数・連続失敗
    - J10・原点: home.state の段階表示、HOME1/HOME2 のデバウンス進捗
    - 通信統計: 異常系カウンタを 0 以外で橙・増加中で赤
    - 診断: 稼働時間、reset_csr の主要因と立っているフラグ、ループ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
2026-10-24 nemagui にグラフタブと CSV 記録（G5）を追加
    - グラフタブ（ui/graph_tab.py、判断ロジックは graphmodel.py で Qt 非依存）
    - プリセット（運動・速度プロファイル・電源・温度・原点復帰・ループ・診断）、ウォッチ一覧と全数値項目から系列を選択（検索付き）
    - pyqtgraph で単位ごとに縦積みのプロット（X 連動、右端 0 の相対秒）。単位なしの状態・ビットは階段状の「状態」プロット
    - 時間窓 10/30/60/120 s、周期 20〜1000 ms、一時停止・クリア・カーソル読み取り・PNG 保存。描画は 20 fps に制限
    - 選択中の系列はポーリング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
2026-10-24 nemagui の概要パネルに角度ダイヤル（AngleDial）を追加
    概要パネルに、モーター位置角度とセンサ角度を同じ円上に描く
    円形ダイヤル（AngleDial）を追加した。
    - summary.py に純関数 motor_angle_deg（POSITION を
    GEAR_RATIO × STEPS_PER_REV × MICROSTEP で 1 回転に換算）と
    angle_diff_deg（−180 以上 180 未満に丸めた差）を追加
    - 概要ポーリングに reg.GEAR_RATIO / reg.STEPS_PER_REV /
    reg.MICROSTEP を追加（表示行はなし、換算用）
    - テストを追加（test_gui_summary.py の換算・差分・不明値、
    test_gui_qt.py のダイヤル描画と更新）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
2026-10-24 firmware/tools に nemagui を --sim で起動するバッチを追加
    nemagui をシミュレータ接続で手早く起動できるよう、
    run_nemagui_sim.bat を追加した。
    - スクリプトのあるフォルダへ移動してから .venv の python で
    python -m nemagui --sim を実行する
    - .venv が無い場合は作成手順を表示して終了する
    - 追加の引数は nemagui にそのまま渡す
2026-10-24 nemagui 起動バッチを ASCII 化し、ルートに起動用バッチを追加
    cmd.exe は cp932 で .bat を読むため、UTF-8 の日本語コメント・
    メッセージを含む firmware/tools/run_nemagui_sim.bat が文字化けし、
    起動に失敗していた。コメントとメッセージを英語の ASCII に変更し、
    CRLF に統一した。
    あわせてプロジェクトルートに run_nemagui_sim.bat を追加した。
    中身は firmware/tools 側のバッチを呼び出すだけで、引数はそのまま渡す。
2026-10-29 nemadbg に動作確認モード selftest を追加
    基板を PC から自動試験する selftest サブコマンドを追加した。
    A（立ち上げ）・B（角度センサ）・C（モーター）・D（オシロ DS1054Z）・E（CAN）の
    各グループを実行し、項目ごとの PASS/FAIL/SKIP/INFO と測定値を表示する。
    - 結果は report.txt と report.json に保存する（既定は selftest_reports/YYYYmmdd-HHMMSS/）
    - pyvisa / python-can は該当グループの実行時だけ import し、未導入や機器未検出は SKIP にして続ける
    - モーター試験は RAM 上の RUN_CURRENT / MAX_SPEED だけを変更し、終了時に元へ戻す。SAVE_SETTINGS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
2026-11-01 CAN 診断情報 comm_diag を追加（TEC/REC・LEC 回数・初期化段階）
    USB の名前表から CAN の診断情報を読めるようにした。周辺レジスタは USB から
    読めないため、comm_poll（1 ms ごと）で CAN1->ESR を RAM の comm_diag にコピーする。
    - TEC / REC と起動後の最大値、LEC 別の検出回数（Stuff/Form/ACK/Bit/CRC）、EWGF の立ち上がり回数
    - comm_init の失敗段階（init_stage）、直近に受信したフレームの ID・DLC・データ
    - 1 ms サンプリングのため、エラー回数は下限値。LEC は読んだあと 7 に書き戻し、次のエラーを数えられるようにする
    - 名前表は 104 件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
2026-11-01 gs_usb を Windows で開けるよう libusb の DLL を PATH に追加
    python-can の gs_usb が NoBackendError で開けなかったため、libusb-package 同梱の
    libusb-1.0.dll があるフォルダを PATH の先頭へ追加するようにした。
    - python-can の gs-usb は DLL のパスを渡さないため、gs_usb のときだけ open_bus() が補う
    - 既に PATH に含まれていれば追加しない。libusb_package が無い・DLL が無い場合は何もしない（Linux はシステムの libusb を使う）
    - requirements-selftest.txt に libusb-package を追加
    - README に Windows の注意を追記
    - test_canbus.py を追加（先頭追加・重複なし・未導入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
2026-11-01 通信タイムアウトの計時を CAN 受信だけでリセットするように変更
    USB デバッグの CAN_REQUEST でも計時が延びていたため、マスタが停止しても
    USB 側の読み出しが続くと安全停止（COMM_TIMEOUT）が働かなかった。
    - comm_process_request（USB の CAN_REQUEST から直接呼ばれる）では計時を更新しない
    - 計時のリセットは CAN 受信経路の comm_poll だけが行う（0x100+ID のみ）
    - sim.py も同じ仕様に合わせ、USB 要求では計時を延ばさない
    - requirements.md（FR-MON-09, FR-USB-42）、can_interface.md、usb_interface.md を更新
    - host テストを、USB 経由では延びず CAN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
